FlyingRat/Medtronic-PB560/README.md

# Medtronic PB560 Ventilator

The complete Open Source Kit for the Medtronic PB 560 Ventilator including the original zip-files.

Link to official site for the Medtronic PB 560:
http://www.medtronic.com/openventilator
