FlyingRat/Medtronic-PB560/Mechanical Part Drawings/2982400/72SP - Supporting Documentation/PCBA10003A01G  Control Document v1.1.pdf

# Control Document

Assembly Version: | G | 15/06/2015
Document Version: | 1.0
PCBA Part Number: | PCBA10003A01G
Project Name: | Legend G2 (automotive EEPROM)
Document Description | Part/Drawing Number | Revision Filename
Schematic | 1400-10010-SCH | 4.3 | Schematic\1400-10010_SCH-LegendSchematicV4.3.PDF
BOM | PCBA10003A01G2 | 1.0 | BOM\PCBA10003A01G-LegendG2BOMv1.0.xls
Gerbers & other PCB manufacturing data | 1400-10010 | 3.0 | Gerbers, etc\1400-10010v3.0.zip
Legend PCB Fabrication Notes | 1400-10010-FAB | 3.0 | Gerbers, etc\1400-10010v3.0\1400-10010-FAB PCB Fabrication Notes v3.0.doc
Legend PCB Test Specification | PCB_TEST_00005 | 0.3 | Test Documents\Legend PCB Test 00005 Spec V0.3.pdf

Revision History
Version | Alteration Notice | Description
1.0 | - | Initial Release amended from PCBA10003A01F

The information contained within this document is confidential and proprietary to Accutronics Ltd. This information should not, in whole or in part, be reproduced, disclosed or used except as expressly and duly authorized by Accutronics Ltd.
