FlyingRat/Medtronic-PB560/Source Code/AL020004_updated/Sources/scripts/readme.txt

Pour tester le comportement de la carte alim sur mauvais CRC, il suffit d'ajouter l'option --gen-bad-crc dans le fichier update_crc_al.bat
