FlyingRat/Medtronic-PB560/Electronic PCBAs/10096315_Blower_Driver_PCBA/SCH/4096600.E00.001_Schma Carte Commande Turbine RB0505 IND03.pdf

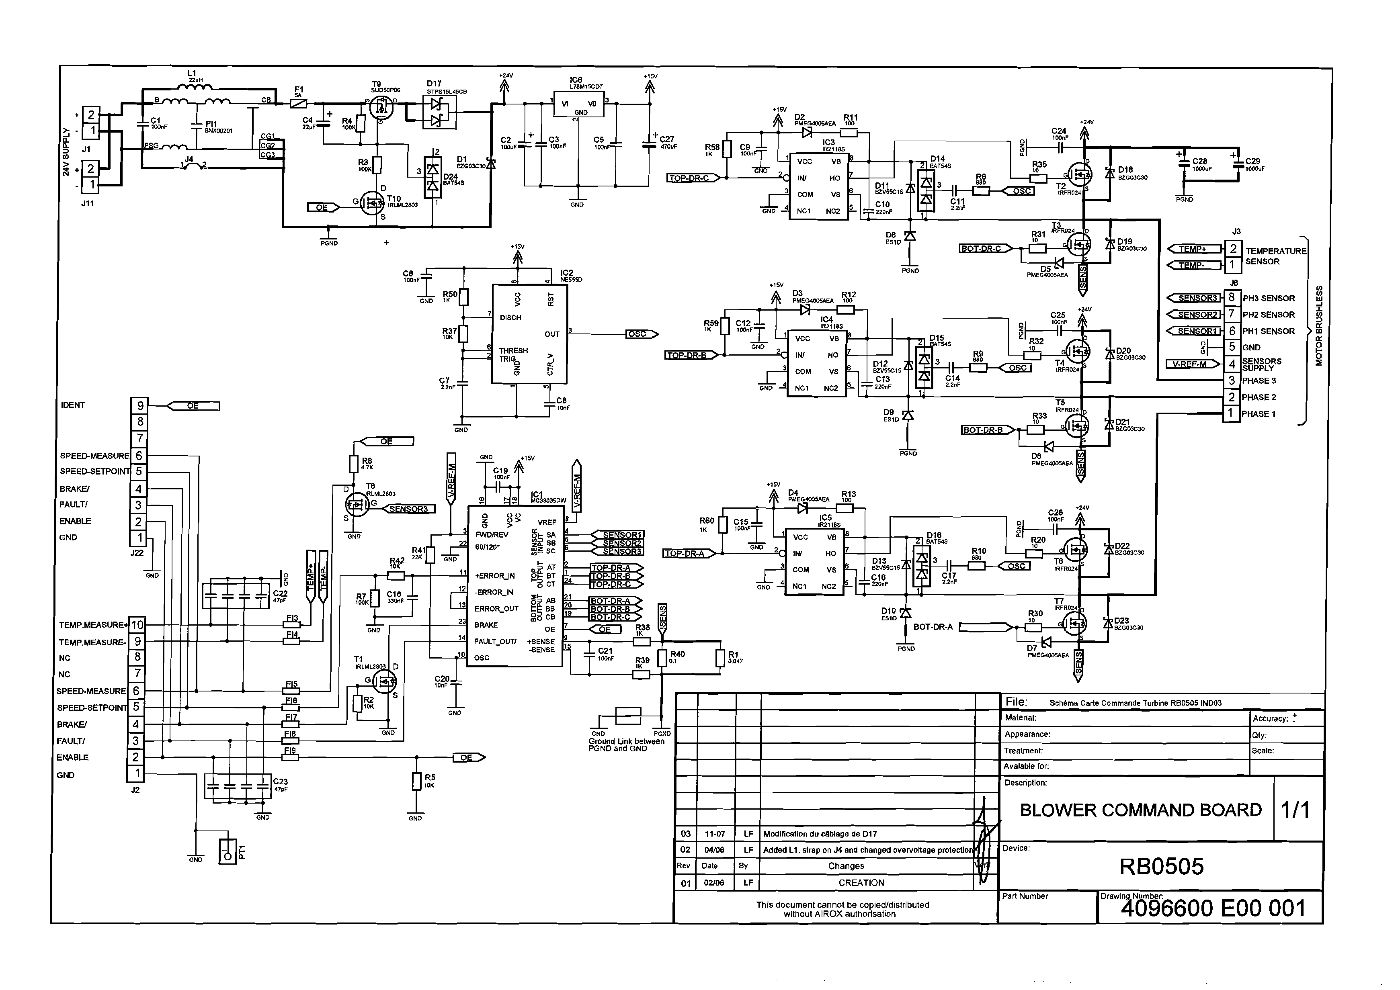
[picture p4: page 1]
