FlyingRat/Medtronic-PB560/Electronic PCBAs/GR106769_CPU_PCBA/PCB/GR106772A00.pdf

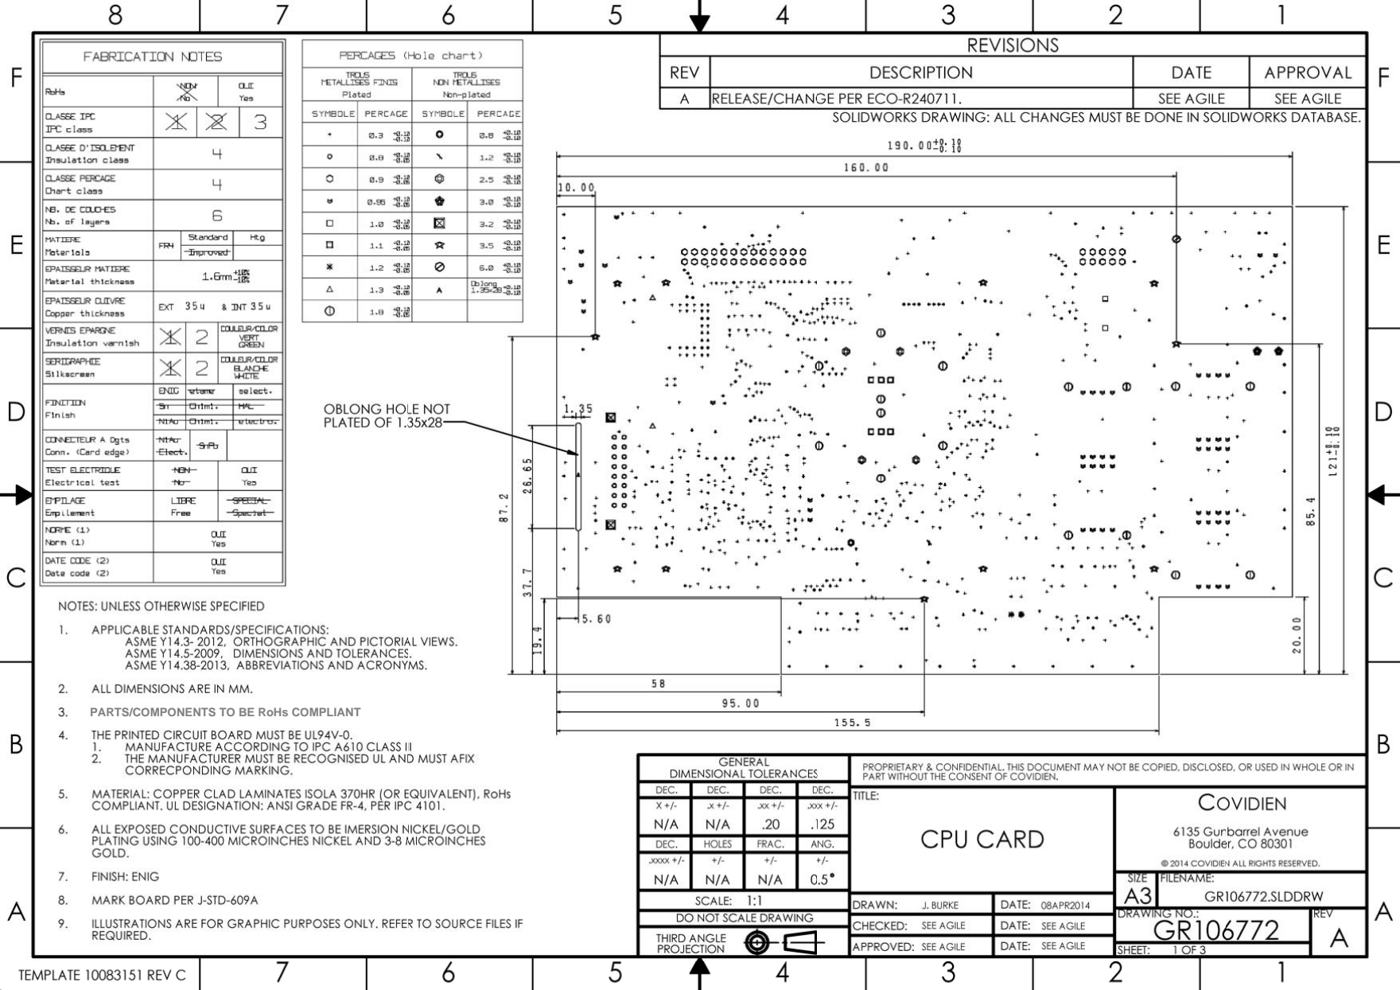
[picture p5: page 1]
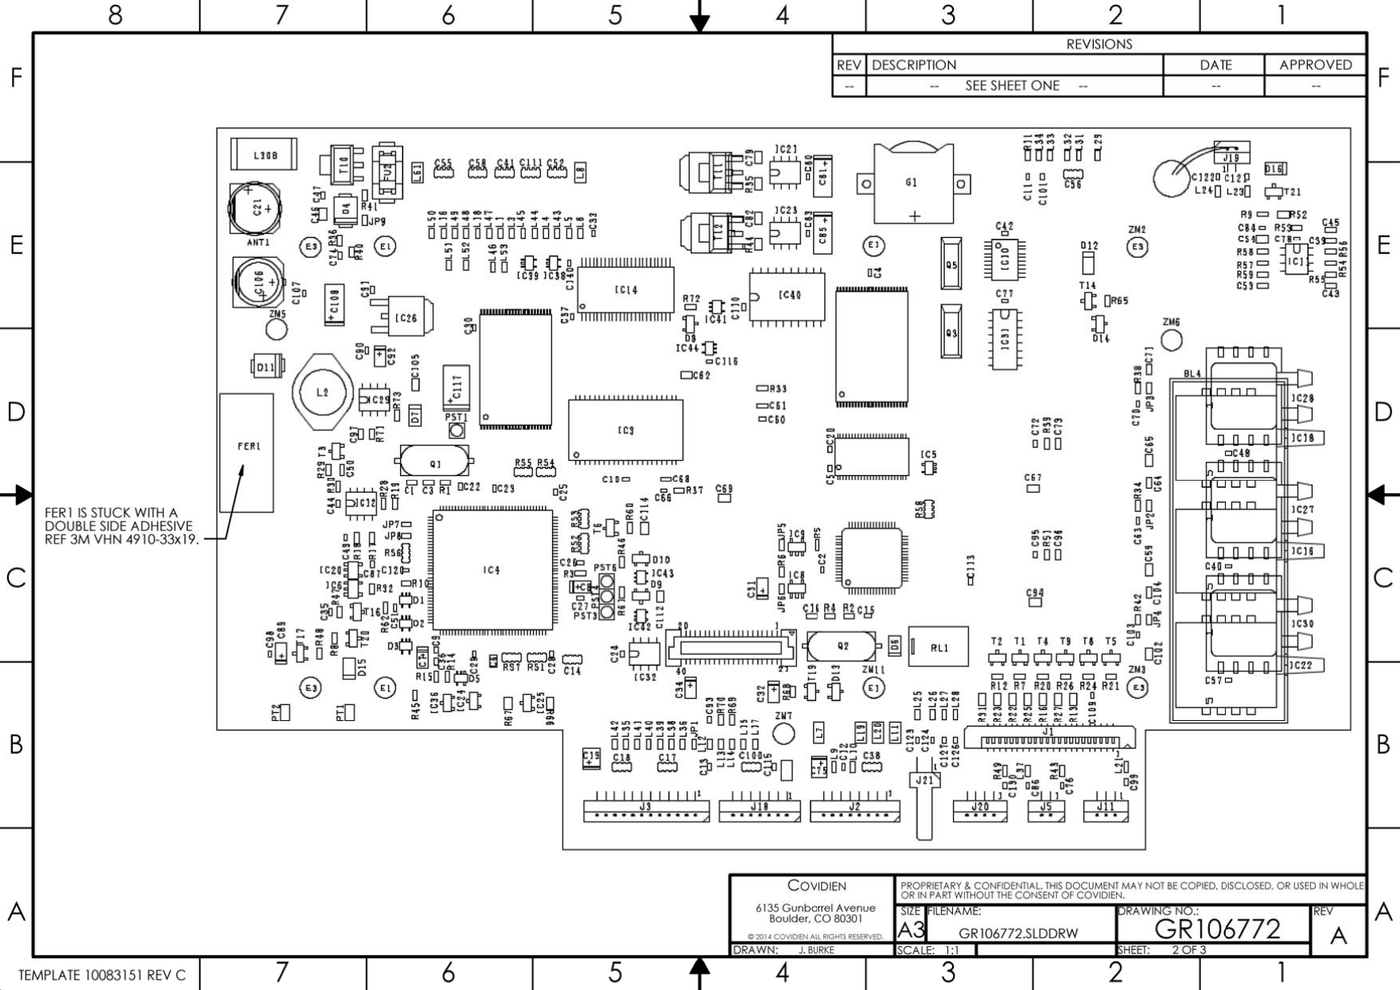
[picture p6: page 2]
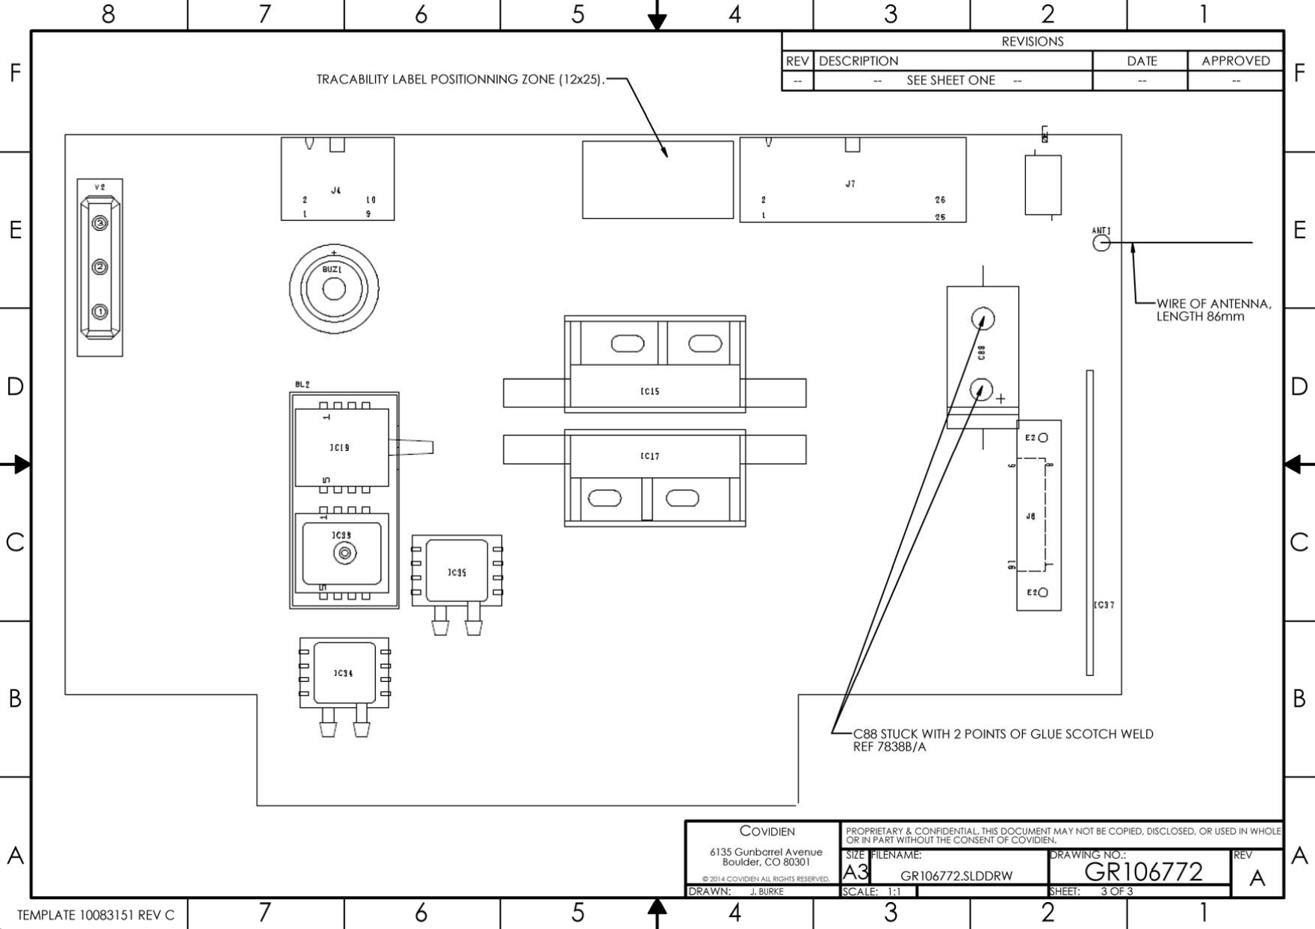
[picture p7: page 3]
