FlyingRat/Medtronic-PB560/Electronic PCBAs/GR106768_Buzzer_PCBA/BOM/GR106768_Buzzer_PCBA_BOM.xls

Creator | Jenaro | Julio
Type
Description
Title Block
Item Number | Description | Subclass | Lifecycle Phase | Rev | Rev Incorp Date | Rev Release Date | Effectivity Date
GR106768 | BUZZER PCBA | Part | Production | B ECO-R252636 | 18/Nov/2014 02:51:26 PM GMT | 06/Jan/2015 05:10:58 PM GMT
Page Two
UOM | Additional Categories Part | Alternate Part(s) | Alternate FG Part(s) | Restricted Access | Vendor User Group | Data Classification | Attachment Destination | Created By | Create Date | Legacy Data Source | Divesture Destination
Each | PART CATEGORY|Pc Board |  |  |  | V - Jabil SH | Confidential |  | Schilling, Sheila | 13/Feb/2014 03:51:56 PM GMT | Agile RMS
Page Three
Product Family(s) | Item Type | Lot Serial Control | Document Number | RoHS Compliant | Bio Approval Number | Integration Description | Project(s) | Notes | Handling/Storage | Legacy Number
 | Customized | None | NODOCUMENT | Unknown |  | BUZZER PCBA | RSP - PB560-520 | Product Family : RSP - VENTILATOR SYSTEMS, Commodity Code: BPCS Add-Updt : FC02.17, Country of Origin: BPCS Add : FR = FRANCE, Shelf Life Days:BPCS Add-Updt : 0, Must Single Issue: BPCS Add : NO, Item Class: BPCS Add-Updt : GL-66 PB500 Series Ventilators/Gen 1
BOM
Level | Attachments (Image) | Manufacturer (Image) | Pending Changes (Image) | Has Been Redlined (Image) | Has Quality(Image) | Bubble Number | Item Number | Item Description | Item Rev | Qty | UOM | Item Lifecycle Phase | BOM Notes | Ref Des | Component Effective From | Component Discontinue Date | Alternate Part(s) | Alternate FG Part(s) | Alternate Document(s) | Subclass | Sites | Planned? | Scrap Factor | OP # | Thumbnail | Attachments(Image) | Manufacture Part Has Redline | Mfr. Name | Mfr. Part Number | Mfr. Part Description | Mfr. Part Lifecycle Phase | Preferred Status | Sites | Reference Notes | RoHS Compliant? | RoHS Compliance Statement
1 | true | true | false | false | false | 0 | 10021385 | RESISTOR,4.7 KOHM,+/-1%.0.063W,0402 | A ECO-R252636 | 1 | Each | Production |  | R40 |  |  |  |  |  | Part | BDRM |  | 1 |  |  | true | false | PHYCOMP_RMS1 | 232270674702L | GENERAL PURPOSE CHIP RESISTOR | Active | Preferred |  | ROHS EXEMPT: 7(C)-1 | Yes - by exemption | Legacy Inventory Status: Cleared
 |  |  |  |  |  |  |  |  |  |  |  |  |  |  |  |  |  |  |  |  |  |  |  |  |  | true | false | VISHAY_RMS1 | CRCW04024K70FKED | RESISTOR THICK FILM 4k7 1% 0.0625W 0402 VISHAY | Active | Preferred |  | ROHS EXEMPT: 7(C)-1 | RoHS3 Compliant with exemptions | Cleared 7(c)-I exemption
 |  |  |  |  |  |  |  |  |  |  |  |  |  |  |  |  |  |  |  |  |  |  |  |  |  | true | false | YAGEO/PHYCOMP_RMS1 | RC0402FR-074K7L | GENERAL PURPOSE CHIP RESISTOR | Active | Preferred |  | ROHS EXEMPT: 7(C)-1 | Yes - by exemption | Legacy Inventory Status: Cleared
1 | true | true | false | false | false | 0 | 10021387 | RESISTOR, 220 OHM,+/-1%, 0.063W, 0402 | B ECO-R252636 | 1 | Each | Production |  | R37 |  |  |  |  |  | Part | BDRM |  | 1 |  |  | true | false | YAGEO_RMS1 | 232270672201L | RESISTOR, METAL GLAZE/THICK FILM, 0.0625 W, 1 %, 100 PPM, 220 OHM, SURFACE MOUNT, 0402 | Active | Preferred |  | BRAND: PHYCOMP.ROHS EXEMPTION: 7(C)-1 | Yes - by exemption | Legacy Inventory Status: Cleared
 |  |  |  |  |  |  |  |  |  |  |  |  |  |  |  |  |  |  |  |  |  |  |  |  |  | true | false | VISHAY_RMS1 | CRCW0402220RFKED | THICK FILM, RECTANGULAR CHIP RESISTORS | Active | Preferred |  | ROHS EXEMPTION: 7(C)-1 | Yes - by exemption | Legacy Inventory Status: Cleared
 |  |  |  |  |  |  |  |  |  |  |  |  |  |  |  |  |  |  |  |  |  |  |  |  |  | true | false | YAGEO_RMS1 | RC0402FR-07220RL | RESISTOR, METAL GLAZE/THICK FILM, 0.1 W, 1 %, 100 PPM, 220 OHM, SURFACE MOUNT, 0402 | Active | Preferred |  | ROHS EXEMPTION: 7(C)-1 | Yes - by exemption | 2011/65/EU compliant with 7(c)-I exemption and the exemption will expired in 21 July 2021 for medical devices.
1 | true | true | false | false | false | 0 | 10021388 | RESISTOR, 180 KOHM, +/-1%, 0.063W.0402 | B ECO-R252636 | 1 | Each | Production |  | R41 |  |  |  |  |  | Part | BDRM |  | 1 |  |  | true | false | YAGEO_RMS1 | 232270671804L | RESISTOR, METAL GLAZE/THICK FILM, 0.0625 W, 1 %, 100 PPM, 180000 OHM, SURFACE MOUNT, 0402 | Active | Preferred |  | BRAND:PHYCOMP.ROHS EXEMPT:7(C)-1 | Yes - by exemption | Legacy Inventory Status: Cleared
 |  |  |  |  |  |  |  |  |  |  |  |  |  |  |  |  |  |  |  |  |  |  |  |  |  | true | false | VISHAY_RMS1 | CRCW0402180KFKED | THICK FILM RECTANGULAR CHIP RESISTORS | Active | Preferred |  | ROHS EXEMPT:7(C)-1 | Yes - by exemption | Legacy Inventory Status: Cleared
 |  |  |  |  |  |  |  |  |  |  |  |  |  |  |  |  |  |  |  |  |  |  |  |  |  | true | false | YAGEO_RMS1 | RC0402FR-07180KL | RESISTOR, METAL GLAZE/THICK FILM, 0.0625 W, 1 %, 100 PPM, 180000 OHM, SURFACE MOUNT, 0402 | Active | Preferred |  | ROHS EXEMPT:7(C)-1 | Yes | Legacy Inventory Status: Cleared
1 | true | true | false | false | false | 0 | 10021389 | RESISTOR, 1.5 MOHM,0.063W, 0402 | B ECO-R252636 | 1 | Each | Production |  | R43 |  |  |  |  |  | Part | BDRM |  | 1 |  |  | true | false | YAGEO_RMS1 | 232270671505L | RESISTOR, METAL GLAZE/THICK FILM, 0.0625 W, 1 %, 100 PPM, 1500000 OHM, SURFACE MOUNT, 0402 | Active | Preferred |  | BRAND: PHYCOMP.ROHS COMPLIANT: 7(C)-1 | Yes - by exemption | Legacy Inventory Status: Cleared
 |  |  |  |  |  |  |  |  |  |  |  |  |  |  |  |  |  |  |  |  |  |  |  |  |  | true | false | YAGEO_RMS1 | RC0402FR-071M5L | RESISTOR, METAL GLAZE/THICK FILM, 0.0625 W, 1 %, 100 PPM, 1500000 OHM, SURFACE MOUNT, 0402 | Active | Preferred |  | ROHS COMPLIANT: 7(C)-1 | Yes - by exemption | Legacy Inventory Status: Cleared
 |  |  |  |  |  |  |  |  |  |  |  |  |  |  |  |  |  |  |  |  |  |  |  |  |  | true | false | VISHAY_RMS1 | CRCW04021M50FKED | THICK FILM, RECTANGULAR CHIP RESISTORS | Active | Preferred |  | ROHS COMPLIANT: 7(C)-1 | Yes - by exemption | Legacy Inventory Status: Cleared
1 | true | true | false | false | false | 0 | 10021390 | CAPACITOR,4.7NF,16V,+/-10%,0402 | B ECO-R252636 | 1 | Each | Production |  | C35 |  |  |  |  |  | Part | BDRM |  | 1 |  |  | true | false | YAGEO_RMS1 | CC0402KRX7R7BB472 | CAPACITOR, CERAMIC, MULTILAYER, 16 V, X7R, 0.0047 UF, SURFACE MOUNT, 0402 | Active | Preferred |  |  | Yes | Legacy Inventory Status: Cleared
 |  |  |  |  |  |  |  |  |  |  |  |  |  |  |  |  |  |  |  |  |  |  |  |  |  | true | false | YAGEO_RMS1 | 223878715632 | CAPACITOR, CERAMIC, MULTILAYER, 16 V, X7R, 0.0047 UF, SURFACE MOUNT, 0402 | Active | Preferred |  | BRAND: PHYCOMP | Yes | Legacy Inventory Status: Cleared
1 | true | true | false | false | false | 0 | 10021391 | RESISTOR, 680 KOHM,+/-1%, 0.063W, 0402 | B ECO-R252636 | 1 | Each | Production |  | R44 |  |  |  |  |  | Part | BDRM |  | 1 |  |  | true | false | YAGEO_RMS1 | RC0402FR-07680KL | RESISTOR, METAL GLAZE/THICK FILM, 0.0625 W, 1 %, 100 PPM, 680000 OHM, SURFACE MOUNT, 0402 | Active | Preferred |  | ROHS EXEMPT: 7(C)-1 | Yes - by exemption | Legacy Inventory Status: Cleared
 |  |  |  |  |  |  |  |  |  |  |  |  |  |  |  |  |  |  |  |  |  |  |  |  |  | true | false | YAGEO_RMS1 | 232270676804L | RESISTOR, METAL GLAZE/THICK FILM, 0.0625 W, 1 %, 100 PPM, 680000 OHM, SURFACE MOUNT, 0402 | Active | Preferred |  | BRAND: PHYCOMP.ROHS EXEMPT: 7(C)-1 | Yes - by exemption | Legacy Inventory Status: Cleared
 |  |  |  |  |  |  |  |  |  |  |  |  |  |  |  |  |  |  |  |  |  |  |  |  |  | true | false | VISHAY_RMS1 | CRCW0402680KFKED | THICK FILM, RECTANGULAR CHIP RESISTORS | Active | Preferred |  | ROHS EXEMPT: 7(C)-1 | Yes - by exemption | Legacy Inventory Status: Cleared
1 | true | true | false | false | false | 0 | 10021462 | RESISTOR, 1 MOHM, +/-1%,0.063W,0402 | B ECO-R252636 | 1 | Each | Production |  | R46 |  |  |  |  |  | Part | BDRM |  | 1 |  |  | true | false | YAGEO_RMS1 | 232270671005L | RESISTOR, METAL GLAZE/THICK FILM, 0.0625 W, 1 %, 100 PPM, 1000000 OHM, SURFACE MOUNT, 0402 | Active | Preferred |  | BRAND: PHYCOMP.ROHS EXMEPT: 7(C)-1 | Yes - by exemption | Legacy Inventory Status: Cleared
 |  |  |  |  |  |  |  |  |  |  |  |  |  |  |  |  |  |  |  |  |  |  |  |  |  | true | false | YAGEO_RMS1 | RC0402FR-071ML | RESISTOR, METAL GLAZE/THICK FILM, 0.0625 W, 1 %, 100 PPM, 1000000 OHM, SURFACE MOUNT, 0402 | Active | Preferred |  | ROHS EXMEPT: 7(C)-1 | RoHS3 Compliant with exemptions | Exemption 7(c)-I shown on RoHS evidence
 |  |  |  |  |  |  |  |  |  |  |  |  |  |  |  |  |  |  |  |  |  |  |  |  |  | true | false | VISHAY_RMS1 | CRCW04021M00FKED | RESISTOR 1M 1% 0.0625W 0402 VISHAY | Active | Preferred |  | ROHS EXMEPT: 7(C)-1 | RoHS3 Compliant with exemptions | Cleared. Exemption 7(c)-I
1 | true | true | false | false | false | 0 | 10021463 | CAPACITOR,47UF,16V,1210,X5R | C ECO-R252636 | 2 | Each | Production |  | C21,C23 |  |  |  |  |  | Part | BDRM |  | 1 |  |  | true | false | KEMET_RMS1 | C1210C476M4PACTU |  | Active | Preferred |  |  | Yes | Legacy Inventory Status: Cleared
 |  |  |  |  |  |  |  |  |  |  |  |  |  |  |  |  |  |  |  |  |  |  |  |  |  | true | false | KEMET_RMS1 | C1210C476K4PACTU | CERAMIC CHIP CAPACITOR | Active | Alternate |  |  | Yes | Legacy Inventory Status: Cleared
1 | true | true | false | false | false | 0 | 10021468 | RESISTOR, 137 KOHM, +/-1%,0.063W,0402 | B ECO-R252636 | 1 | Each | Production |  | R26 |  |  |  |  |  | Part | BDRM |  | 1 |  |  | true | false | VISHAY_RMS1 | CRCW0402137KFKED | THICK FILM, RECTANGULAR CHIP RESISTORS | Active | Preferred |  | ROHS EXEMPTION: 7(C)-1 | Yes - by exemption | Legacy Inventory Status: Cleared
 |  |  |  |  |  |  |  |  |  |  |  |  |  |  |  |  |  |  |  |  |  |  |  |  |  | true | false | YAGEO_RMS1 | RC0402FR-07137KL | RESISTOR, METAL GLAZE/THICK FILM, 0.0625 W, 1 %, 100 PPM, 137000 OHM, SURFACE MOUNT, 0402 | Active | Preferred |  | ROHS EXEMPTION: 7(C)-1 | Yes - by exemption | Legacy Inventory Status: Cleared
 |  |  |  |  |  |  |  |  |  |  |  |  |  |  |  |  |  |  |  |  |  |  |  |  |  | true | false | YAGEO_RMS1 | 232270671374L | RESISTOR, METAL GLAZE/THICK FILM, 0.0625 W, 1 %, 100 PPM, 137000 OHM, SURFACE MOUNT, 0402 | Active | Preferred |  | BRAND: PHYCOMP. ROHS EXEMPTION: 7(C)-1 | Yes - by exemption | Legacy Inventory Status: Cleared
1 | true | true | false | false | false | 0 | 10021556 | RESISTOR, 68 KOHM,+/-1%, 0.063W, 0402 | B ECO-R252636 | 1 | Each | Production |  | R27 |  |  |  |  |  | Part | BDRM |  | 1 |  |  | true | false | YAGEO_RMS1 | 232270676803L | RESISTOR, METAL GLAZE/THICK FILM, 0.0625 W, 1 %, 100 PPM, 68000 OHM, SURFACE MOUNT, 0402 | Active | Preferred |  | BRAND: PHYCOMP. ROHS EXEMPTION: 7(C)-1 | Yes - by exemption | Legacy Inventory Status: Cleared
 |  |  |  |  |  |  |  |  |  |  |  |  |  |  |  |  |  |  |  |  |  |  |  |  |  | true | false | VISHAY_RMS1 | CRCW040268K0FKED | THICK FILM, RECTANGULAR CHIP RESISTORS | Active | Preferred |  | ROHS EXEMPTION: 7(C)-1 | Yes - by exemption | Legacy Inventory Status: Cleared
 |  |  |  |  |  |  |  |  |  |  |  |  |  |  |  |  |  |  |  |  |  |  |  |  |  | true | false | YAGEO_RMS1 | RC0402FR-0768KL | RESISTOR, METAL GLAZE/THICK FILM, 0.0625 W, 1 %, 100 PPM, 68000 OHM, SURFACE MOUNT, 0402 | Active | Preferred |  | ROHS EXEMPTION: 7(C)-1 | RoHS3 Compliant with exemptions | RoHS3 Compliant with exemptions
1 | true | true | false | false | false | 0 | 10021557 | RESISTOR,0 OHM,0.063W,0402 | B ECO-R252636 | 2 | Each | Production |  | R30,R31 |  |  |  |  |  | Part | BDRM |  | 1 |  |  | true | false | YAGEO_RMS1 | 232270591001L | JUMPER, METAL GLAZE/THICK FILM, 0.0625 W, 0 OHM, SURFACE MOUNT, 0402 | Active | Preferred |  | BRAND: PHYCOMP.ROHS EXEMPT: 7(C)-1 | Yes - by exemption | Legacy Inventory Status: Cleared
 |  |  |  |  |  |  |  |  |  |  |  |  |  |  |  |  |  |  |  |  |  |  |  |  |  | true | false | VISHAY_RMS1 | CRCW04020000Z0ED | RES,0R,1%,0402,1/16W,200PPM,CHIP | Active | Preferred |  | ROHS EXEMPT: 7(C)-1 | RoHS3 Compliant with exemptions | Exemption 7(c)-I shown on RoHS evidence
 |  |  |  |  |  |  |  |  |  |  |  |  |  |  |  |  |  |  |  |  |  |  |  |  |  | true | false | YAGEO_RMS1 | RC0402JR-070RL | JUMPER, METAL GLAZE/THICK FILM, 0.0625 W, 0 OHM, SURFACE MOUNT, 0402 | Active | Preferred |  | ROHS EXEMPT: 7(C)-1 | RoHS3 Compliant with exemptions | Cleared. Exemption 7(c)-I
1 | true | true | false | false | false | 0 | 10021558 | RESISTOR, 33 K OHM, +/-1%, 0.063W,0402 | B ECO-R252636 | 1 | Each | Production |  | R35 |  |  |  |  |  | Part | BDRM |  | 1 |  |  | true | false | VISHAY_RMS1 | CRCW040233K0FKED | THICK FILM, RECTANGULAR CHIP RESISTORS | Active | Preferred |  | ROHS EXEMPT: 7(C)-1 | Yes - by exemption | Legacy Inventory Status: Cleared
 |  |  |  |  |  |  |  |  |  |  |  |  |  |  |  |  |  |  |  |  |  |  |  |  |  | true | false | YAGEO_RMS1 | 232270673303L | RESISTOR, METAL GLAZE/THICK FILM, 0.0625 W, 1 %, 100 PPM, 33000 OHM, SURFACE MOUNT, 0402 | Active | Preferred |  | BRAND: PHYCOMP. ROHS EXEMPT: 7(C)-1 | Yes - by exemption | Legacy Inventory Status: Cleared
 |  |  |  |  |  |  |  |  |  |  |  |  |  |  |  |  |  |  |  |  |  |  |  |  |  | true | false | YAGEO_RMS1 | RC0402FR-0733KL | RESISTOR, METAL GLAZE/THICK FILM, 0.0625 W, 1 %, 100 PPM, 33000 OHM, SURFACE MOUNT, 0402 | Active | Preferred |  | ROHS EXEMPT: 7(C)-1 | RoHS3 Compliant with exemptions | Exemption 7(c)-I shown on RoHS evidence
1 | true | true | false | false | false | 0 | 10022129 | BATTERY NI-MH TYPE V150H 4.8V | B ECO-R252636 | 1 | Each | Production |  | BAT1 |  |  |  |  |  | Part | BDRM |  | 1 |  |  | true | false | VARTA (917650) | 55615 604 059 | VARTA MICROBATTERY | Active | Preferred |  | ROHS OUT OF SCOPE.NO ROHS EVIDENCE REQUIRED. | N/A | Legacy Inventory Status: Cleared
 |  |  |  |  |  |  |  |  |  |  |  |  |  |  |  |  |  |  |  |  |  |  |  |  |  | true | false | VARTA_RMS1 | 55615604940 |  | Active | Preferred |  | ROHS OUT OF SCOPE.NO ROHS EVIDENCE REQUIRED. | N/A | Legacy Inventory Status: Cleared
1 | true | true | false | false | false | 0 | 10022130 | BUZZER | B ECO-R252636 | 2 | Each | Production |  | BUZ1,BUZ2 |  |  |  |  |  | Part | BDRM |  | 1 |  |  | true | false | MURATA MANUFACTURING CO., LTD. | PKM33EPH1201C |  | Active | Preferred |  | ROHS EXMEPT: 7(C)-1 | Yes - by exemption | Legacy Inventory Status: Cleared
1 | true | true | false | false | false | 0 | 10022132 | CAPACITOR, CERAMIC, 680 PF, 50V, +/-5%, 0402 | B ECO-R252636 | 2 | Each | Production |  | C4,C6 |  |  |  |  |  | Part | BDRM |  | 1 |  |  | true | false | MURATA MANUFACTURING CO., LTD. | GRM1555C1H681JA01D | MONOLITHIC CERAMIC CHIP CAPACITOR | Active | Preferred |  |  | Yes | Legacy Inventory Status: Cleared
 |  |  |  |  |  |  |  |  |  |  |  |  |  |  |  |  |  |  |  |  |  |  |  |  |  | true | false | YAGEO_RMS1 | CC0402JRX7R9BB681 | CAPACITOR, CERAMIC, MULTILAYER, 50 V, X7R, 0.00068 UF, SURFACE MOUNT, 0402 | Active | Preferred |  |  | Yes | Legacy Inventory Status: Cleared
 |  |  |  |  |  |  |  |  |  |  |  |  |  |  |  |  |  |  |  |  |  |  |  |  |  | true | false | YAGEO_RMS1 | 223858715521 | CAPACITOR, CERAMIC, MULTILAYER, 50 V, X7R, 0.00068 UF, SURFACE MOUNT, 0402 | Active | Preferred |  | BRAND: PHYCOMP | Yes | Legacy Inventory Status: Cleared
1 | true | true | false | false | false | 0 | 10022133 | CAPACITOR ELECTROLYTIC,470UF,40V,+/-20% | A ECO-R252636 | 1 | Each | Production |  | C12 |  |  |  |  |  | Part | BDRM |  | 1 |  |  | true | false | VISHAY_RMS1 | 222202117471 | ALUMINUM CAPACITORS AXIAL STANDARD MINIATURE | Active | Preferred |  |  | Yes | Legacy Inventory Status: Cleared
 |  |  |  |  |  |  |  |  |  |  |  |  |  |  |  |  |  |  |  |  |  |  |  |  |  | true | false | VISHAY_RMS1 | MAL202117471E3 | ALUMINUM CAPACITORS AXIAL STANDARD MINIATURE | Active | Preferred |  |  | Yes | Legacy Inventory Status: Cleared
1 | true | true | false | false | false | 0 | 10022134 | CAPACITOR CERAMIC, 330 NF, 16V, X7R, 0603,+/-10% | A ECO-R252636 | 1 | Each | Production |  | C20 |  |  |  |  |  | Part | BDRM |  | 1 |  |  | true | false | KEMET_RMS1 | C0603C334K4RACTU | CERAMIC CHIP CAPACITOR | Active | Preferred |  | TAPE & REEL | Yes | Legacy Inventory Status: Cleared
 |  |  |  |  |  |  |  |  |  |  |  |  |  |  |  |  |  |  |  |  |  |  |  |  |  | true | false | KEMET_RMS1 | C0603C334K4RAC | CERAMIC CHIP CAPACITOR | Active | Preferred |  |  | Yes | Legacy Inventory Status: Cleared
1 | false | true | false | false | false | 0 | 10022137 | CAPACITOR CERAMIC,10UF,16V,X5R,+/-10%,1206 | B EC123352 | 3 | Each | Production |  | C22,C26,C29 |  |  |  |  |  | Part | BDRM |  | 1 |  |  | true | false | KEMET_RMS1 | C1206C106K4PACTU | CERAMIC CHIP CAPACITOR | Active | Preferred |  |  | RoHS3 Compliant | Cleared
 |  |  |  |  |  |  |  |  |  |  |  |  |  |  |  |  |  |  |  |  |  |  |  |  |  | true | false | YAGEO | CC1206KKX5R7BB106 | Cap, cer, 10uF, 10%, 16V, X5R, 1206 | Active | Alternate |  |  | RoHS3 Compliant | Cleared
 |  |  |  |  |  |  |  |  |  |  |  |  |  |  |  |  |  |  |  |  |  |  |  |  |  | true | false | TDK_RMS1 | C3216X5R1C106KT | MULTILAYER CERAMIC CHIP CAPACITOR | Active | Alternate |  |  | RoHS3 Compliant | Cleared
 |  |  |  |  |  |  |  |  |  |  |  |  |  |  |  |  |  |  |  |  |  |  |  |  |  | true | false | Samsung Electro-Mechanics | CL31A106KOHNNNE | Cap, cer, 10uF, 10%, 16V, X5R, 1206 | Active | Alternate |  |  | RoHS3 Compliant | Cleared
 |  |  |  |  |  |  |  |  |  |  |  |  |  |  |  |  |  |  |  |  |  |  |  |  |  | true | false | AVX CORPORATION | 1206YD106KAT2A | Cap, cer, 10uF, 10%, 16V, X5R, 1206 | Active | Alternate |  |  | RoHS3 Compliant | Cleared
1 | true | true | false | false | false | 0 | 10022139 | DIODE ZENER, 2.7V, 0.35W, SOT23 | B ECO-R252636 | 1 | Each | Production |  | D5 |  |  |  |  |  | Part | BDRM |  | 1 |  |  | true | false | NXP SEMICONDUCTORS_RMS1 | BZX84-C2V7 | VOLTAGE REGULATOR DIODES | Active | Preferred |  |  | Yes | Legacy Inventory Status: Cleared
 |  |  |  |  |  |  |  |  |  |  |  |  |  |  |  |  |  |  |  |  |  |  |  |  |  | true | false | NXP SEMICONDUCTORS_RMS1 | BZX84-C2V7,215 |  | Active | Preferred |  |  | Yes | Legacy Inventory Status: Cleared
1 | true | true | false | false | false | 0 | 10022140 | DIODE SCHOTTKY, 20V, 1A, DO216AA | A ECO-R252636 | 6 | Each | Production |  | D8,D10,D11,D12,D13,D14 |  |  |  |  |  | Part | BDRM |  | 1 |  |  | true | false | ON SEMICONDUCTOR_RMS1 | MBRM120LT1G | SURFACE MOUNT SCHOTTKY POWER RECTIFIER | Active | Preferred |  |  | Yes | Legacy Inventory Status: Cleared
1 | true | true | false | false | false | 0 | 10022141 | FUSE, FAST ACTING, SMD, 500MA | A ECO-R252636 | 1 | Each | Production |  | FU1 |  |  |  |  |  | Part | BDRM |  | 1 |  |  | true | false | LITTELFUSE_RMS1 | 0451.500MRL | VERY FAST ACTING SURFACE MOUNT FUSE | Active | Preferred |  | ROHS EXEMPT: 7A | Yes - by exemption | Legacy Inventory Status: Cleared
1 | true | true | false | false | false | 0 | 10022144 | IC, DOUBLE LOW POWER OPERATIONAL AMPLIFIER | A ECO-R252636 | 2 | Each | Production |  | IC2,IC3 |  |  |  |  |  | Part | BDRM |  | 1 |  |  | true | false | ON SEMICONDUCTOR_RMS1 | MC33172DG | LOW POWER OP-AMP | Active | Preferred |  |  | Yes | Legacy Inventory Status: Cleared
 |  |  |  |  |  |  |  |  |  |  |  |  |  |  |  |  |  |  |  |  |  |  |  |  |  | true | false | ON SEMICONDUCTOR_RMS1 | MC33172DR2G | LOW POWER OP-AMP | Active | Preferred |  | TAPE & REEL | Yes | Legacy Inventory Status: Cleared
1 | true | true | false | false | false | 0 | 10022145 | OPERATIONAL AMPLIFIER, SOT23-5 | A ECO-R252636 | 1 | Each | Production |  | IC4 |  |  |  |  |  | Part | BDRM |  | 1 |  |  | true | false | NATIONAL SEMICONDUCTOR_RMS1 | LMV321M5 NOPB | OP-AMP | Active | Preferred |  |  | Yes | Legacy Inventory Status: Cleared
 |  |  |  |  |  |  |  |  |  |  |  |  |  |  |  |  |  |  |  |  |  |  |  |  |  | true | false | TEXAS INSTRUMENTS_RMS1 | LMV321IDBVT | OP-AMP | Active | Preferred |  | ROHS EXEMPT: 15 | Yes - by exemption | Legacy Inventory Status: Cleared
1 | true | true | false | false | false | 0 | 10022147 | IC, CHARGE CONTROLLER, NICD/NIMH | B ECO-R252636 | 1 | Each | Production |  | IC6 |  |  |  |  |  | Part | BDRM |  | 1 |  |  | true | false | TEXAS INSTRUMENTS_RMS1 | BQ2002CSNTR |  | Active | Preferred |  | ROHS EXMEPTION: 15 | Yes - by exemption | Legacy Inventory Status: Cleared
 |  |  |  |  |  |  |  |  |  |  |  |  |  |  |  |  |  |  |  |  |  |  |  |  |  | true | false | TEXAS INSTRUMENTS_RMS1 | BQ2002CSN | NICD/NIMH FAST-CHARGE MANAGEMENT IC | Active | Preferred |  | ROHS EXMEPTION: 15 | Yes - by exemption | Legacy Inventory Status: Cleared
1 | true | true | false | false | false | 0 | 10022148 | IC, COMPARATOR WITH VOLTAGE REF, 1.8V, SOT23 | B ECO-R252636 | 2 | Each | Production |  | IC7,IC9 |  |  |  |  |  | Part | BDRM |  | 1 |  |  | true | false | TEXAS INSTRUMENTS_RMS1 | TLV3011AIDBVR |  | Active | Alternate |  | ROHS EXEMPT: 15 | Yes - by exemption | Legacy Inventory Status: Cleared
 |  |  |  |  |  |  |  |  |  |  |  |  |  |  |  |  |  |  |  |  |  |  |  |  |  | true | false | TEXAS INSTRUMENTS_RMS1 | TLV3011AIDBVT | COMPARATOR WITH VOLTAGE REFERENCE,1.8V | Active | Preferred |  | ROHS EXEMPT: 15 | Yes - by exemption | Legacy Inventory Status: Cleared
1 | true | true | false | false | false | 0 | 10022149 | RESISTOR 100K OHM, 0.063W, +/-1%, 0402 | B ECO-R252636 | 14 | Each | Production |  | R1,R2,R3,R10,R24,R29,R38,R39,R42,R47,R59,R63,R64,R67 |  |  |  |  |  | Part | BDRM |  | 1 |  |  | true | false | VISHAY_RMS1 | CRCW0402100KFKED | RESISTOR SMD 100K OHM 1% 1/16W 0402 VISHAY | Active | Preferred |  | ROHS EXEMPT: 7 (C)-1 | RoHS3 Compliant with exemptions | Exemption 7(c)-I shown on RoHS evidence
 |  |  |  |  |  |  |  |  |  |  |  |  |  |  |  |  |  |  |  |  |  |  |  |  |  | true | false | YAGEO_RMS1 | 232270671004L | RESISTOR, METAL GLAZE/THICK FILM, 0.0625 W, 1 %, 100 PPM, 100000 OHM, SURFACE MOUNT, 0402 | Active | Preferred |  | BRAND: PHYCOMP.ROHS EXEMPT: 7 (C)-1 | Yes - by exemption | Legacy Inventory Status: Cleared
 |  |  |  |  |  |  |  |  |  |  |  |  |  |  |  |  |  |  |  |  |  |  |  |  |  | true | false | YAGEO_RMS1 | RC0402FR-07100KL | RESISTOR 100k 1% 0.0625W 0402 YAGEO | Active | Preferred |  | ROHS EXEMPT: 7 (C)-1 | RoHS3 Compliant with exemptions | Exemption 7(c)-I shown on RoHS evidence
1 | true | true | false | false | false | 0 | 10022150 | RESISTOR,10K OHM, 0.063W, +/-1%, 0402 | B ECO-R252636 | 14 | Each | Production |  | R4,R5,R16,R17,R32,R34,R49,R51,R52,R61,R62,R66,R68,R70 |  |  |  |  |  | Part | BDRM |  | 1 |  |  | true | false | YAGEO_RMS1 | RC0402FR-0710KL | RES SMD 10K OHM 1% 1/16W 0402 | Active | Preferred |  | ROHS EXEMPTION: 7(C)-1 | RoHS3 Compliant with exemptions | Exemption 7(c)-I shown on RoHS evidence
 |  |  |  |  |  |  |  |  |  |  |  |  |  |  |  |  |  |  |  |  |  |  |  |  |  | true | false | VISHAY_RMS1 | CRCW040210K0FKED | RES SMD 10K OHM 1% 1/16W 0402 | Active | Preferred |  | ROHS EXEMPTION: 7(C)-1 | RoHS3 Compliant with exemptions | Exemption 7(c)-I shown on RoHS evidence
 |  |  |  |  |  |  |  |  |  |  |  |  |  |  |  |  |  |  |  |  |  |  |  |  |  | true | false | YAGEO_RMS1 | 232270671003L | RESISTOR, METAL GLAZE/THICK FILM, 0.0625 W, 1 %, 100 PPM, 10000 OHM, SURFACE MOUNT, 0402 | Active | Preferred |  | BRAND: PHYCOMP.ROHS EXEMPTION: 7(C)-1 | Yes - by exemption | Legacy Inventory Status: Cleared
1 | true | true | false | false | false | 0 | 10022151 | RESISTOR 59 KOHMS, 0.063W, +/-1% 0402 | B ECO-R252636 | 2 | Each | Production |  | R6,R45 |  |  |  |  |  | Part | BDRM |  | 1 |  |  | true | false | VISHAY_RMS1 | CRCW040259K0FKED | THICK FILM RECTANGULAR CHIP RESISTOR | Active | Preferred |  | ROHS EXEMPT:7(C)-1 | Yes - by exemption | Legacy Inventory Status: Cleared
 |  |  |  |  |  |  |  |  |  |  |  |  |  |  |  |  |  |  |  |  |  |  |  |  |  | true | false | YAGEO_RMS1 | RC0402FR-0759KL | RESISTOR, METAL GLAZE/THICK FILM, 0.0625 W, 1 %, 100 PPM, 59000 OHM, SURFACE MOUNT, 0402 | Active | Preferred |  | ROHS EXEMPT:7(C)-1 | Yes - by exemption | Legacy Inventory Status: Cleared
 |  |  |  |  |  |  |  |  |  |  |  |  |  |  |  |  |  |  |  |  |  |  |  |  |  | true | false | YAGEO_RMS1 | 232270675903L | RESISTOR, METAL GLAZE/THICK FILM, 0.0625 W, 1 %, 100 PPM, 59000 OHM, SURFACE MOUNT, 0402 | Active | Preferred |  | BRAND: PHYCOMP.ROHS EXEMPT:7(C)-1 | Yes - by exemption | Legacy Inventory Status: Cleared
1 | true | true | false | false | false | 0 | 10022152 | RESISTOR, 51.1 KOHM, 0.063W, +/-1%,0402 | B ECO-R252636 | 1 | Each | Production |  | R7 |  |  |  |  |  | Part | BDRM |  | 1 |  |  | true | false | YAGEO_RMS1 | RC0402FR-0751K1L | RESISTOR, METAL GLAZE/THICK FILM, 0.0625 W, 1 %, 100 PPM, 51100 OHM, SURFACE MOUNT, 0402 | Active | Preferred |  | ROHS EXEMPT: 7(C)-1 | Yes - by exemption | Legacy Inventory Status: Cleared
 |  |  |  |  |  |  |  |  |  |  |  |  |  |  |  |  |  |  |  |  |  |  |  |  |  | true | false | VISHAY_RMS1 | CRCW040251K1FKED | THICK FILM RECTANGULAR CHIP RESISTOR | Active | Preferred |  | ROHS EXEMPT: 7(C)-1 | Yes - by exemption | Legacy Inventory Status: Cleared
 |  |  |  |  |  |  |  |  |  |  |  |  |  |  |  |  |  |  |  |  |  |  |  |  |  | true | false | YAGEO_RMS1 | 232270675113L | RESISTOR, METAL GLAZE/THICK FILM, 0.0625 W, 1 %, 100 PPM, 51100 OHM, SURFACE MOUNT, 0402 | Active | Preferred |  | BRAND: PHYCOMP.ROHS EXEMPT: 7(C)-1 | Yes - by exemption | Legacy Inventory Status: Cleared
1 | true | true | false | false | false | 0 | 10022153 | RESISTOR, 1 KOHM, 0.063W,+/-1%, 0402 | B ECO-R252636 | 2 | Each | Production |  | R8,R33 |  |  |  |  |  | Part | BDRM |  | 1 |  |  | true | false | YAGEO_RMS1 | 232270671002L | RESISTOR, METAL GLAZE/THICK FILM, 0.0625 W, 1 %, 100 PPM, 1000 OHM, SURFACE MOUNT, 0402 | Active | Preferred |  | BRAND: PHYCOMP.ROHS EXMEPT: 7(C)-1 | Yes - by exemption | Legacy Inventory Status: Cleared
 |  |  |  |  |  |  |  |  |  |  |  |  |  |  |  |  |  |  |  |  |  |  |  |  |  | true | false | YAGEO_RMS1 | RC0402FR-071KL | RESISTOR 1k 1% 0.0625W 0402 YAGEO | Active | Preferred |  | ROHS EXMEPT: 7(C)-1 | RoHS3 Compliant with exemptions | Exemption 7(c)-I shown on RoHS evidence
 |  |  |  |  |  |  |  |  |  |  |  |  |  |  |  |  |  |  |  |  |  |  |  |  |  | true | false | VISHAY_RMS1 | CRCW04021K00FKED | RES 1.00K OHM 1/16W 1% 0402 SMD | Active | Preferred |  | ROHS EXMEPT: 7(C)-1 | RoHS3 Compliant with exemptions | Exemption 7(c)-I shown on RoHS evidence
1 | true | true | false | false | false | 0 | 10022154 | RESISTOR,32.4 KOHMS,0.063W,+/-1%,0402 | B ECO-R252636 | 2 | Each | Production |  | R9,R28 |  |  |  |  |  | Part | BDRM |  | 1 |  |  | true | false | YAGEO_RMS1 | RC0402FR-0732K4L | RESISTOR, METAL GLAZE/THICK FILM, 0.0625 W, 1 %, 100 PPM, 32400 OHM, SURFACE MOUNT, 0402 | Active | Preferred |  | ROHS EXEMPT:7(C)-1 | Yes - by exemption | Legacy Inventory Status: Cleared
 |  |  |  |  |  |  |  |  |  |  |  |  |  |  |  |  |  |  |  |  |  |  |  |  |  | true | false | VISHAY_RMS1 | CRCW040232K4FKED | THICK FILM RECTANGULAR CHIP RESISTOR | Active | Preferred |  | ROHS EXEMPT:7(C)-1 | Yes - by exemption | Legacy Inventory Status: Cleared
 |  |  |  |  |  |  |  |  |  |  |  |  |  |  |  |  |  |  |  |  |  |  |  |  |  | true | false | YAGEO_RMS1 | 232270673243L | RESISTOR, METAL GLAZE/THICK FILM, 0.0625 W, 1 %, 100 PPM, 32400 OHM, SURFACE MOUNT, 0402 | Active | Preferred |  | BRAND: PHYCOMP.ROHS EXEMPT:7(C)-1 | Yes - by exemption | Legacy Inventory Status: Cleared
1 | true | true | false | false | false | 0 | 10022155 | RESISTOR,105 KOHM,0.063W,+/-1%,0402 | B ECO-R252636 | 1 | Each | Production |  | R11 |  |  |  |  |  | Part | BDRM |  | 1 |  |  | true | false | YAGEO_RMS1 | RC0402FR-07105KL | RESISTOR, METAL GLAZE/THICK FILM, 0.0625 W, 1 %, 100 PPM, 105000 OHM, SURFACE MOUNT, 0402 | Active | Preferred |  | ROHS EXEMPTION: 7(C)-1 | Yes - by exemption | Legacy Inventory Status: Cleared
 |  |  |  |  |  |  |  |  |  |  |  |  |  |  |  |  |  |  |  |  |  |  |  |  |  | true | false | YAGEO_RMS1 | 232270671054L | RESISTOR, METAL GLAZE/THICK FILM, 0.0625 W, 1 %, 100 PPM, 105000 OHM, SURFACE MOUNT, 0402 | Active | Preferred |  | BRAND: PHYCOMP. ROHS EXEMPTION: 7(C)-1 | Yes - by exemption | Legacy Inventory Status: Cleared
 |  |  |  |  |  |  |  |  |  |  |  |  |  |  |  |  |  |  |  |  |  |  |  |  |  | true | false | VISHAY_RMS1 | CRCW0402105KFKED | THICK FILM RECTANGULAR CHIP RESISTOR | Active | Preferred |  | ROHS EXEMPTION: 7(C)-1 | Yes - by exemption | Legacy Inventory Status: Cleared
1 | true | true | false | false | false | 0 | 10022156 | RESISTOR, 470 OHM, 0.063W, +/-1%, 0402 | B ECO-R252636 | 2 | Each | Production |  | R12,R22 |  |  |  |  |  | Part | BDRM |  | 1 |  |  | true | false | YAGEO_RMS1 | RC0402FR-07470RL |  | Active | Preferred |  | ROHS EXEMPT: 7(C)-1 | Yes - by exemption | Legacy Inventory Status: Cleared
 |  |  |  |  |  |  |  |  |  |  |  |  |  |  |  |  |  |  |  |  |  |  |  |  |  | true | false | YAGEO_RMS1 | 232270674701L | RESISTOR, METAL GLAZE/THICK FILM, 0.0625 W, 1 %, 100 PPM, 470 OHM, SURFACE MOUNT, 0402 | Active | Preferred |  | BRAND: PHYCOMP.ROHS EXEMPT: 7(C)-1 | Yes - by exemption | Legacy Inventory Status: Cleared
 |  |  |  |  |  |  |  |  |  |  |  |  |  |  |  |  |  |  |  |  |  |  |  |  |  | true | false | VISHAY_RMS1 | CRCW0402470RFKED | RES 470 OHM 1/16W 1% 0402 SMD | Active | Preferred |  | ROHS EXEMPT: 7(C)-1 | Yes - by exemption | Legacy Inventory Status: Cleared
1 | true | true | false | false | false | 0 | 10022158 | SWITCHING REGULATOR,40V, 1.3 A | A ECO-R252636 | 1 | Each | Production |  | IC8 |  |  |  |  |  | Part | BDRM |  | 1 |  |  | true | false | LINEAR TECHNOLOGY_RMS1 | LT3471EDD#PBF | DUAL BOOST INVERTER | Active | Preferred |  |  | Yes | Legacy Inventory Status: Cleared
 |  |  |  |  |  |  |  |  |  |  |  |  |  |  |  |  |  |  |  |  |  |  |  |  |  | true | false | LINEAR TECHNOLOGY_RMS1 | LT3471EDD#TRPBF | DUAL BOOST INVERTER | Active | Preferred |  | TAPE & REEL | Yes | Legacy Inventory Status: Cleared
1 | true | true | false | false | false | 0 | 10022162 | INDUCTOR, STORAGE 10UH, WE-TPC | A ECO-R252636 | 1 | Each | Production |  | L2 |  |  |  |  |  | Part | BDRM |  | 1 |  |  | true | false | TAIYO YUDEN_RMS1 | NR 4018T 100M | SMD INDUCTOR | Active | Preferred |  |  | Yes | Legacy Inventory Status: Cleared
 |  |  |  |  |  |  |  |  |  |  |  |  |  |  |  |  |  |  |  |  |  |  |  |  |  | true | false | WURTH ELEKTRONIK GMBH | 744031100 | POWER CHOKE | Active | Preferred |  |  | Yes | Legacy Inventory Status: Cleared
1 | true | true | true | false | false | 0 | 10022518 | DIODE SCHOTTKY, 200MA,30V,SOD23DIO | C ECO-R252633 | 3 | Each | Production |  | D3,D4,D9 |  |  |  |  |  | Part | BDRM |  | 1 |  |  | true | false | NXP SEMICONDUCTORS_RMS1 | BAT54S,215 |  | Active | Preferred |  |  | Yes | Legacy Inventory Status: Cleared
 |  |  |  |  |  |  |  |  |  |  |  |  |  |  |  |  |  |  |  |  |  |  |  |  |  | true | false | NXP SEMICONDUCTORS_RMS1 | BAT54S | SCHOTTKY BARRIER (DOUBLE) DIODE | Active | Preferred |  |  | Yes | Legacy Inventory Status: Cleared
1 | true | true | false | false | false | 0 | 10022607 | CAPACITOR,100NF,16V,+/-10%,X7R,0402 | D EC113997 | 16 | Each | Production |  | C5,C7,C8,C9,C10,C11,C15,C16,C17,C18,C19,C25,C30,C31,C32,C33 |  |  |  |  |  | Part | BDRM |  | 1 |  |  | true | false | YAGEO_RMS1 | CC0402KRX7R7BB104 | CAP CER 0.1uF 16V X7R 10% 0402 | Active | Preferred |  |  | RoHS3 Compliant | Cleared
 |  |  |  |  |  |  |  |  |  |  |  |  |  |  |  |  |  |  |  |  |  |  |  |  |  | true | false | YAGEO_RMS1 | 223878715649 | CAPACITOR, CERAMIC, MULTILAYER, 16 V, X7R, 0.1 UF, SURFACE MOUNT, 0402 | Active | Preferred |  | BRAND: PHYCOMP | Yes | Legacy Inventory Status: Cleared
 |  |  |  |  |  |  |  |  |  |  |  |  |  |  |  |  |  |  |  |  |  |  |  |  |  | true | false | MURATA MANUFACTURING CO., LTD. | GRM155R71C104KA88D | MONOLITHIC CERAMIC CAPACITOR | Active | Preferred |  |  | Yes | Legacy Inventory Status: Cleared
 |  |  |  |  |  |  |  |  |  |  |  |  |  |  |  |  |  |  |  |  |  |  |  |  |  | true | false | MURATA | GRM155R71C104JA88J | CAPACITOR, CERAMIC, MULTILAYER, 16V, X7R, 0.1UF, 0402 | Active | Preferred |  |  | Yes | CLEARED
1 | true | true | false | false | false | 0 | 10022624 | INDUCTOR, STORAGE, 15UH, WE-TPC | A ECO-R252636 | 2 | Each | Production |  | L3,L4 |  |  |  |  |  | Part | BDRM |  | 1 |  |  | true | false | TAIYO YUDEN_RMS1 | NR 4012T 150M | SMD INDUCTOR | Active | Preferred |  |  | Yes | Legacy Inventory Status: Cleared
 |  |  |  |  |  |  |  |  |  |  |  |  |  |  |  |  |  |  |  |  |  |  |  |  |  | true | false | WURTH ELEKTRONIK GMBH | 744031150 | POWER CHOKE | Active | Preferred |  |  | Yes | Legacy Inventory Status: Cleared
1 | true | true | false | false | false | 0 | 10022627 | CAPACITOR,33NF,+/-10%,16V,X7R,0603 | B ECO-R252636 | 2 | Each | Production |  | C13,C14 |  |  |  |  |  | Part | BDRM |  | 1 |  |  | true | false | AVX_RMS1 | 0603YC333KAT2A | X7R DIELECTRIC | Active | Preferred |  |  | Yes | Legacy Inventory Status: Cleared
 |  |  |  |  |  |  |  |  |  |  |  |  |  |  |  |  |  |  |  |  |  |  |  |  |  | true | false | YAGEO_RMS1 | CC0603KRX7R7BB333 | CAPACITOR, CERAMIC, MULTILAYER, 16 V, X7R, 0.033 UF, SURFACE MOUNT, 0603 | Active | Preferred |  |  | Yes | Legacy Inventory Status: Cleared
 |  |  |  |  |  |  |  |  |  |  |  |  |  |  |  |  |  |  |  |  |  |  |  |  |  | true | false | YAGEO_RMS1 | 223878615643 | CAPACITOR, CERAMIC, MULTILAYER, 16 V, X7R, 0.033 UF, SURFACE MOUNT, 0603 | Active | Preferred |  | BRAND: PHYCOMP | Yes | Legacy Inventory Status: Cleared
 |  |  |  |  |  |  |  |  |  |  |  |  |  |  |  |  |  |  |  |  |  |  |  |  |  | true | false | SAMSUNG_RMS1 | CL10B333KO8NNNC | MULTILAYER CERAMIC CHIP CAPACITOR | Active | Preferred |  |  | Yes | Legacy Inventory Status: Cleared
1 | true | true | false | false | false | 0 | 10022653 | DIODE SCHOTTKY DOUBLE,30V, 200MA,SOT23 | C ECO-R252636 | 4 | Each | Production |  | D2,D6,D16,D17 |  |  |  |  |  | Part | BDRM |  | 1 |  |  | true | false | NXP SEMICONDUCTORS_RMS1 | BAT54C,215 |  | Active | Preferred |  |  | Yes | Legacy Inventory Status: Cleared
 |  |  |  |  |  |  |  |  |  |  |  |  |  |  |  |  |  |  |  |  |  |  |  |  |  | true | false | NXP SEMICONDUCTORS_RMS1 | BAT54C | SCHOTTKY BARRIER DOUBLE DIODE | Active | Preferred |  |  | Yes | Legacy Inventory Status: Cleared
1 | true | true | false | false | false | 0 | 10022657 | DIODE ZENER, 0.35,5.1V, SOT23 | B ECO-R252636 | 1 | Each | Production |  | D7 |  |  |  |  |  | Part | BDRM |  | 1 |  |  | true | false | NXP SEMICONDUCTORS_RMS1 | BZX84-C5V1 | VOLTAGE REGULATOR DIODE | Active | Preferred |  |  | Yes | Legacy Inventory Status: Cleared
 |  |  |  |  |  |  |  |  |  |  |  |  |  |  |  |  |  |  |  |  |  |  |  |  |  | true | false | NXP SEMICONDUCTORS_RMS1 | BZX84-C5V1,215 |  | Active | Preferred |  |  | Yes | Legacy Inventory Status: Cleared
1 | true | true | false | false | false | 0 | 10022697 | RESISTOR,470 OHM, 0.125W,+/-1%, 0805 | C ECO-R252636 | 1 | Each | Production |  | R71 |  |  |  |  |  | Part | BDRM |  | 1 |  |  | true | false | YAGEO_RMS1 | 232273464701L | RESISTOR, METAL GLAZE/THICK FILM, 0.125 W, 1 %, 100 PPM, 470 OHM, SURFACE MOUNT, 0805 | Active | Preferred |  | BRAND: PHYCOMP. ROHS EXEMPTION: 7(C)-1 | Yes - by exemption | Legacy Inventory Status: Cleared
 |  |  |  |  |  |  |  |  |  |  |  |  |  |  |  |  |  |  |  |  |  |  |  |  |  | true | false | VISHAY_RMS1 | CRCW0805470RFKEA | THICK FILM RECTANGULAR CHIP RESISTOR | Active | Preferred |  | ROHS EXEMPTION: 7(C)-1 | Yes - by exemption | Legacy Inventory Status: Cleared
 |  |  |  |  |  |  |  |  |  |  |  |  |  |  |  |  |  |  |  |  |  |  |  |  |  | true | false | YAGEO_RMS1 | 232273464701 | RESISTOR, METAL GLAZE/THICK FILM, 0.125 W, 1 %, 100 PPM, 470 OHM, SURFACE MOUNT, 0805 | Active | Preferred |  | BRAND: PHYCOMP.ROHS EXEMPTION: 7(C)-1 | Yes - by exemption | Legacy Inventory Status: Cleared
 |  |  |  |  |  |  |  |  |  |  |  |  |  |  |  |  |  |  |  |  |  |  |  |  |  | true | false | YAGEO_RMS1 | RC0805FR-07470RL | RESISTOR, METAL GLAZE/THICK FILM, 0.125 W, 1 %, 100 PPM, 470 OHM, SURFACE MOUNT, 0805 | Active | Preferred |  | ROHS EXEMPTION: 7(C)-1 | Yes - by exemption | Legacy Inventory Status: Cleared
 |  |  |  |  |  |  |  |  |  |  |  |  |  |  |  |  |  |  |  |  |  |  |  |  |  | true | false | ASJ | CR21-4700FL | THICK FILM CHIP RESISTOR | Active | Preferred |  | ROHS EXEMPTION: 7(C)-1 | Yes - by exemption | Legacy Inventory Status: Cleared
1 | true | true | false | false | false | 0 | 10022725 | RESISTOR, 1.5 OHM,+/-1%,0.063W,0402 | B ECO-R252636 | 4 | Each | Production |  | R13,R14,R19,R20 |  |  |  |  |  | Part | BDRM |  | 1 |  |  | true | false | YAGEO_RMS1 | RC0402FR-071R5L | RESISTOR, METAL GLAZE/THICK FILM, 0.0625 W, 1 %, 200 PPM, 1.5 OHM, SURFACE MOUNT, 0402 | Active | Preferred |  | ROHS EXEMPT: 7(C)-1 | Yes - by exemption | Legacy Inventory Status: Cleared
 |  |  |  |  |  |  |  |  |  |  |  |  |  |  |  |  |  |  |  |  |  |  |  |  |  | true | false | YAGEO_RMS1 | 232270671508L | RESISTOR, METAL GLAZE/THICK FILM, 0.0625 W, 1 %, 200 PPM, 1.5 OHM, SURFACE MOUNT, 0402 | Active | Preferred |  | BRAND: PHYCOMP.ROHS EXEMPT: 7(C)-1 | Yes - by exemption | Legacy Inventory Status: Cleared
 |  |  |  |  |  |  |  |  |  |  |  |  |  |  |  |  |  |  |  |  |  |  |  |  |  | true | false | VISHAY_RMS1 | CRCW04021R50FKED | RES SMD 1.5 OHM 1% 1/5W 0402 | Active | Preferred |  | ROHS EXEMPT: 7(C)-1 | Yes - by exemption | 7(c)-I
1 | true | true | false | false | false | 0 | 10022745 | RESISTOR, 33 OHM, +/-1%,0.063W, 0402 | B ECO-R252636 | 1 | Each | Production |  | R15 |  |  |  |  |  | Part | BDRM |  | 1 |  |  | true | false | VISHAY_RMS1 | CRCW040233R0FKED | RESISTOR 33R 1% 0.0625W 0402 VISHAY | Active | Preferred |  | ROHS EXEMPT:7(C)-1 | RoHS3 Compliant with exemptions | Cleared. Exemption 7(c)-I
 |  |  |  |  |  |  |  |  |  |  |  |  |  |  |  |  |  |  |  |  |  |  |  |  |  | true | false | YAGEO_RMS1 | 232270673309L | RESISTOR, METAL GLAZE/THICK FILM, 0.0625 W, 1 %, 100 PPM, 33 OHM, SURFACE MOUNT, 0402 | Active | Preferred |  | BRAND: PHYCOMP.ROHS EXEMPT:7(C)-1 | Yes - by exemption | Legacy Inventory Status: Cleared
 |  |  |  |  |  |  |  |  |  |  |  |  |  |  |  |  |  |  |  |  |  |  |  |  |  | true | false | YAGEO_RMS1 | RC0402FR-0733RL | RESISTOR, METAL GLAZE/THICK FILM, 0.0625 W, 1 %, 100 PPM, 33 OHM, SURFACE MOUNT, 0402 | Active | Preferred |  | ROHS EXEMPT:7(C)-1 | RoHS3 Compliant | Cleared. Exemption 7(c)-I
1 | true | true | false | false | false | 0 | 10022881 | RESISTOR, 150 KOHM,+/-1%,0.063W,0402 | B ECO-R252636 | 2 | Each | Production |  | R18,R21 |  |  |  |  |  | Part | BDRM |  | 1 |  |  | true | false | YAGEO_RMS1 | 232270671504L | RESISTOR, METAL GLAZE/THICK FILM, 0.0625 W, 1 %, 100 PPM, 150000 OHM, SURFACE MOUNT, 0402 | Active | Preferred |  | BRAND: PHYCOMP. ROHS EXEMPT: 7(C)-1 | Yes - by exemption | Legacy Inventory Status: Cleared
 |  |  |  |  |  |  |  |  |  |  |  |  |  |  |  |  |  |  |  |  |  |  |  |  |  | true | false | YAGEO_RMS1 | RC0402FR-07150KL | RESISTOR, METAL GLAZE/THICK FILM, 0.0625 W, 1 %, 100 PPM, 150000 OHM, SURFACE MOUNT, 0402 | Active | Preferred |  | ROHS EXEMPT: 7(C)-1 | Yes | Legacy Inventory Status: Cleared
 |  |  |  |  |  |  |  |  |  |  |  |  |  |  |  |  |  |  |  |  |  |  |  |  |  | true | false | VISHAY_RMS1 | CRCW0402150KFKED | THICK FILM, RECTANGULAR CHIP RESISTORS | Active | Preferred |  | ROHS EXEMPT: 7(C)-1 | Yes - by exemption | 7C-1
1 | true | true | false | false | false | 0 | 10022911 | SMD FERRITE, 1A,1206 | B ECO-R252636 | 1 | Each | Production |  | L1 |  |  |  |  |  | Part | BDRM |  | 1 |  |  | true | false | WURTH ELEKTRONIK GMBH | 74279218 | MULTILAYER-SMD-FERRITE | Active | Preferred |  | ROHS EXEMPT: 7(C)-1 | Yes | Legacy Inventory Status: Cleared
1 | true | true | false | false | false | 0 | 10022957 | RESISTOR, 2.2 KOHM, +/-1%, 0.063W, 0402 | B ECO-R252636 | 2 | Each | Production |  | R23,R65 |  |  |  |  |  | Part | BDRM |  | 1 |  |  | true | false | YAGEO_RMS1 | RC0402FR-072K2L | RESISTOR, METAL GLAZE/THICK FILM, 0.0625 W, 1 %, 100 PPM, 2200 OHM, SURFACE MOUNT, 0402 | Active | Preferred |  | ROHS EXMEPT: 7(C)-1 | RoHS3 Compliant with exemptions | Cleared. Exemption 7(c)-I
 |  |  |  |  |  |  |  |  |  |  |  |  |  |  |  |  |  |  |  |  |  |  |  |  |  | true | false | YAGEO_RMS1 | 232270672202L | RESISTOR, METAL GLAZE/THICK FILM, 0.0625 W, 1 %, 100 PPM, 2200 OHM, SURFACE MOUNT, 0402 | Active | Preferred |  | BRAND: PHYCOMP.ROHS EXMEPT: 7(C)-1 | Yes - by exemption | Legacy Inventory Status: Cleared
 |  |  |  |  |  |  |  |  |  |  |  |  |  |  |  |  |  |  |  |  |  |  |  |  |  | true | false | VISHAY_RMS1 | CRCW04022K20FKED | RESISTOR 2k2 1% 0.0625W 0402 VISHAY | Active | Preferred |  | ROHS EXMEPT: 7(C)-1 | RoHS3 Compliant with exemptions | Cleared. Exemption 7(c)?I
1 | true | true | false | false | false | 0 | 10022958 | CAPACITOR, 10NF, 16V +/2%, 0805 | A ECO-R252636 | 1 | Each | Production |  | C3 |  |  |  |  |  | Part | BDRM |  | 1 |  |  | true | false | PANASONIC_RMS1 | ECHU1C103GX5 | PLASTIC FILM CAPACITOR | Active | Preferred |  |  | Yes | Legacy Inventory Status: Cleared
1 | true | true | false | false | false | 0 | 10022966 | CAPACITOR CERAMIC, 220PF, 50V,+/-5%, NPO,0402 | C ECO-R252636 | 1 | Each | Production |  | C2 |  |  |  |  |  | Part | BDRM |  | 1 |  |  | true | false | YAGEO_RMS1 | 223886915221 | CAPACITOR, CERAMIC, MULTILAYER, 50 V, C0G, 0.00022 UF, SURFACE MOUNT, 0402 | Active | Preferred |  | BRAND: PHYCOMP | Yes | Legacy Inventory Status: Cleared
 |  |  |  |  |  |  |  |  |  |  |  |  |  |  |  |  |  |  |  |  |  |  |  |  |  | true | false | MURATA MANUFACTURING CO., LTD. | GRM1555C1H221JA01D | MONOLITHIC CERAMIC CAPACITOR | Active | Preferred |  |  | Yes | Legacy Inventory Status: Cleared
 |  |  |  |  |  |  |  |  |  |  |  |  |  |  |  |  |  |  |  |  |  |  |  |  |  | true | false | YAGEO_RMS1 | CC0402JRNPO9BN221 | CAPACITOR, CERAMIC, MULTILAYER, 50 V, C0G, 0.00022 UF, SURFACE MOUNT, 0402 | Active | Preferred |  |  | Yes | Legacy Inventory Status: Cleared
1 | true | true | false | false | false | 0 | 10023292 | RESISTOR,200 KOHM,+/-1%,0.063W,0402 | B ECO-R252636 | 1 | Each | Production |  | R69 |  |  |  |  |  | Part | BDRM |  | 1 |  |  | true | false | YAGEO_RMS1 | RC0402FR-07200KL | RES SMD 200K OHM 1% 1/16W 0402 | Active | Preferred |  | ROHS EXEMPT: 7(C)-1 | Yes - by exemption | 7(c)-I
 |  |  |  |  |  |  |  |  |  |  |  |  |  |  |  |  |  |  |  |  |  |  |  |  |  | true | false | VISHAY_RMS1 | CRCW0402200KFKED | RES 200K OHM 1/16W 1% 0402 SMD | Active | Preferred |  | ROHS EXEMPT: 7(C)-1 | Yes - by exemption | 7(c)-I
 |  |  |  |  |  |  |  |  |  |  |  |  |  |  |  |  |  |  |  |  |  |  |  |  |  | true | false | YAGEO_RMS1 | 232270672004L | RESISTOR, METAL GLAZE/THICK FILM, 0.0625 W, 1 %, 100 PPM, 200000 OHM, SURFACE MOUNT, 0402 | Active | Preferred |  | BRAND: PHYCOMP. ROHS EXEMPT: 7(C)-1 | Yes - by exemption | Legacy Inventory Status: Cleared
1 | true | true | false | false | false | 0 | 10024439 | RESISTOR, 15 KOHM, +/-1%,0.063W,0402 | B ECO-R252636 | 1 | Each | Production |  | R55 |  |  |  |  |  | Part | BDRM |  | 1 |  |  | true | false | YAGEO_RMS1 | 232270671503L | RESISTOR, METAL GLAZE/THICK FILM, 0.0625 W, 1 %, 100 PPM, 15000 OHM, SURFACE MOUNT, 0402 | Active | Preferred |  | BRAND: PHYCOMP.ROHS EXEMPT: 7(C)-1 | Yes - by exemption | Legacy Inventory Status: Cleared
 |  |  |  |  |  |  |  |  |  |  |  |  |  |  |  |  |  |  |  |  |  |  |  |  |  | true | false | VISHAY_RMS1 | CRCW040215K0FKED | RES SMD 15K OHM 1% 1/16W 0402 | Active | Preferred |  | ROHS EXEMPT: 7(C)-1 | Yes - by exemption | 7(c)-I
 |  |  |  |  |  |  |  |  |  |  |  |  |  |  |  |  |  |  |  |  |  |  |  |  |  | true | false | YAGEO_RMS1 | RC0402FR-0715KL | RES SMD 15K OHM 1% 1/16W 0402 | Active | Preferred |  | ROHS EXEMPT: 7(C)-1 | Yes - by exemption | 7(c)-I
1 | true | true | false | false | false | 0 | 10024440 | RESISTOR, 182 KOHM,+/-1%, 0.063W,0402 | B ECO-R252636 | 1 | Each | Production |  | R56 |  |  |  |  |  | Part | BDRM |  | 1 |  |  | true | false | YAGEO_RMS1 | 232270671824L | RESISTOR, METAL GLAZE/THICK FILM, 0.0625 W, 1 %, 100 PPM, 182000 OHM, SURFACE MOUNT, 0402 | Active | Preferred |  | BRAND: PHYCOMP.ROHS EXEMPT: 7(C)-1 | Yes - by exemption | Legacy Inventory Status: Cleared
 |  |  |  |  |  |  |  |  |  |  |  |  |  |  |  |  |  |  |  |  |  |  |  |  |  | true | false | VISHAY_RMS1 | CRCW0402182KFKED | THICK FILM RECTANGULAR CHIP RESISTORS | Active | Preferred |  | ROHS EXEMPT: 7(C)-1 | Yes - by exemption | 7C-1
 |  |  |  |  |  |  |  |  |  |  |  |  |  |  |  |  |  |  |  |  |  |  |  |  |  | true | false | YAGEO_RMS1 | RC0402FR-07182KL | RESISTOR, METAL GLAZE/THICK FILM, 0.0625 W, 1 %, 100 PPM, 182000 OHM, SURFACE MOUNT, 0402 | Active | Preferred |  | ROHS EXEMPT: 7(C)-1 | Yes - by exemption | Legacy Inventory Status: Cleared
1 | true | true | false | false | false | 0 | 10024441 | RESISTOR, 54.9 KOHM, +/-1%, 0.063W,0402 | B ECO-R252636 | 1 | Each | Production |  | R57 |  |  |  |  |  | Part | BDRM |  | 1 |  |  | true | false | YAGEO_RMS1 | RC0402FR-0754K9L | RESISTOR, METAL GLAZE/THICK FILM, 0.0625 W, 1 %, 100 PPM, 54900 OHM, SURFACE MOUNT, 0402 | Active | Preferred |  | ROHS EXEMPT: 7 (C)-1 | RoHS3 Compliant with exemptions | Exemption 7(c)-I shown on RoHS evidence
 |  |  |  |  |  |  |  |  |  |  |  |  |  |  |  |  |  |  |  |  |  |  |  |  |  | true | false | VISHAY_RMS1 | CRCW040254K9FKED | THICK FILM RECTANGULAR CHIP RESISTORS | Active | Preferred |  | ROHS EXEMPT: 7 (C)-1 | Yes - by exemption | Legacy Inventory Status: Cleared
 |  |  |  |  |  |  |  |  |  |  |  |  |  |  |  |  |  |  |  |  |  |  |  |  |  | true | false | YAGEO_RMS1 | 232270675493L | RESISTOR, METAL GLAZE/THICK FILM, 0.0625 W, 1 %, 100 PPM, 54900 OHM, SURFACE MOUNT, 0402 | Active | Preferred |  | BRAND: PHYCOMP. ROHS EXEMPT: 7 (C)-1 | Yes - by exemption | Legacy Inventory Status: Cleared
1 | true | true | false | false | false | 0 | 10024442 | RESISTOR, 4.99 KOHM, +/-1%, 1/16W,0402 | B ECO-R252636 | 1 | Each | Production |  | R58 |  |  |  |  |  | Part | BDRM |  | 1 |  |  | true | false | YAGEO_RMS1 | RC0402FR-074K99L | RESISTOR, METAL GLAZE/THICK FILM, 0.0625 W, 1 %, 100 PPM, 4990 OHM, SURFACE MOUNT, 0402 | Active | Preferred |  | ROHS EXEMPT: 7(C)-1 | Yes | Legacy Inventory Status: Cleared
 |  |  |  |  |  |  |  |  |  |  |  |  |  |  |  |  |  |  |  |  |  |  |  |  |  | true | false | YAGEO_RMS1 | 232270674992L | RESISTOR, METAL GLAZE/THICK FILM, 0.0625 W, 1 %, 100 PPM, 4990 OHM, SURFACE MOUNT, 0402 | Active | Preferred |  | BRAND: PHYCOMP.ROHS EXEMPT: 7(C)-1 | Yes - by exemption | Legacy Inventory Status: Cleared
 |  |  |  |  |  |  |  |  |  |  |  |  |  |  |  |  |  |  |  |  |  |  |  |  |  | true | false | VISHAY_RMS1 | CRCW04024K99FKED | RES SMD 4.99K OHM 1% 1/16W 0402 | Active | Preferred |  | ROHS EXEMPT: 7(C)-1 | Yes - by exemption | 7(c)-I
1 | true | true | false | false | false | 0 | 10024443 | TRANSISTOR, BIPOLAR, NPN, 45V, 100MA, SOT23 | B ECO-R252636 | 2 | Each | Production |  | T1,T3 |  |  |  |  |  | Part | BDRM |  | 1 |  |  | true | false | NXP SEMICONDUCTORS_RMS1 | BC847,215 |  | Active | Preferred |  |  | Yes | Legacy Inventory Status: Cleared
 |  |  |  |  |  |  |  |  |  |  |  |  |  |  |  |  |  |  |  |  |  |  |  |  |  | true | false | NXP SEMICONDUCTORS_RMS1 | BC847 | GENERAL PURPOSE TRANSISTOR, NPN | Active | Preferred |  |  | Yes | Legacy Inventory Status: Cleared
1 | true | true | false | false | false | 0 | 10024444 | TRANSISTOR, BIPOLAR, PNP, 45V, 100MA, SOT23 | B ECO-R252636 | 2 | Each | Production |  | T2,T4 |  |  |  |  |  | Part | BDRM |  | 1 |  |  | true | false | NXP SEMICONDUCTORS_RMS1 | BC857,215 |  | Active | Preferred |  |  | Yes | Legacy Inventory Status: Cleared
 |  |  |  |  |  |  |  |  |  |  |  |  |  |  |  |  |  |  |  |  |  |  |  |  |  | true | false | NXP SEMICONDUCTORS_RMS1 | BC857 | GENERAL PURPOSE TRANSISTOR, PNP | Active | Preferred |  |  | Yes | Legacy Inventory Status: Cleared
1 | true | true | false | false | false | 0 | 10024445 | TRANSISTOR, MOSFET, N CHANNEL, 20V, 5A, SOT23 | A ECO-R252636 | 5 | Each | Production |  | T5,T7,T9,T10,T13 |  |  |  |  |  | Part | BDRM |  | 1 |  |  | true | false | VISHAY_RMS1 | SI2312BDS-T1-E3 | N CHANNEL MOSFET | Active | Preferred |  |  | Yes | Legacy Inventory Status: Cleared
1 | true | true | false | false | false | 0 | 10024446 | TRANSISTOR, MOSFET, P CHANNEL, 12V, 3.8A, SOT23 | A ECO-R252636 | 4 | Each | Production |  | T6,T8,T11,T12 |  |  |  |  |  | Part | BDRM |  | 1 |  |  | true | false | VISHAY_RMS1 | SI2315BDS-T1-E3 | P CHANNEL MOSFET | Active | Preferred |  |  | Yes | Legacy Inventory Status: Cleared
1 | true | true | false | false | false | 0 | 10025553 | DIL, SLIDE SWITCH | A ECO-R252636 | 1 | Each | Production |  | SW1 |  |  |  |  |  | Part | BDRM |  | 1 |  |  | true | false | APEM COMPONENTS INC | NK236 | SUBMINIATURE SLIDE SWITCH | Active | Preferred |  |  | Yes | Legacy Inventory Status: Cleared
1 | true | true | false | false | false | 0 | 10025554 | RESISTOR, 47 KOHM +/-1% 0,063W,0402 | B ECO-R252636 | 2 | Each | Production |  | R53,R54 |  |  |  |  |  | Part | BDRM |  | 1 |  |  | true | false | VISHAY_RMS1 | CRCW040247K0FKED | THICK FILM RECTANGULAR CHIP | Active | Preferred |  | ROHS EXEMPT: 7(C)-1 | Yes - by exemption | Legacy Inventory Status: Cleared
 |  |  |  |  |  |  |  |  |  |  |  |  |  |  |  |  |  |  |  |  |  |  |  |  |  | true | false | YAGEO_RMS1 | 232270674703L | RESISTOR, METAL GLAZE/THICK FILM, 0.0625 W, 1 %, 100 PPM, 47000 OHM, SURFACE MOUNT, 0402 | Active | Preferred |  | BRAND: PHYCOMP. ROHS EXEMPT: 7(C)-1 | Yes - by exemption | Legacy Inventory Status: Cleared
 |  |  |  |  |  |  |  |  |  |  |  |  |  |  |  |  |  |  |  |  |  |  |  |  |  | true | false | YAGEO_RMS1 | RC0402FR-0747KL | RESISTOR, METAL GLAZE/THICK FILM, 0.0625 W, 1 %, 100 PPM, 47000 OHM, SURFACE MOUNT, 0402 | Active | Preferred |  | ROHS EXEMPT: 7(C)-1 | RoHS3 Compliant with exemptions | RoHS3 Compliant with exemptions
1 | true | true | false | false | false | 0 | 10025604 | RESISTOR 33 OHM +/- 1% 0,125W,0805 | B ECO-R252636 | 1 | Each | Production |  | R36 |  |  |  |  |  | Part | BDRM |  | 1 |  |  | true | false | VISHAY_RMS1 | CRCW080533R0FKEA | RES, 33.0K, 1/8W, 1%, 0805 SMD | Active | Preferred |  | ROHS EXEMPT: 7(C)-1 | Yes | Legacy Inventory Status: Cleared
 |  |  |  |  |  |  |  |  |  |  |  |  |  |  |  |  |  |  |  |  |  |  |  |  |  | true | false | YAGEO_RMS1 | RC0805FR-0733RL | RESISTOR, METAL GLAZE/THICK FILM, 0.125 W, 1 %, 100 PPM, 33 OHM, SURFACE MOUNT, 0805 | Active | Preferred |  | ROHS EXEMPT: 7(C)-1 | Yes - by exemption | Legacy Inventory Status: Cleared
 |  |  |  |  |  |  |  |  |  |  |  |  |  |  |  |  |  |  |  |  |  |  |  |  |  | true | false | YAGEO_RMS1 | 232273463309L | RESISTOR, METAL GLAZE/THICK FILM, 0.125 W, 1 %, 100 PPM, 33 OHM, SURFACE MOUNT, 0805 | Active | Preferred |  | BRAND: PHYCOMP.ROHS EXEMPT: 7(C)-1 | Yes - by exemption | Legacy Inventory Status: Cleared
1 | true | true | false | false | false | 0 | 10025605 | DIODE ZENER 0,35W 6,8V 2% | B ECO-R252636 | 1 | Each | Production |  | D15 |  |  |  |  |  | Part | BDRM |  | 1 |  |  | true | false | NXP SEMICONDUCTORS_RMS1 | BZX84-B6V8 | VOLTAGE REGULATOR DIODE | Active | Preferred |  |  | Yes | Legacy Inventory Status: Cleared
 |  |  |  |  |  |  |  |  |  |  |  |  |  |  |  |  |  |  |  |  |  |  |  |  |  | true | false | ON SEMICONDUCTOR_RMS1 | BZX84B6V8LT1G | VOLTAGE REGULATOR DIODE | Active | Preferred |  |  | Yes | Legacy Inventory Status: Cleared
 |  |  |  |  |  |  |  |  |  |  |  |  |  |  |  |  |  |  |  |  |  |  |  |  |  | true | false | NXP SEMICONDUCTORS_RMS1 | BZX84-B6V8,215 |  | Active | Preferred |  |  | Yes | Legacy Inventory Status: Cleared
1 | true | true | true | false | false | 0 | 10095973 | CAPACITOR ARRAY, 47PF, 50V, +/-10%,NPO,0612 | A ECO-R252633 | 1 | Each | Production |  | C1 |  |  |  |  |  | Part | BDRM |  | 1 |  |  | true | false | YAGEO_RMS1 | 225514611532 | ISOLATED C NETWORK, 50V, C0G, 0.000047UF, SURFACE MOUNT, CHIP-8 | Active | Preferred |  | BRAND: PHYCOMP | Yes | Legacy Inventory Status: Cleared
1 | true | true | false | false | false | 0 | 10098981 | CAPACITOR,100PF,50V,+/-5%,C0G,0402 | A ECO-R252636 | 2 | Each | Production |  | C27,C28 |  |  |  |  |  | Part | BDRM |  | 1 |  |  | true | false | MURATA MANUFACTURING CO., LTD. | GRM1555C1H101JZ01D | MONOLITHIC CERAMIC CAPACTIOR | Active | Preferred |  |  | Yes | Legacy Inventory Status: Cleared
 |  |  |  |  |  |  |  |  |  |  |  |  |  |  |  |  |  |  |  |  |  |  |  |  |  | true | false | YAGEO/PHYCOMP_RMS1 | 223886915101 | SURFACE MOUNT CERAMIC MULTILAYER CAPACITOR | Active | Preferred |  |  | Yes | Legacy Inventory Status: Cleared
 |  |  |  |  |  |  |  |  |  |  |  |  |  |  |  |  |  |  |  |  |  |  |  |  |  | true | false | YAGEO/PHYCOMP_RMS1 | CC0402JRNPO9BN101 | MULTILAYER CAPACITOR | Active | Preferred |  |  | Yes | Legacy Inventory Status: Cleared
1 | true | true | false | false | false | 0 | 10099021 | CAPACITOR CERAMIC,X7R,1UF,25V,+/10%, 0805 | A ECO-R252636 | 1 | Each | Production |  | C24 |  |  |  |  |  | Part | BDRM |  | 1 |  |  | true | false | VENKEL_RMS1 | C0805X7R250-105KN6D | CAP, CERAMIC, X7R, 1UF, 25V, +/10% 0805 | Active | Preferred |  |  | Yes | Legacy Inventory Status: Cleared
 |  |  |  |  |  |  |  |  |  |  |  |  |  |  |  |  |  |  |  |  |  |  |  |  |  | true | false | NIC COMPONENTS CORP. | NMC0805X7R105K25TRP3KF | CAP, CERAMIC, X7R, 1UF, 25V, +/10% 0805 | Active | Preferred |  |  | Yes | Legacy Inventory Status: Cleared
 |  |  |  |  |  |  |  |  |  |  |  |  |  |  |  |  |  |  |  |  |  |  |  |  |  | true | false | AVX_RMS1 | 08053C105KAZ2A | X7R DIELECTRIC | Active | Preferred |  |  | Yes | Legacy Inventory Status: Cleared
1 | true | true | false | false | false | 0 | 10099024 | FERRITE, 1K AT 100MHZ, 0.8 OHM, 50MA | A ECO-R252636 | 1 | Each | Production |  | FI1 |  |  |  |  |  | Part | BDRM |  | 1 |  |  | true | false | BOURNS_RMS1 | MA3216-102M4 | MA SERIES CHIP FERRITE BEAD ARRAYS | Active | Preferred |  |  | Yes | Legacy Inventory Status: Cleared
 |  |  |  |  |  |  |  |  |  |  |  |  |  |  |  |  |  |  |  |  |  |  |  |  |  | true | false | VISHAY_RMS1 | ILAS-1206-ER-102V |  | Active | Alternate |  |  | Yes | Legacy Inventory Status: Cleared
1 | true | true | false | false | false | 0 | 10099025 | VOLTAGE COMPARATOR | A ECO-R252636 | 1 | Each | Production |  | IC1 |  |  |  |  |  | Part | BDRM |  | 1 |  |  | true | false | NATIONAL SEMICONDUCTOR_RMS1 | LMC7211AIM5 NOPB | TINY CMOS COMPARATOR | Active | Preferred |  |  | Yes | Legacy Inventory Status: Cleared
 |  |  |  |  |  |  |  |  |  |  |  |  |  |  |  |  |  |  |  |  |  |  |  |  |  | true | false | NATIONAL SEMICONDUCTOR_RMS1 | LMC7211BIM5 NOPB | TINY CMOS COMPARATOR | Active | Preferred |  |  | Yes | Legacy Inventory Status: Cleared
1 | true | true | false | false | false | 0 | 10099026 | IC,ADJUSTABLE REGULATOR,0.1A | A ECO-R252636 | 1 | Each | Production |  | IC5 |  |  |  |  |  | Part | BDRM |  | 1 |  |  | true | false | NATIONAL SEMICONDUCTOR_RMS1 | LM317LM NOPB | 3 TERMINAL ADJUSTABLE REGULATOR | Active | Preferred |  |  | Yes | Legacy Inventory Status: Cleared
 |  |  |  |  |  |  |  |  |  |  |  |  |  |  |  |  |  |  |  |  |  |  |  |  |  | true | false | NATIONAL SEMICONDUCTOR_RMS1 | LM317LMX/NOPB |  | Active | Preferred |  |  | Yes | Legacy Inventory Status: Cleared
 |  |  |  |  |  |  |  |  |  |  |  |  |  |  |  |  |  |  |  |  |  |  |  |  |  | true | false | ON SEMICONDUCTOR_RMS1 | LM317LBDG | 100 MA ADJUSTABLE OUTPUT,POSITIVE VOLTAGE REGULATOR | Active | Preferred |  |  | Yes | Legacy Inventory Status: Cleared
 |  |  |  |  |  |  |  |  |  |  |  |  |  |  |  |  |  |  |  |  |  |  |  |  |  | true | false | ON SEMICONDUCTOR_RMS1 | LM317LBDR2G | 100 MA ADJUSTABLE OUTPUT,POSITIVE VOLTAGE REGULATOR | Active | Preferred |  | TAPE & REEL | Yes | Legacy Inventory Status: Cleared
1 | true | true | false | false | false | 0 | 10099028 | CONNECTOR,FEMALE 7-PIN CPU | A ECO-R252636 | 1 | Each | Production |  | J2 |  |  |  |  |  | Part | BDRM |  | 1 |  |  | true | false | J.S.T. CORPORATION | ZHR-7 | CONNECTOR | Active | Preferred |  |  | Yes | Legacy Inventory Status: Cleared
1 | true | false | false | false | false | 0 | 10125624 | SCHEMATIC DIAGRAM BUZZER CARD | A ECO-R256396 | 1 |  | Production |  |  |  |  |  |  |  | Document | BDRM |  | 1
1 | true | true | false | false | false | 0 | GR106771 | PRINTED CIRCUIT, BUZZER BOARD RB0505 | A MC002637 | 1 | Each | Production |  |  |  |  |  |  |  | Part | BDRM |  | 1 |  |  | true | false | TTM | GR106771 |  | Active | Preferred |  |  | Yes | Legacy Inventory Status: Cleared
1 | true | true | false | false | false | 1 | 10099027 | CONNECTOR, CRIMP | A ECO-R252636 | 7 | Each | Production |  |  |  |  |  |  |  | Part | BDRM |  | 1 |  |  | true | false | J.S.T. CORPORATION | SZH-002T-P0.5 | CONNECTOR CONTACT | Active | Preferred |  |  | Yes | Legacy Inventory Status: Cleared
1 | false | true | false | false | false | 2 | 10022165 | WHITE CABLE, LENGTH 60 MM, FOR J1 | B EC062254 | 7 | Each | Production |  |  |  |  |  |  |  | Part | BDRM |  | 1 |  |  | true | false | AXON | ET2607L | UNSCREENED HOOKUP WIRES | Active | Preferred |  |  | Yes | Cleared
 |  |  |  |  |  |  |  |  |  |  |  |  |  |  |  |  |  |  |  |  |  |  |  |  |  | true | false | NEXANS | KZ04-04 | UNSCREENED HOOKUP WIRES | Active | Preferred |  |  | Yes | Legacy Inventory Status: Cleared
1 | true | true | false | false | false | 3 | 10022161 | ADHESIVE | A ECO-R252636 | 1 | Each | Production |  |  |  |  |  |  |  | Part | BDRM |  | 1 |  |  | true | false | 3M_RMS1 | 7838 B/A | STRUCTURAL ADHESIVE | Active | Preferred |  |  | Yes | Legacy Inventory Status: Cleared
1 | true | true | true | false | false | 4 | 3838600 | PC BOARD TRACABILITY LABEL | C ECO-R252633 | 1 | Each | Production |  |  |  |  |  |  |  | Part | BDRM |  | 1 |  |  | true | false | BRADY_RMS1 | 3838600-H | B-727 LABEL, POLYIMIDE, GLOSSY WHITE THERMAL TRANSFER PRINTABLE LABEL STOCK | Active | Preferred |  | CUSTOM LABEL PER COVIDIEN DRAWING 3838600 | Yes | Legacy Inventory Status: Cleared
Manufacturers
Attachments(Image) | Manufacture Part Has Redline | Mfr. Name | Mfr. Part Number | Mfr. Part Description | Mfr. Part Lifecycle Phase | Preferred Status | Sites | Reference Notes | RoHS Compliant? | RoHS Compliance Statement
true | false | JABIL SUPPLIER - SHANGHAI UPP CO.,LTD.(LOC) | GR106768 |  | Active | Preferred |  | CUSTOM PART PER COVIDIEN P/N GR106768 | Yes | Legacy Inventory Status: Cleared
Attachments
Is Checked Out | Has Been Redlined | Filename | File Description | File Size | File Type | Attachment Type | Modified Date | Last View Date | Checkout User | Checkout Date | Checkout Location | Checkin User | Folder Number | Folder Version
false | false | GR106768_B_ECO-R252636.pdf | RMS Historical PDF - ECO-R252636 | 112334 | pdf |  | 18/Aug/2015 01:00:52 PM BST | 18/Aug/2015 01:00:52 PM BST |  |  |  | Migration, Data | FF0009980880 | 1
false | false | GR106768B00.zip | Approved Rev B - Source Files | 987081 | zip |  | 20/Jun/2015 10:27:42 AM BST | 20/Jun/2015 10:27:43 AM BST |  |  |  | Migration, Data | FF0008464643 | 1
false | false | GR106768B00.pdf | Approved Rev B | 24040 | pdf |  | 20/Jun/2015 10:27:42 AM BST | 23/Jan/2017 11:03:35 AM GMT |  |  |  | Migration, Data | FF0008464641 | 1
false | false | GR106768A00.pdf | Redlines From Rev A to B | 45882 | pdf |  | 20/Jun/2015 10:27:41 AM BST | 20/Jun/2015 10:27:42 AM BST |  |  |  | Migration, Data | FF0008464638 | 1
false | false | GR106768_B_ECO-R251316.pdf | RMS Historical PDF - ECO-R251316 | 112350 | pdf |  | 18/Aug/2015 01:00:53 PM BST | 18/Aug/2015 01:00:53 PM BST |  |  |  | Migration, Data | FF0009980882 | 1
