FlyingRat/Medtronic-PB560/Mechanical Part Drawings/2982400/72SP - Supporting Documentation/L6A051BE00004_BOM_Issue K.pdf

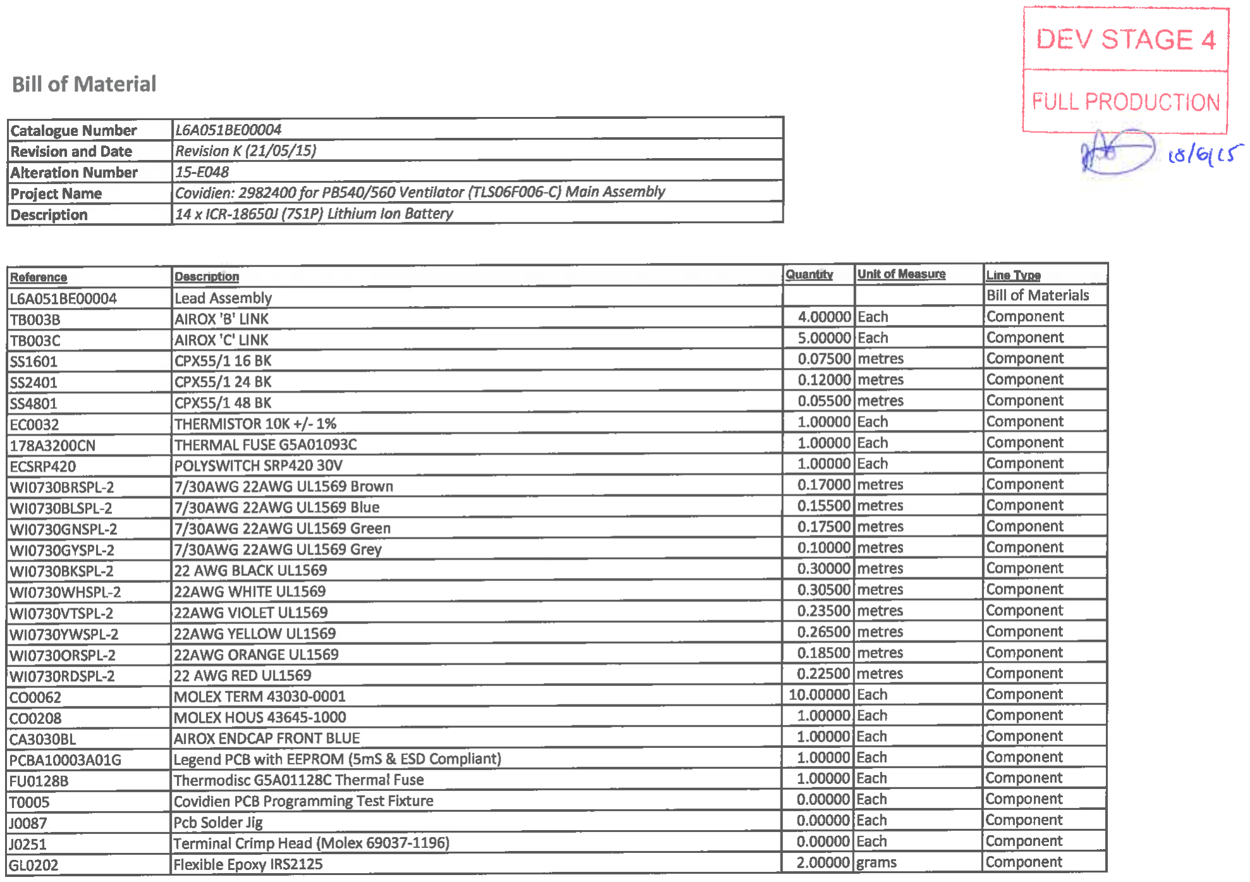
[picture p8: page 1]
