FlyingRat/Medtronic-PB560/(list of files, cad)

Other CAD files:
Manufacturing Fixtures/10021741_A.dwg
Mechanical Part Drawings/10053480/10053480B01.dwg
Mechanical Part Drawings/10080310/10080310E00.dwg
Mechanical Part Drawings/5094000/5094000N00.dwg
Manufacturing Fixtures/10025172 A00.dwg
Manufacturing Fixtures/10021744 Approved Revision A.dwg
Mechanical Part Drawings/2963300/2963300.SLDDRW
