FlyingRat/Medtronic-PB560/Manufacturing Fixtures/3834500 Approved Revision 01.pdf

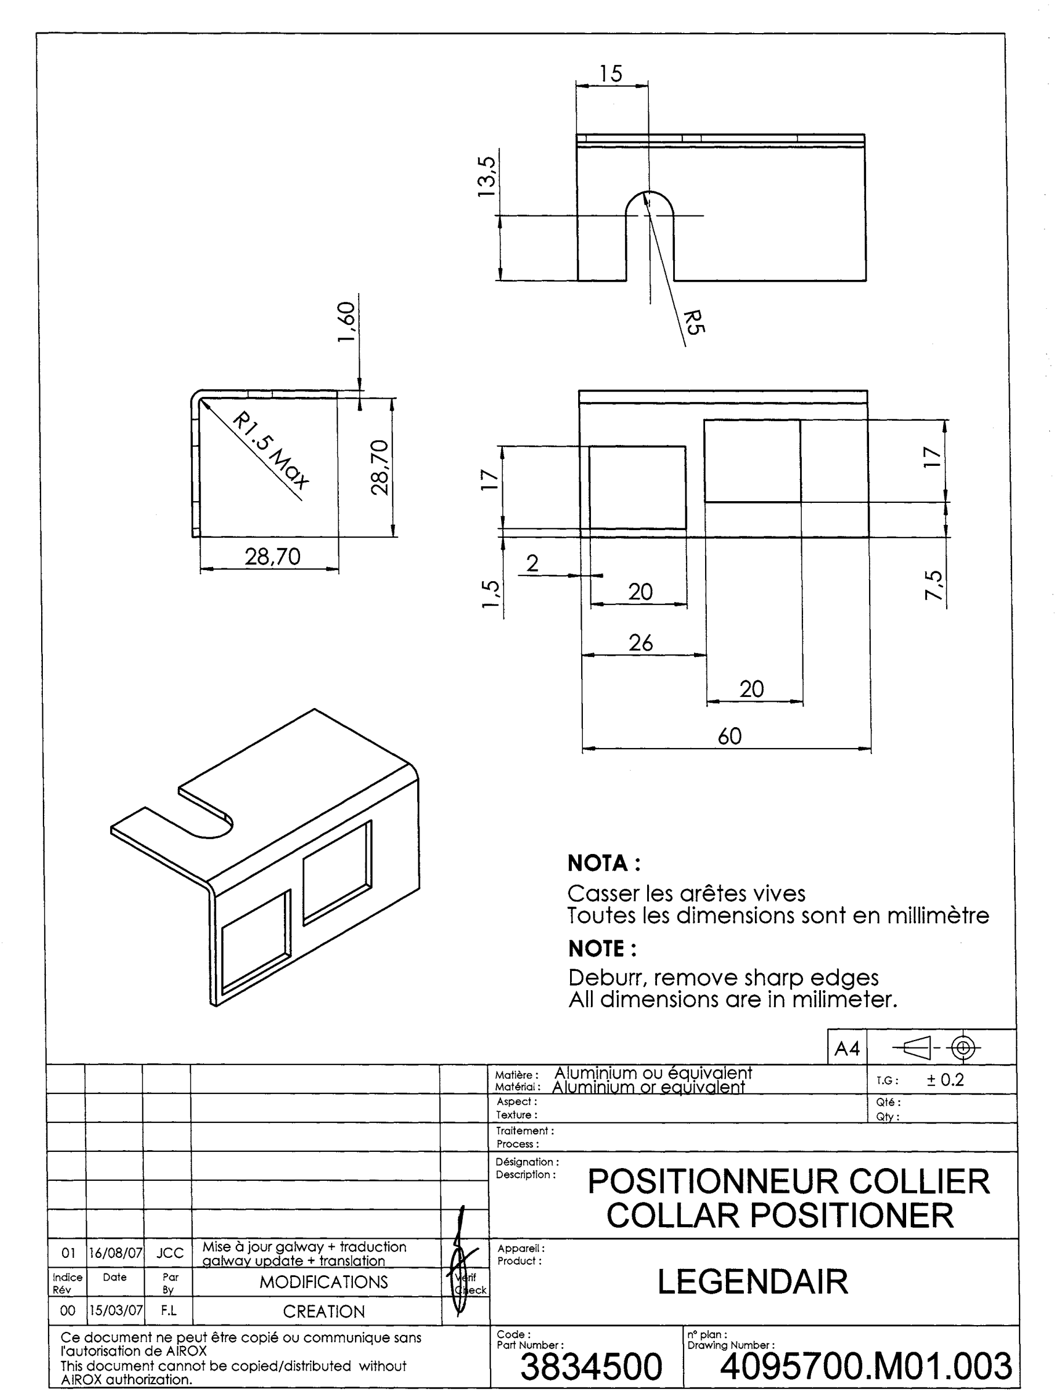
[picture p9: page 1]
