FlyingRat/Medtronic-PB560/Manufacturing Fixtures/3835000 Approved Revision 00.pdf

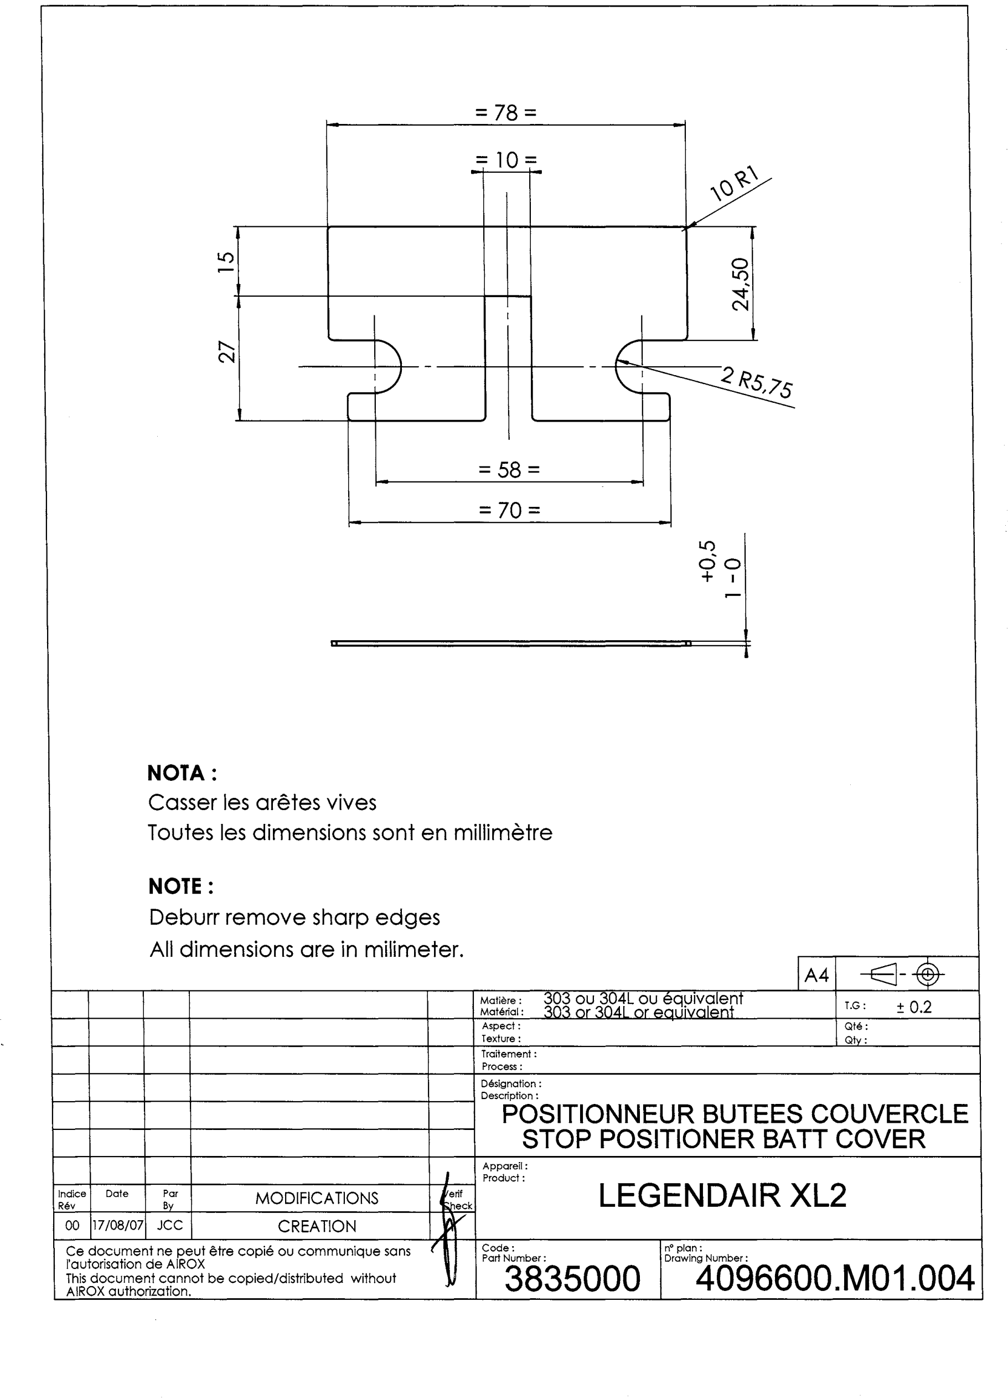
[picture p10: page 1]
