FlyingRat/Medtronic-PB560/Manufacturing Fixtures/3835100 Approved Revision 00.pdf

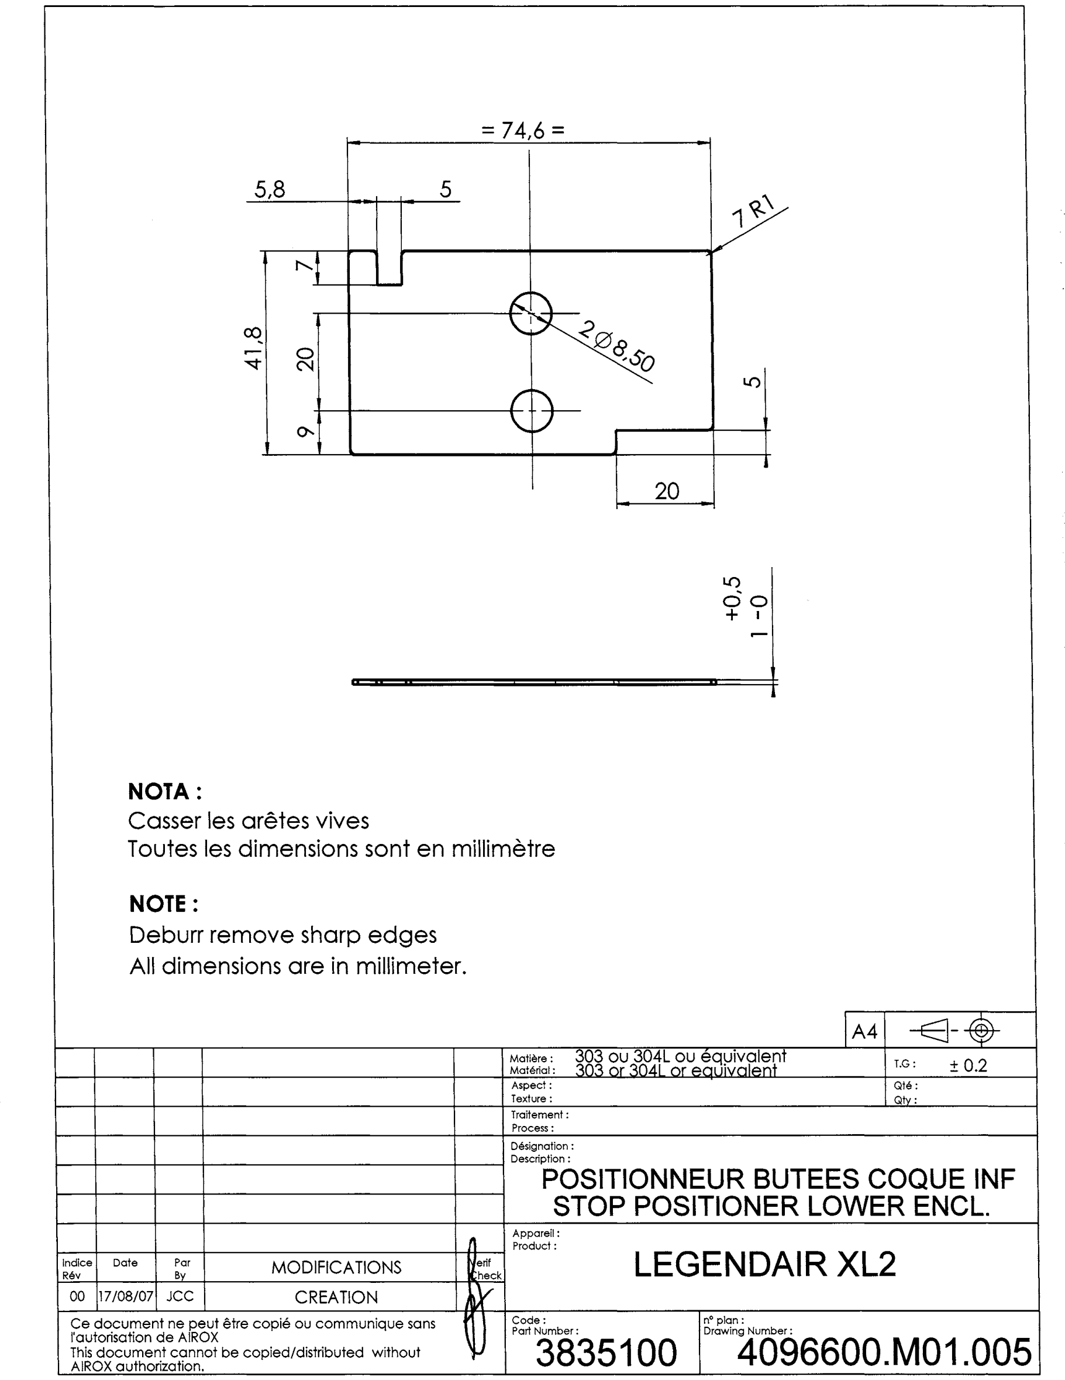
[picture p11: page 1]
