FlyingRat/Medtronic-PB560/Mechanical Part Drawings/2982400/72SP - Supporting Documentation/L6A051BE00004_FC_(2982400)_Issue J.pdf

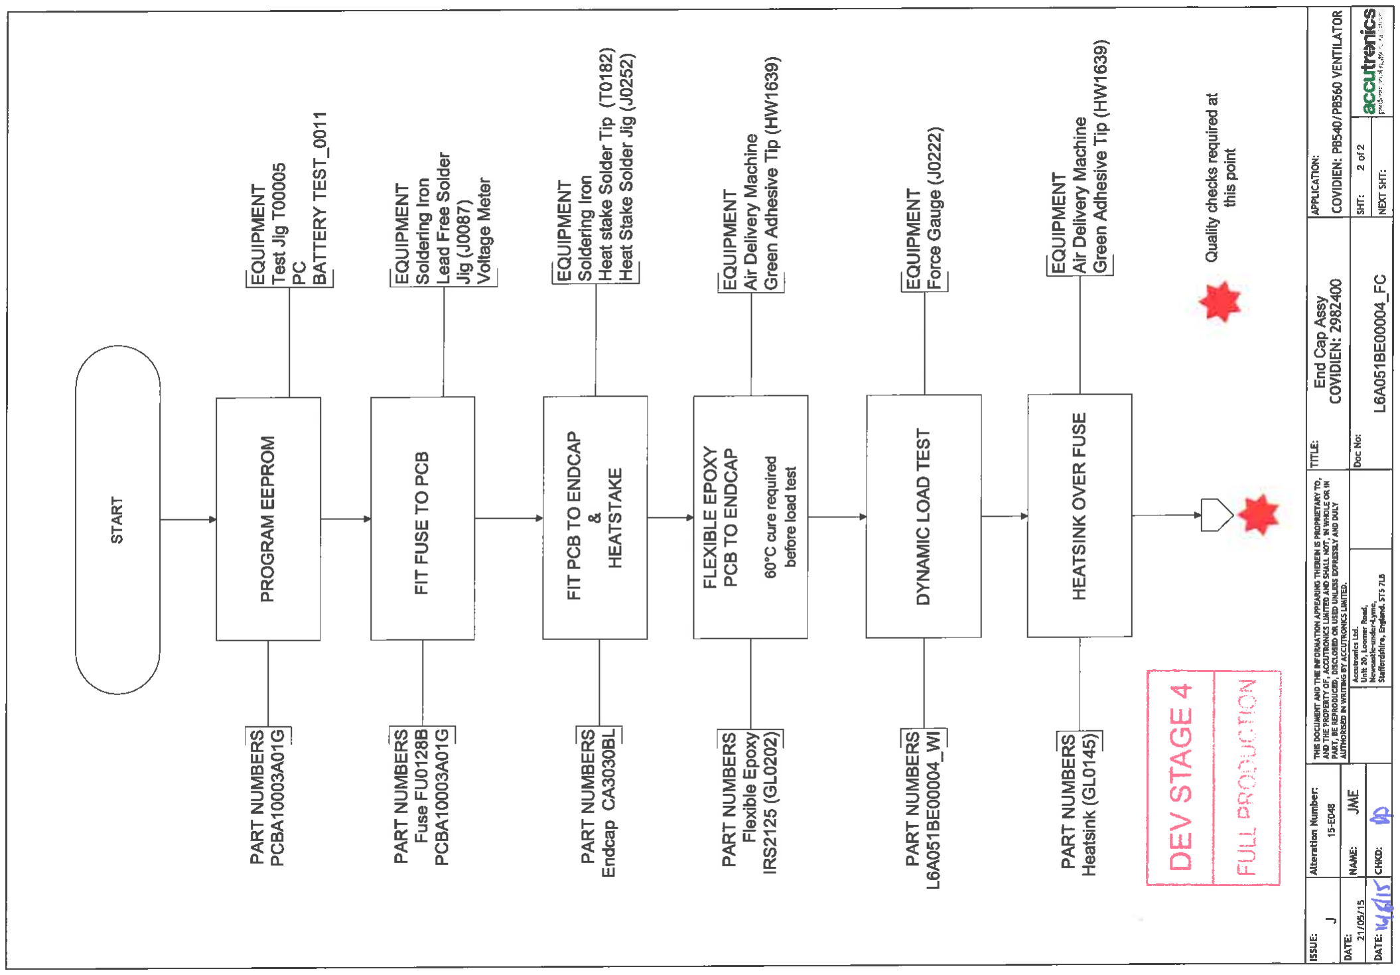
[picture p12: page 1]
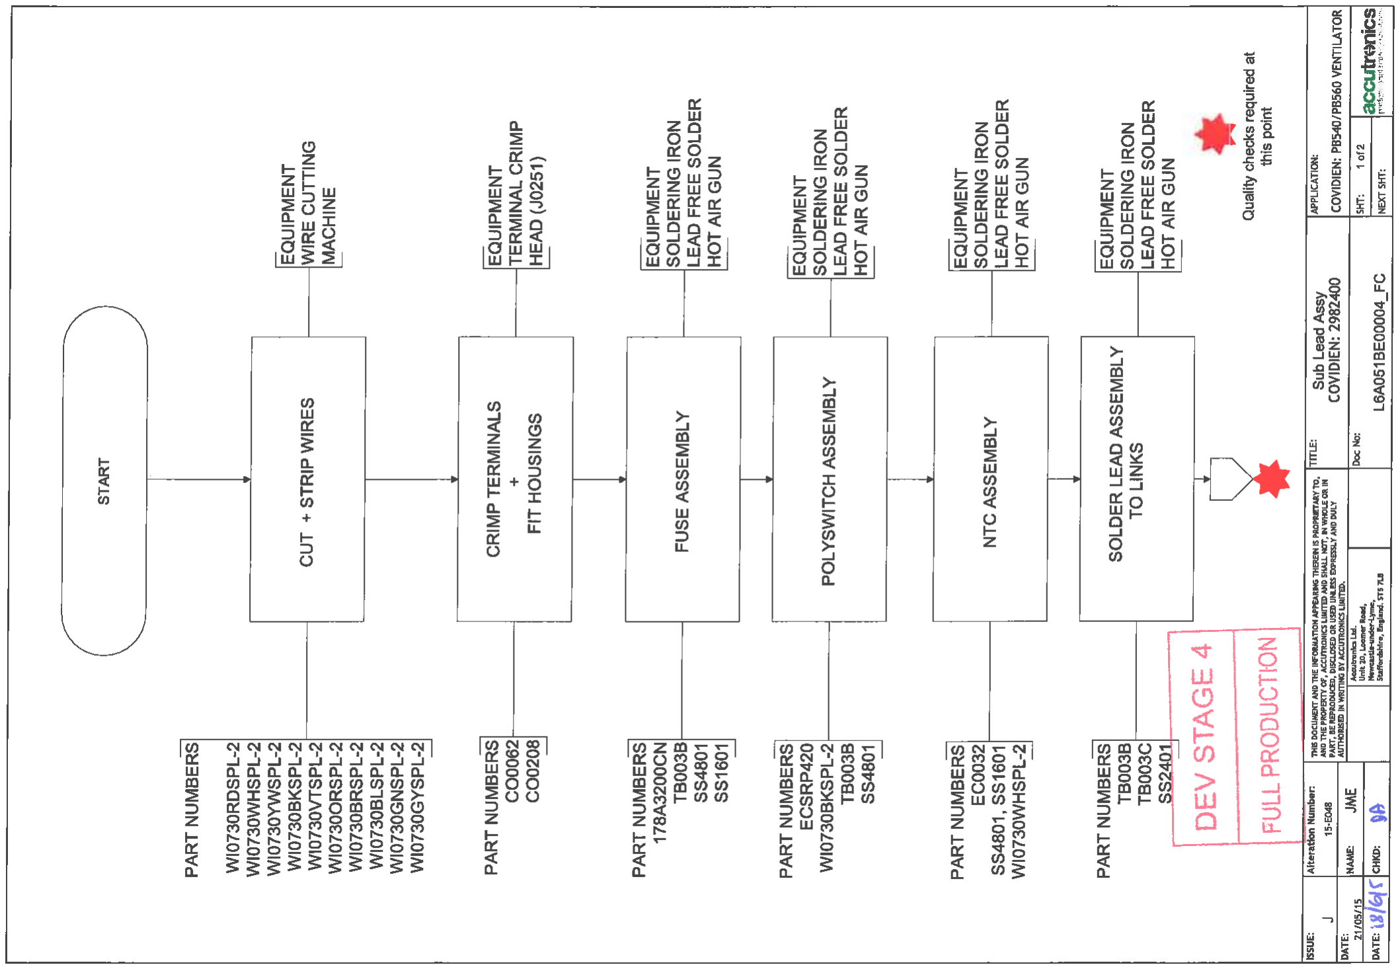
[picture p13: page 2]
