FlyingRat/Medtronic-PB560/Electronic PCBAs/10005011_Power Management_PCBA/3842800_POWER SUPPLY BOARD - TANTALUM LESS_PCBA/PCBA/3842800F00.pdf

107.95

55

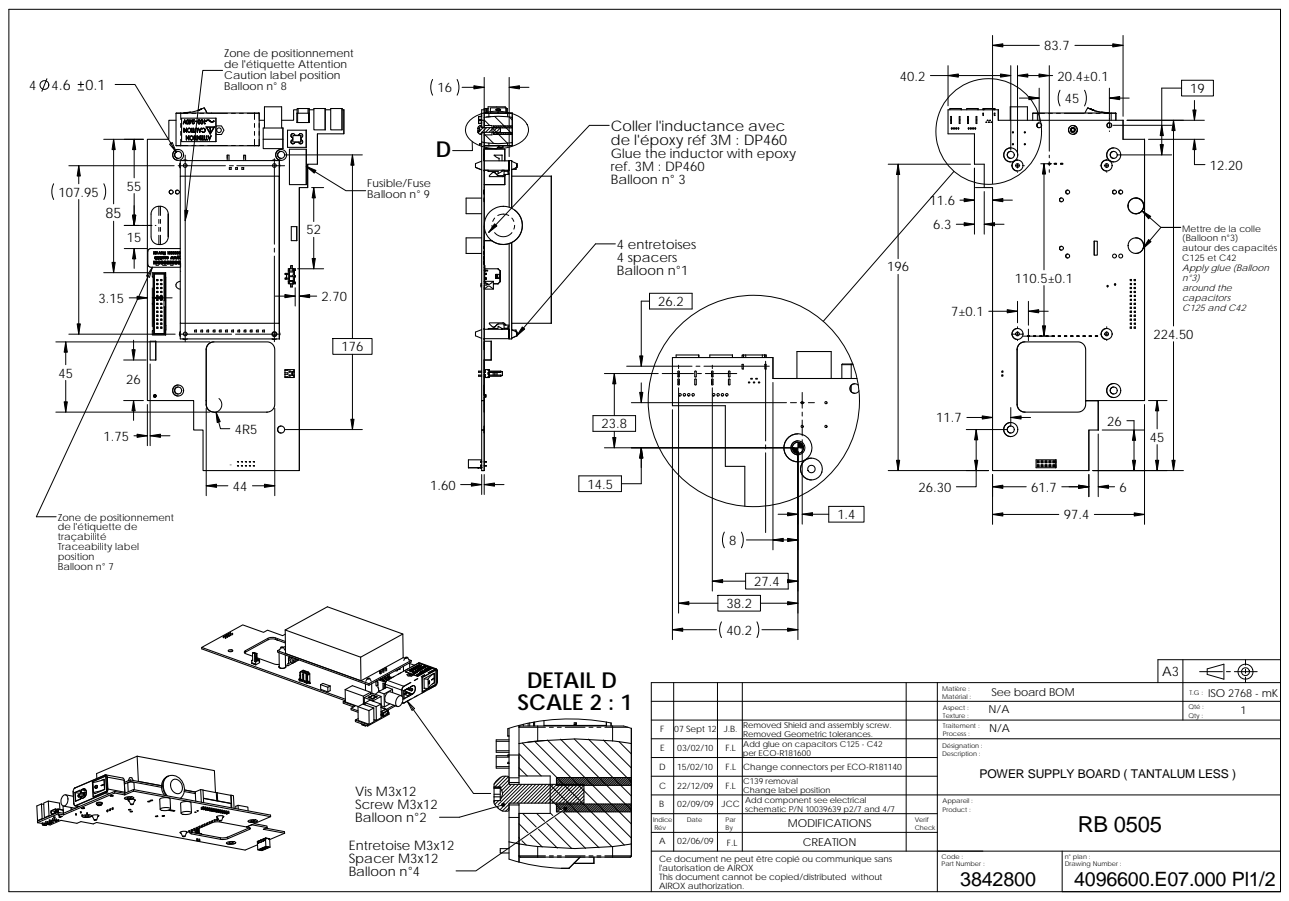
[picture p62: page 1]
SCALE 2 : 1; DETAIL D; Vis M3x12 Screw M3x12 Balloon n°2; Entretoise M3x12 Spacer M3x12 Balloon n°4; Fusible/Fuse Balloon n° 9; Balloon n°1; 4 entretoises 4 spacers

Zone de positionnement
de l'étiquette Attention
Caution label position
Balloon n° 8

Coller l'inductance avec
de l'époxy réf 3M : DP460
Glue the inductor with epoxy
ref. 3M : DP460
Balloon n° 3

Mettre de la colle
(Balloon n°3)
autour des capacités
Apply glue (Balloon
around the
capacitors
C125 and C42

de l'étiquette de
traçabilité
Traceability label
position
Balloon n° 7

Matière : See board BOM Matérial : | T.G : ISO 2768 - mK

Aspect : N/A Texture : | 1 Qty : Qté :

07 Sept 12 | J.B. | Removed Shield and assembly screw. Removed Geometric tolerances. | | Traitement : F N/A Process :

E | 03/02/10 | F.L | Add glue on capacitors C125 - C42 per ECO-R181600 | | Désignation : Description : POWER SUPPLY BOARD ( TANTALUM LESS )

D | 15/02/10 | F.L | Change connectors per ECO-R181140
C | 22/12/09 | F.L | C139 removal Change label position

B | 02/09/09 | JCC | Add component see electrical schematic P/N 10039639 p2/7 and 4/7 | | Appareil : Product : RB 0505

Indice Rév | Date | Par By | MODIFICATIONS | Verif Check
A | 02/06/09 | F.L | CREATION
Ce document ne peut être copié ou communique sans l'autorisation de AIROX This document cannot be copied/distributed without AIROX authorization. | Code : Part Number : 3842800 | n° plan : Drawing Number : 4096600.E07.000 Pl1/2

## 8 Keep Out Area 7

## 8 réserves 7

107.95

4.5

57.2

6.8

## 4 réserves 9 4 keep out area 9

## 4 réserves 7 4 keep out area 7

### NOTA :

NOTE :
-All the dimensions are in millimeter.
-IPC A610 class 3 :
- Non custom boards are not subject to the IPC-610 (Latest Revision) Class 3 requirement
- Connector types USB A (Rep: J12, J13) do not need to meet IPC-610 (Latest Revision) Class 3
- Connector type MICRO-FIT (Rep: J9)do not need to meet IPC-610 (LATEST REVISION) Class 3
-Certificate of compliance required.
-PCBAS are to be functionally tested as per INS-CQ-67
-Solder Reflow Profile of all Capacitors on the PCBA must meet the specifications outlined in the manufacturer's datasheets. -Manuel Soldering of all Capacitors on the PCBA, if required, must not exceed the maximum time
or temperature as outlined in the manufacturers' datasheets.
-Cleaning fluids and Solvents, if required, must be as per capacitor manufacturers' datasheets.
-All the screws are assembled with a torque of 1,55 inlb 0,22 inlb.
-Refer to PCB Board drawing 10039642 for profile and cutout dimensions not shown.

-IPC A610 classe 3:
- Les cartes standards ne sont pas soumises à la norme IPC-610 (Dernière Révision) Classe 3
- Les connecteurs de type USB A (Rep: J12, J13)ne sont pas soumis à la norme IPC-610 (Dernière Révision) Classe 3
- Le connecteur de type MICRO-FIT (Rep: J9)n'est pas soumis à la norme IPC-610 (Dernière Révision) Classe 3 -Toutes les dimensions sont en millimètre.
-Certificat de conformité éxigé.
-Tester la carte cablée selon l'instruction INS-CQ-67
-Le profil de température du flux de soudage de tous les condensateurs de la carte doit être conforme aux spécifiations des fabricants -La soudure à la main des condensateurs de la carte, si requise, doit respecter la température maximum de soudage indiquée
dans la spécification du fabricant.
-Les liquides de nettoyage ou autre détergeant, si requis, doivent être conforme aux spécifications des fabricants de composants. -Toutes les vis sont montées avec un couple de serrage de 0,175 Nm 0,025 N/m.
-Reportez-vous o PCB Board dessin 10039642 pour les dimensions de profil et un découpage ne pas démontrées.

A3

| | | | | Matière : See board BOM Matérial : | T.G : ISO 2768 - mK
| | | | | Aspect : N/A Texture : | 1 Qty : Qté :
F | 07 Sept 12 | J.B. | Removed Shield and assembly screw. Removed Geometric tolerances. | | Traitement : N/A Process :
E | 03/02/10 | F.L | Add glue on capacitors C125 - C42 per ECO-R181600 | | Désignation : Description : POWER SUPPLY BOARD ( TANTALUM LESS )
D | 15/02/10 | F.L | Change connectors per ECO-R181140
C | 22/12/09 | F.L | Schematic P/N 10039639 p2/7 and 4/7 Add component see electrical
B | 02/09/09 | JCC | C139 removal Change label position | | Appareil : Product : RB 0505
| | Par Rév Indice | MODIFICATIONS | Verif Date Check
A | 02/06/09 | F.L | CREATION
Ce document ne peut être copié ou communique sans l'autorisation de AIROX This document cannot be copied/distributed without AIROX authorization. | Code : Part Number : 3842800 | n° plan : Drawing Number : 4096600.E07.000 Pl2/2

CT1

J12 J13

J6

J1

J14

SW1

J7

J9

J2

J4 | J5

J3

## AC 220V insulated to 4000V

## Primary zone

PT1

## Zone primaire AC 220V isolée à 4000V

F1

4x 4±0.1

J10

## Zone primaire AC 220V isolée à 4000V Primary zone AC 220V insulated to 4000V
