FlyingRat/Medtronic-PB560/Manufacturing Fixtures/10021741_A - Stopcock, 1 way.pdf

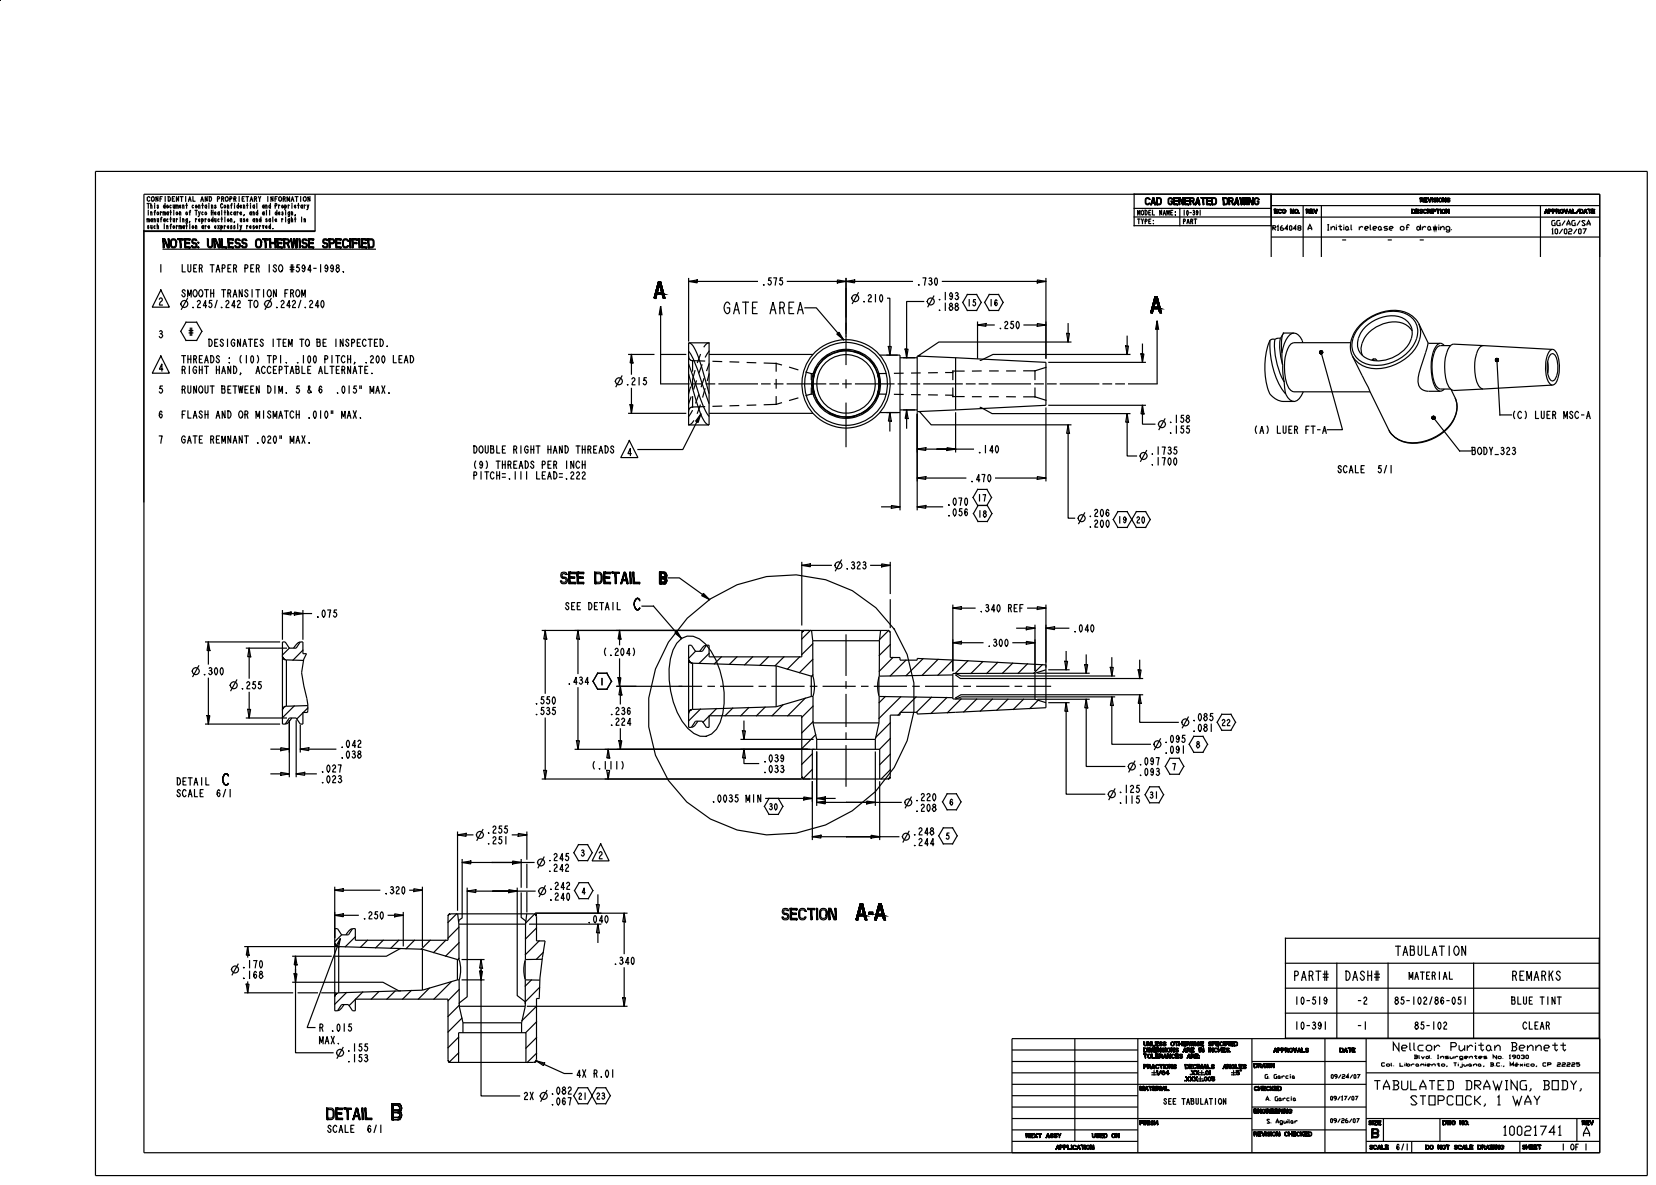
[picture p63: page 1]
