FlyingRat/Medtronic-PB560/Manufacturing Fixtures/10021744 Approved  Revision  A.pdf

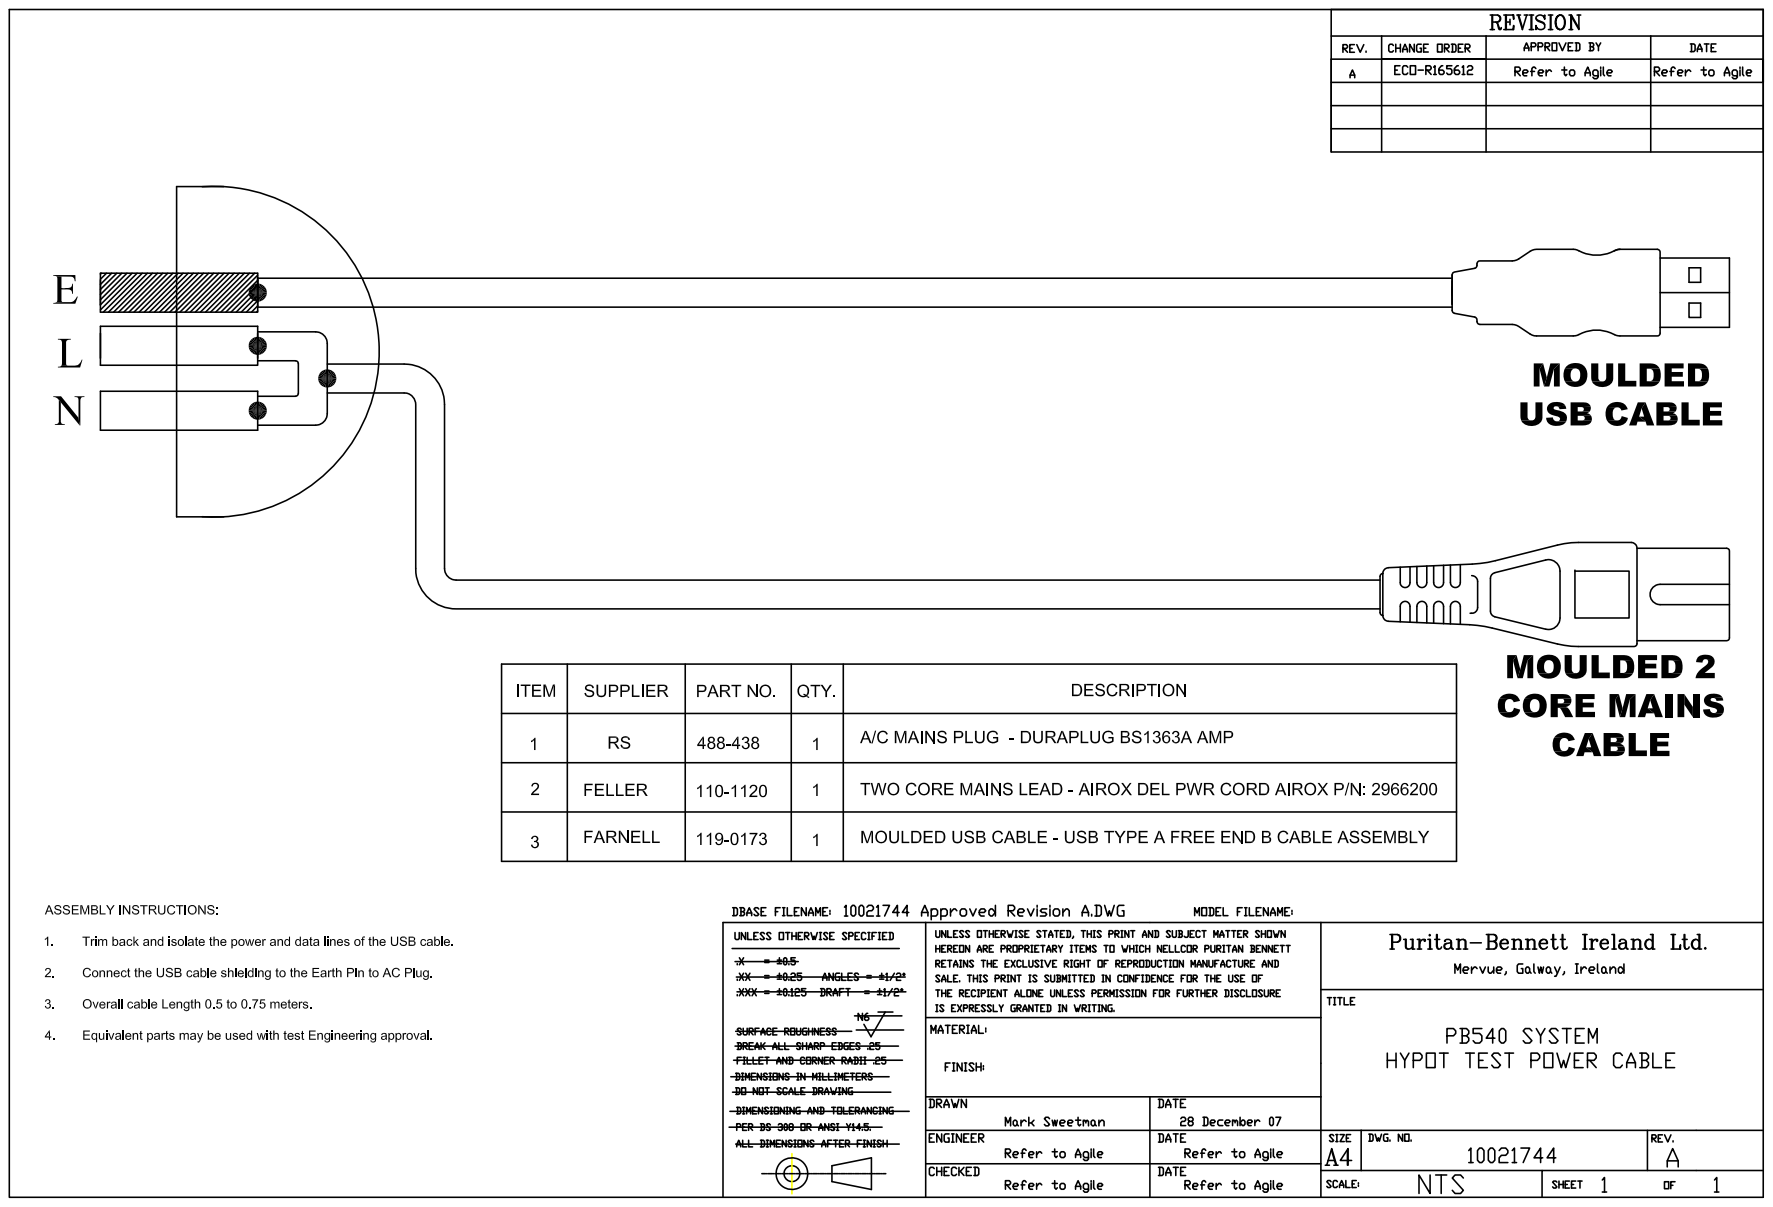
[picture p64: page 1]
