FlyingRat/Medtronic-PB560/Manufacturing Fixtures/10022189 Approved Revision A.pdf

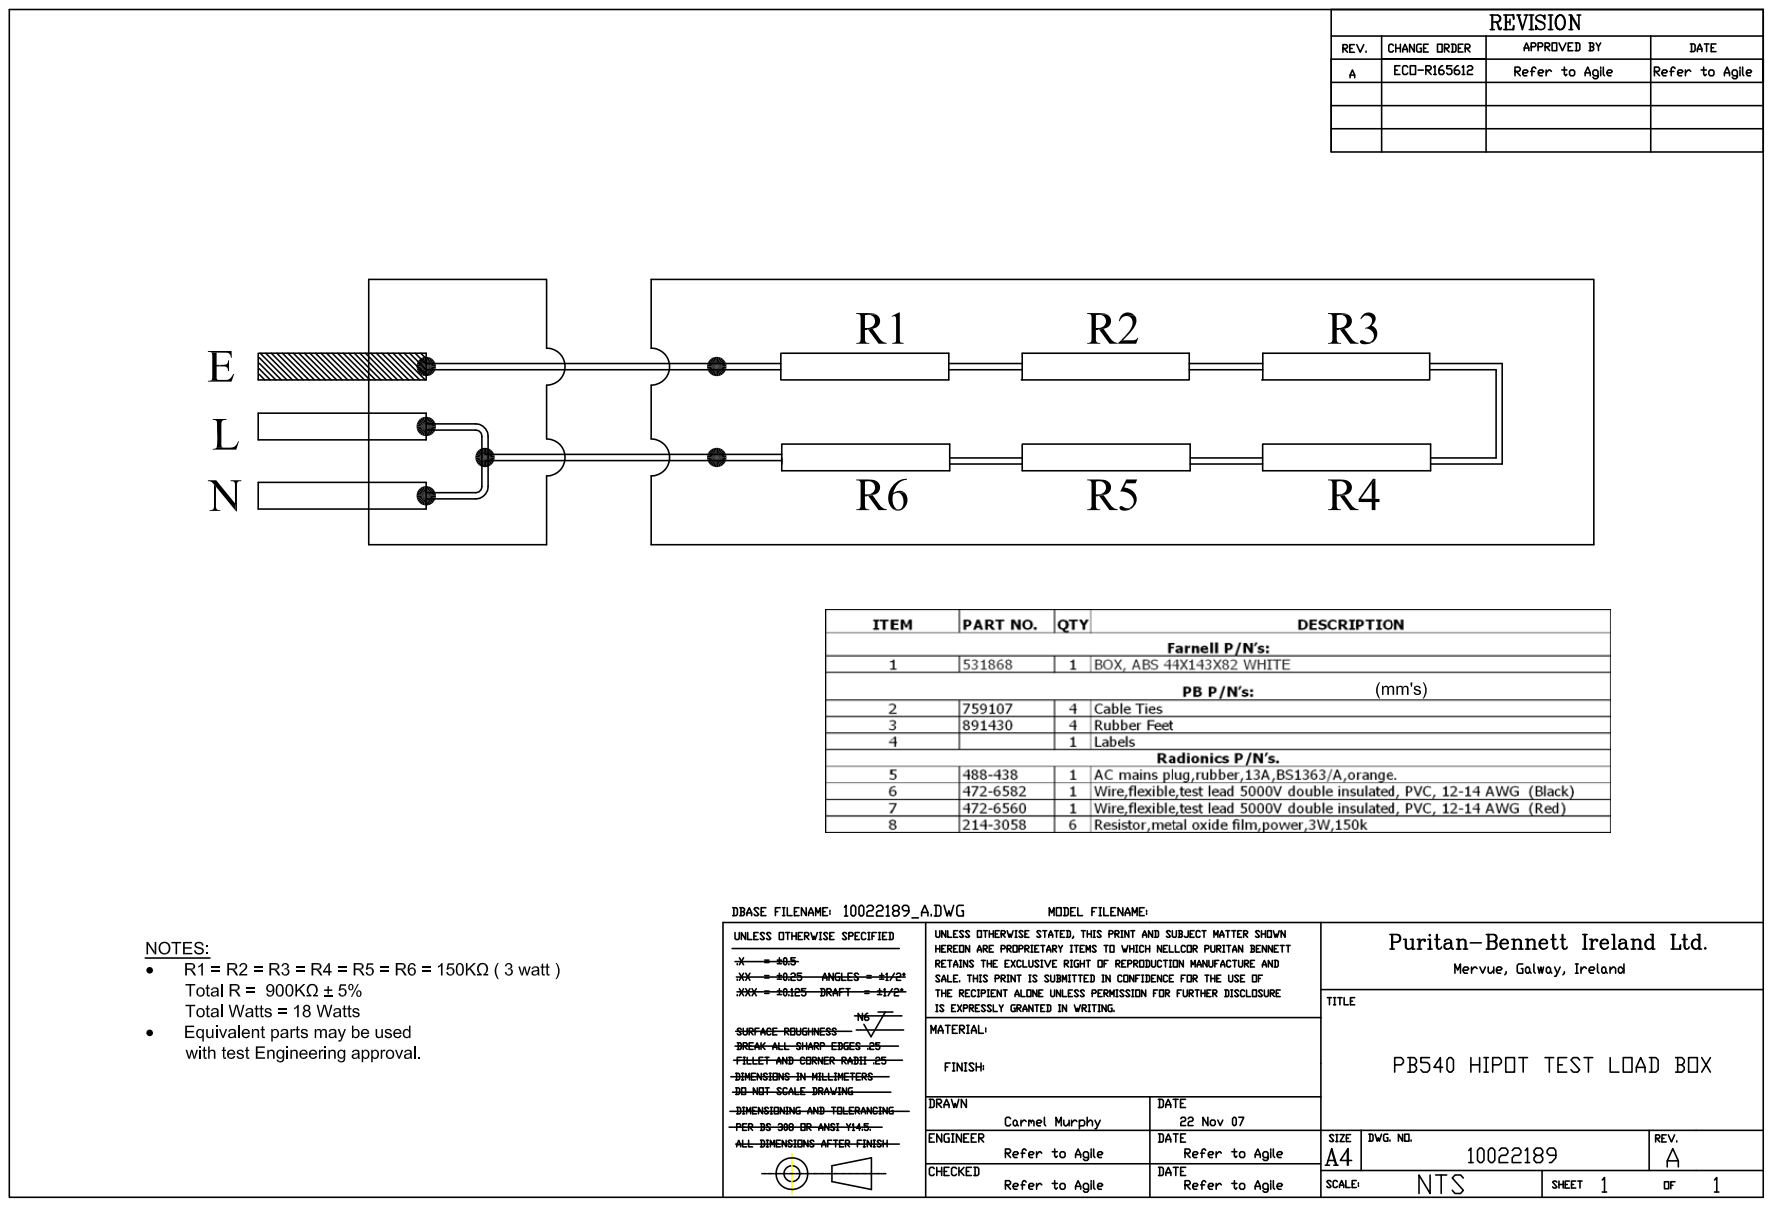
[picture p66: page 1]
