FlyingRat/Medtronic-PB560/Manufacturing Fixtures/10022190B00.pdf

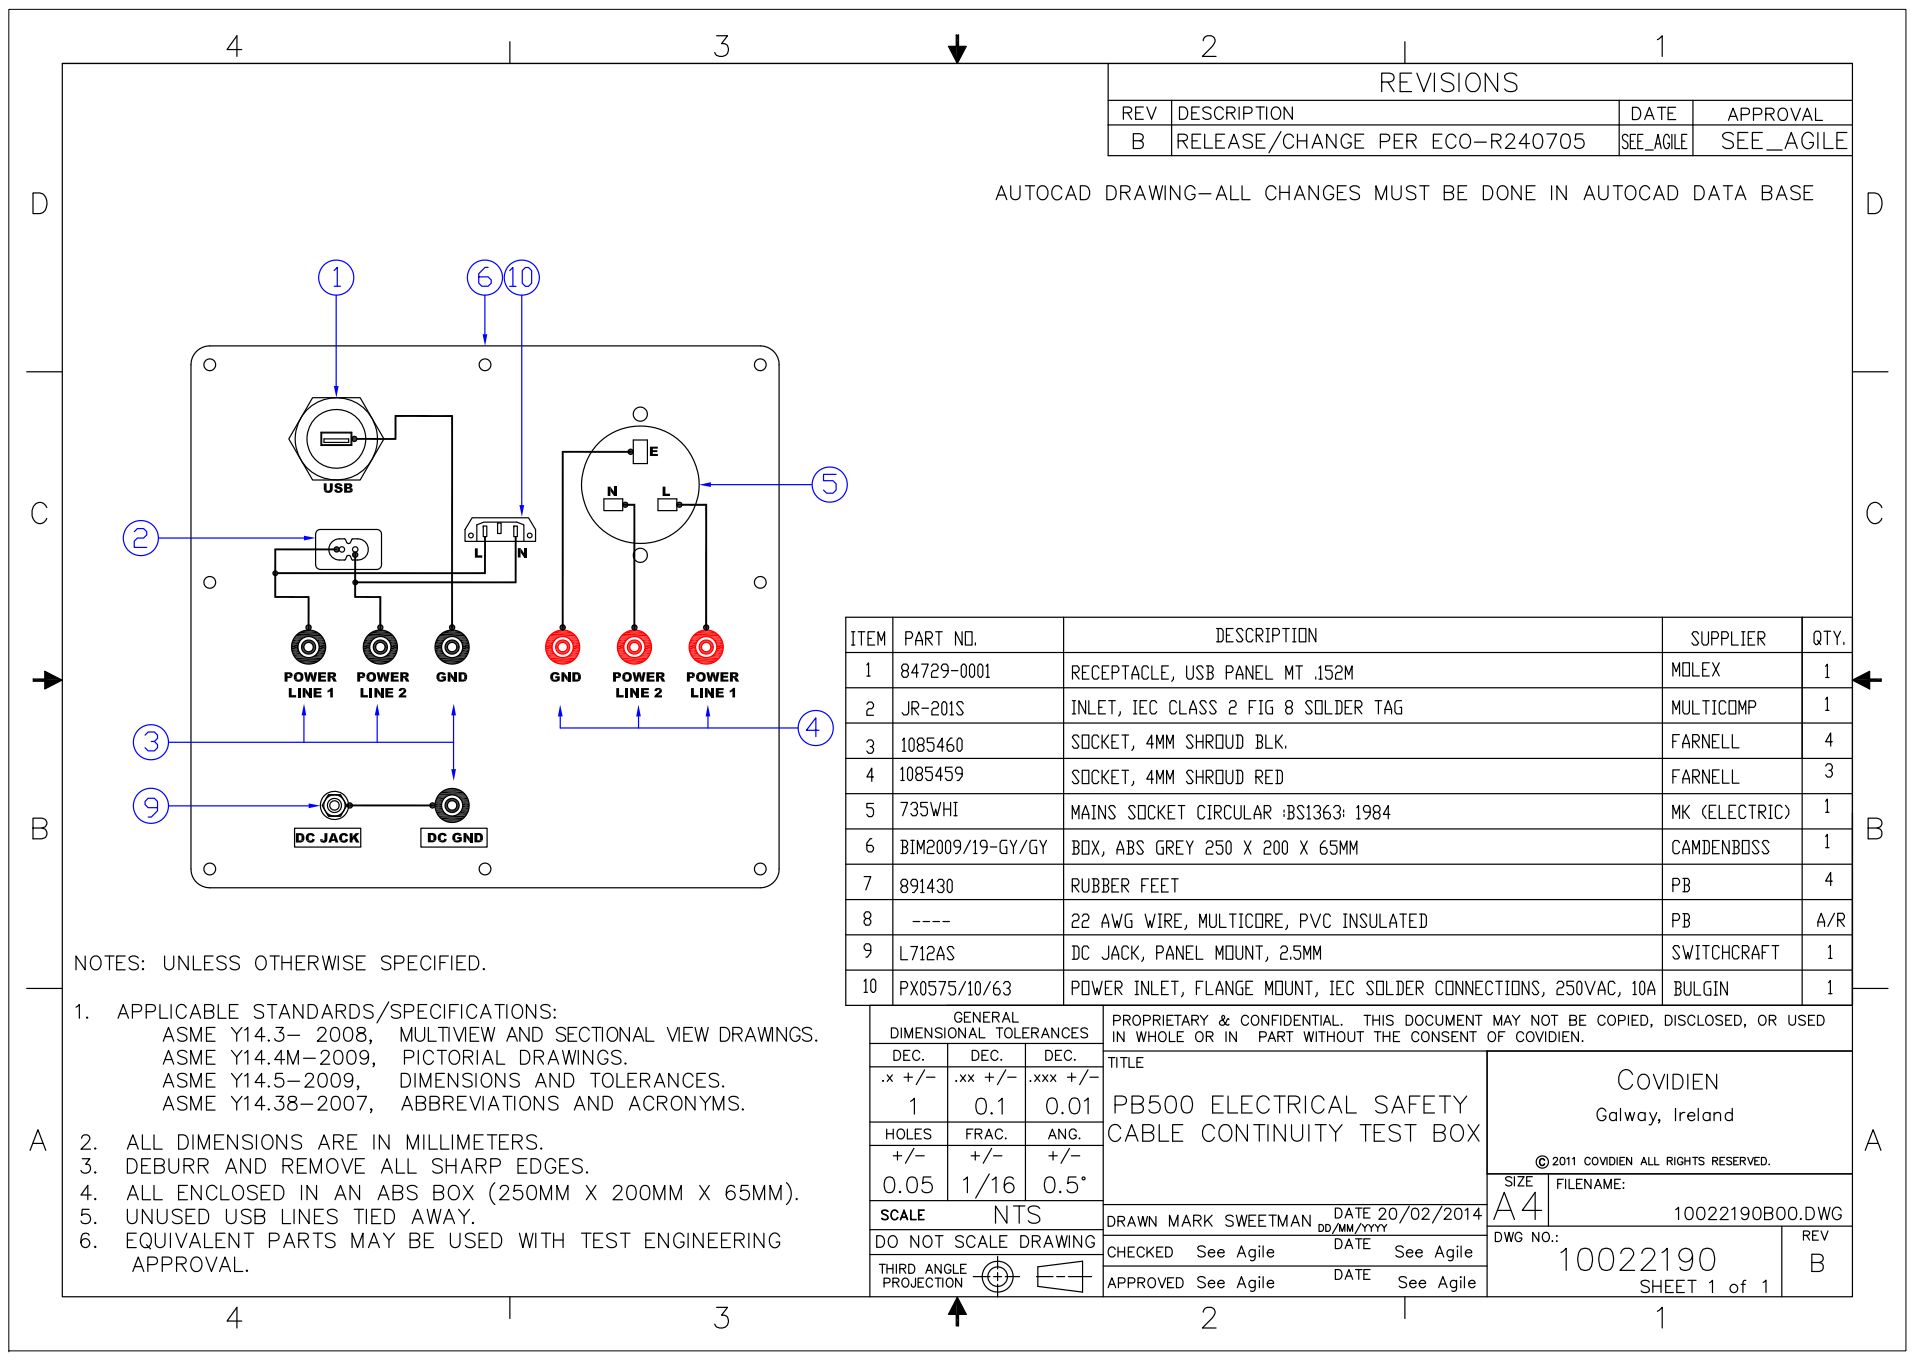
[picture p67: page 1]
