FlyingRat/Medtronic-PB560/Manufacturing Fixtures/10025172 A00 PLASTIC TUBE CUTTER 6.4MM.pdf

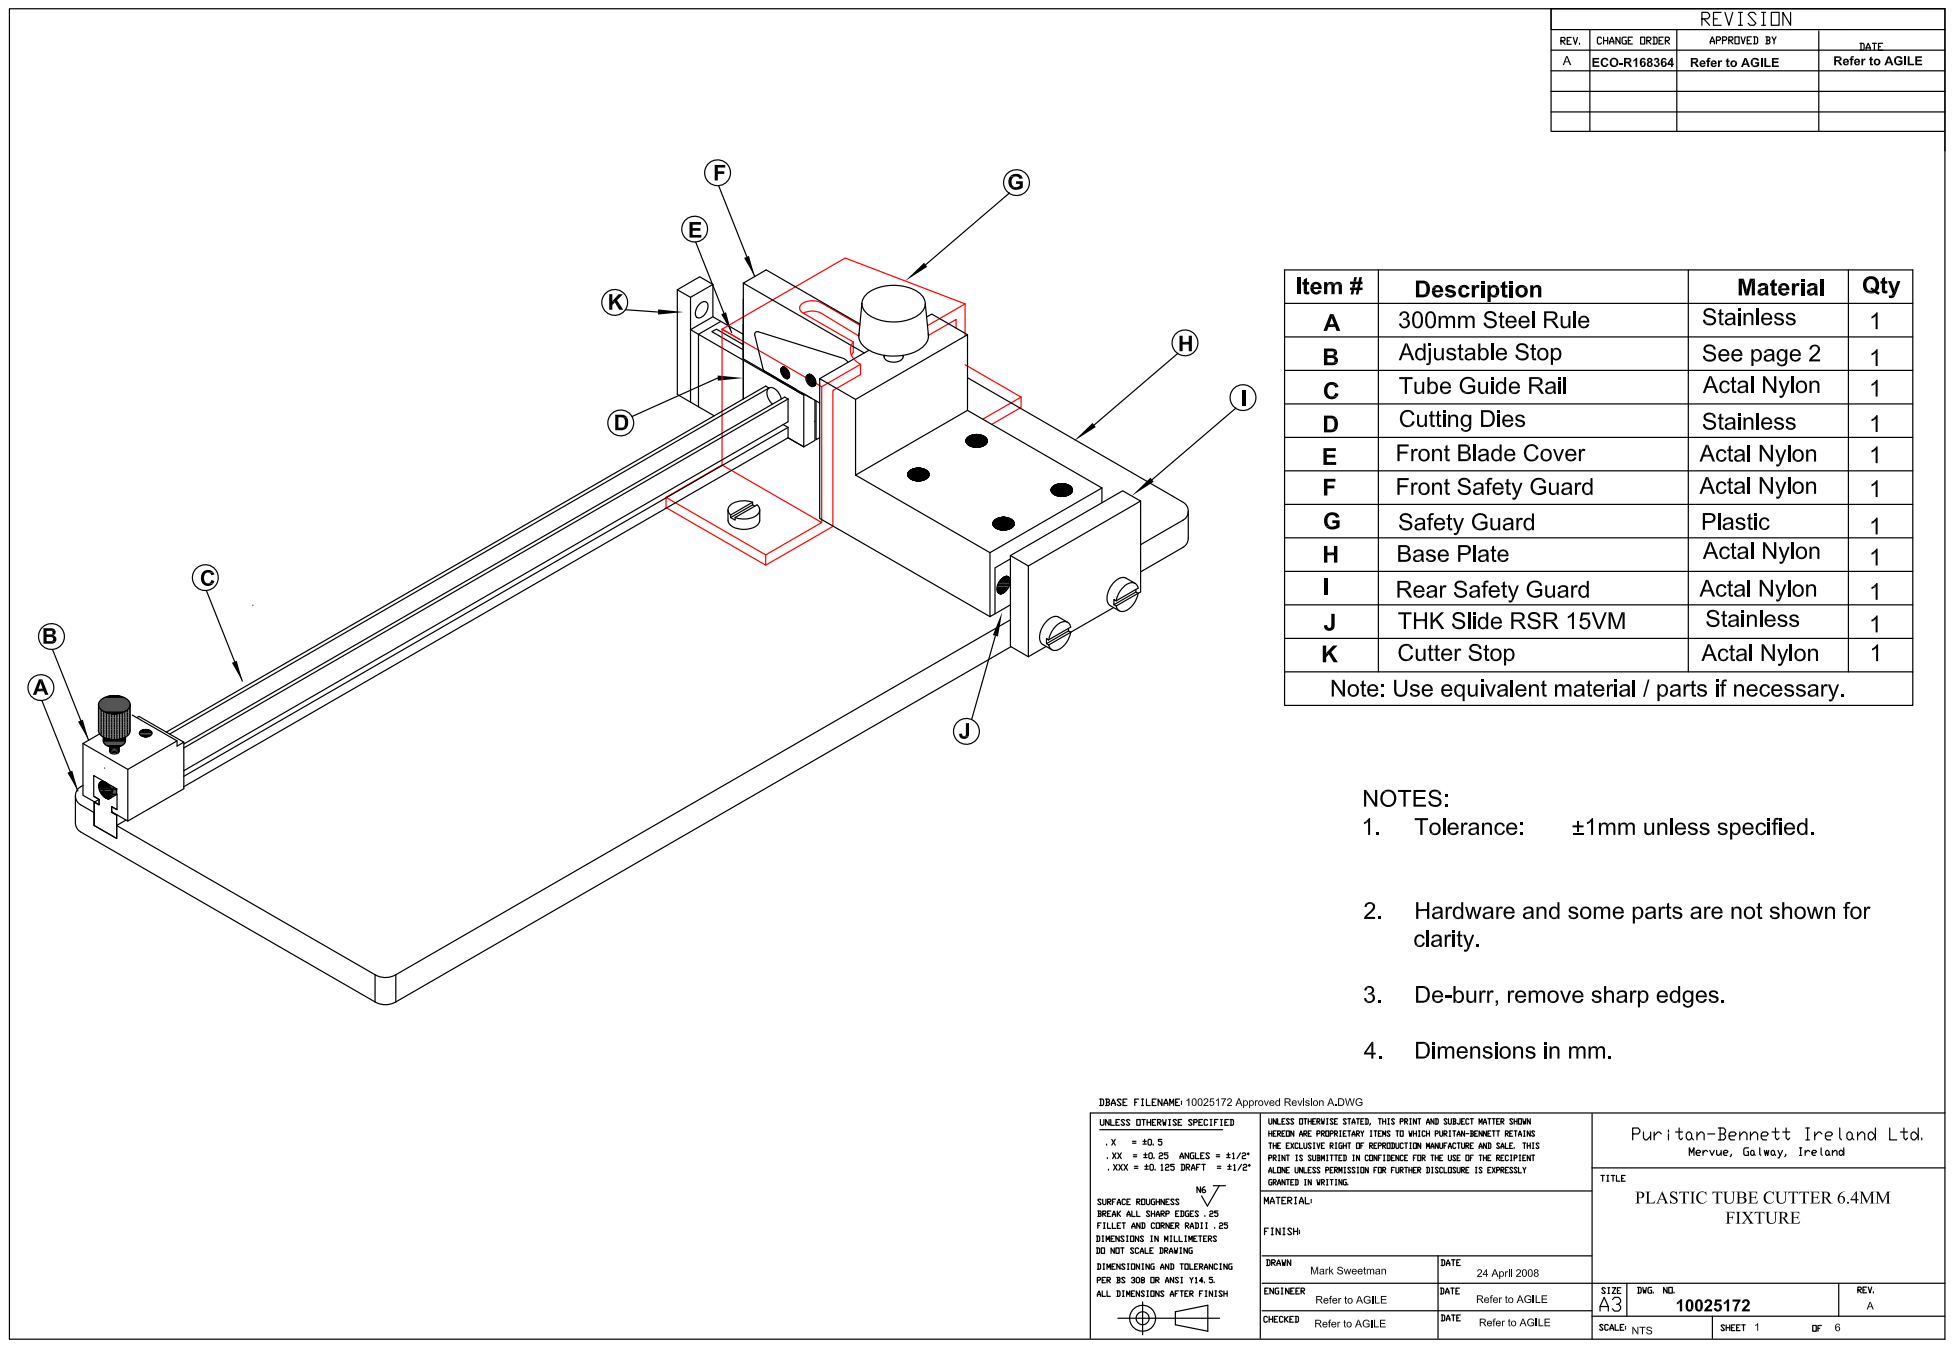
[picture p68: page 1]

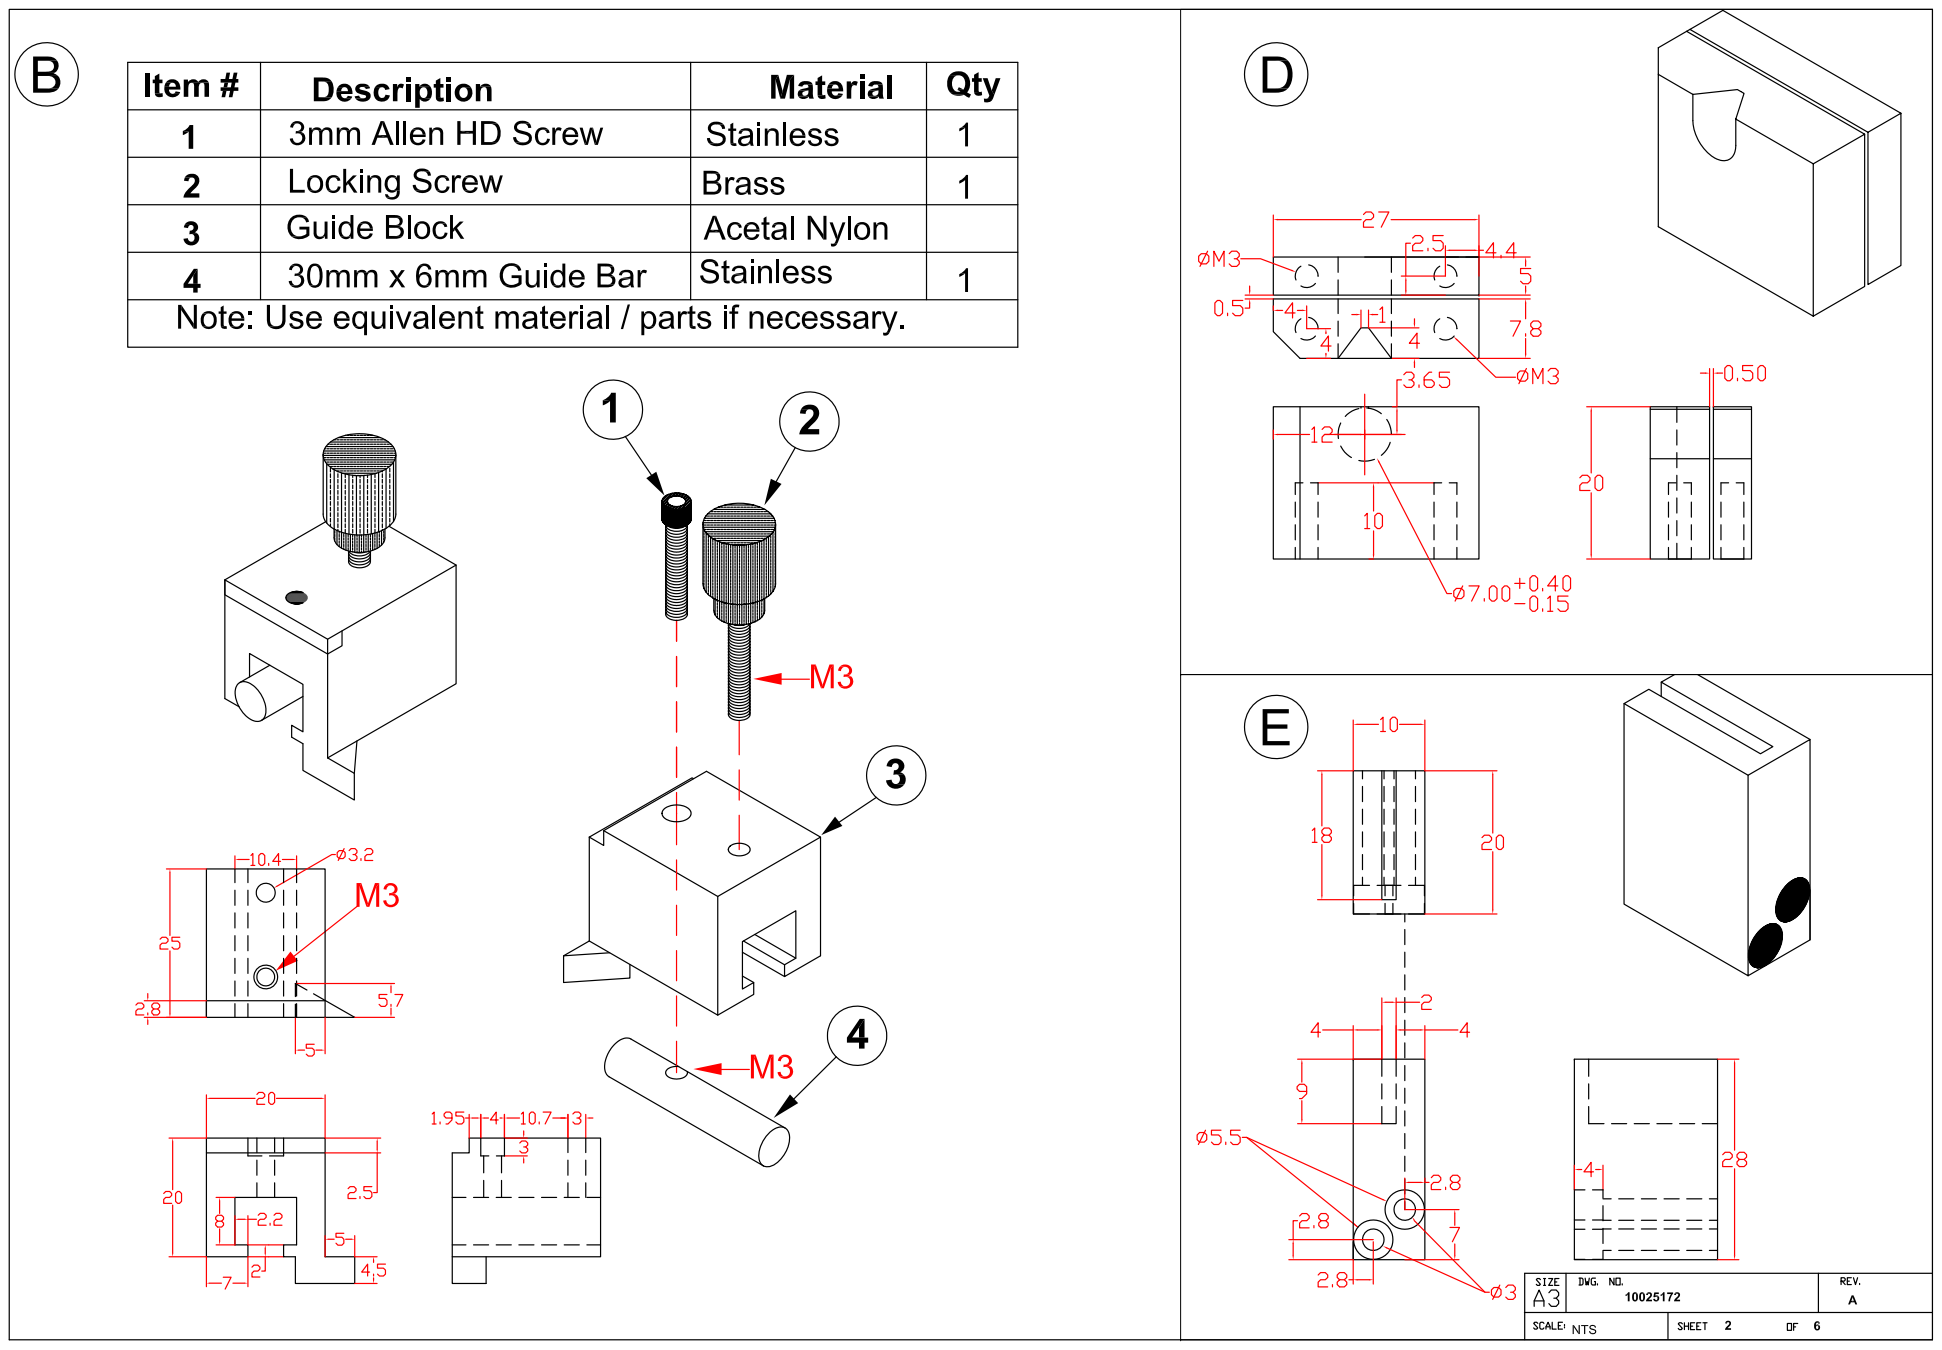
[picture p69: page 2]

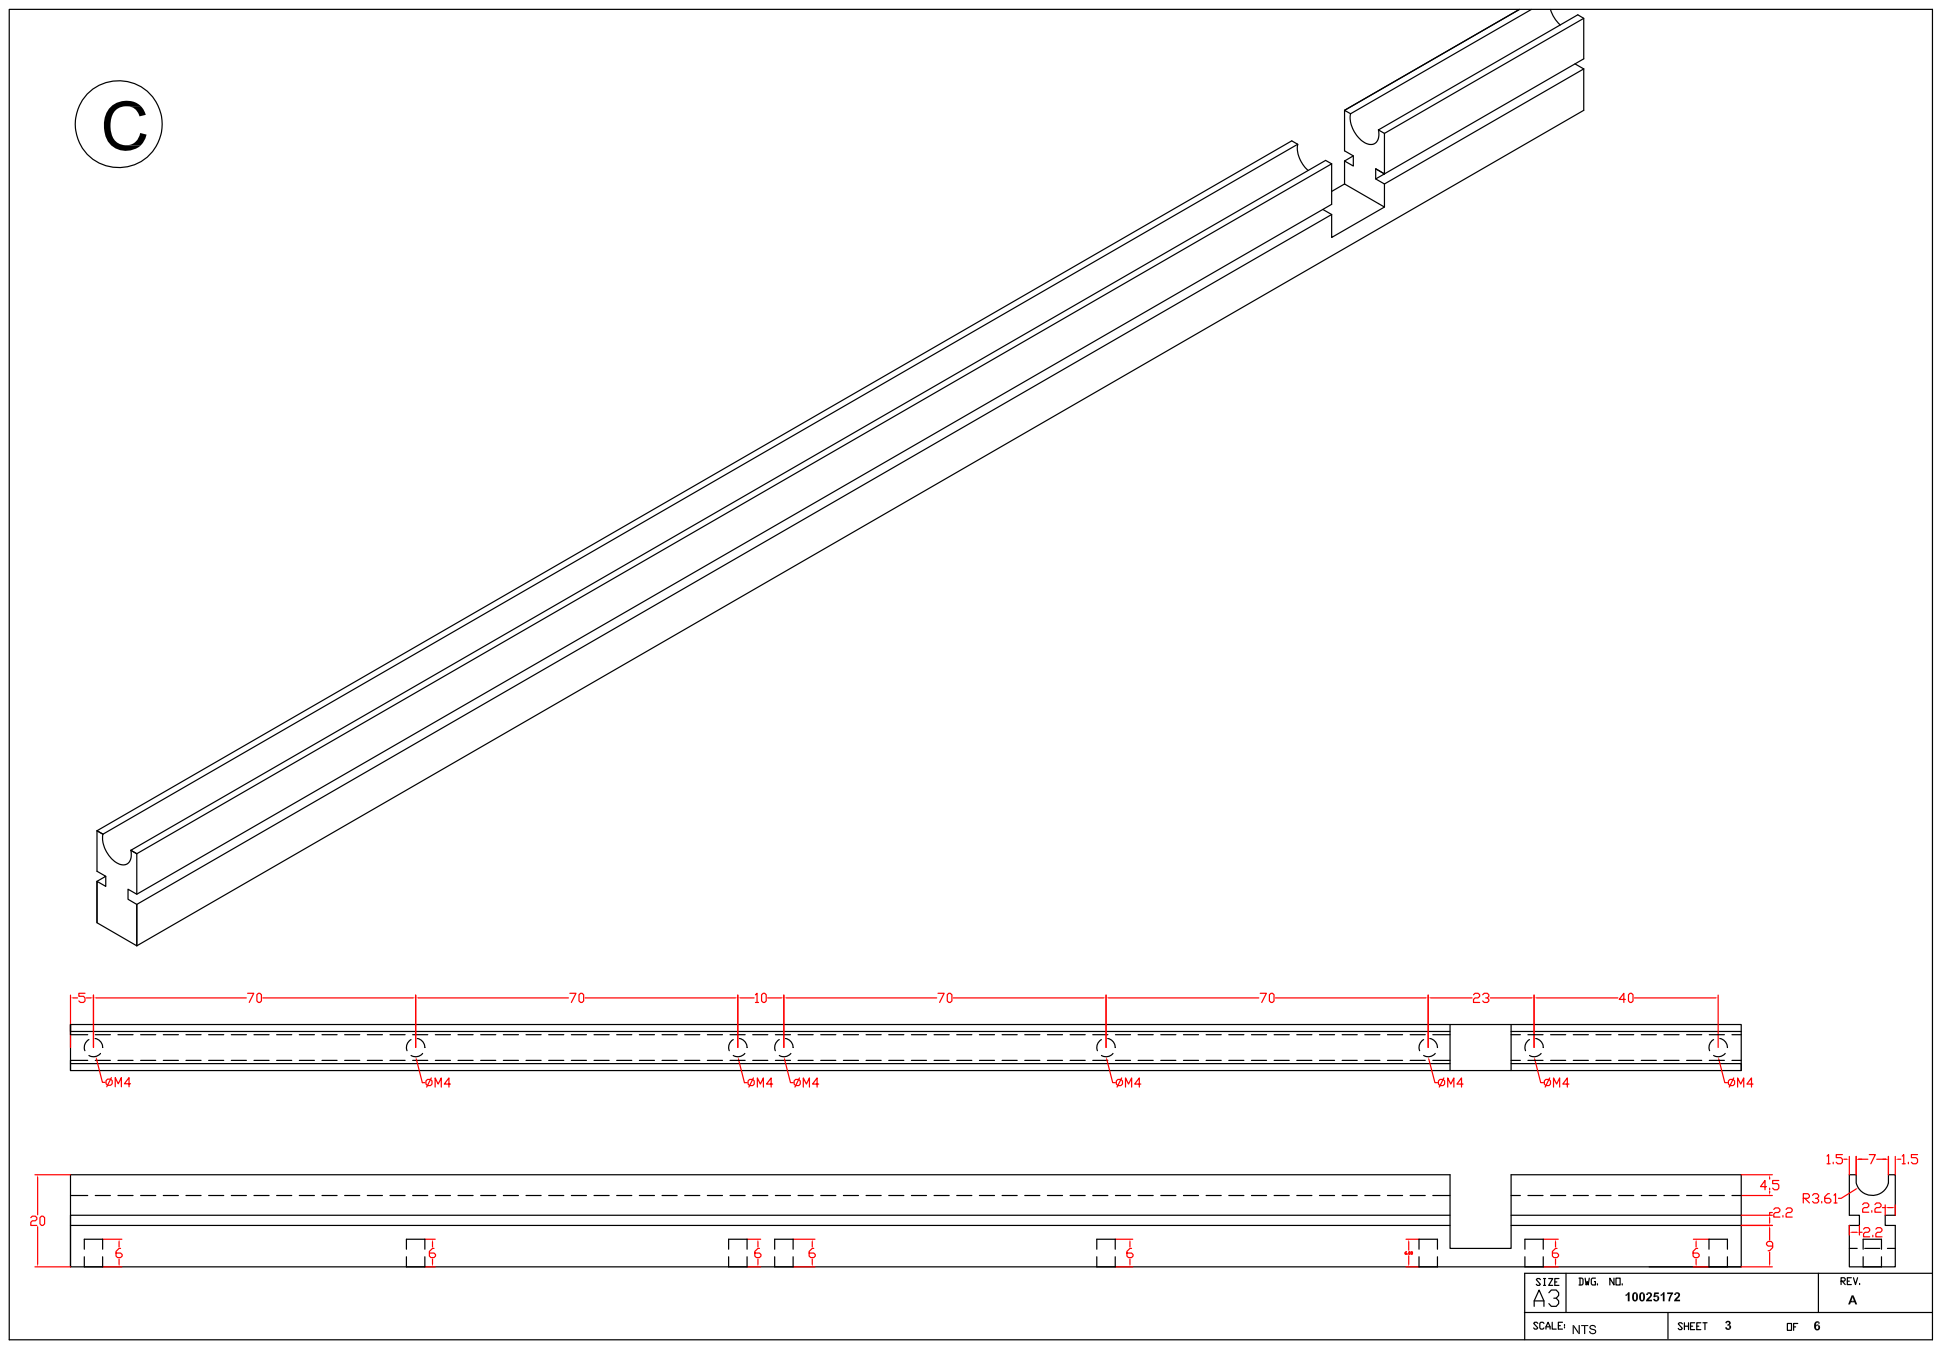
[picture p70: page 3]

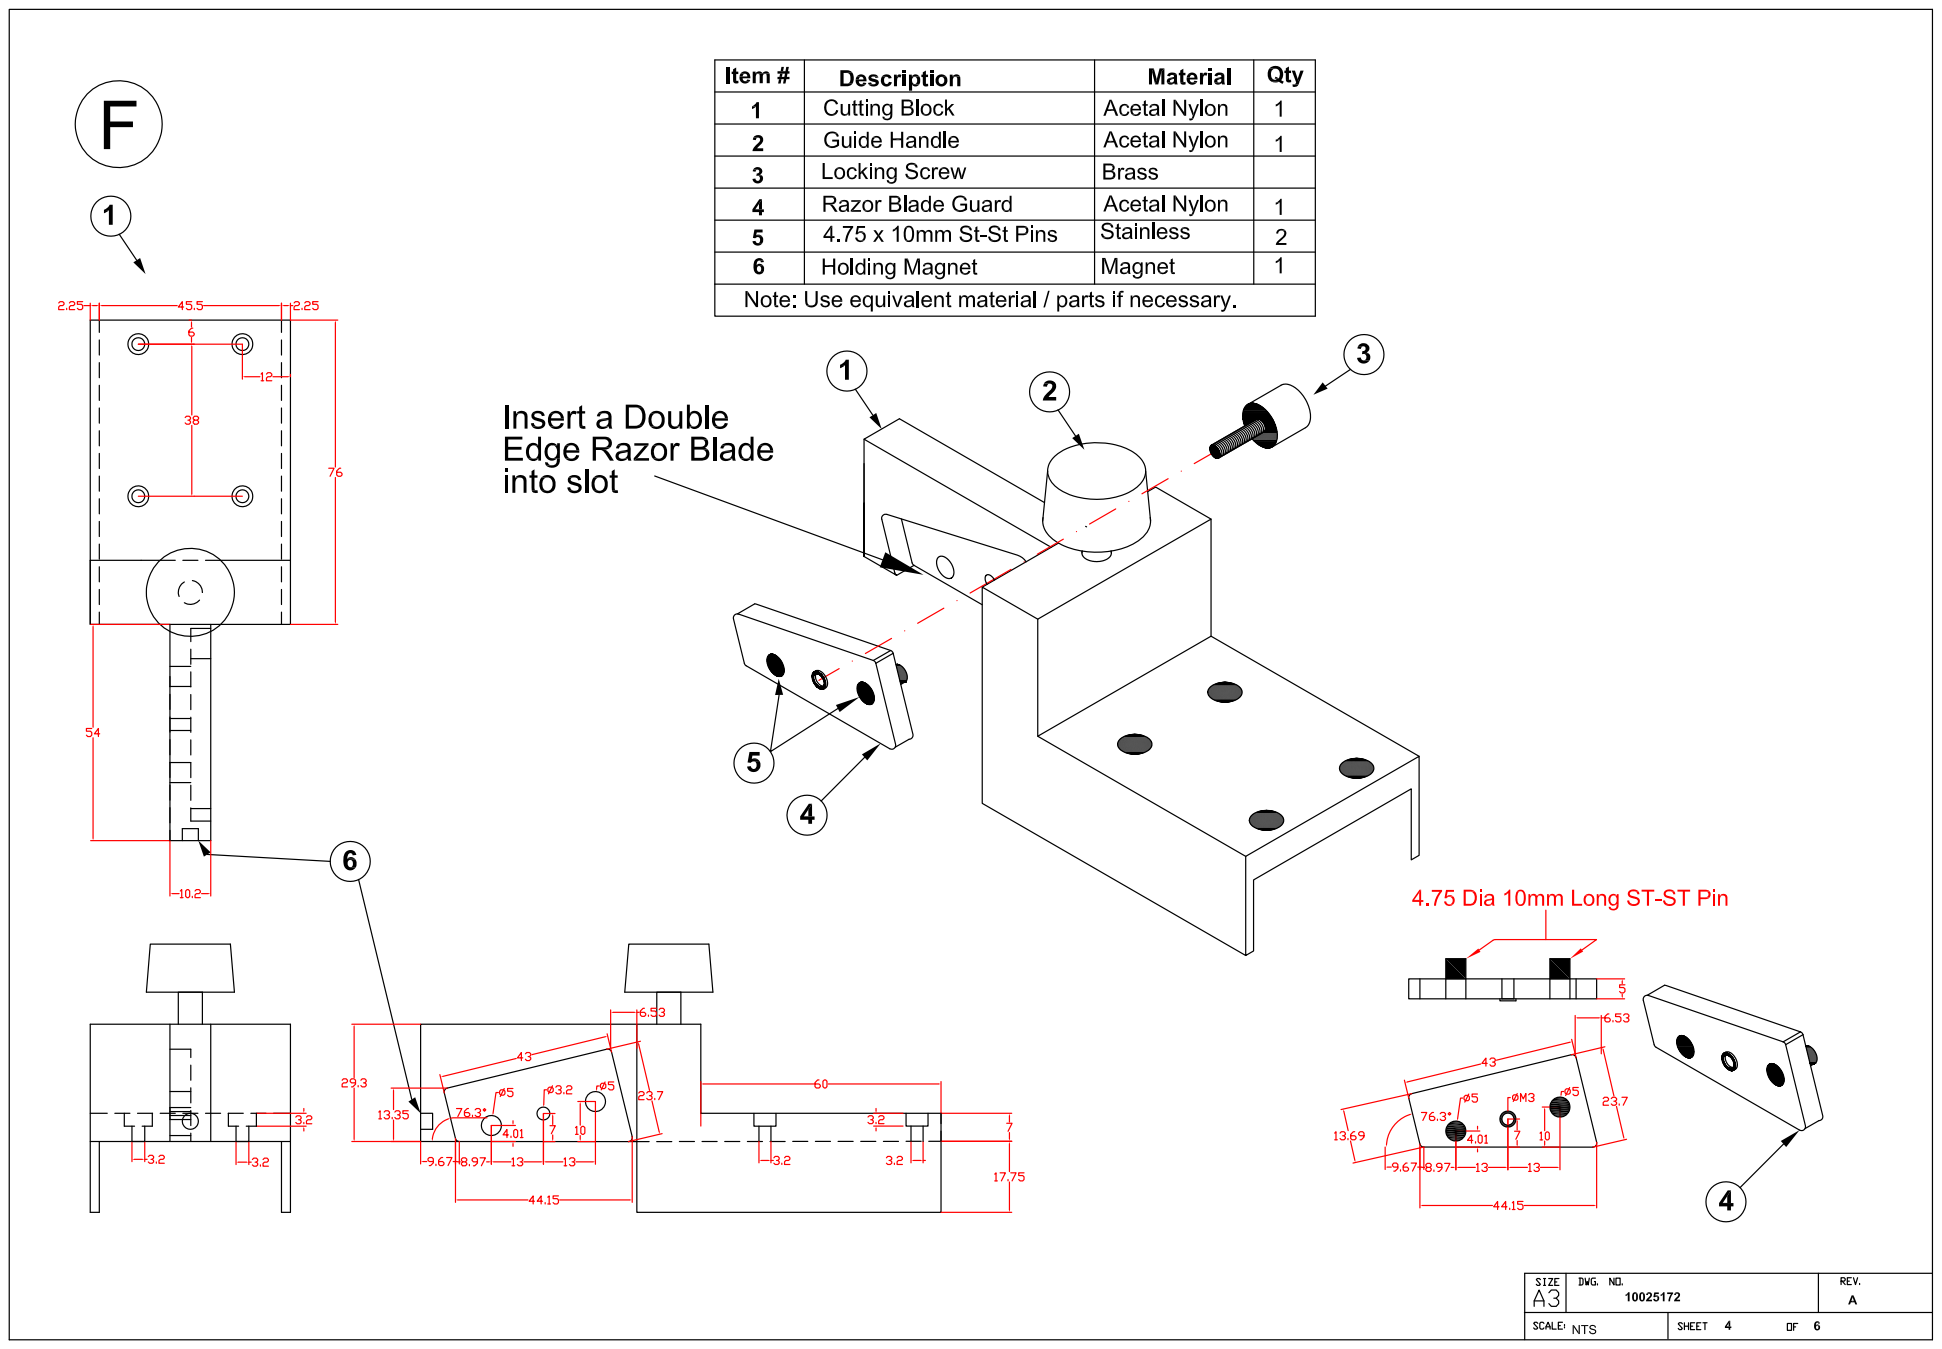
[picture p71: page 4]

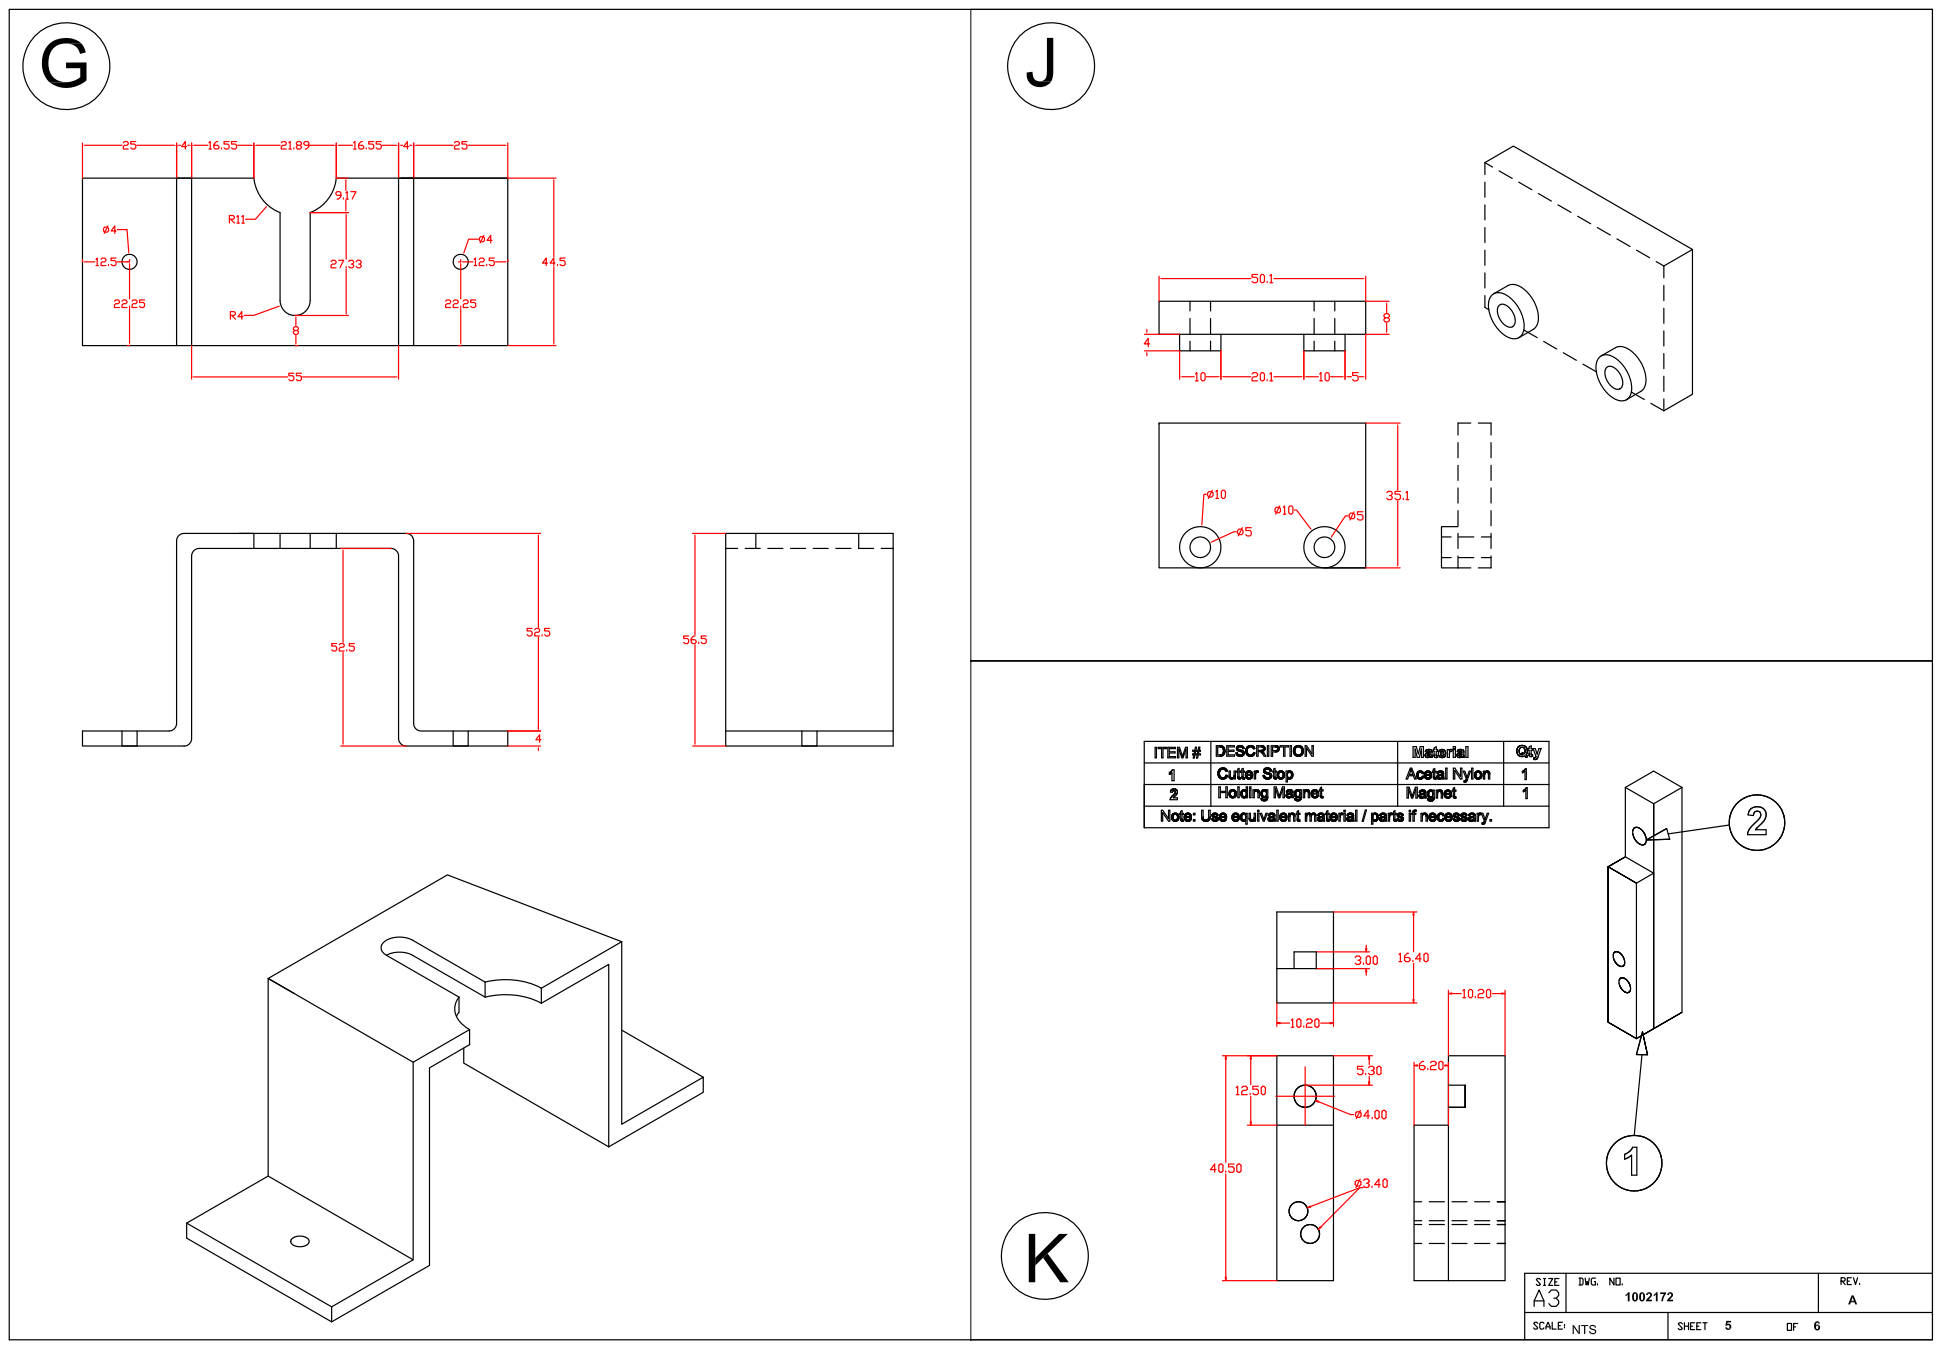
[picture p72: page 5]

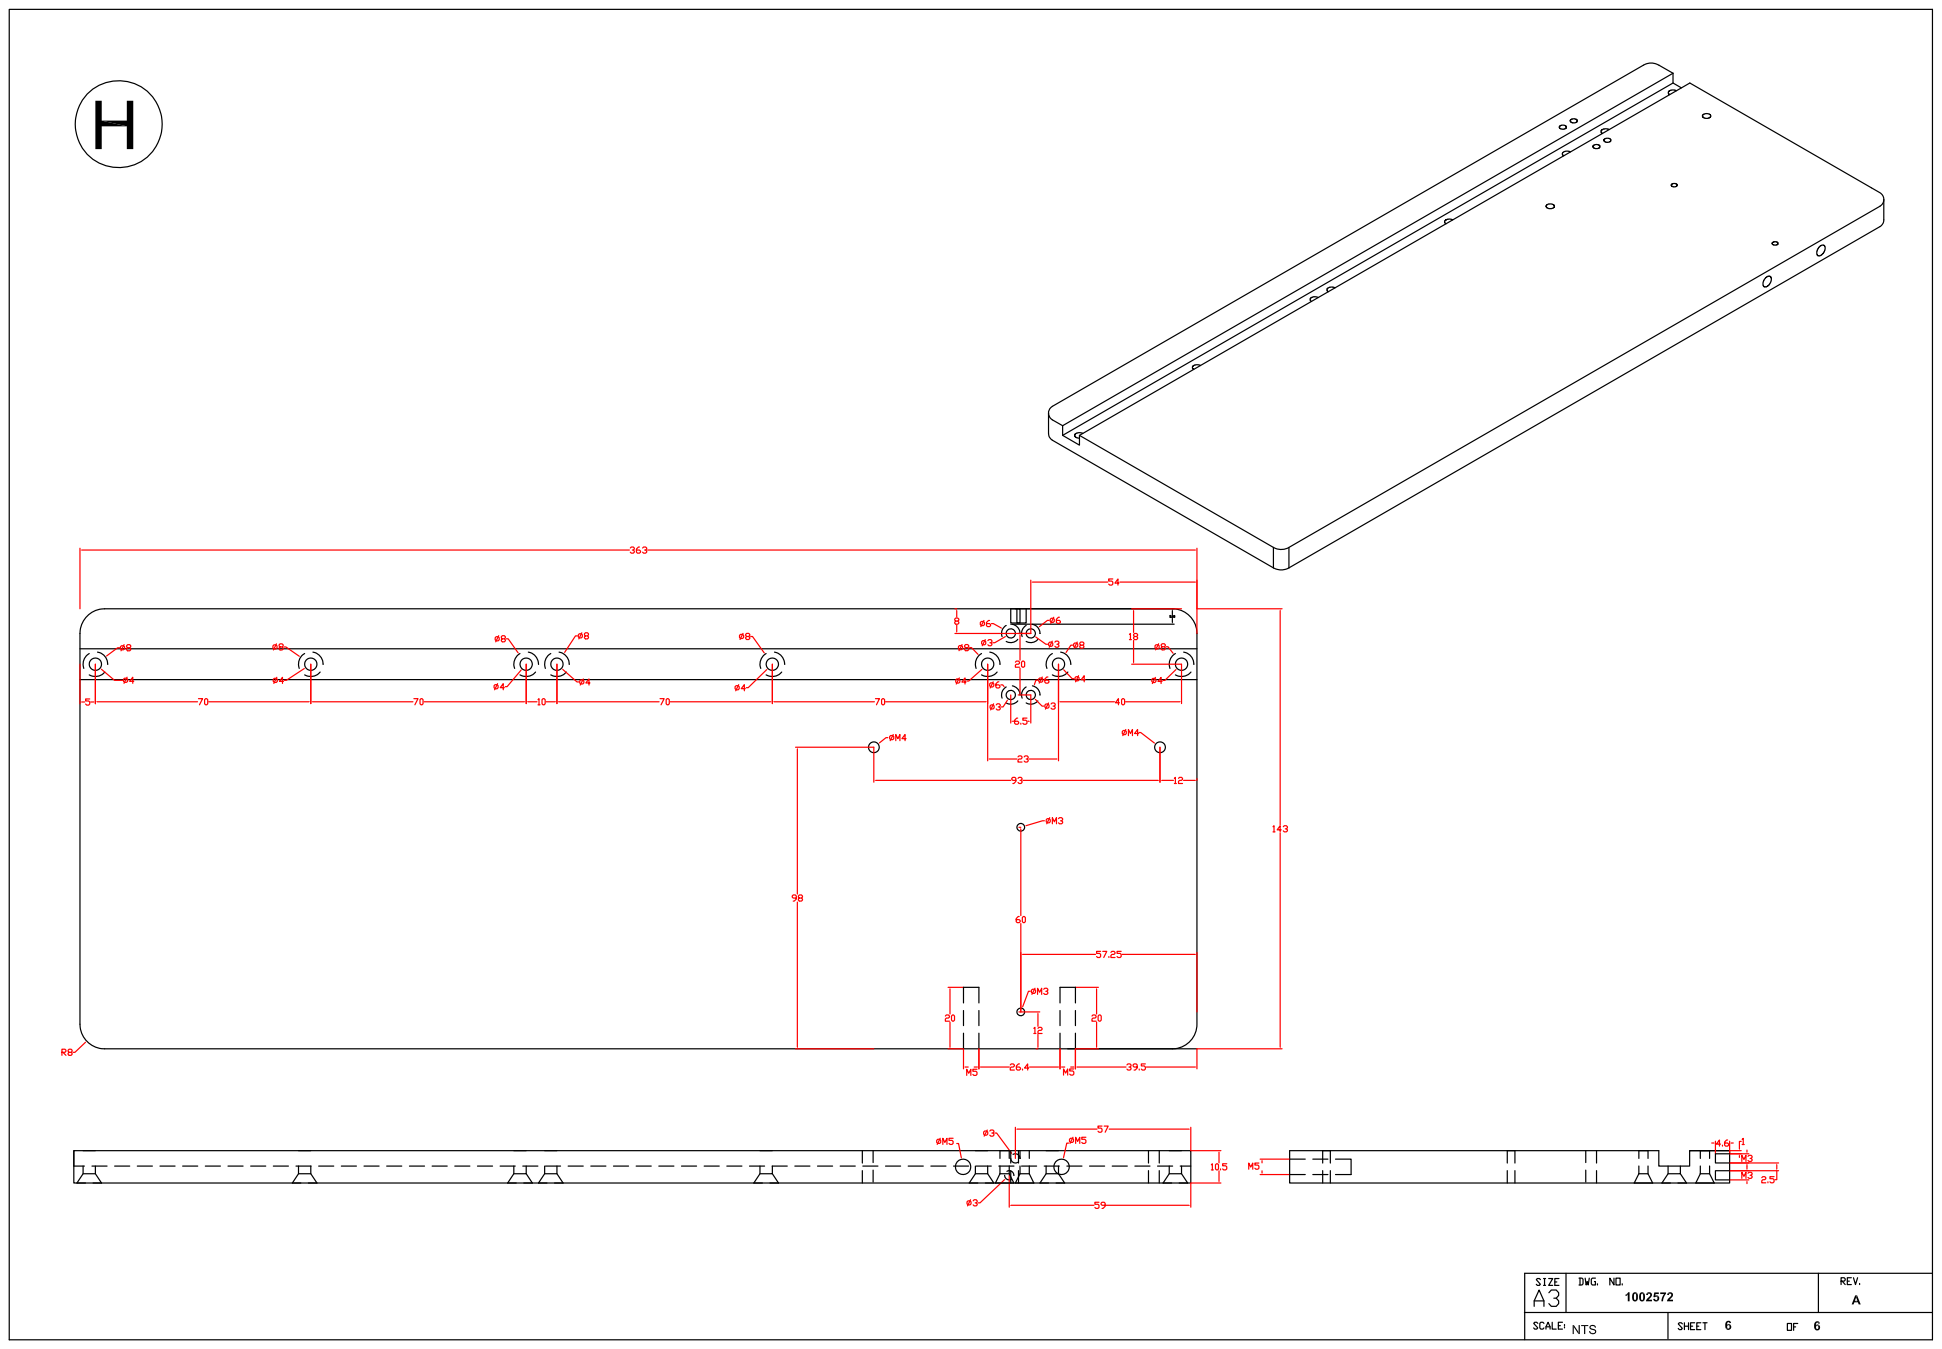
[picture p73: page 6]
