FlyingRat/Medtronic-PB560/Manufacturing Fixtures/10025203A00.pdf

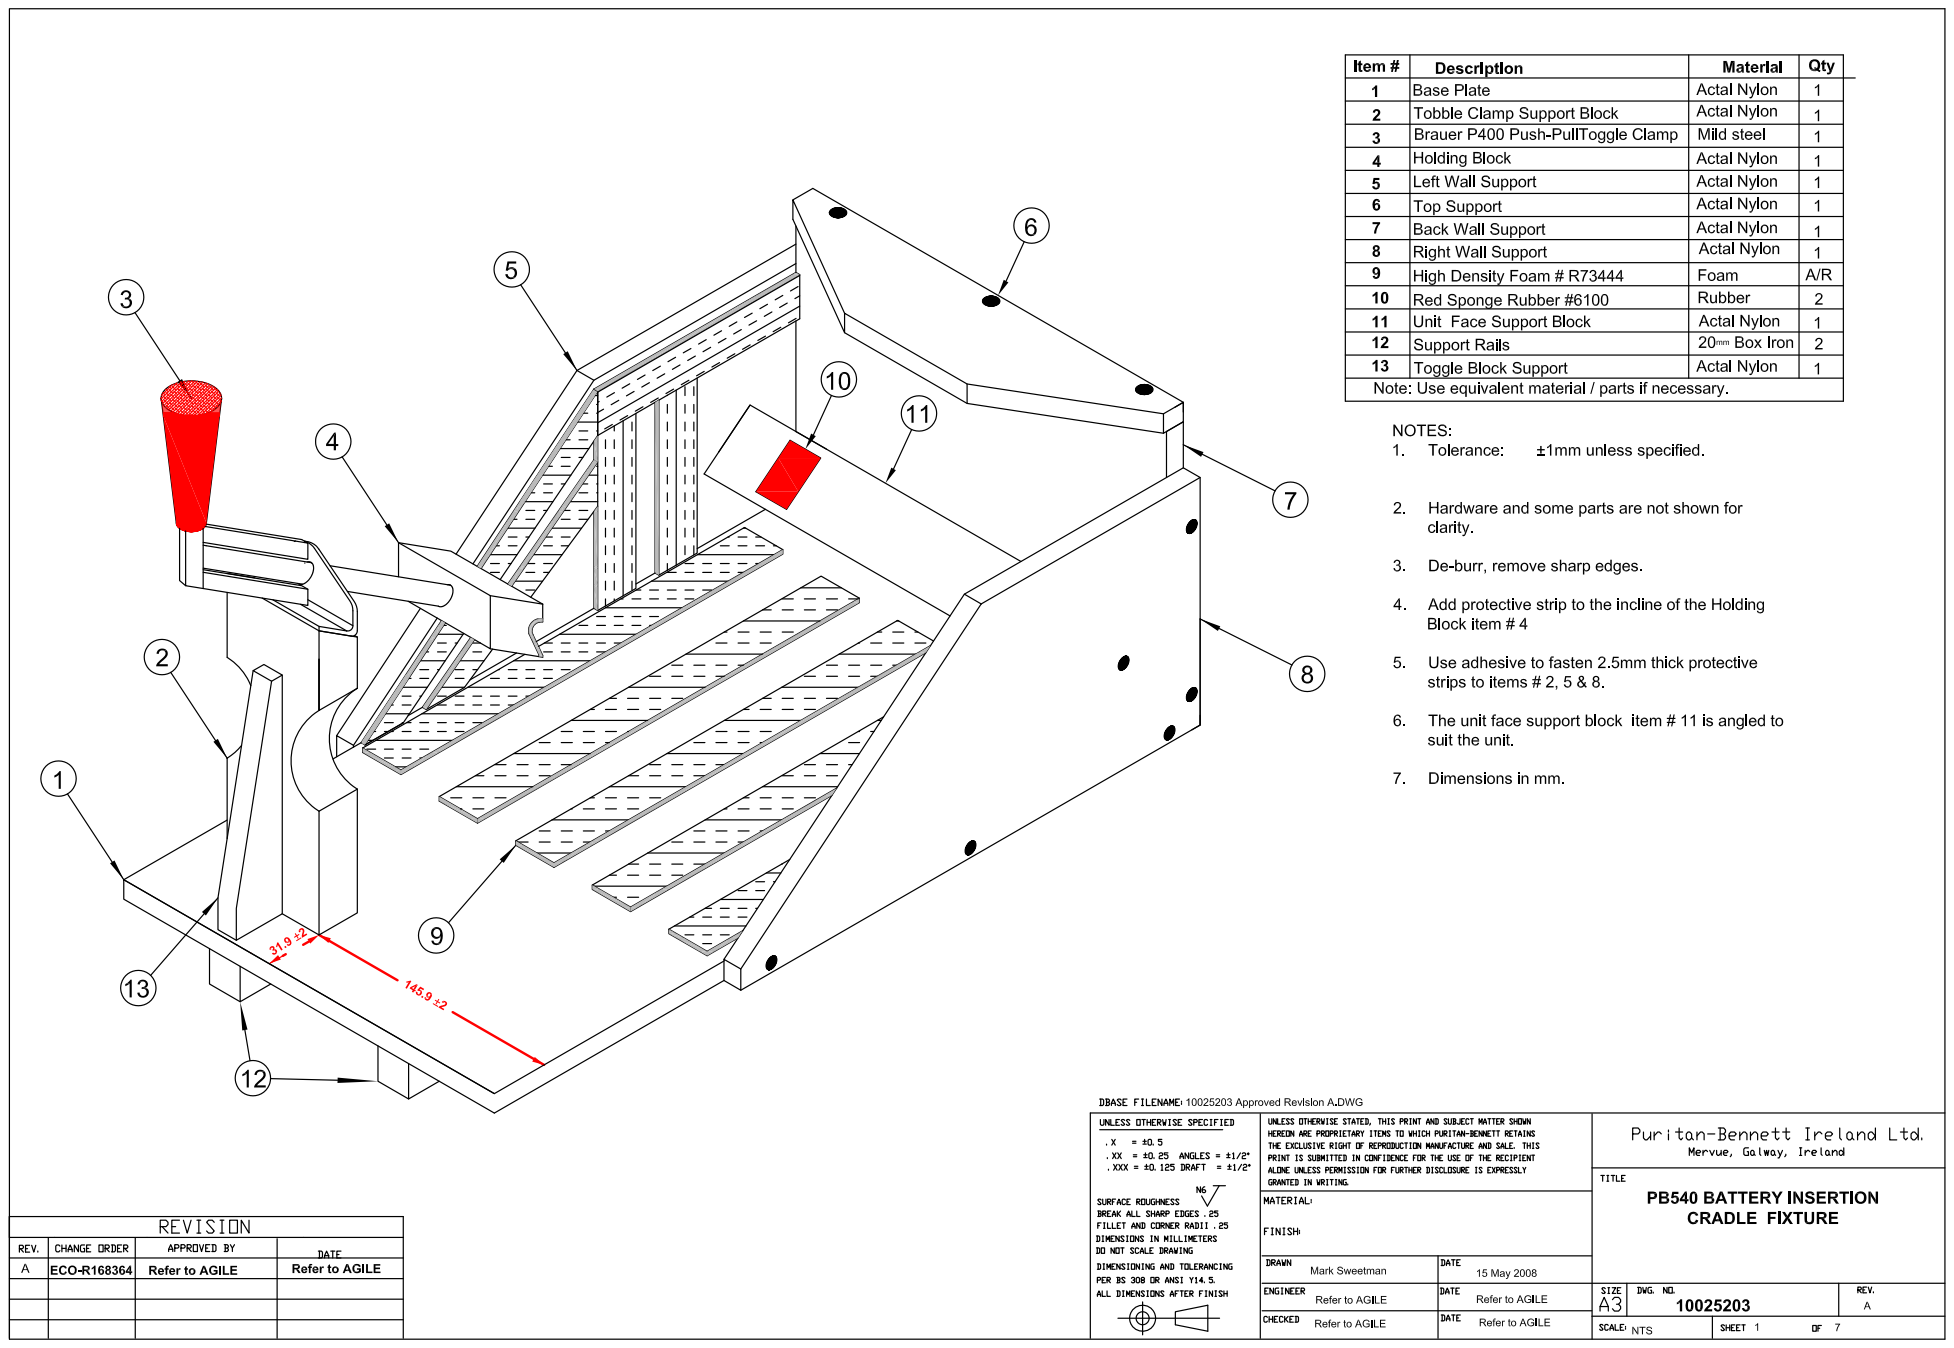
[picture p74: page 1]

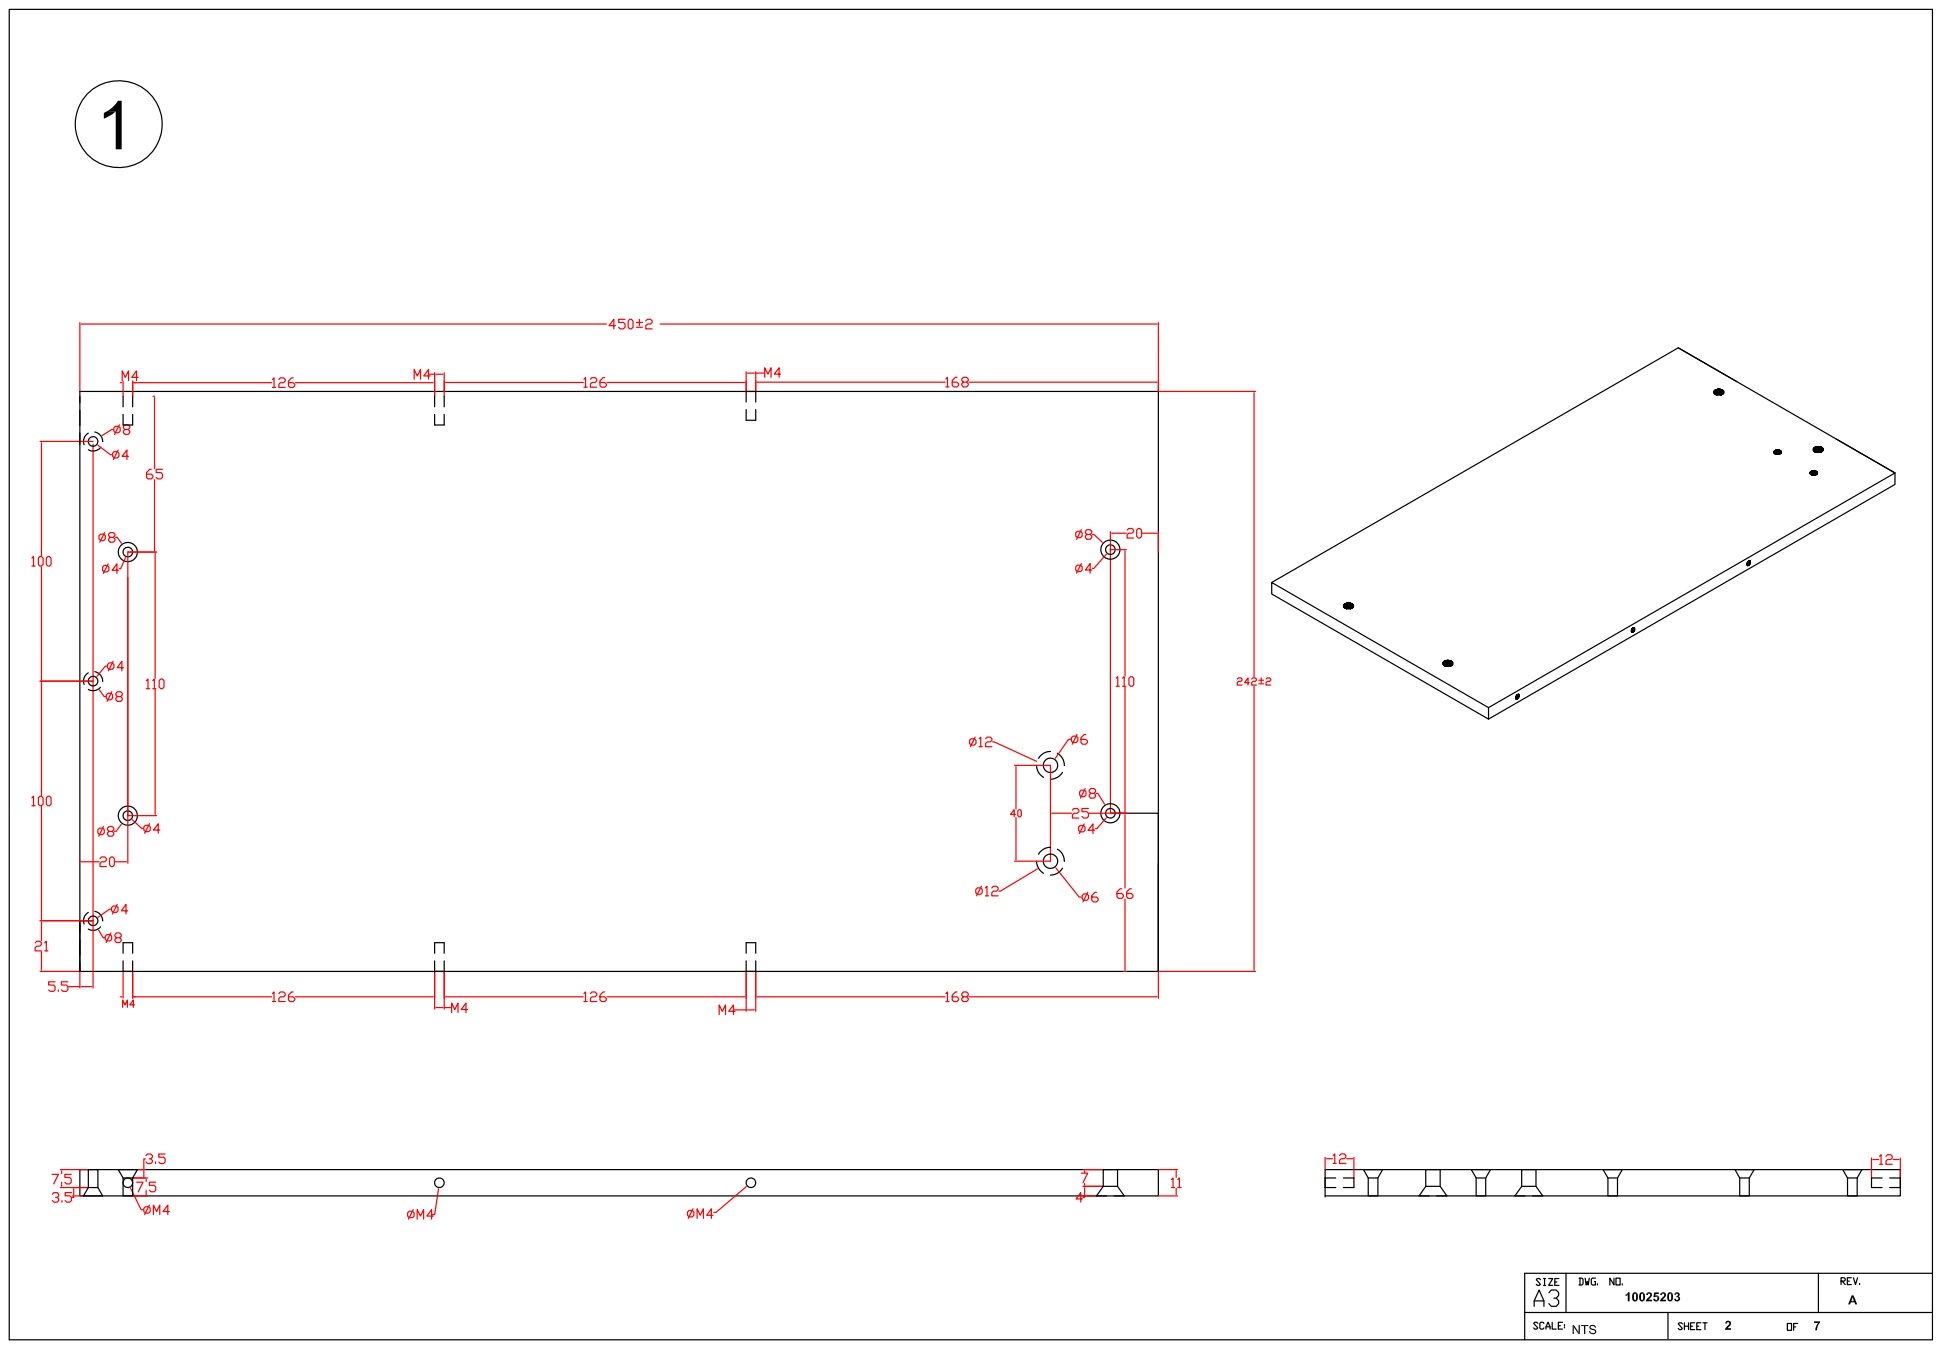
[picture p75: page 2]

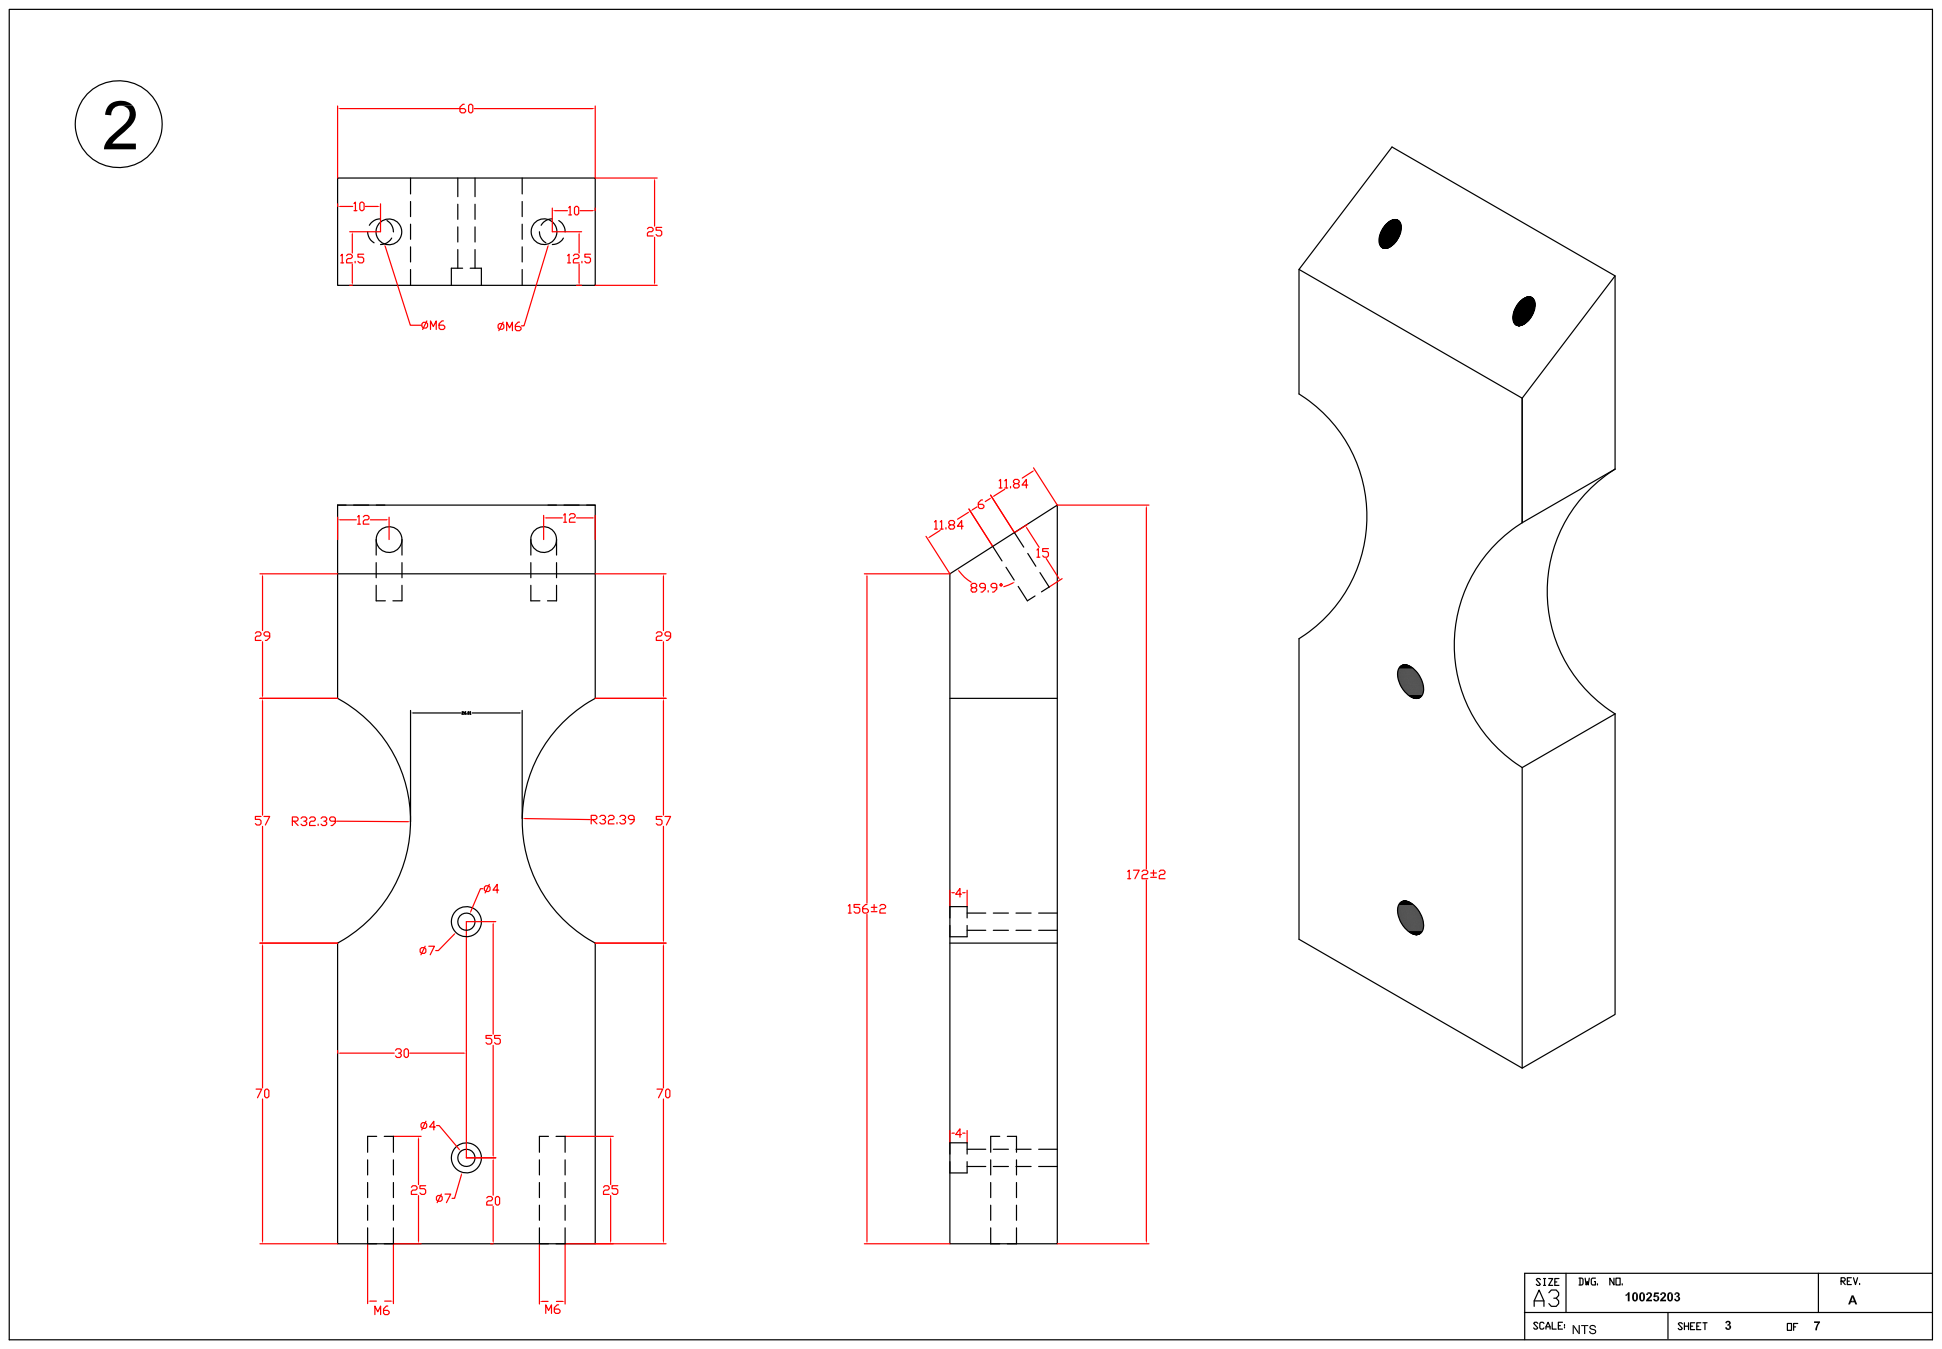
[picture p76: page 3]

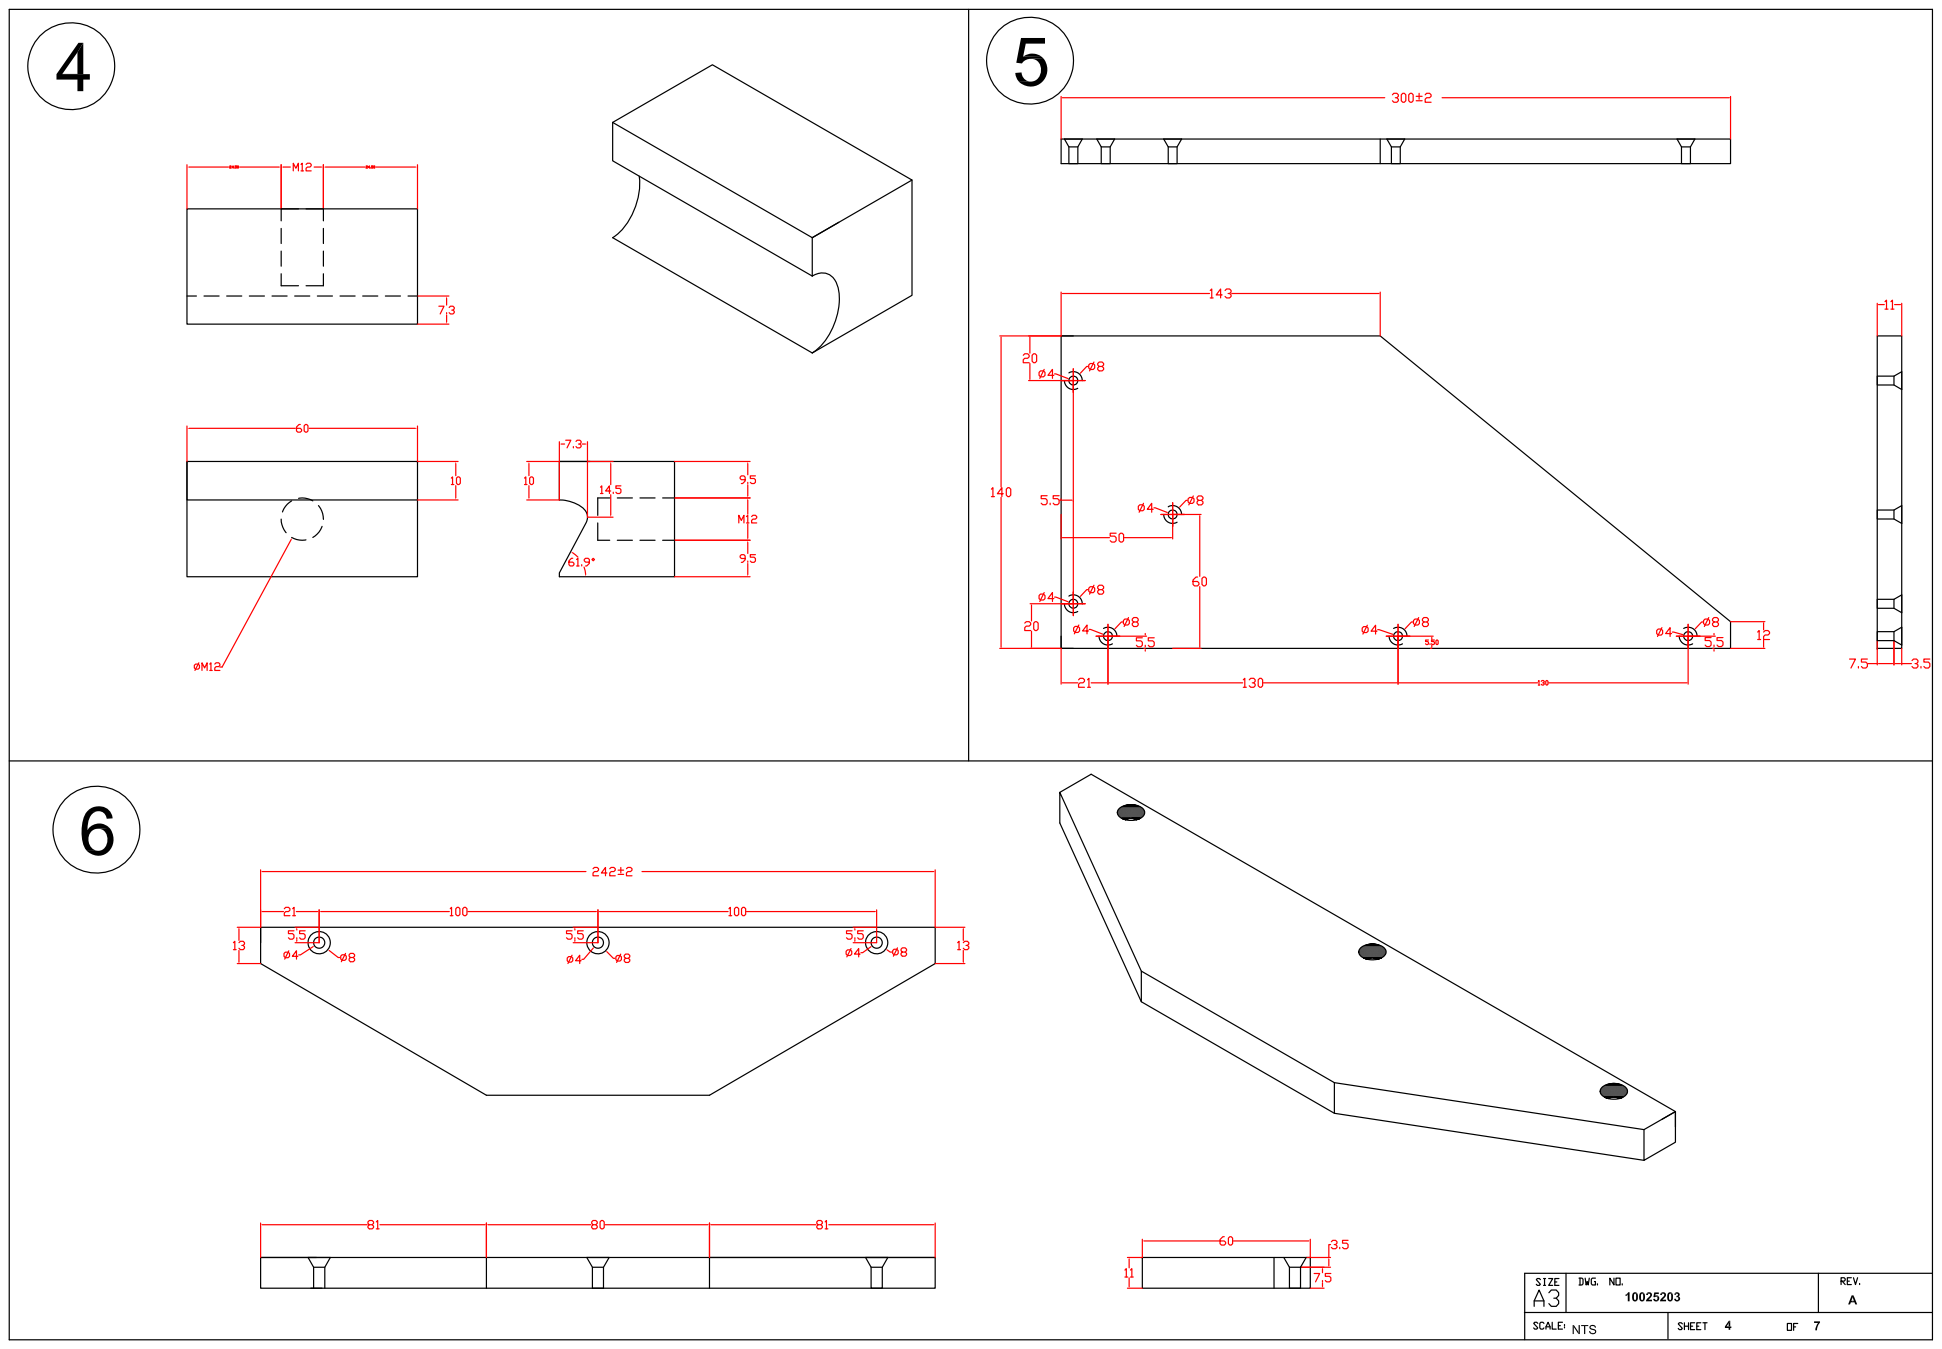
[picture p77: page 4]

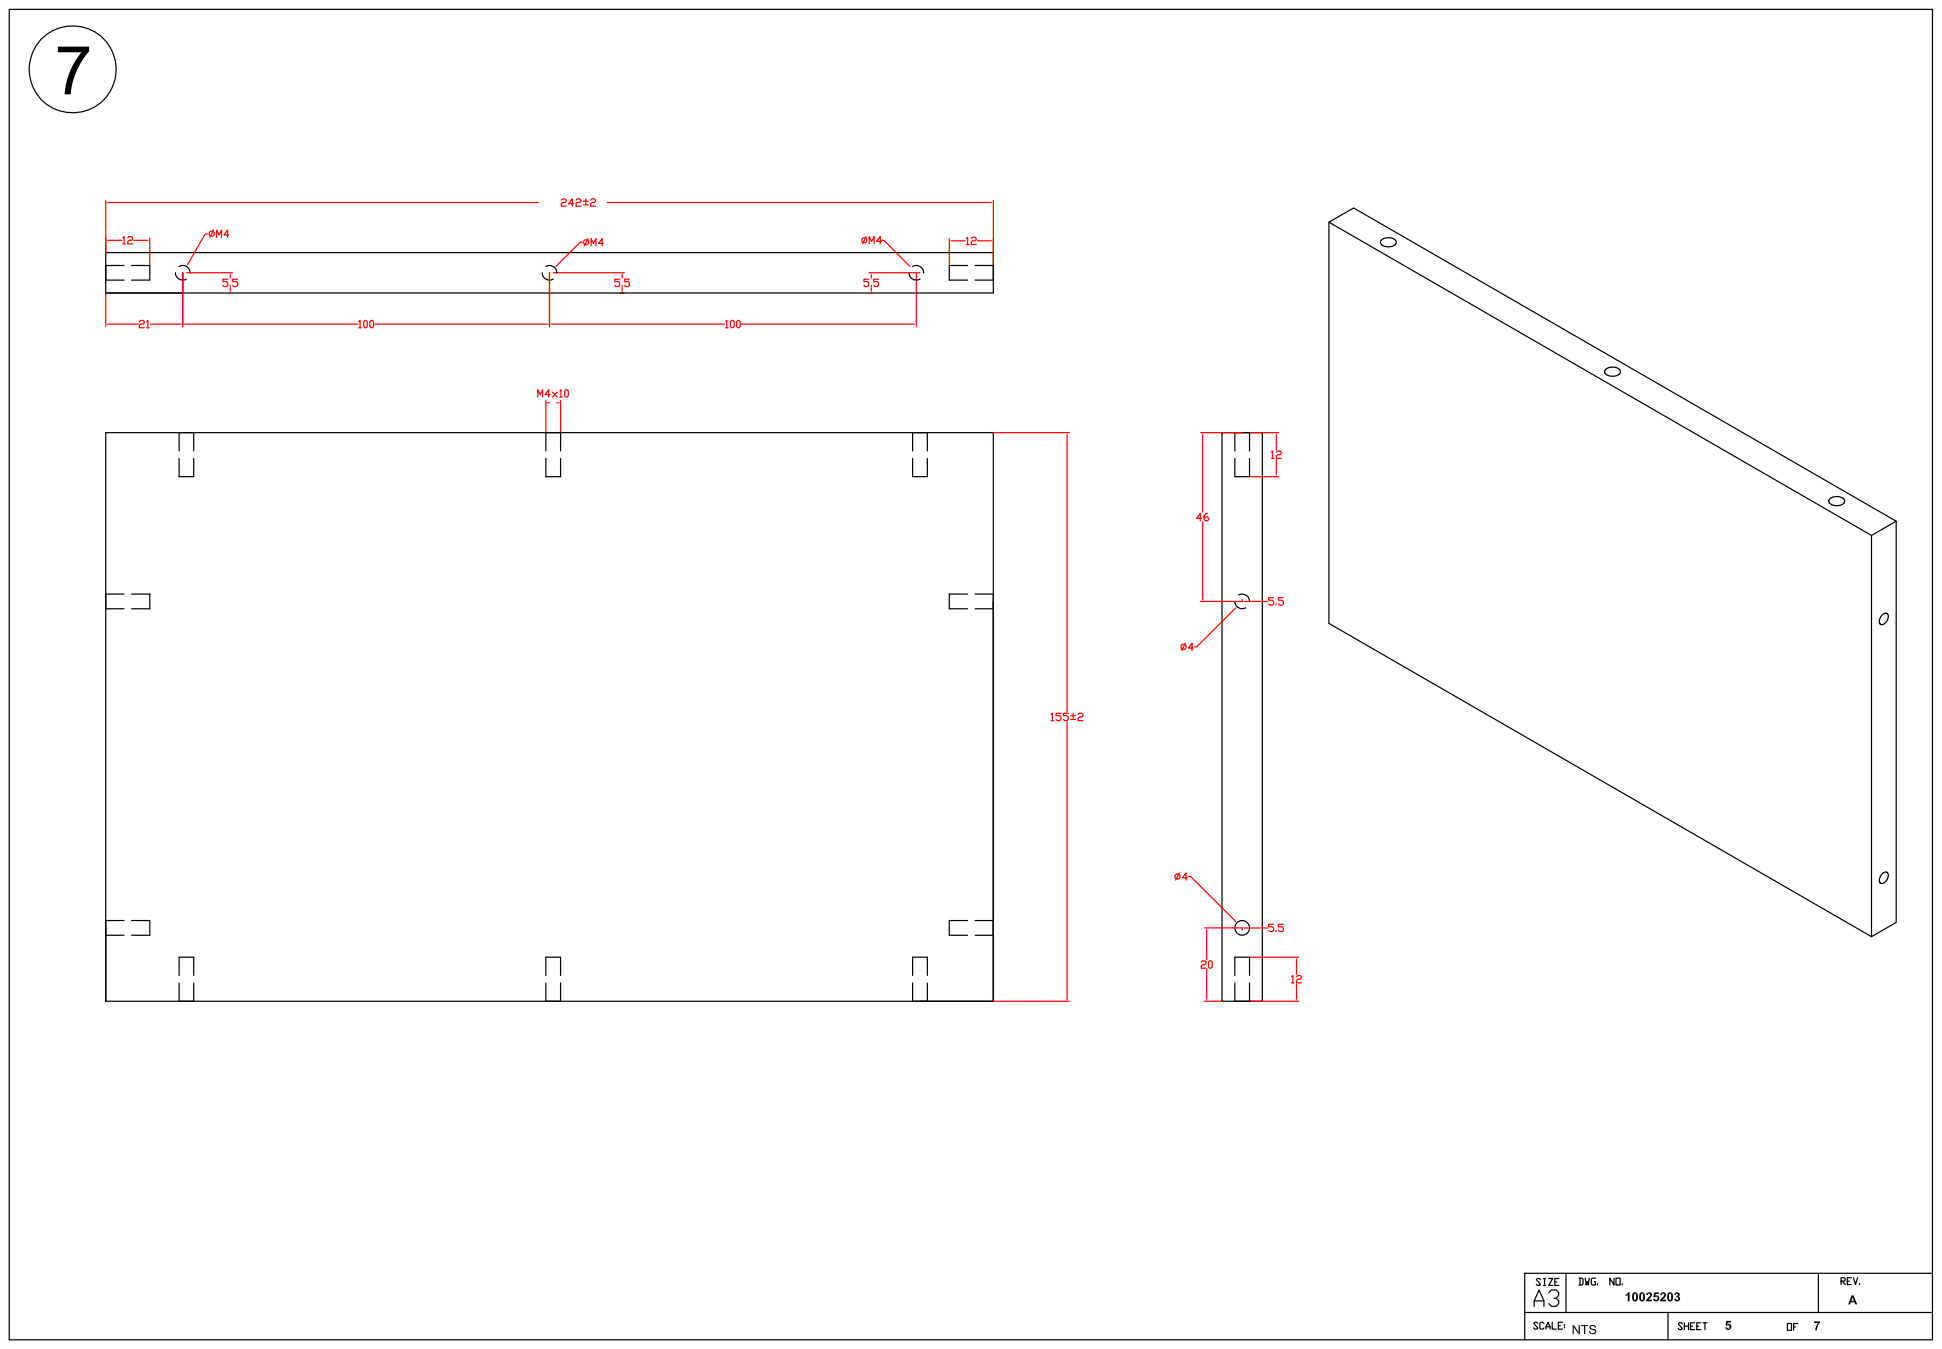
[picture p78: page 5]

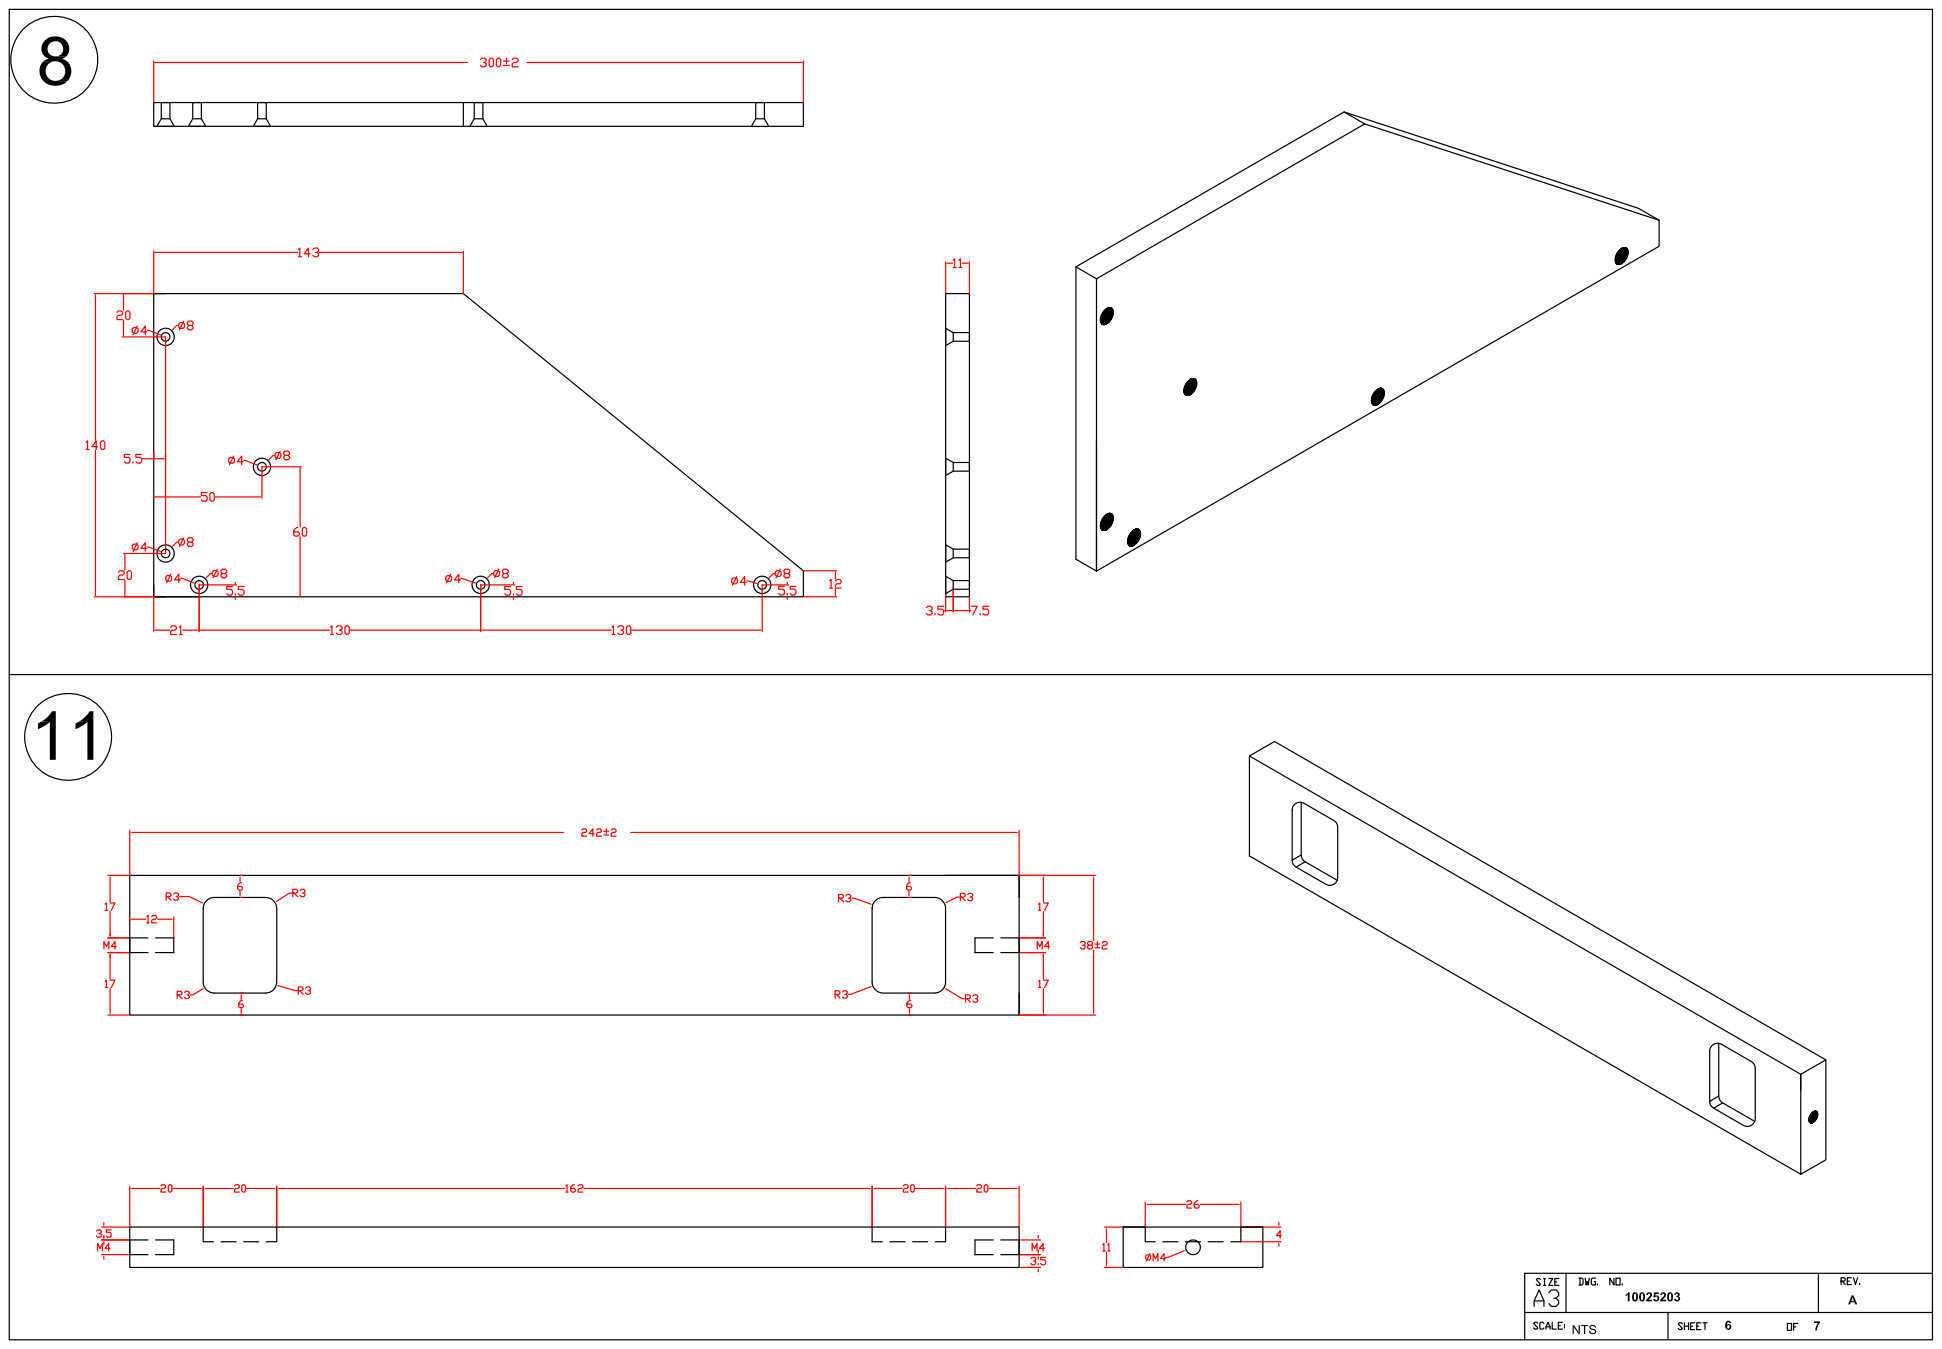
[picture p79: page 6]

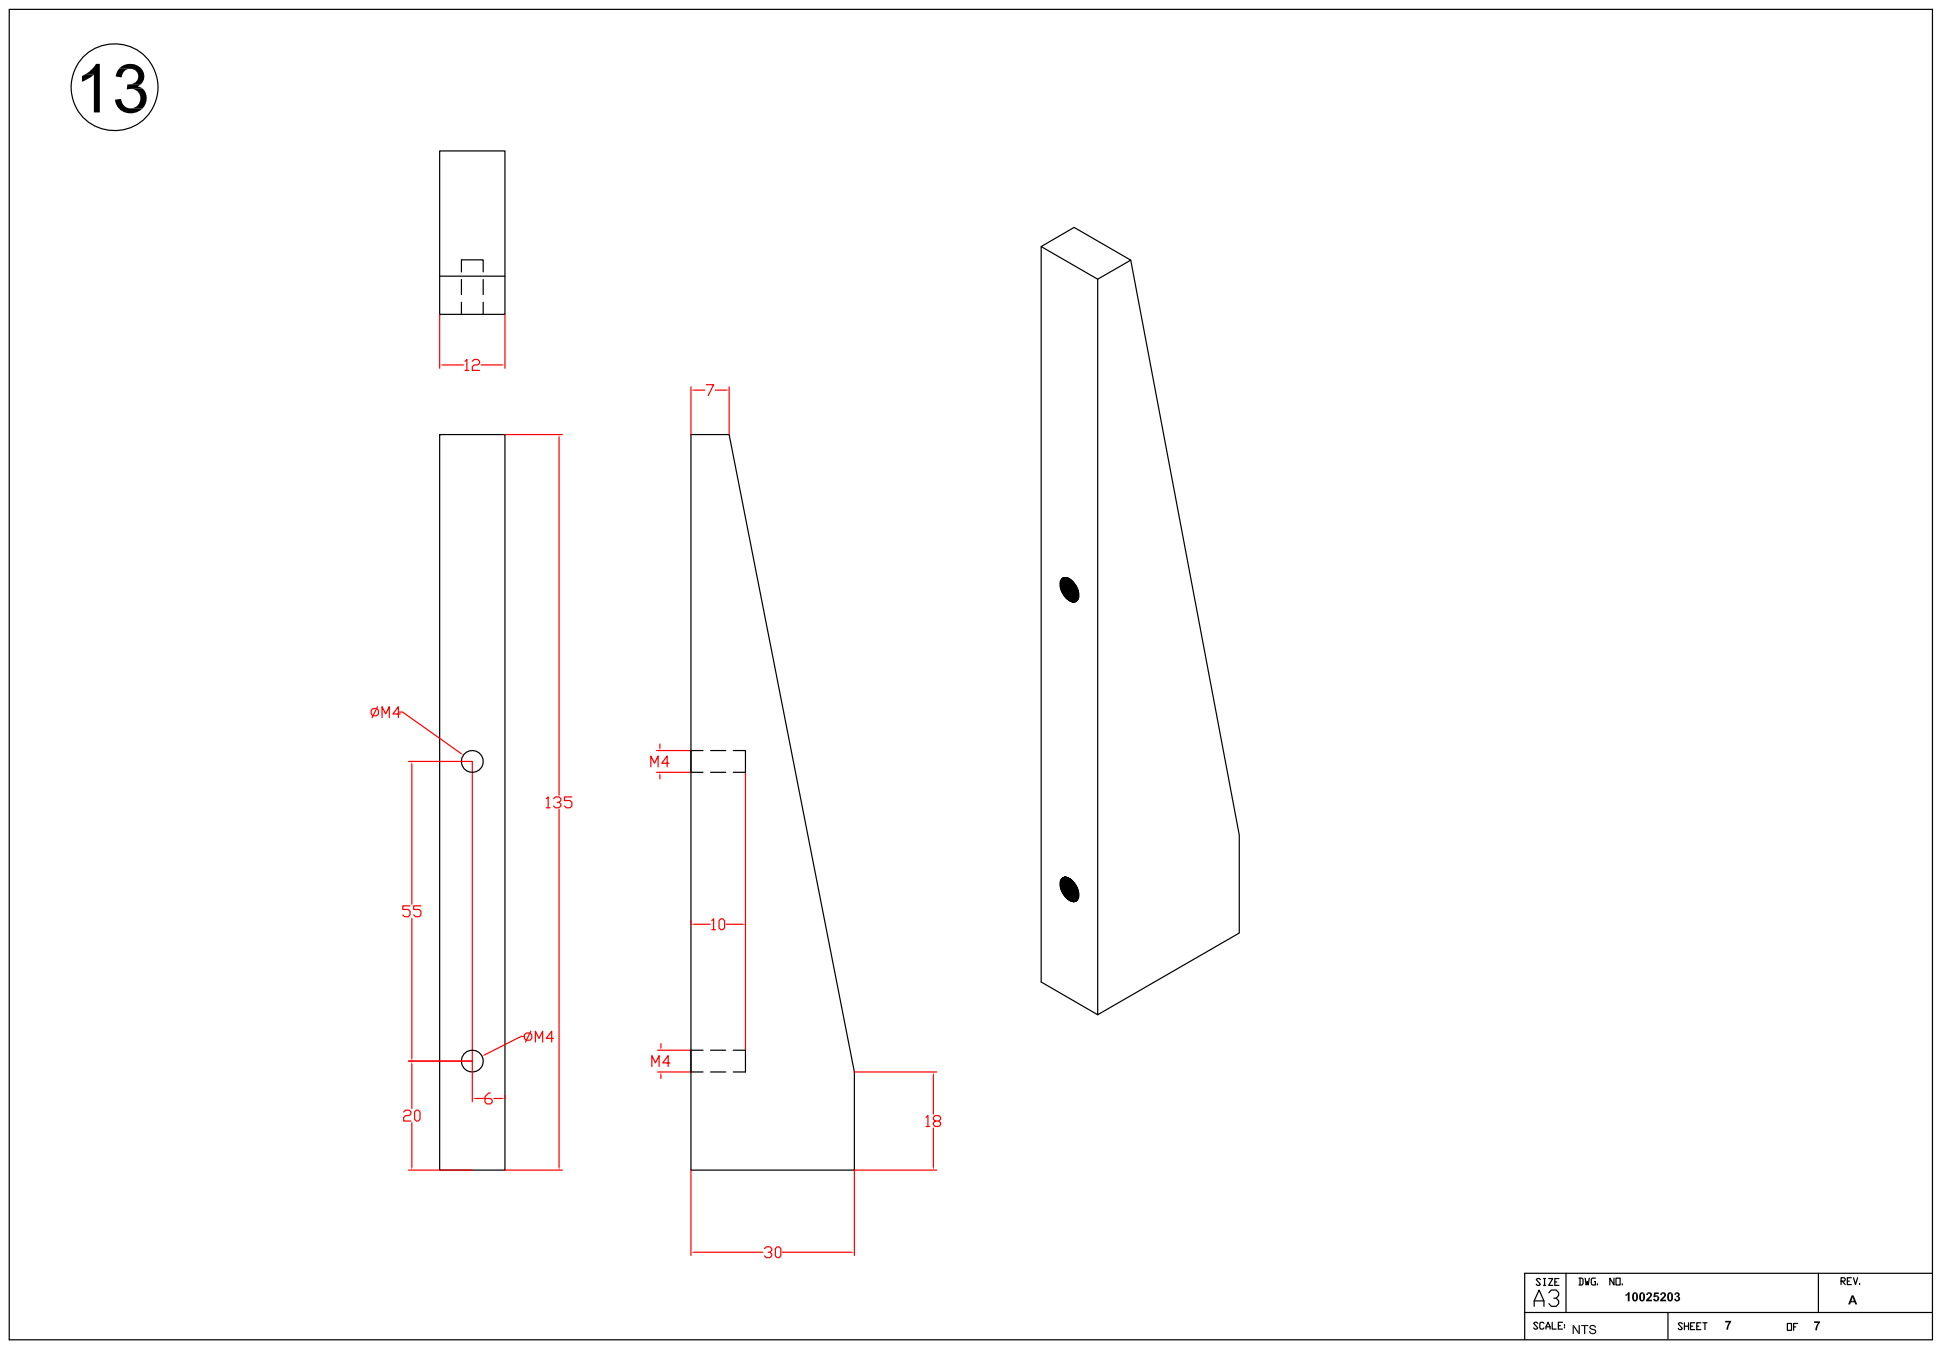
[picture p80: page 7]
