FlyingRat/Medtronic-PB560/Manufacturing Fixtures/10025244B00.pdf

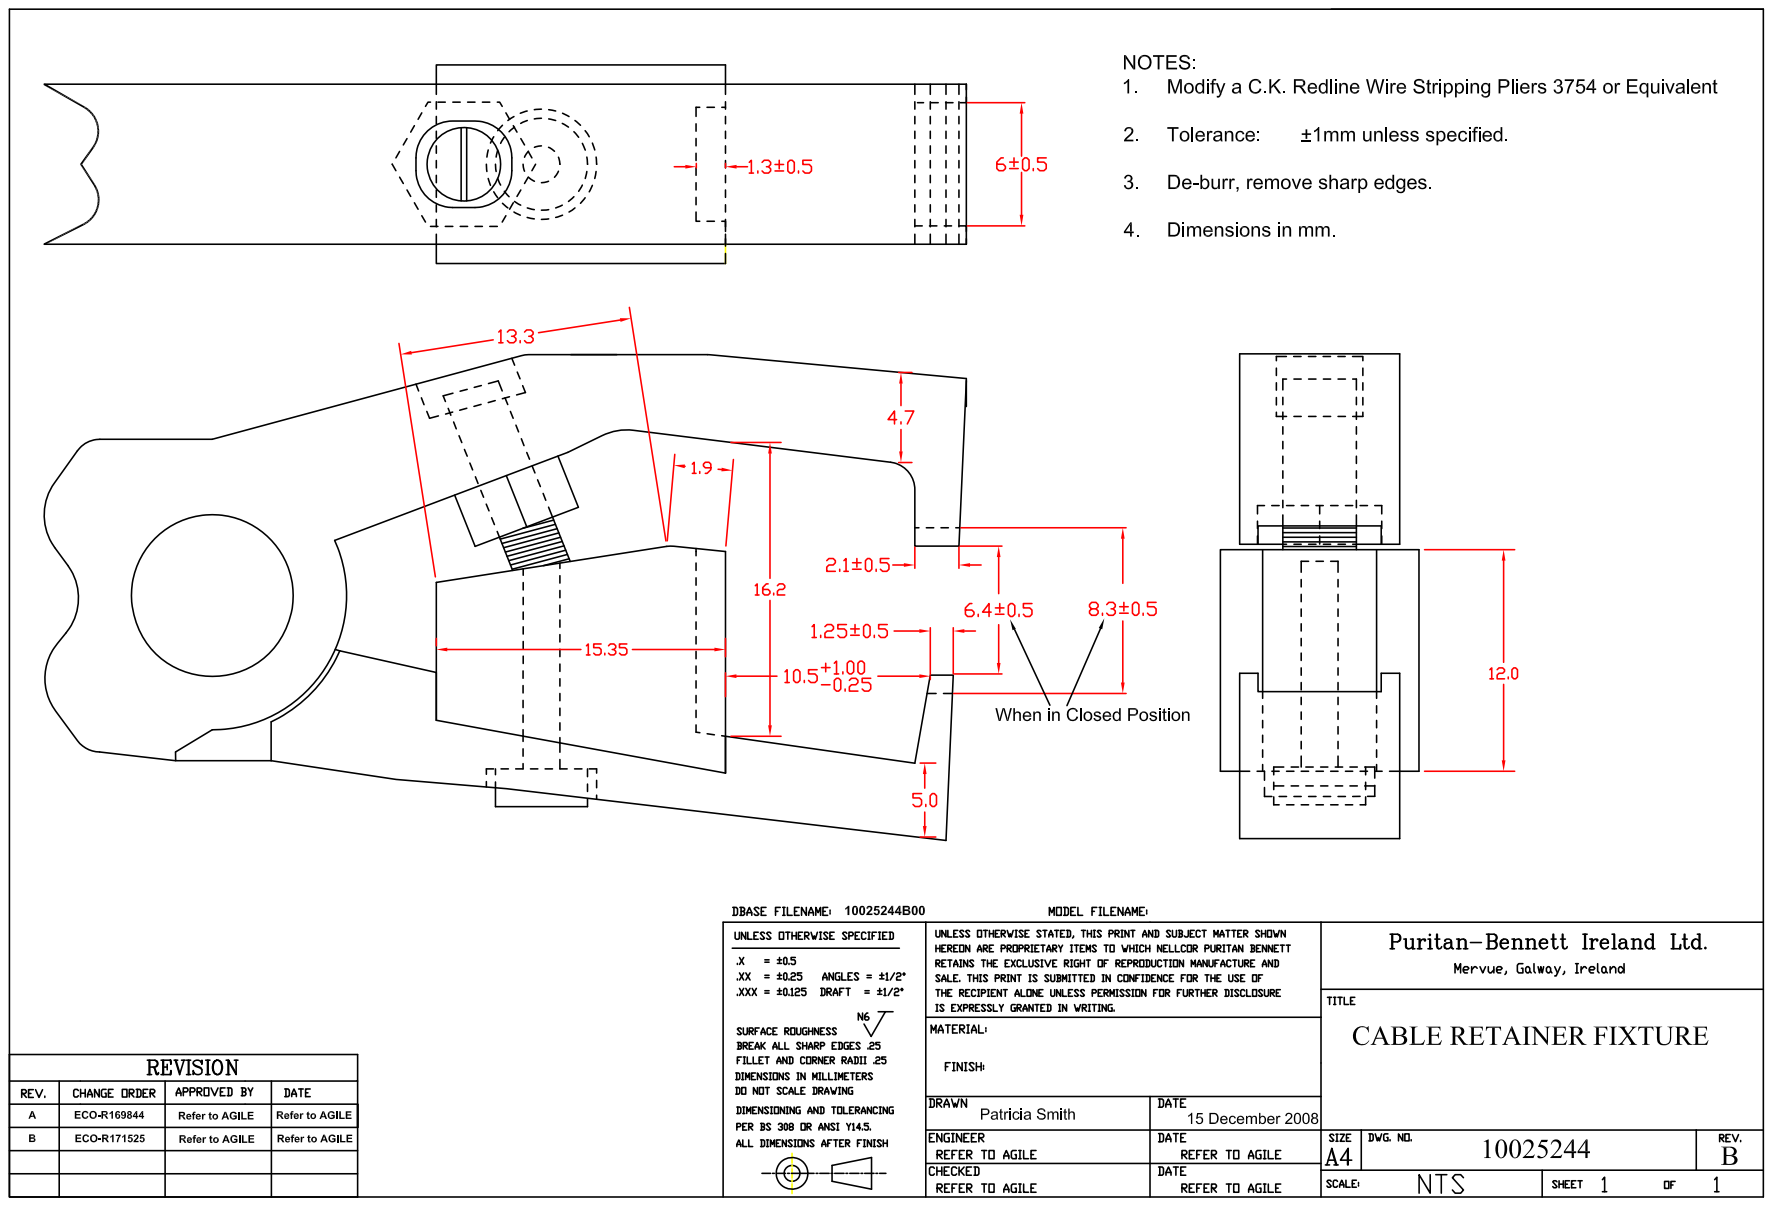
[picture p81: page 1]
