FlyingRat/Medtronic-PB560/Manufacturing Fixtures/10025245A00.pdf

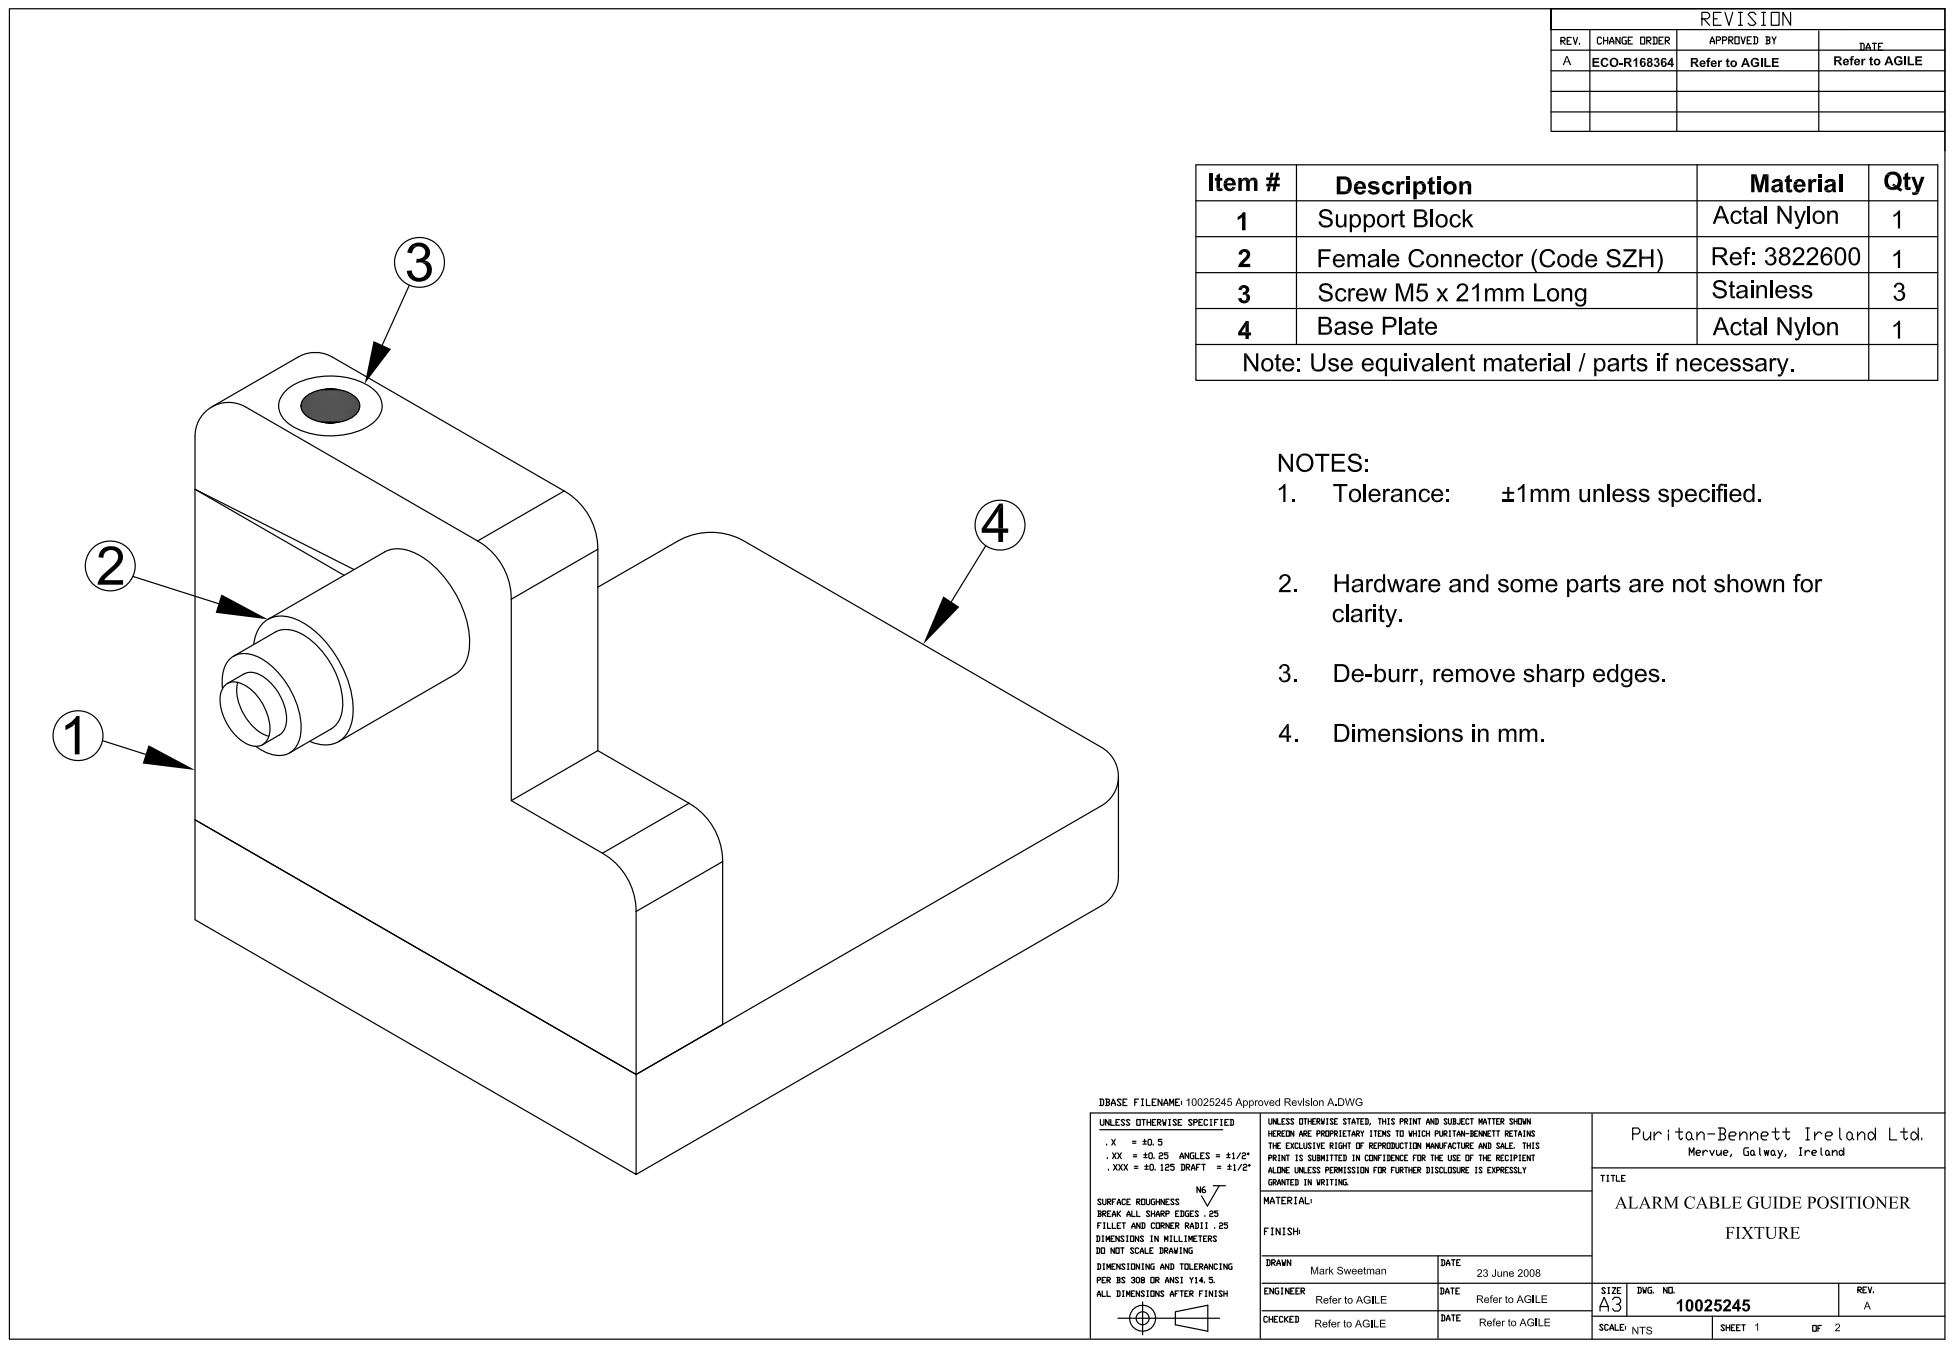
[picture p82: page 1]

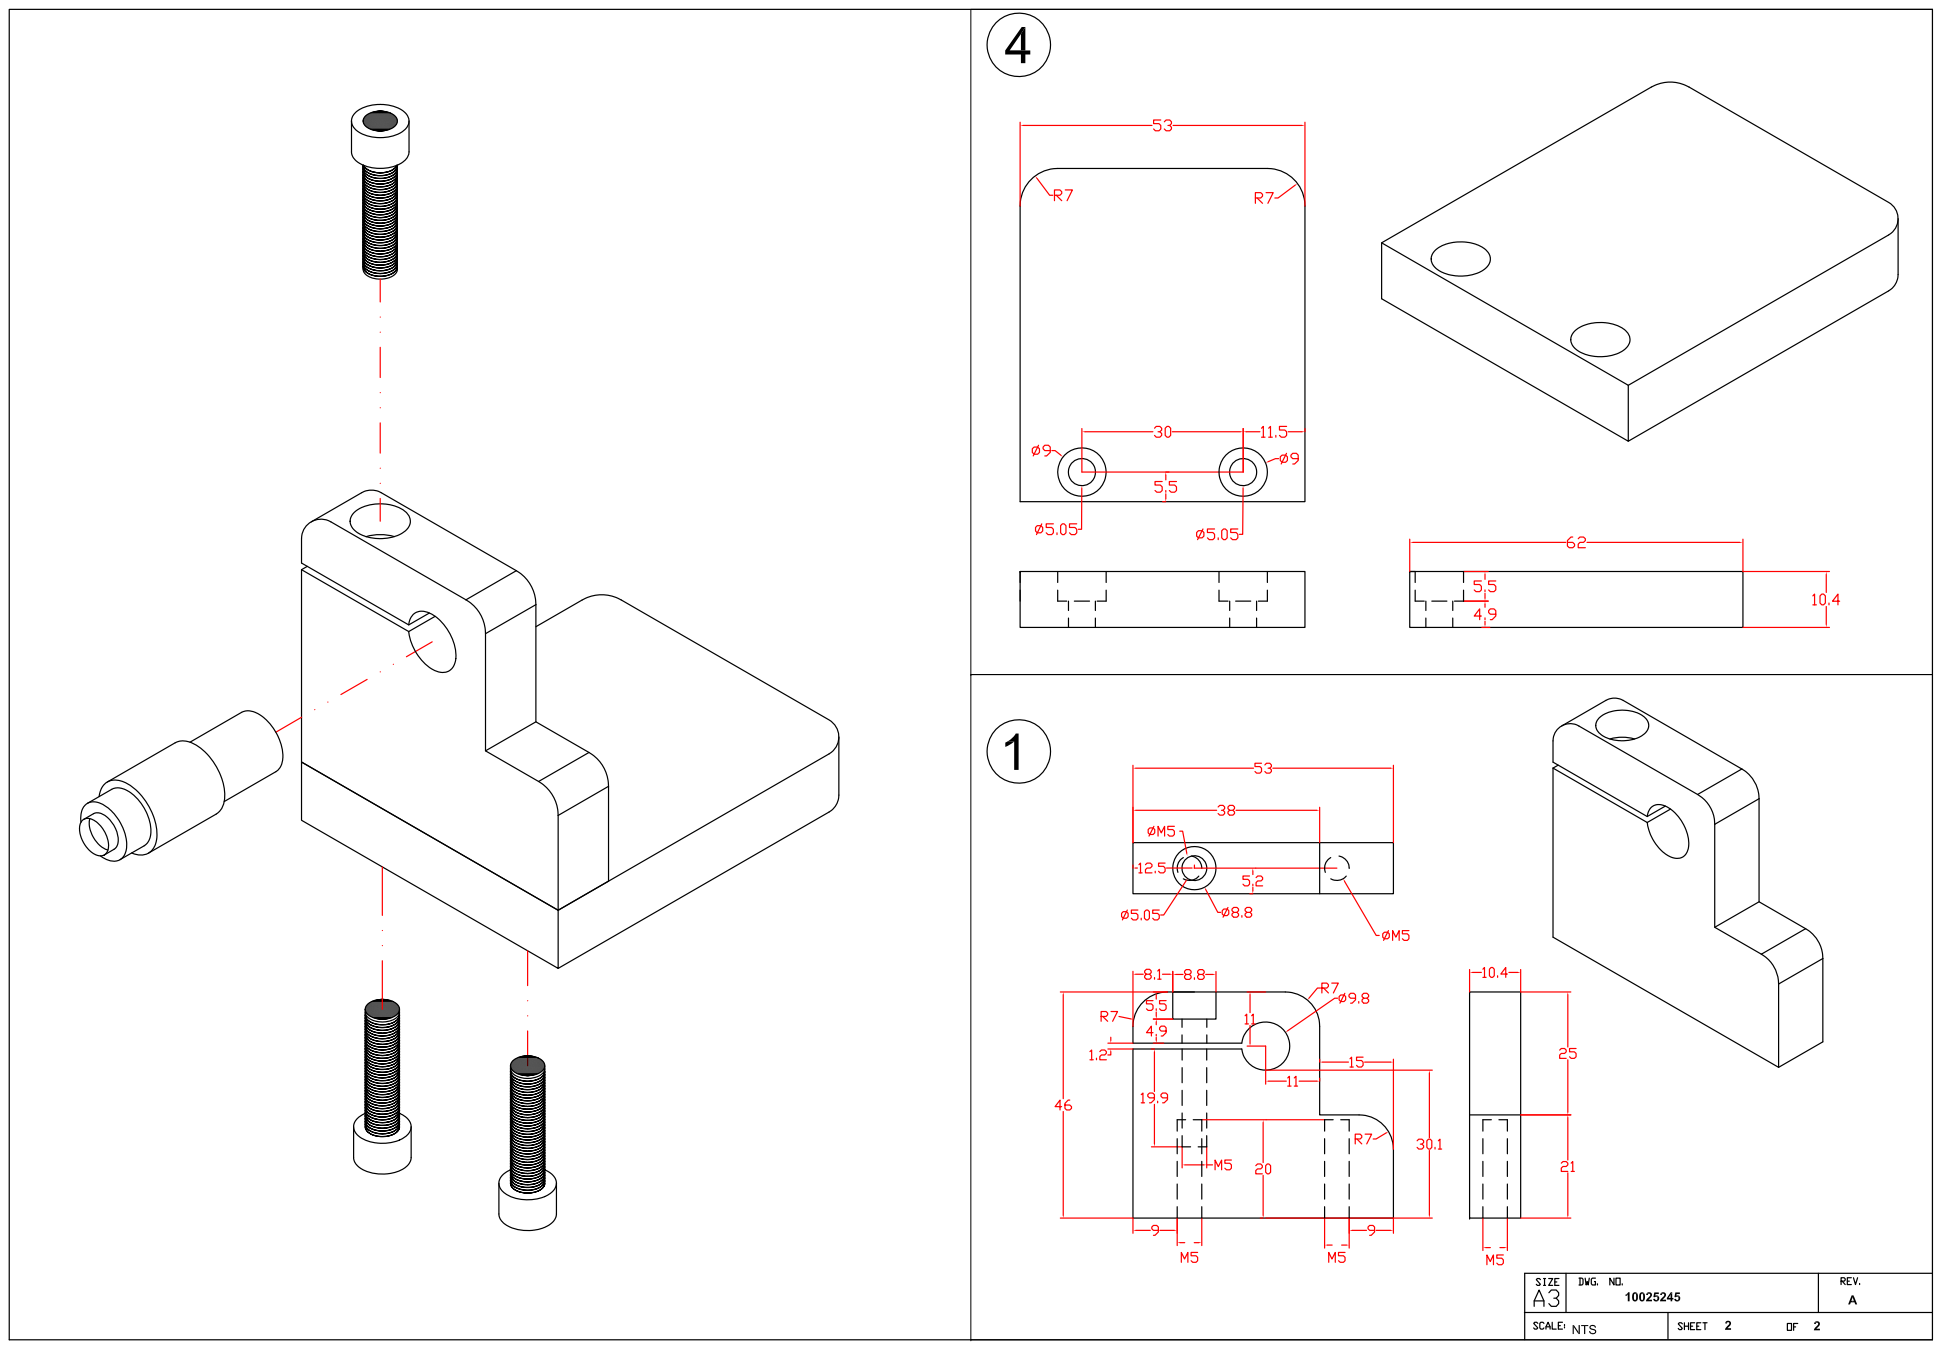
[picture p83: page 2]
