FlyingRat/Medtronic-PB560/Manufacturing Fixtures/10029105A00.pdf

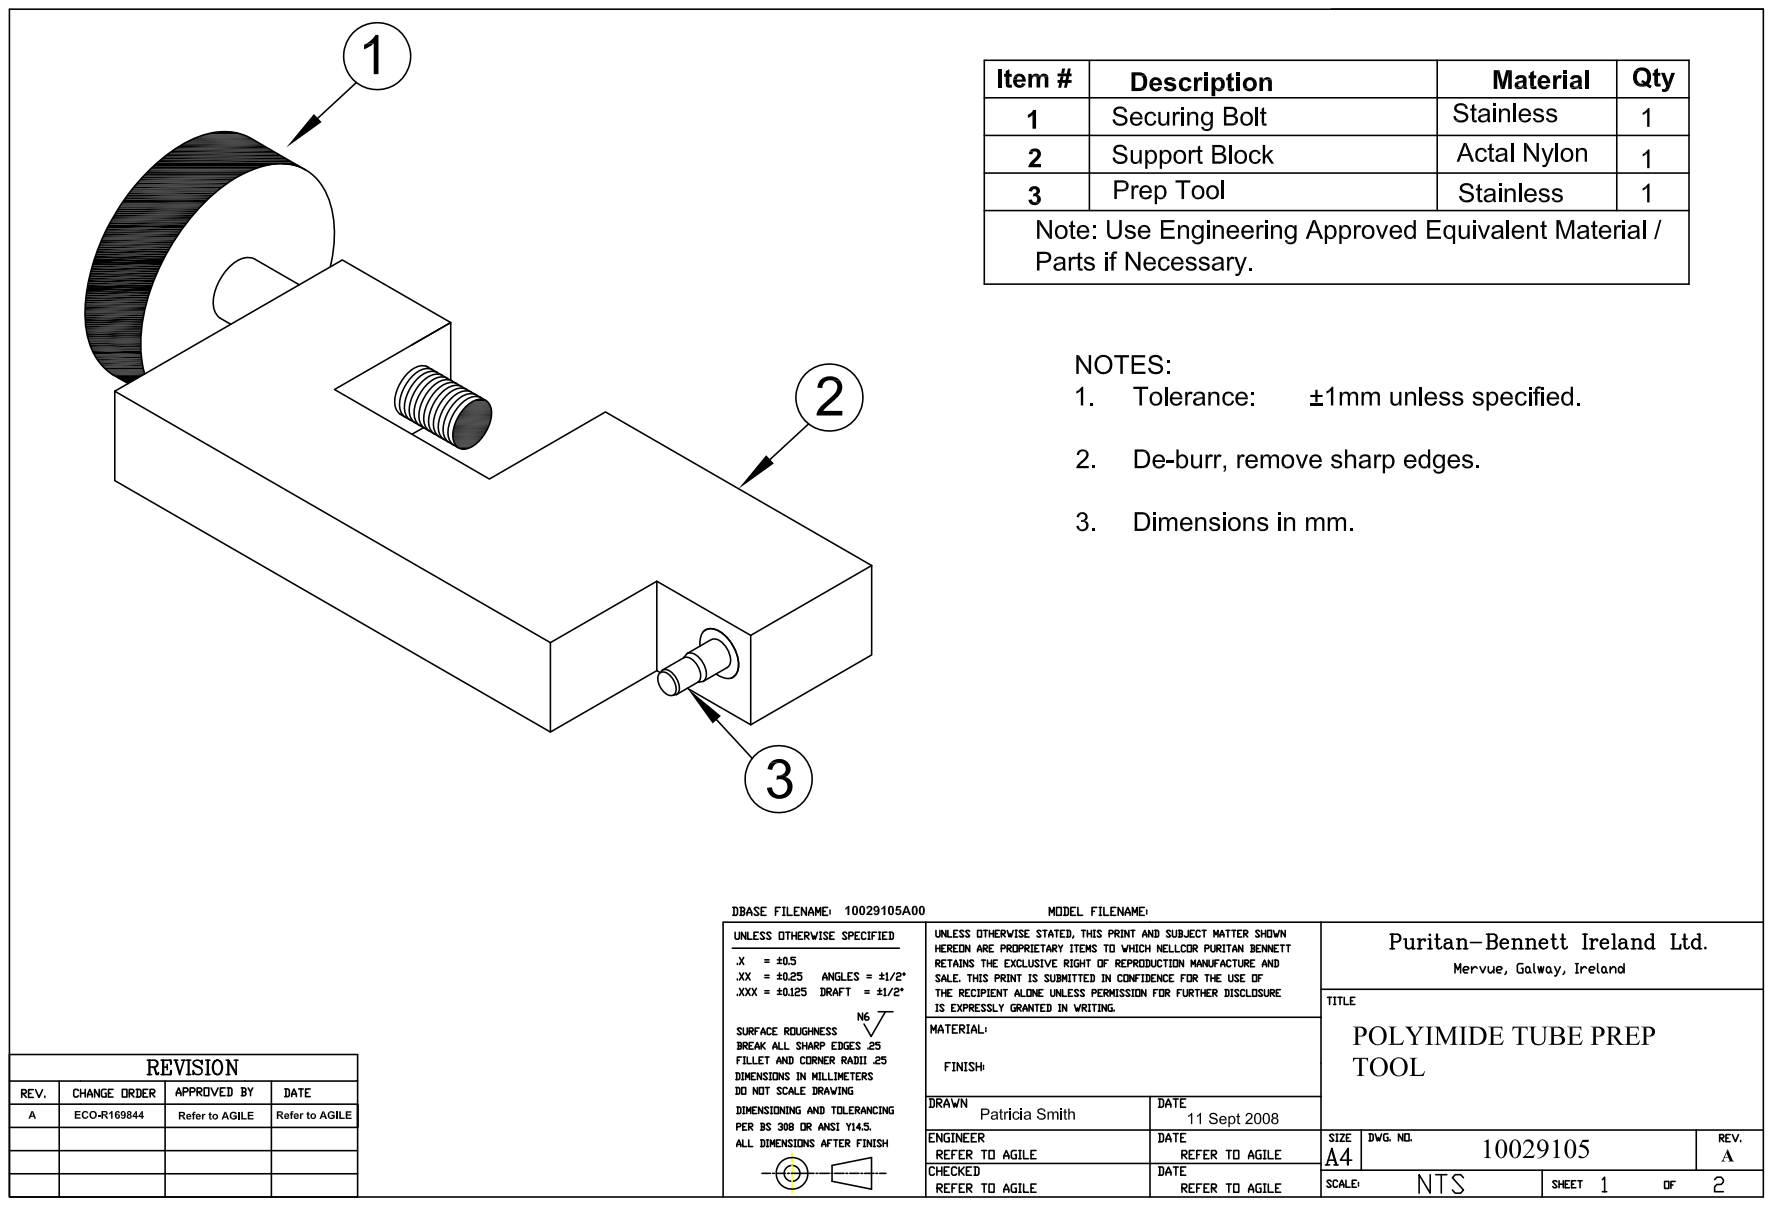
[picture p84: page 1]

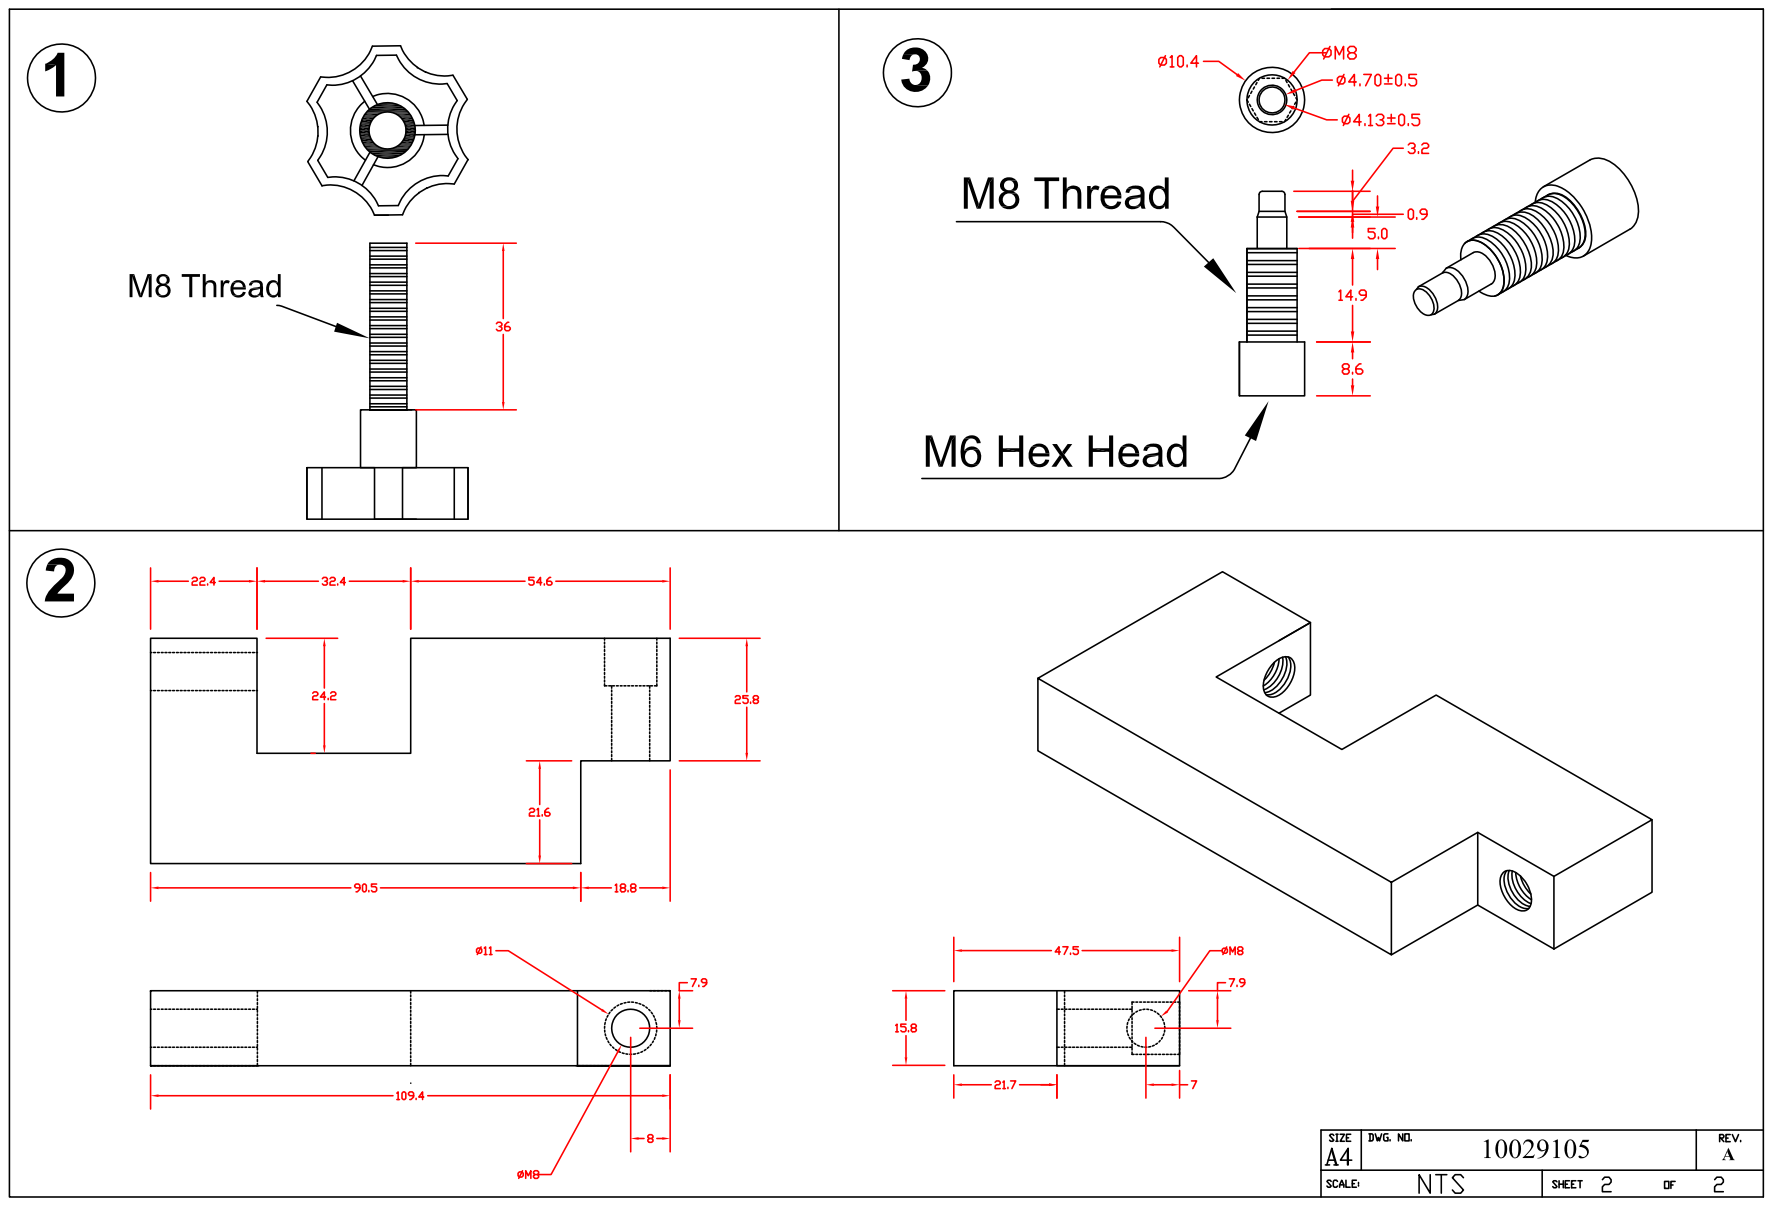
[picture p85: page 2]
