FlyingRat/Medtronic-PB560/Manufacturing Fixtures/10031632A00.pdf

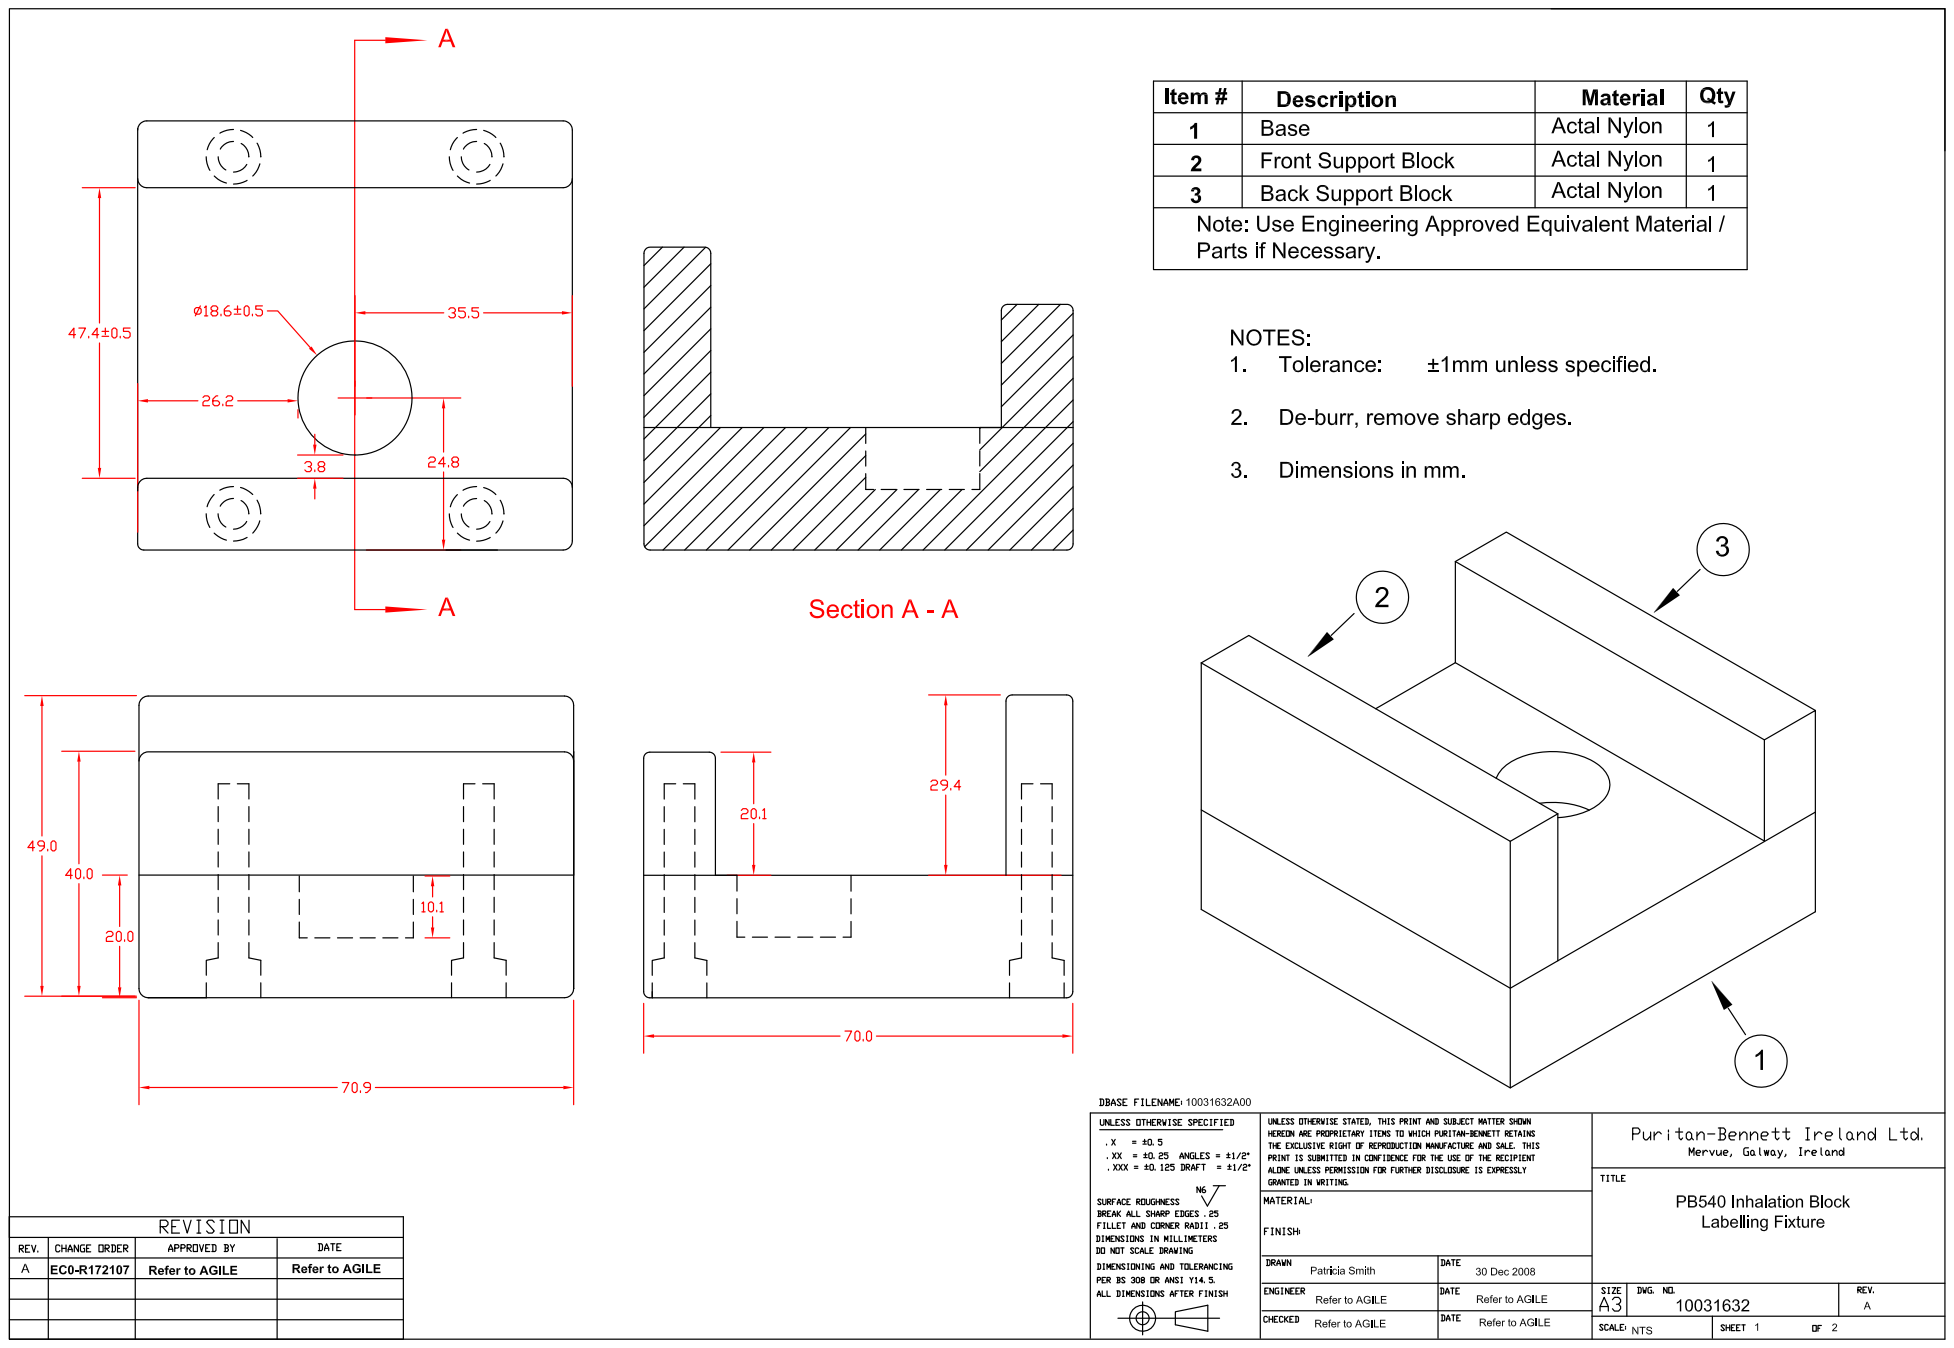
[picture p86: page 1]

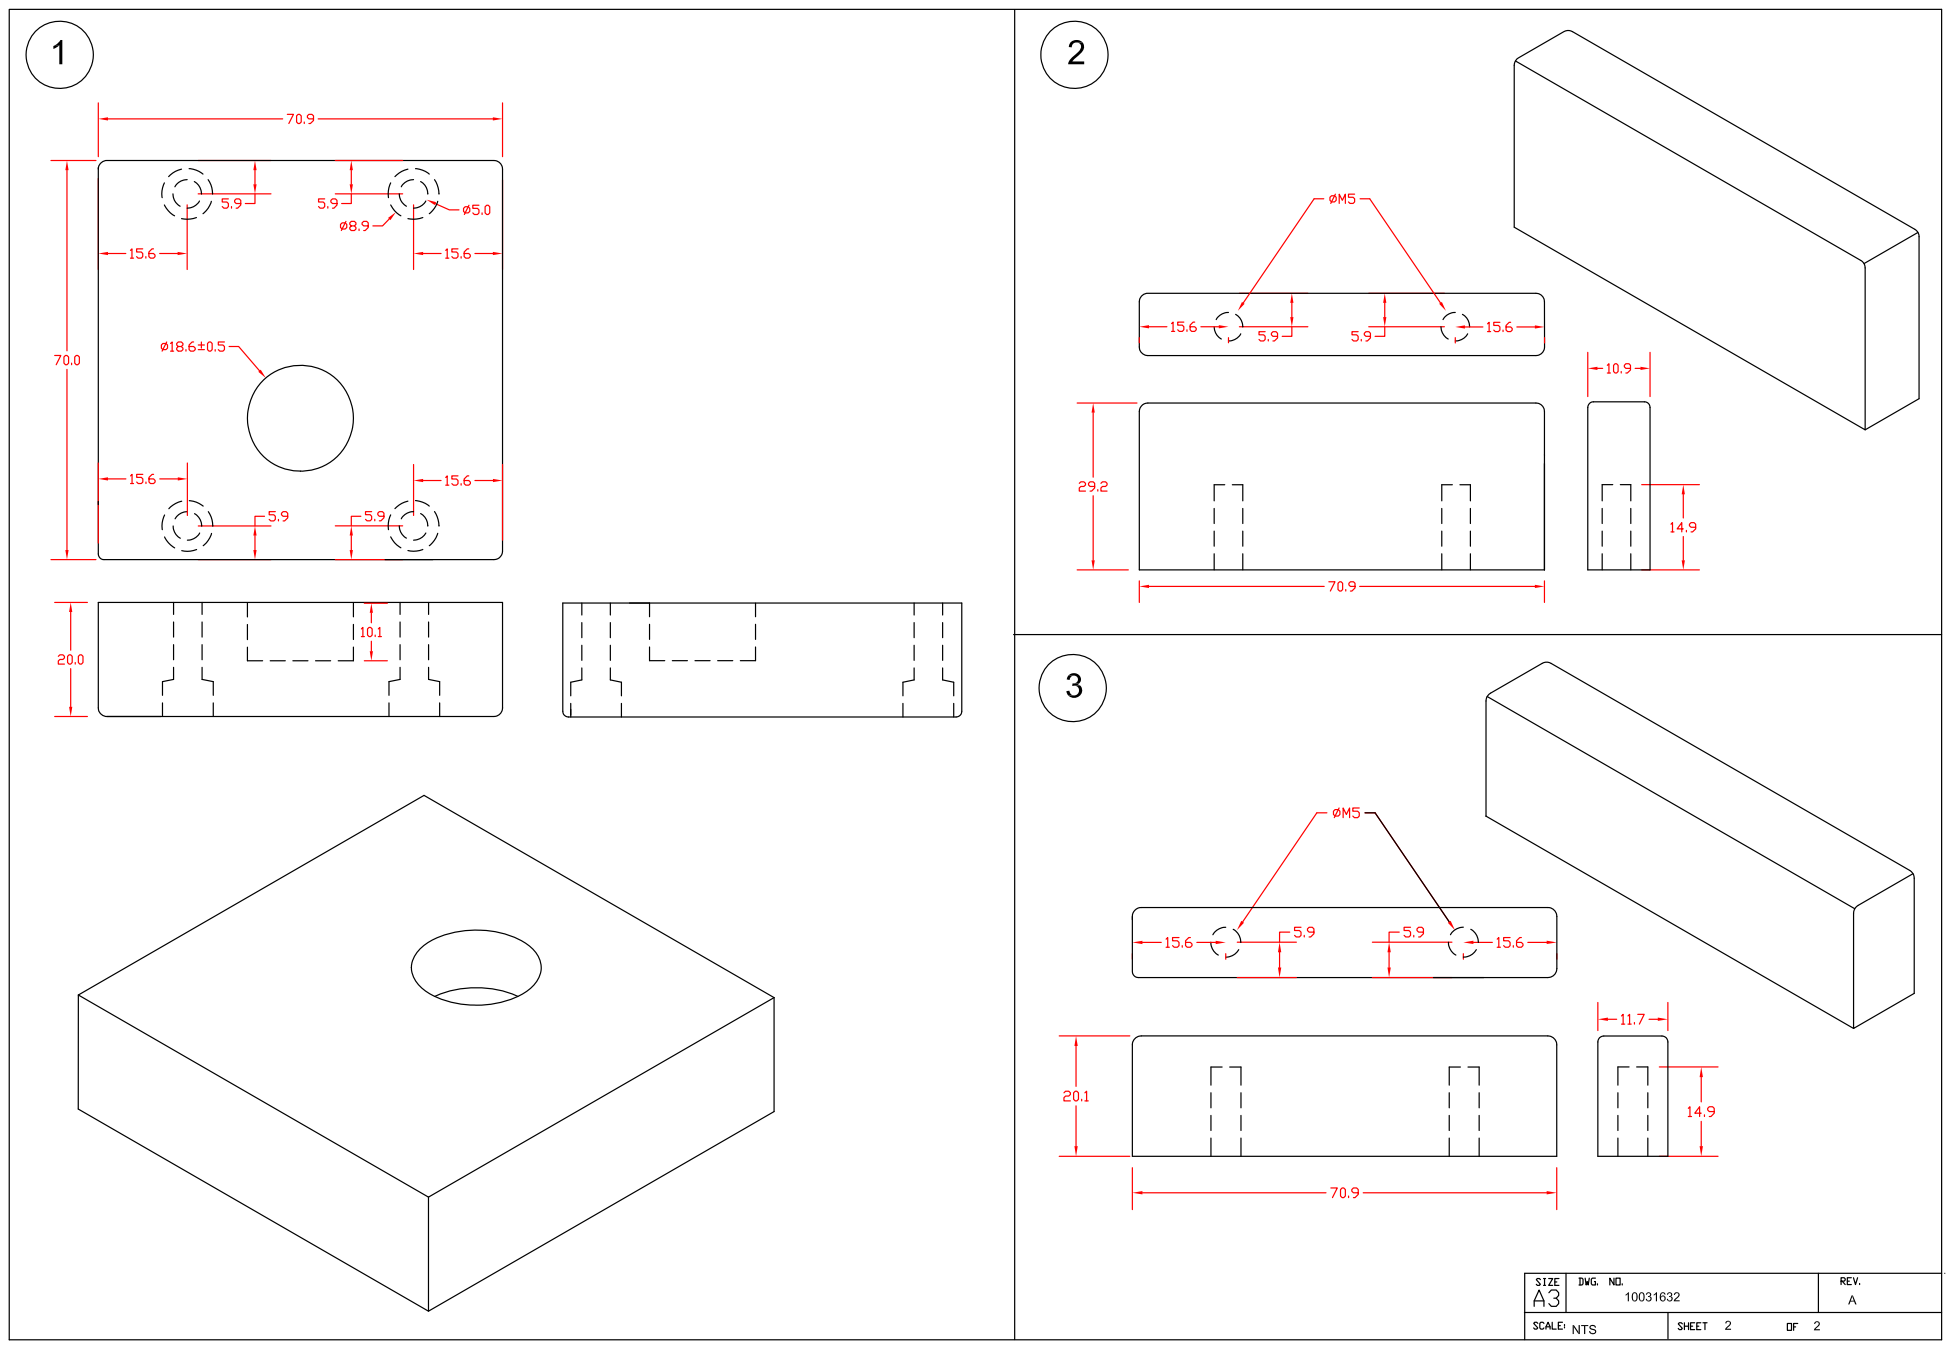
[picture p87: page 2]
