FlyingRat/Medtronic-PB560/Mechanical Part Drawings/016294_RMS1/016294X0301.pdf

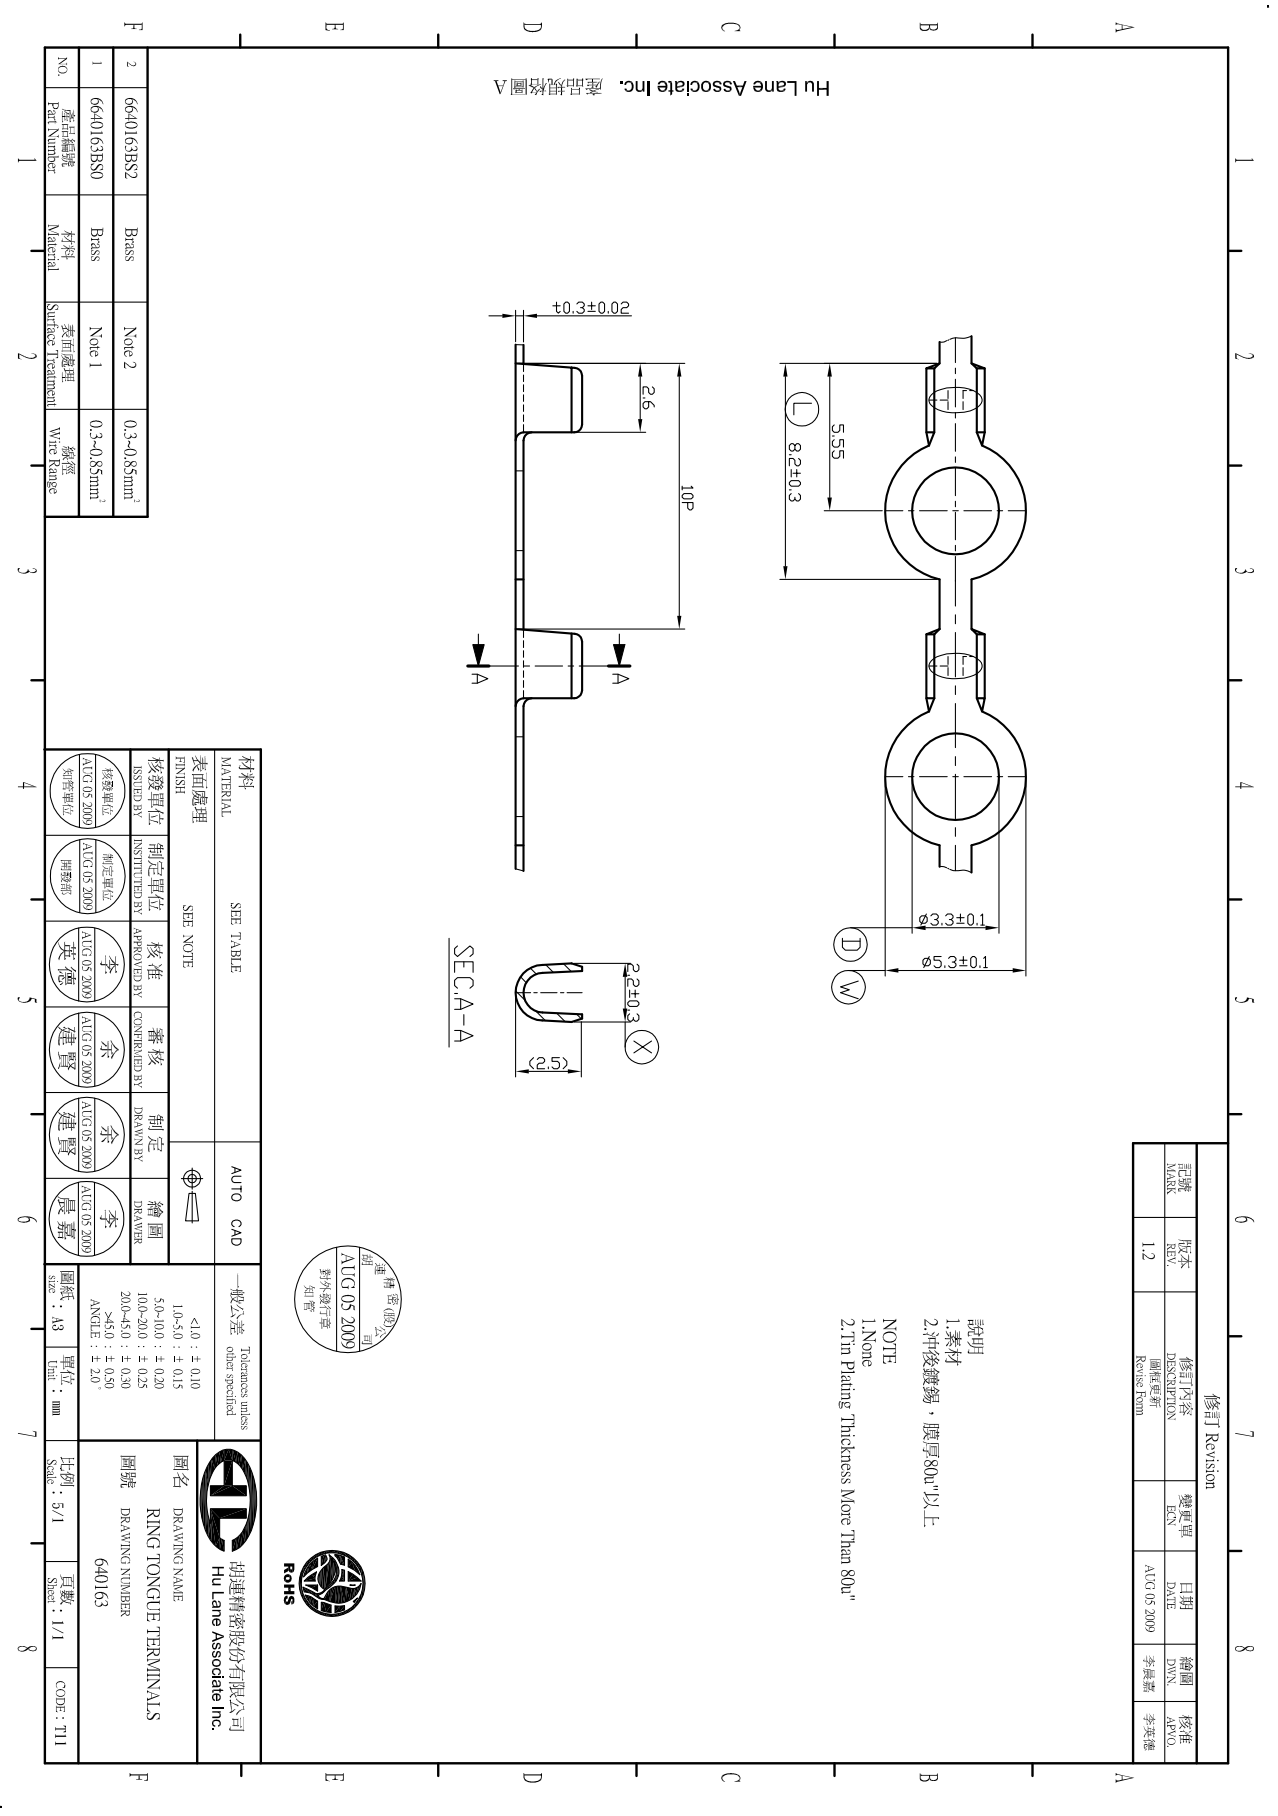
[picture p88: page 1]
