FlyingRat/Medtronic-PB560/Mechanical Part Drawings/10053480/10053480B01.pdf

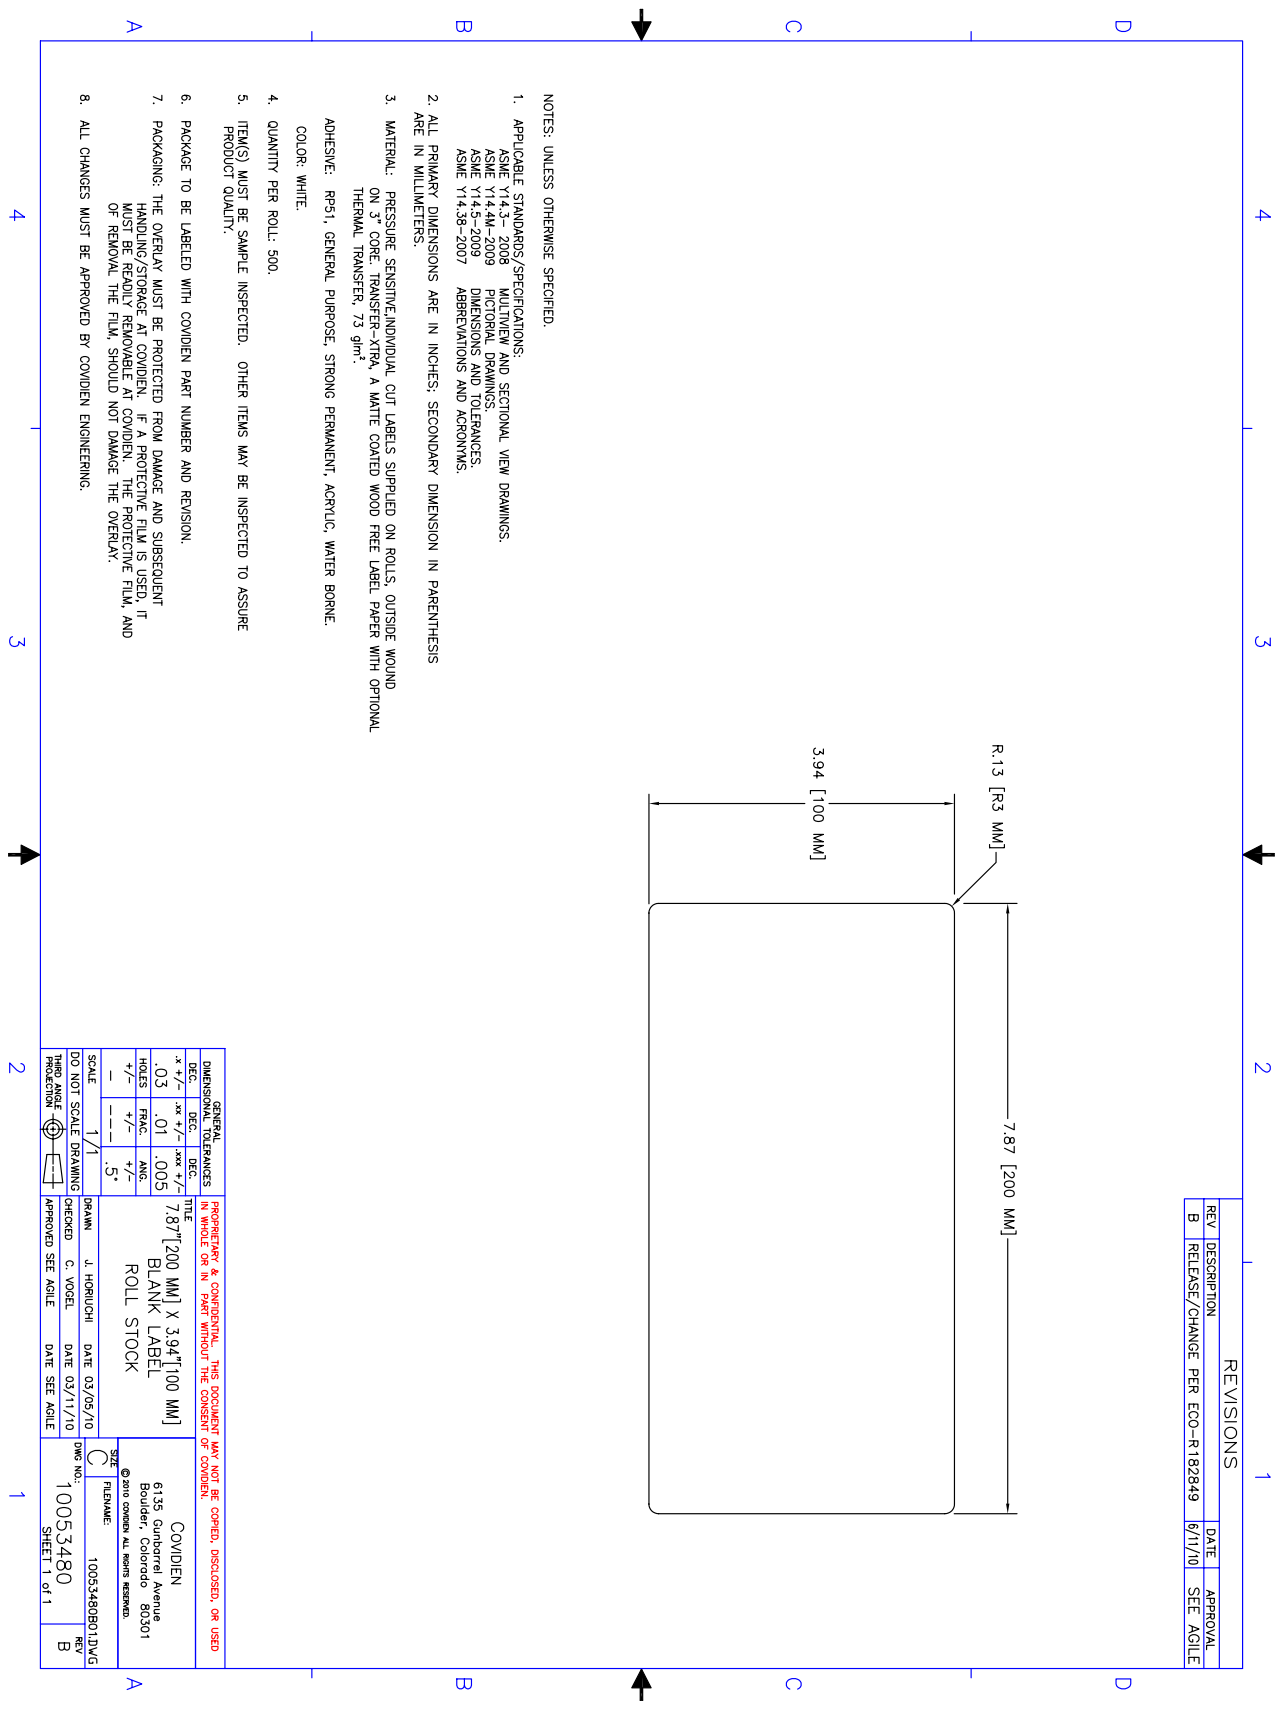
[picture p89: page 1]
