FlyingRat/Medtronic-PB560/Mechanical Part Drawings/10080310/10080310E00.pdf

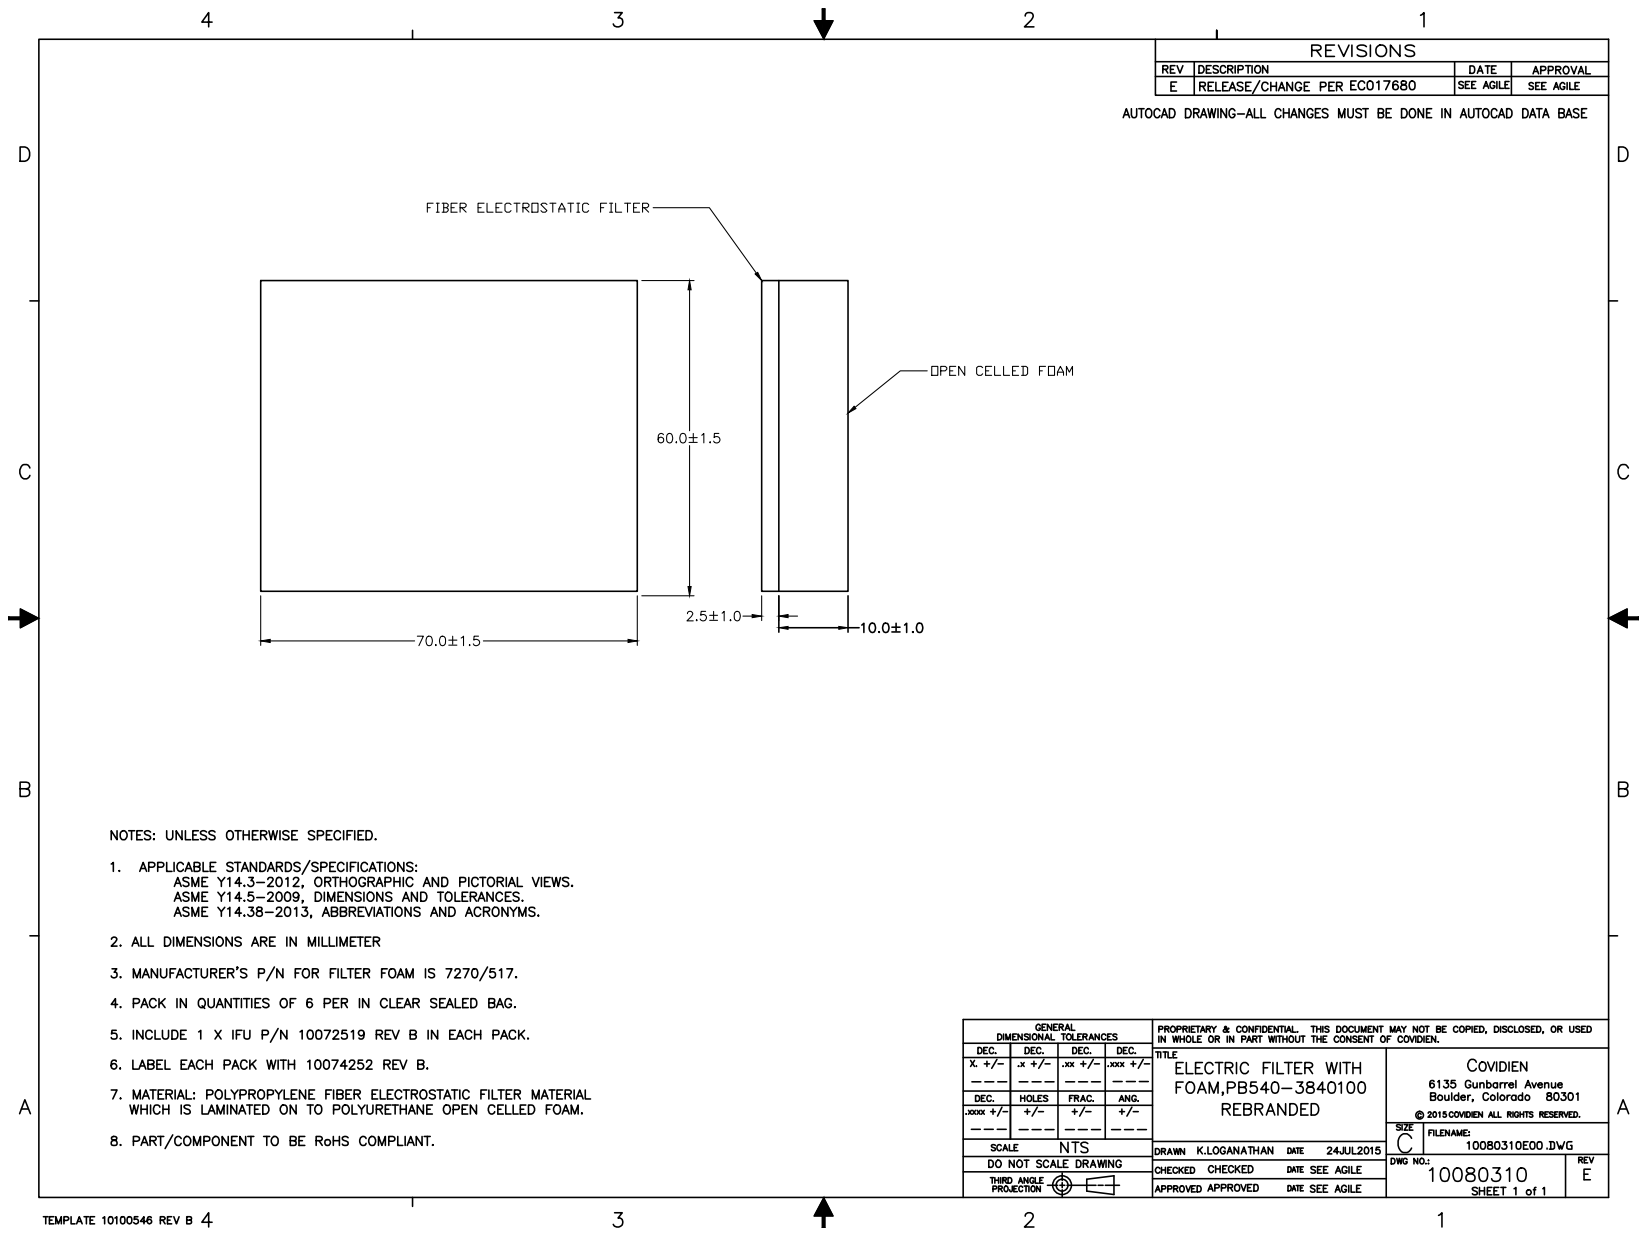
[picture p90: page 1]
