FlyingRat/Medtronic-PB560/Mechanical Part Drawings/3824300/10064411A00.pdf

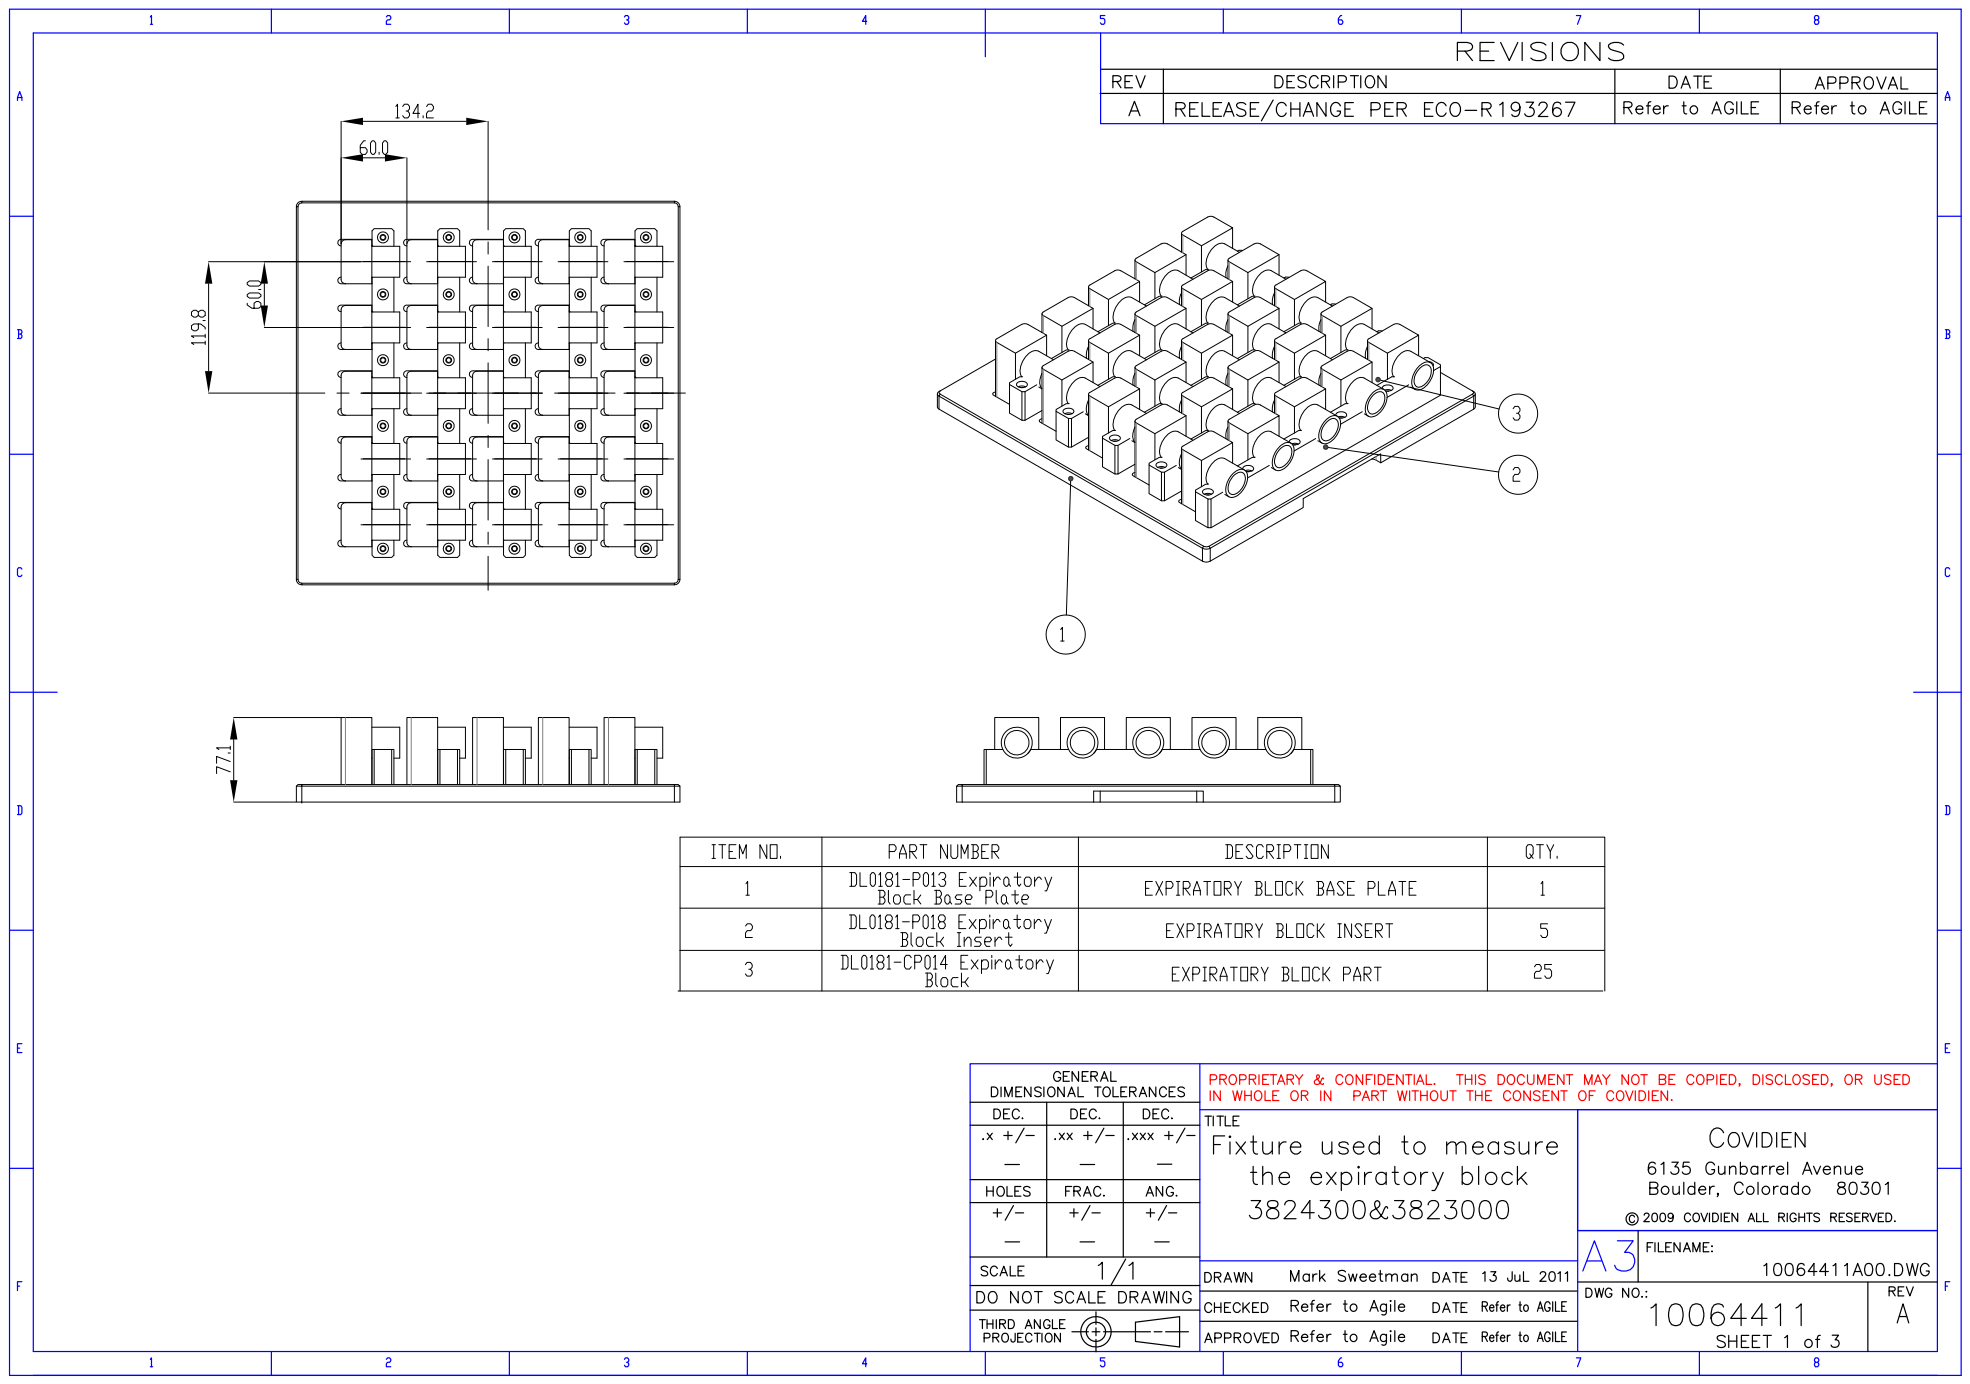
[picture p92: page 1]

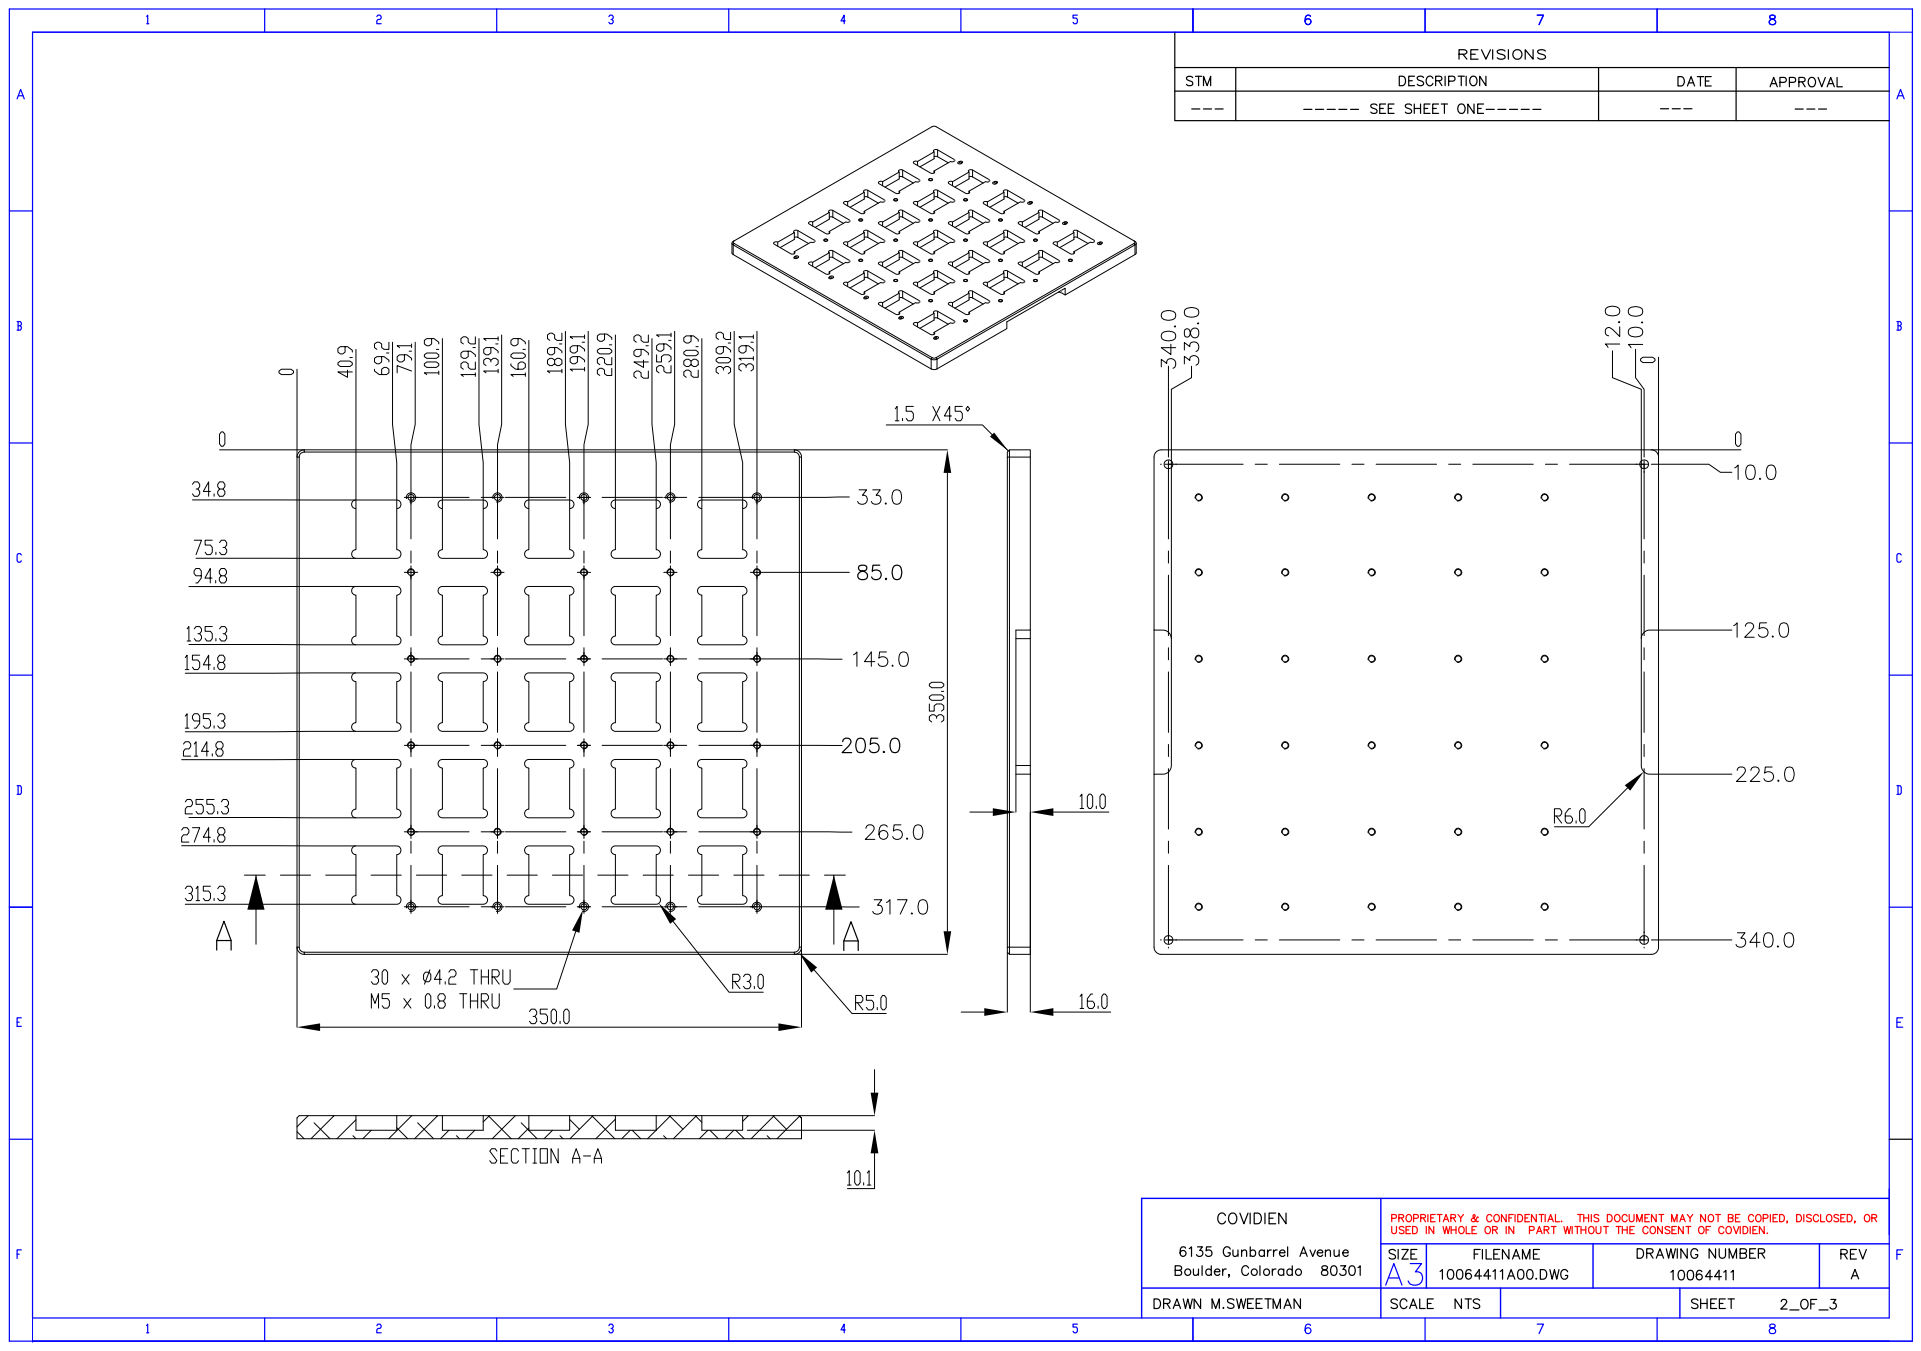
[picture p93: page 2]

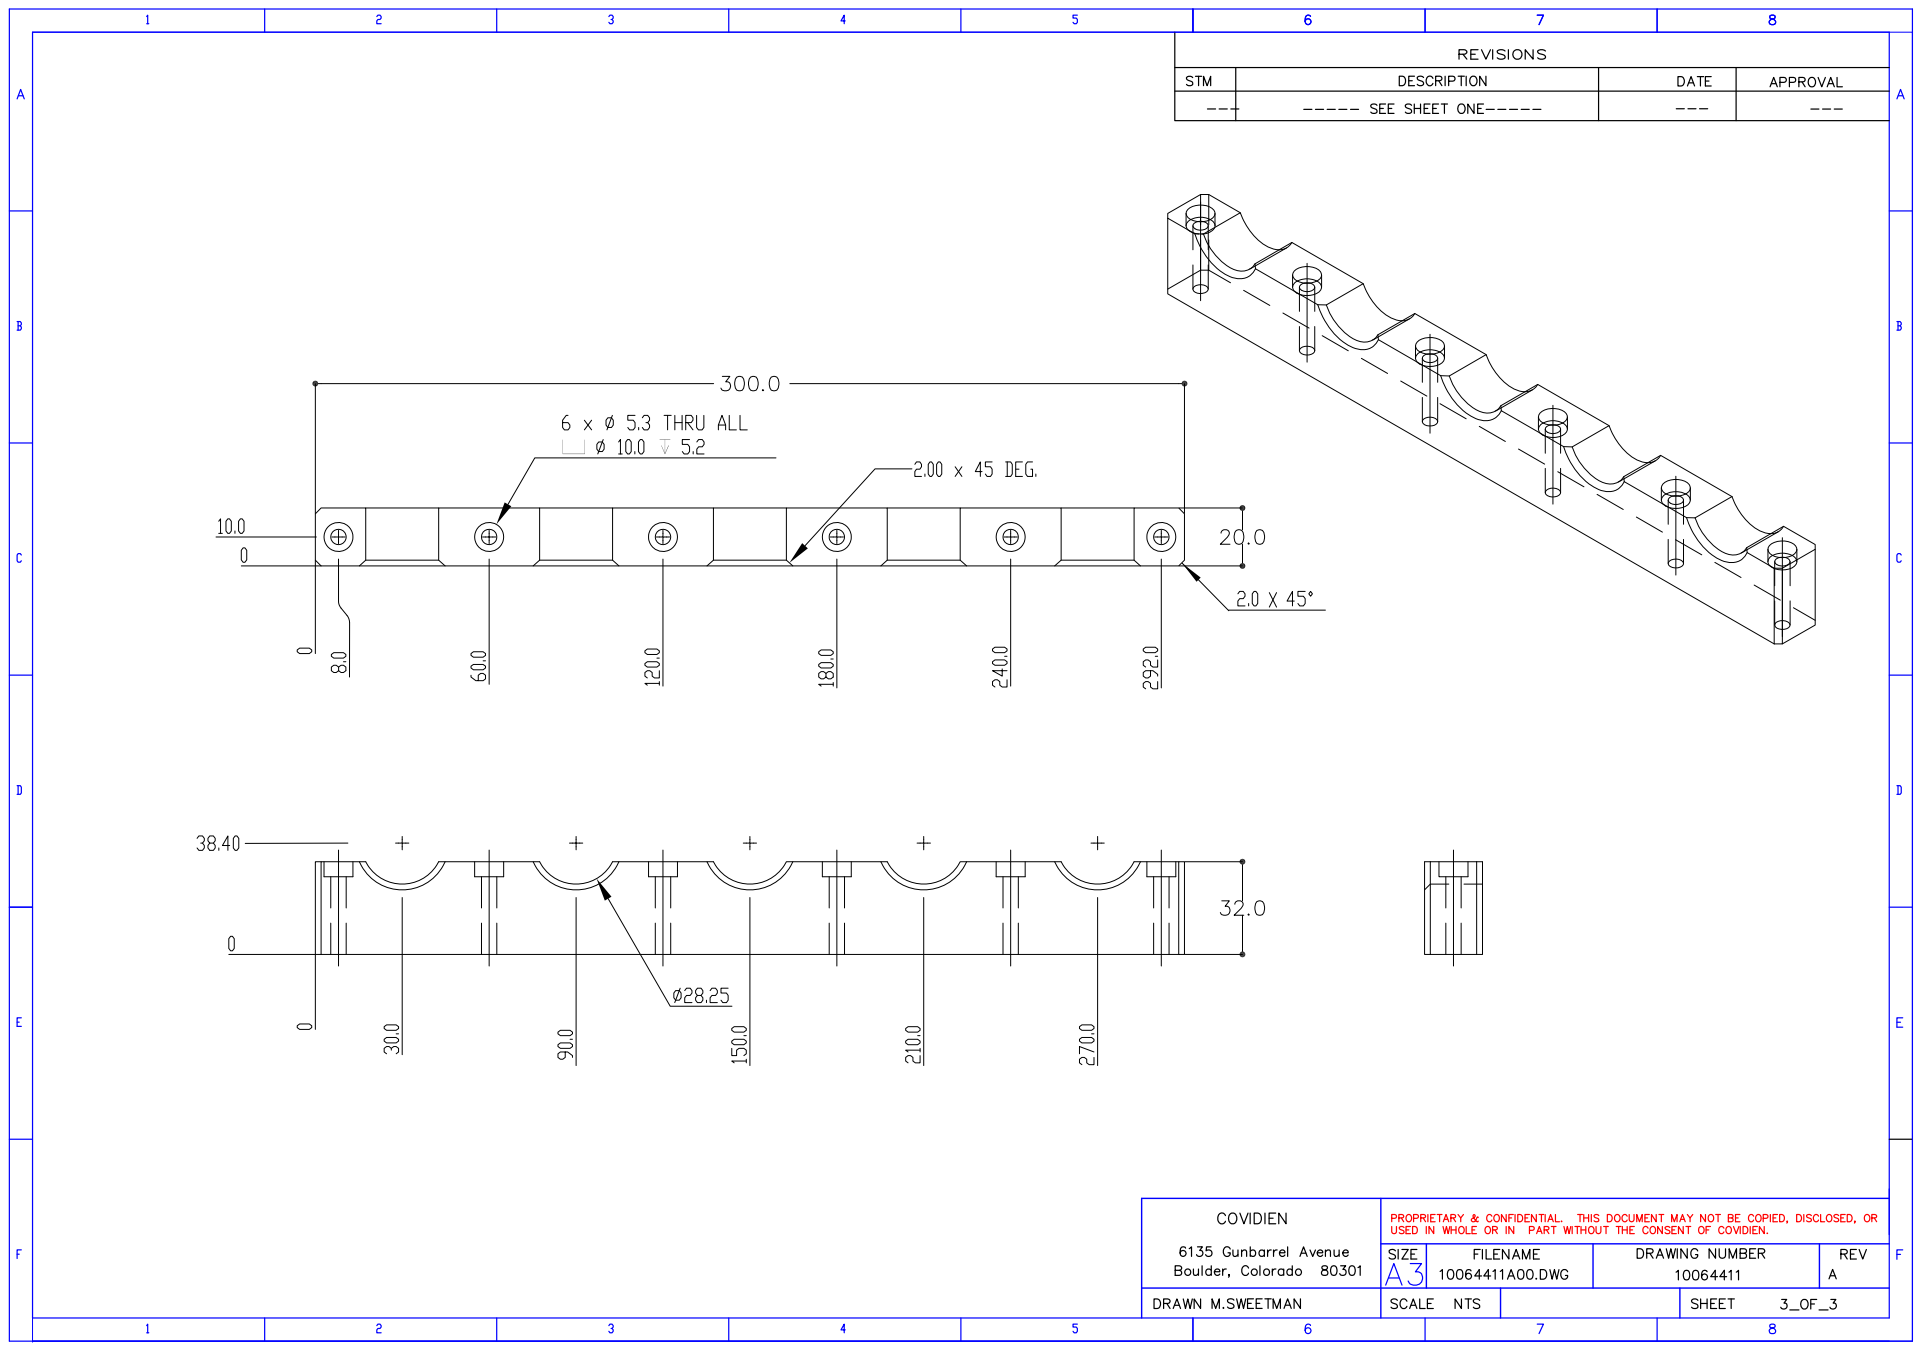
[picture p94: page 3]
