FlyingRat/Medtronic-PB560/Mechanical Part Drawings/5094000/5094000N00.pdf

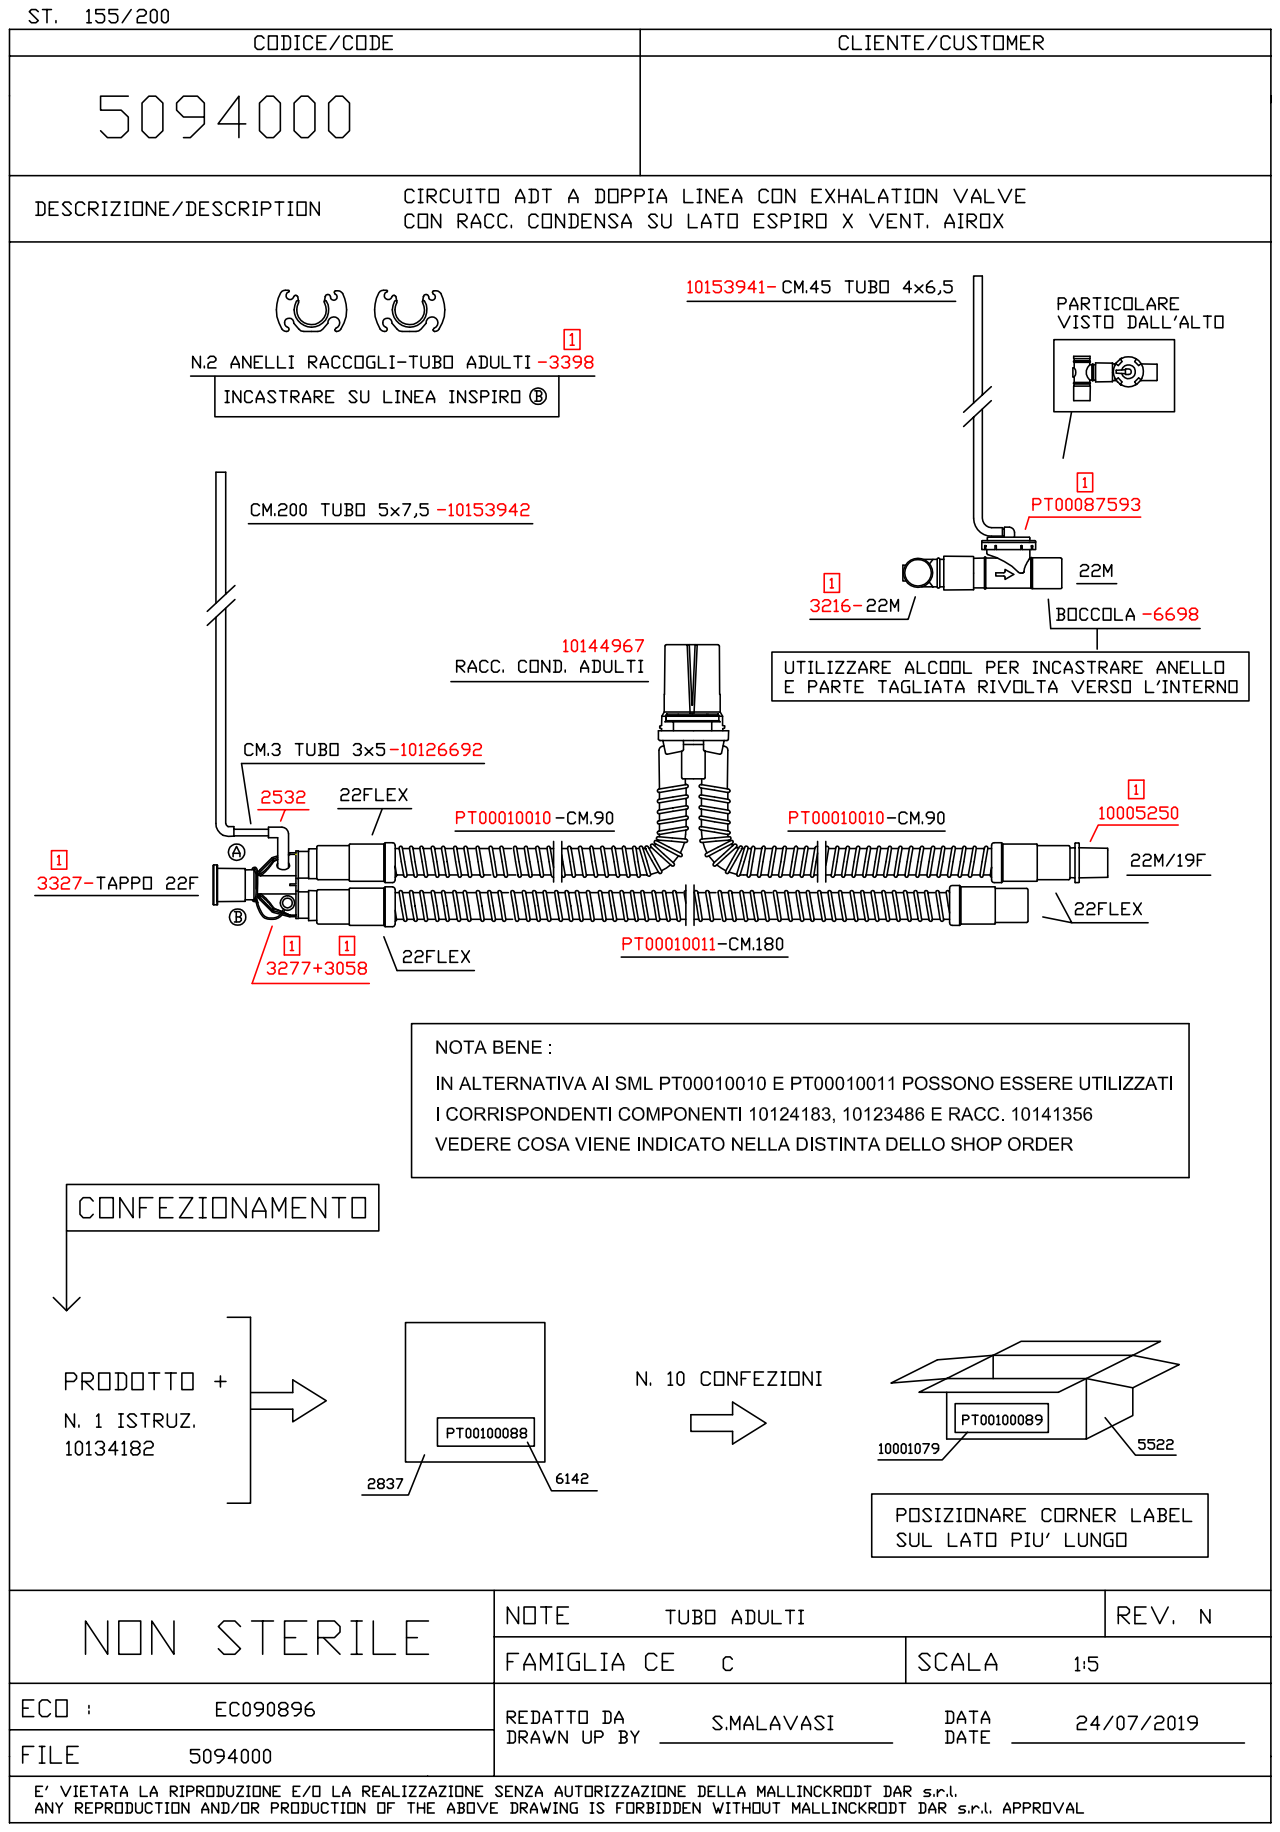
[picture p95: page 1]
