FlyingRat/Medtronic-PB560/Electronic PCBAs/10096315_Blower_Driver_PCBA/PCB/10096505A00.pdf

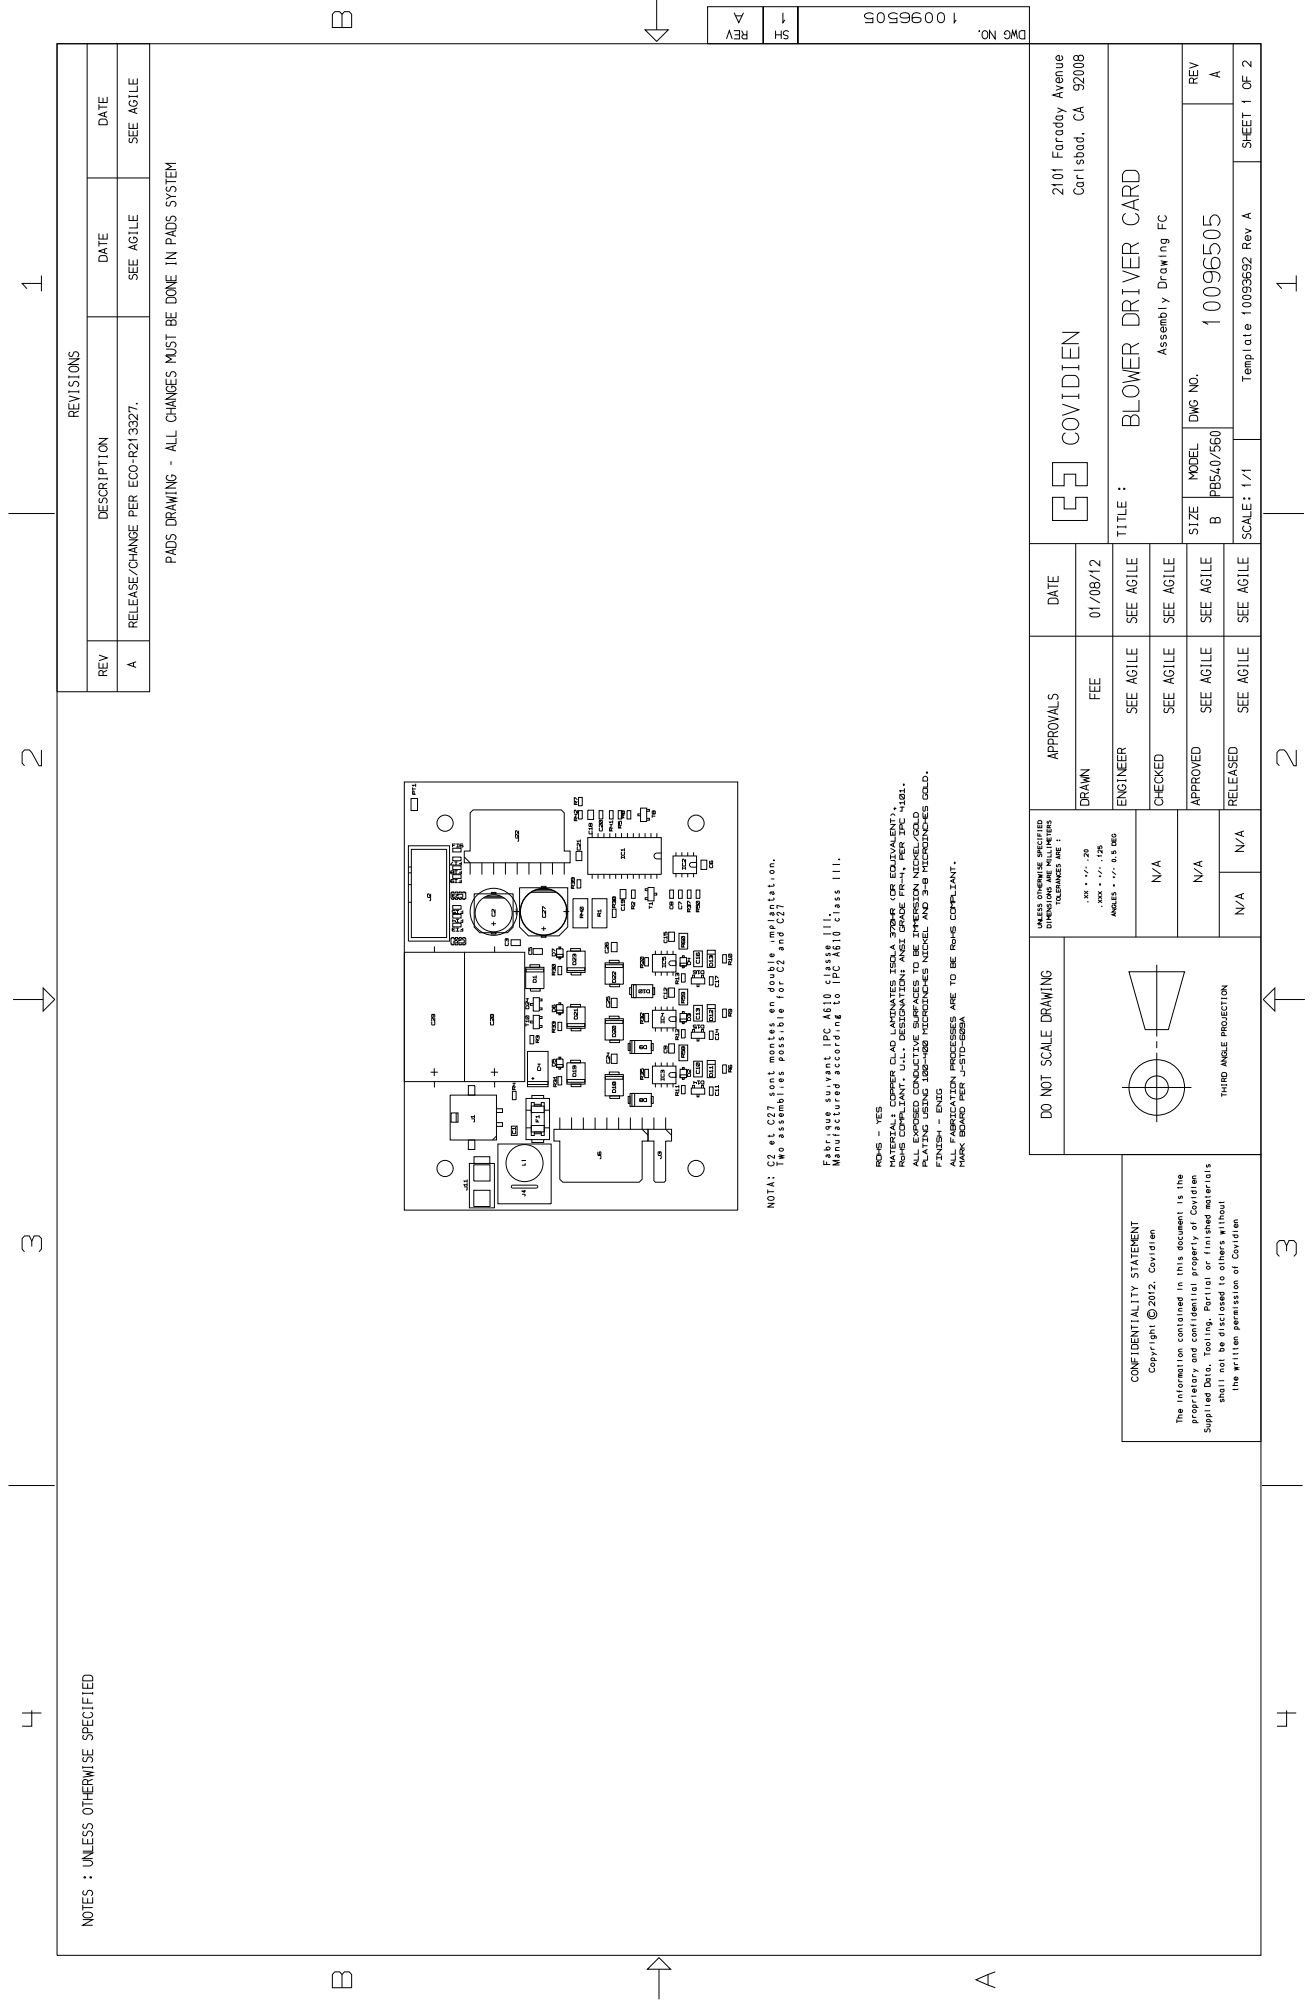
[picture p96: page 1]

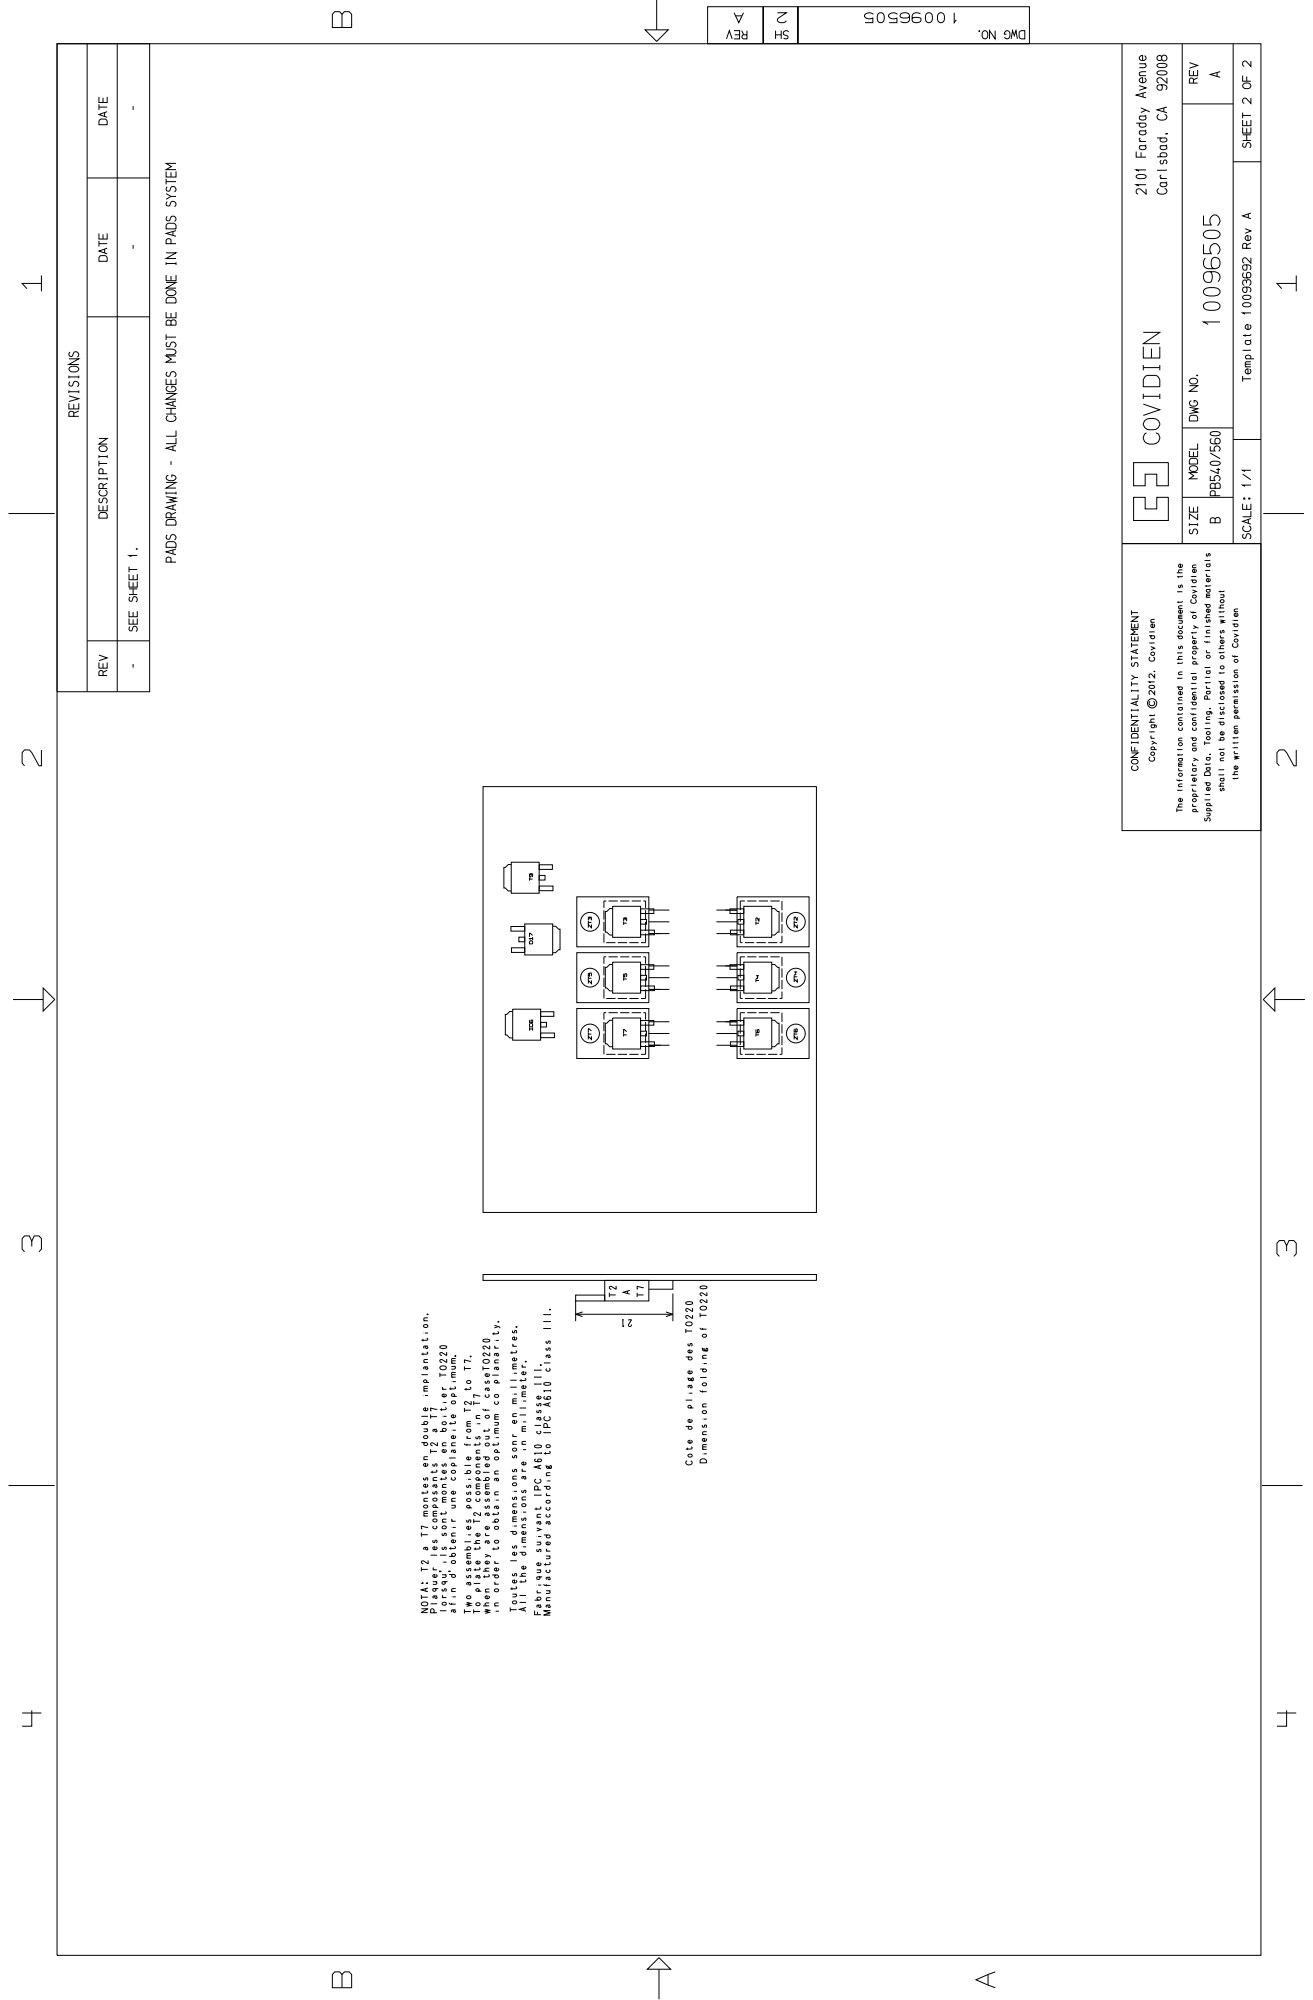
[picture p97: page 2]
