FlyingRat/Medtronic-PB560/Electronic PCBAs/10096510_Battery_Connection_PCBA/PCB/10096506A00.pdf

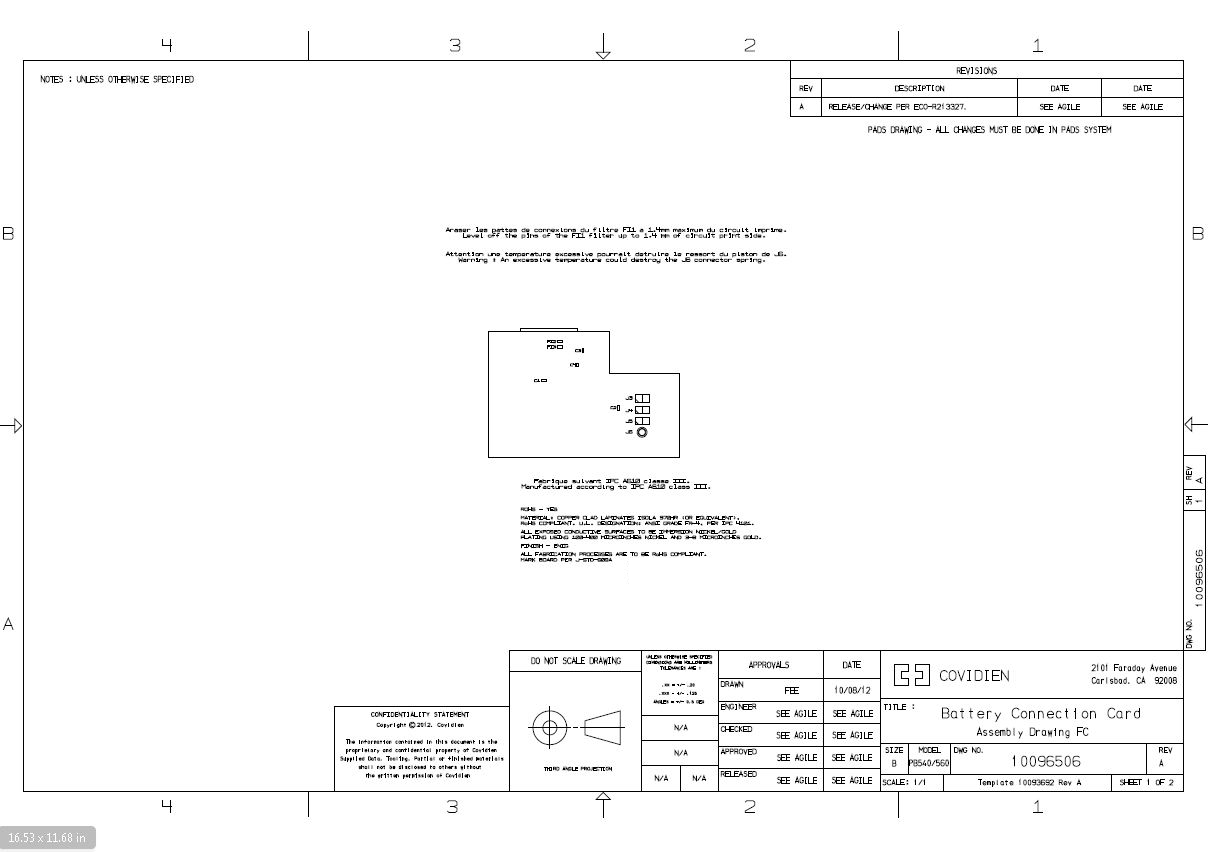
[picture p98: page 1]
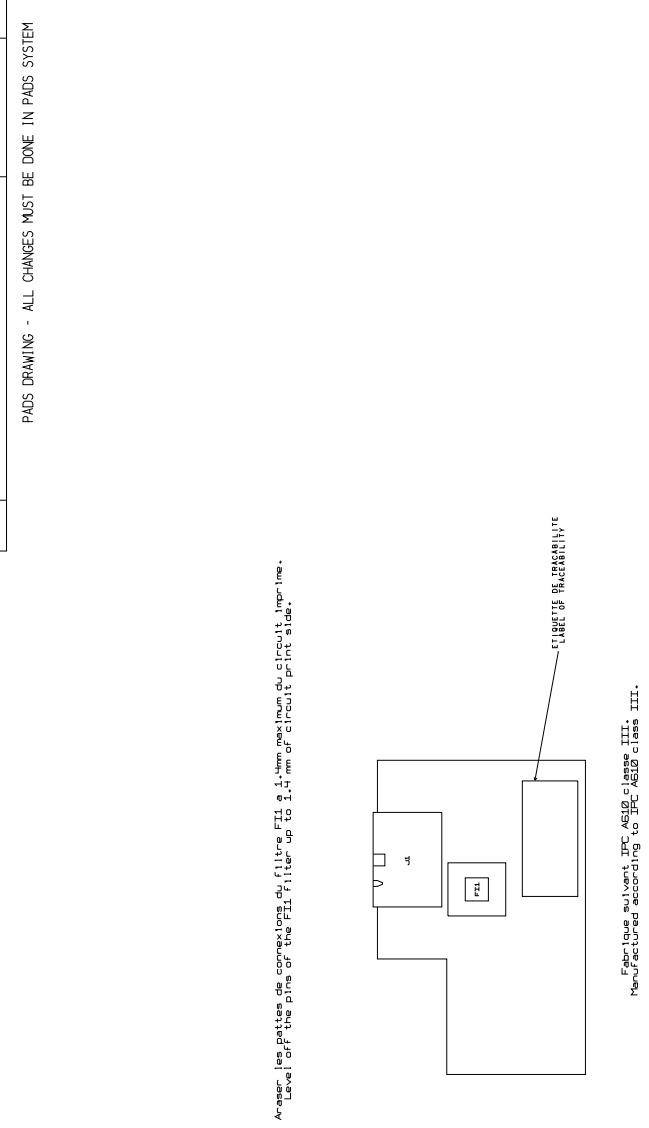
[picture p99: page 2]
