FlyingRat/Medtronic-PB560/Electronic PCBAs/GR106768_Buzzer_PCBA/SCH/10125624A00.pdf

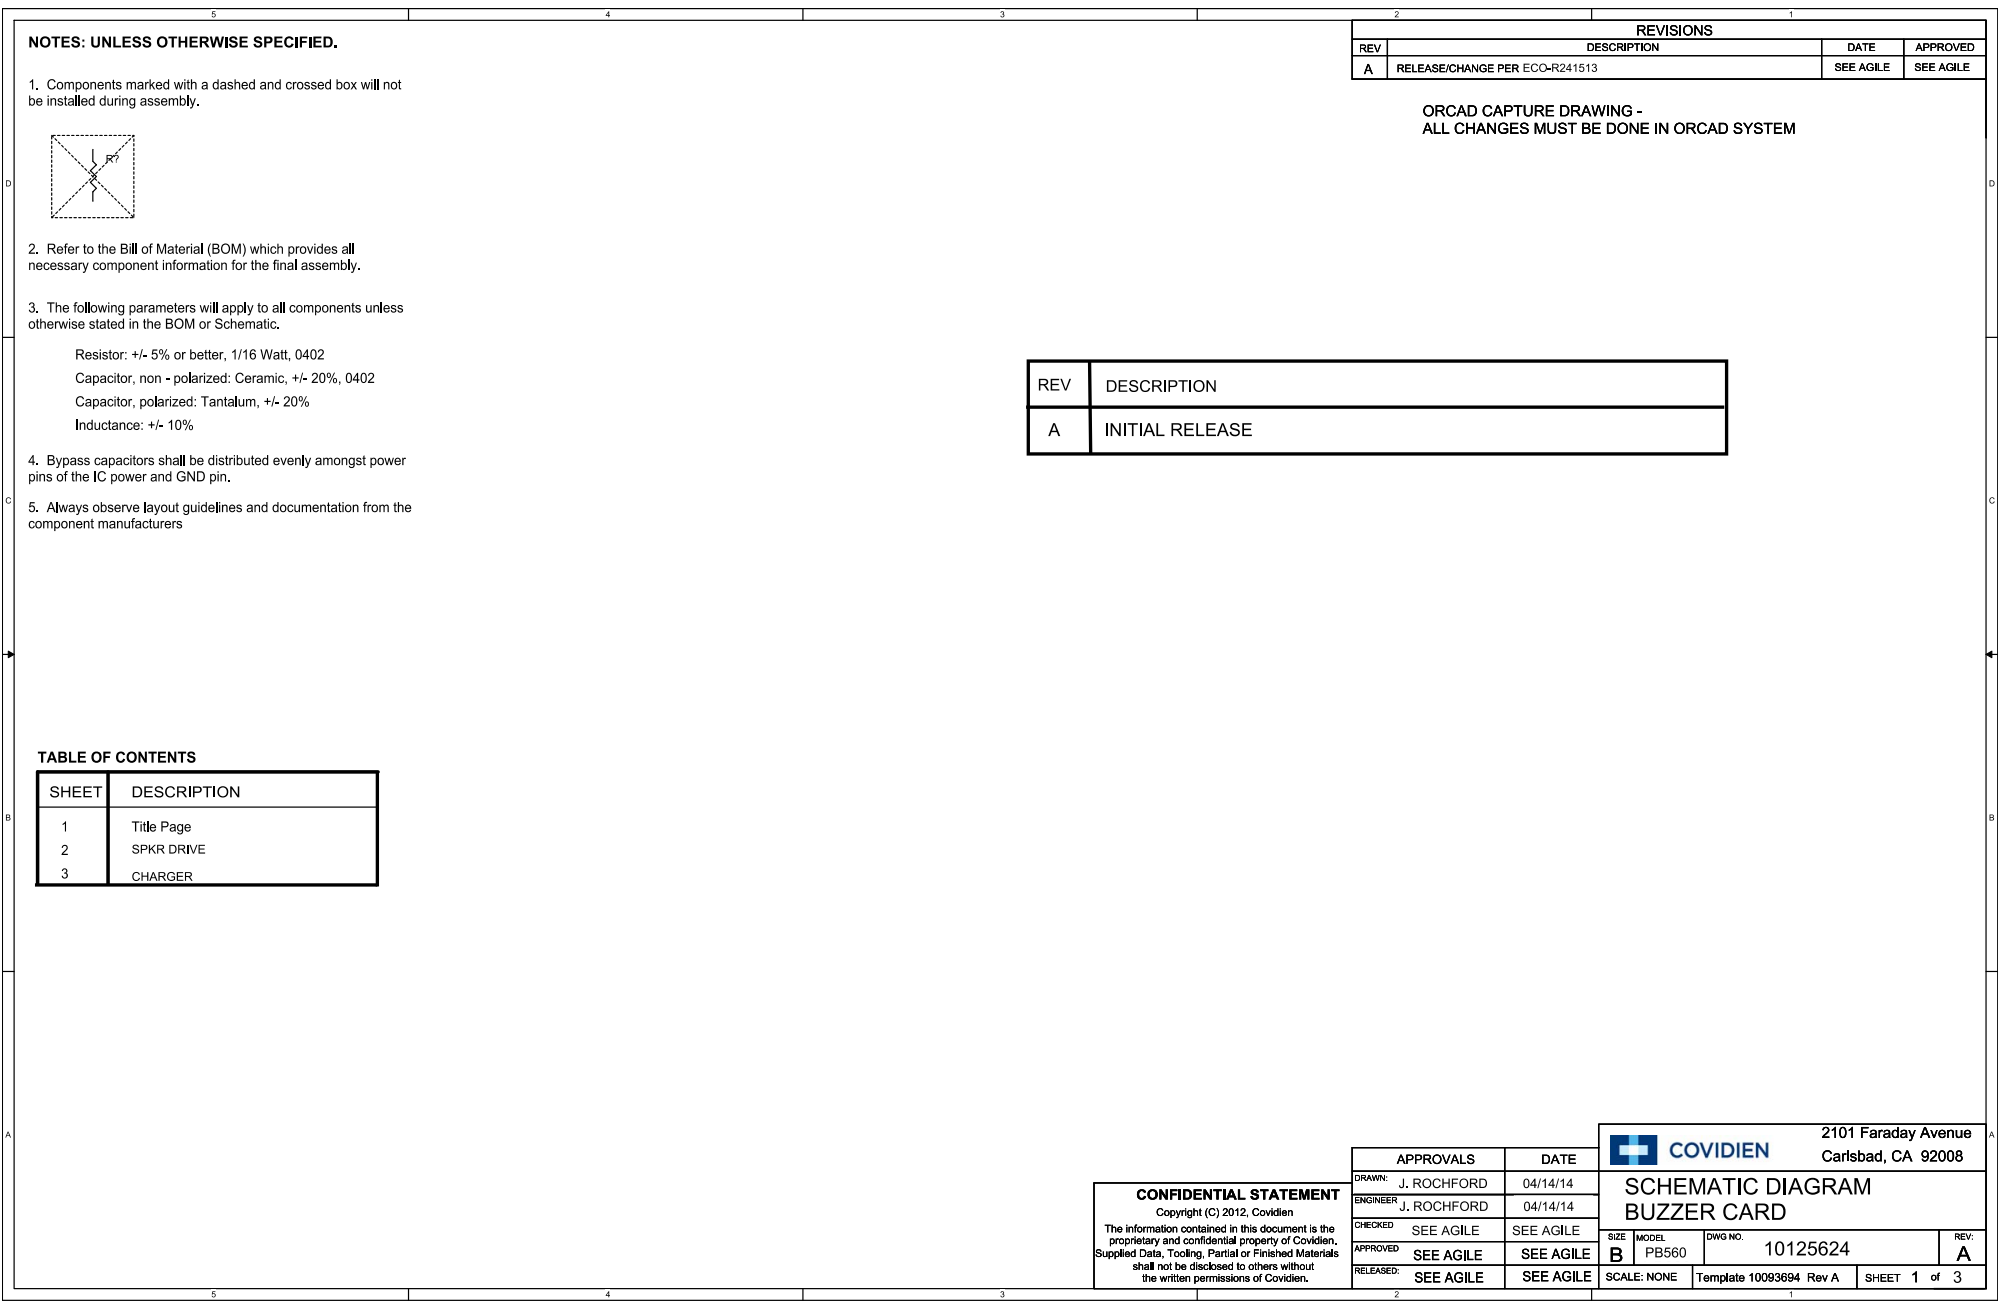
[picture p100: page 1]

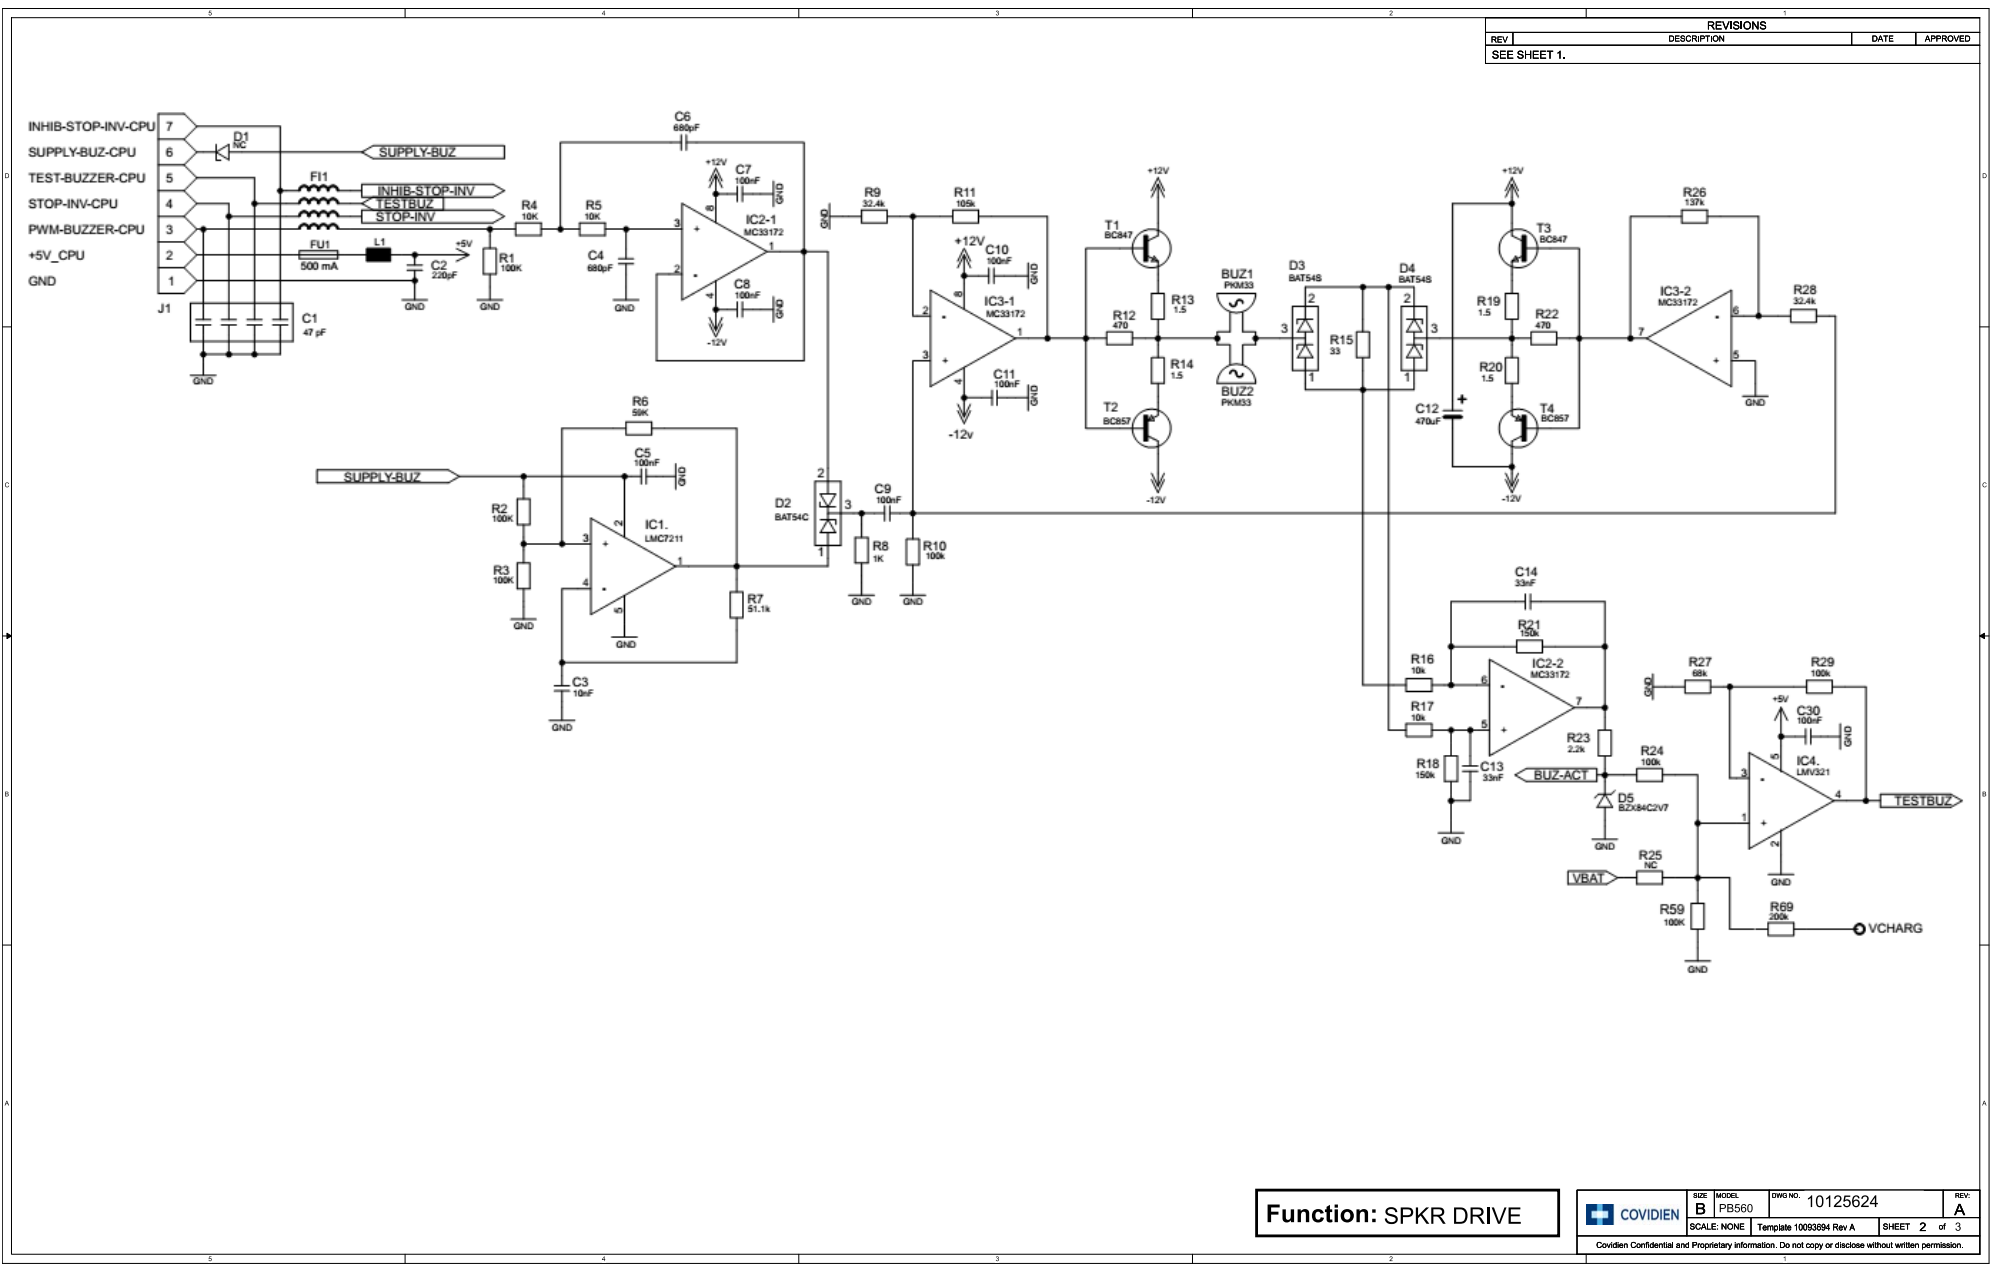
[picture p101: page 2]

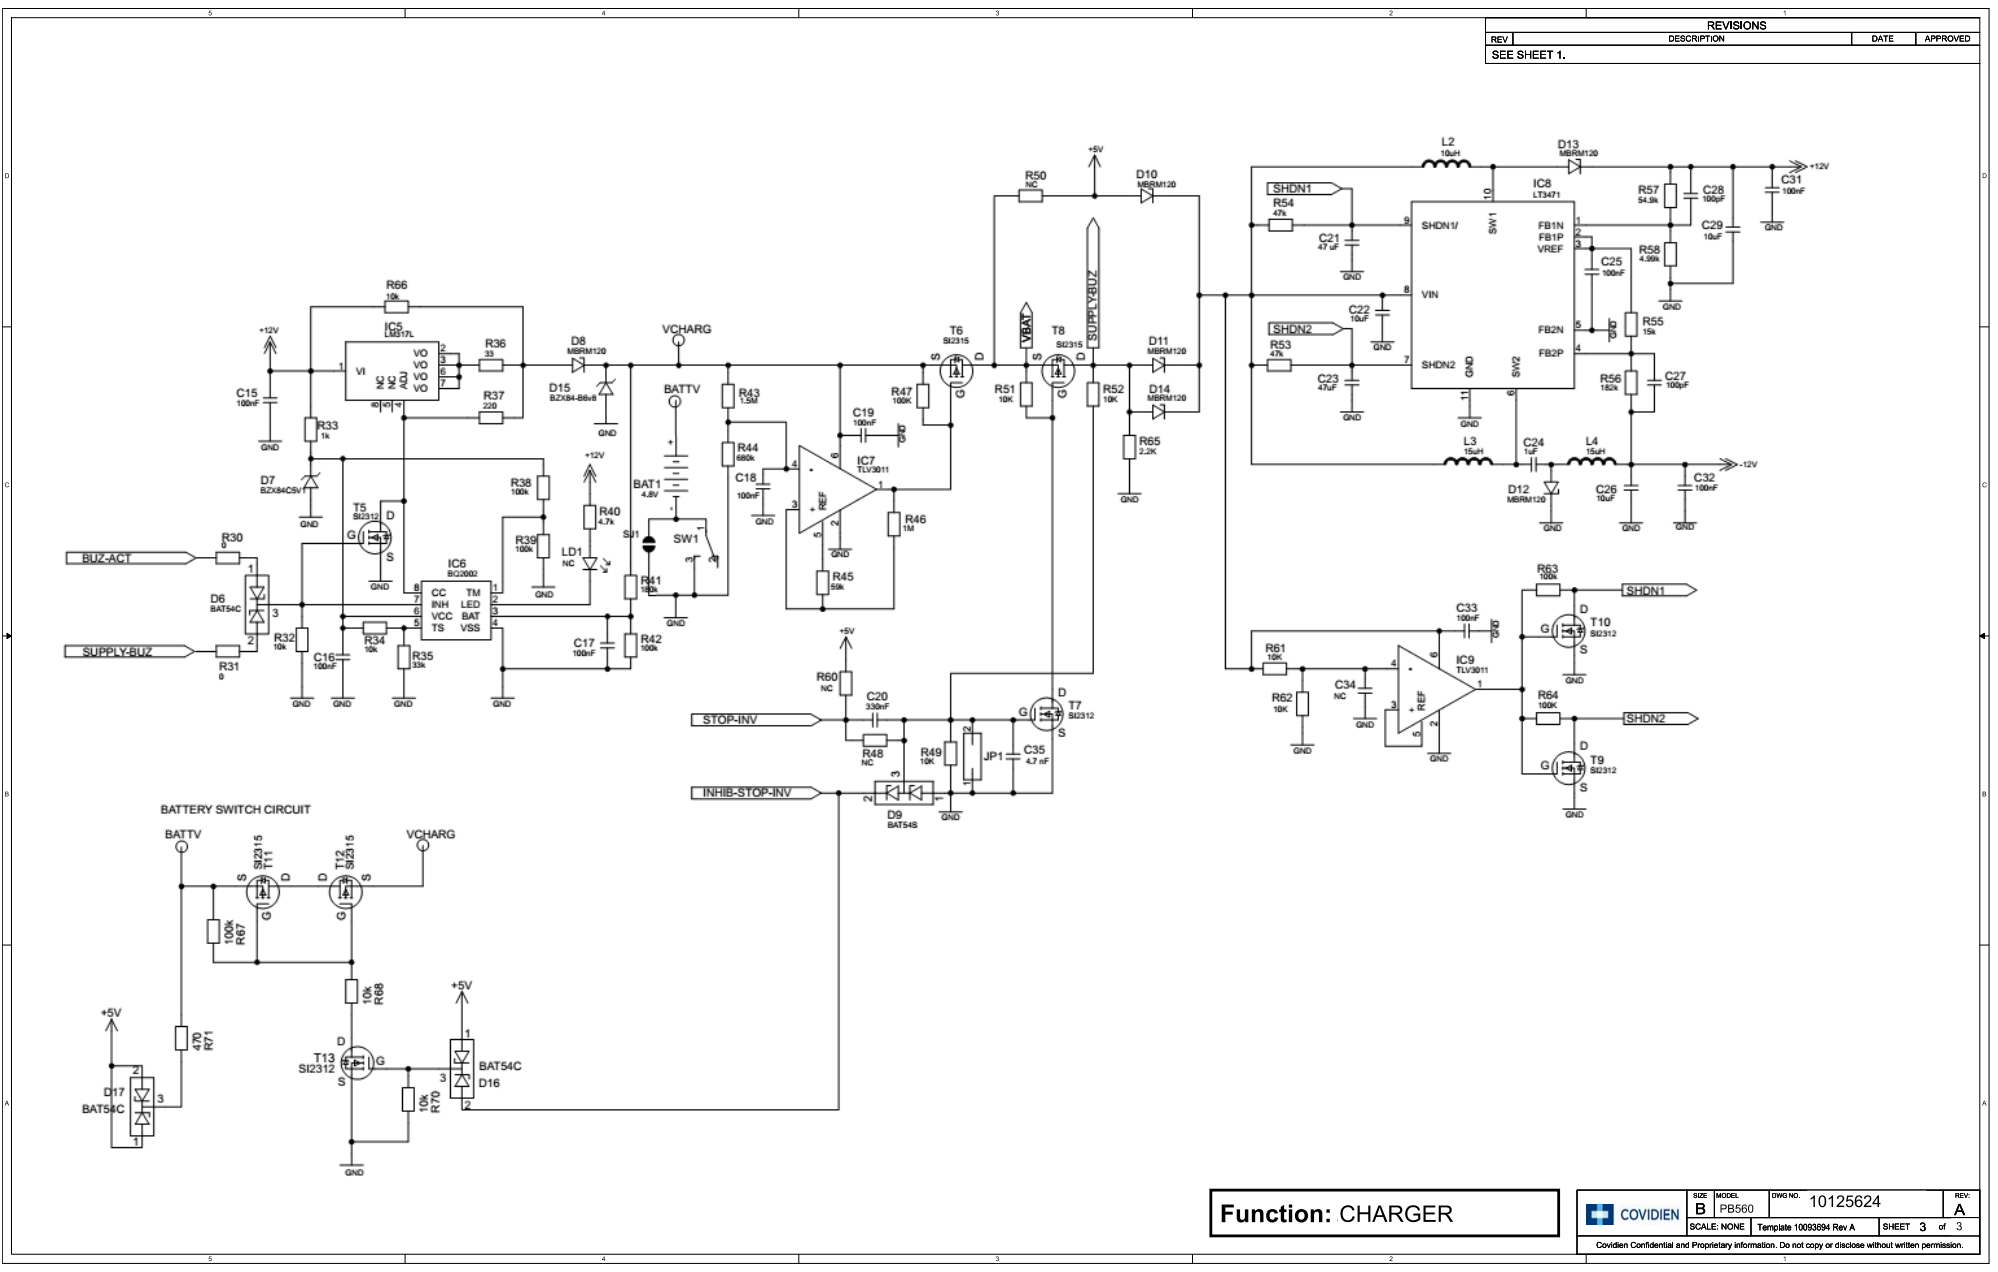
[picture p102: page 3]
