FlyingRat/Medtronic-PB560/Electronic PCBAs/GR106769_CPU_PCBA/SCH/10125623A00.pdf

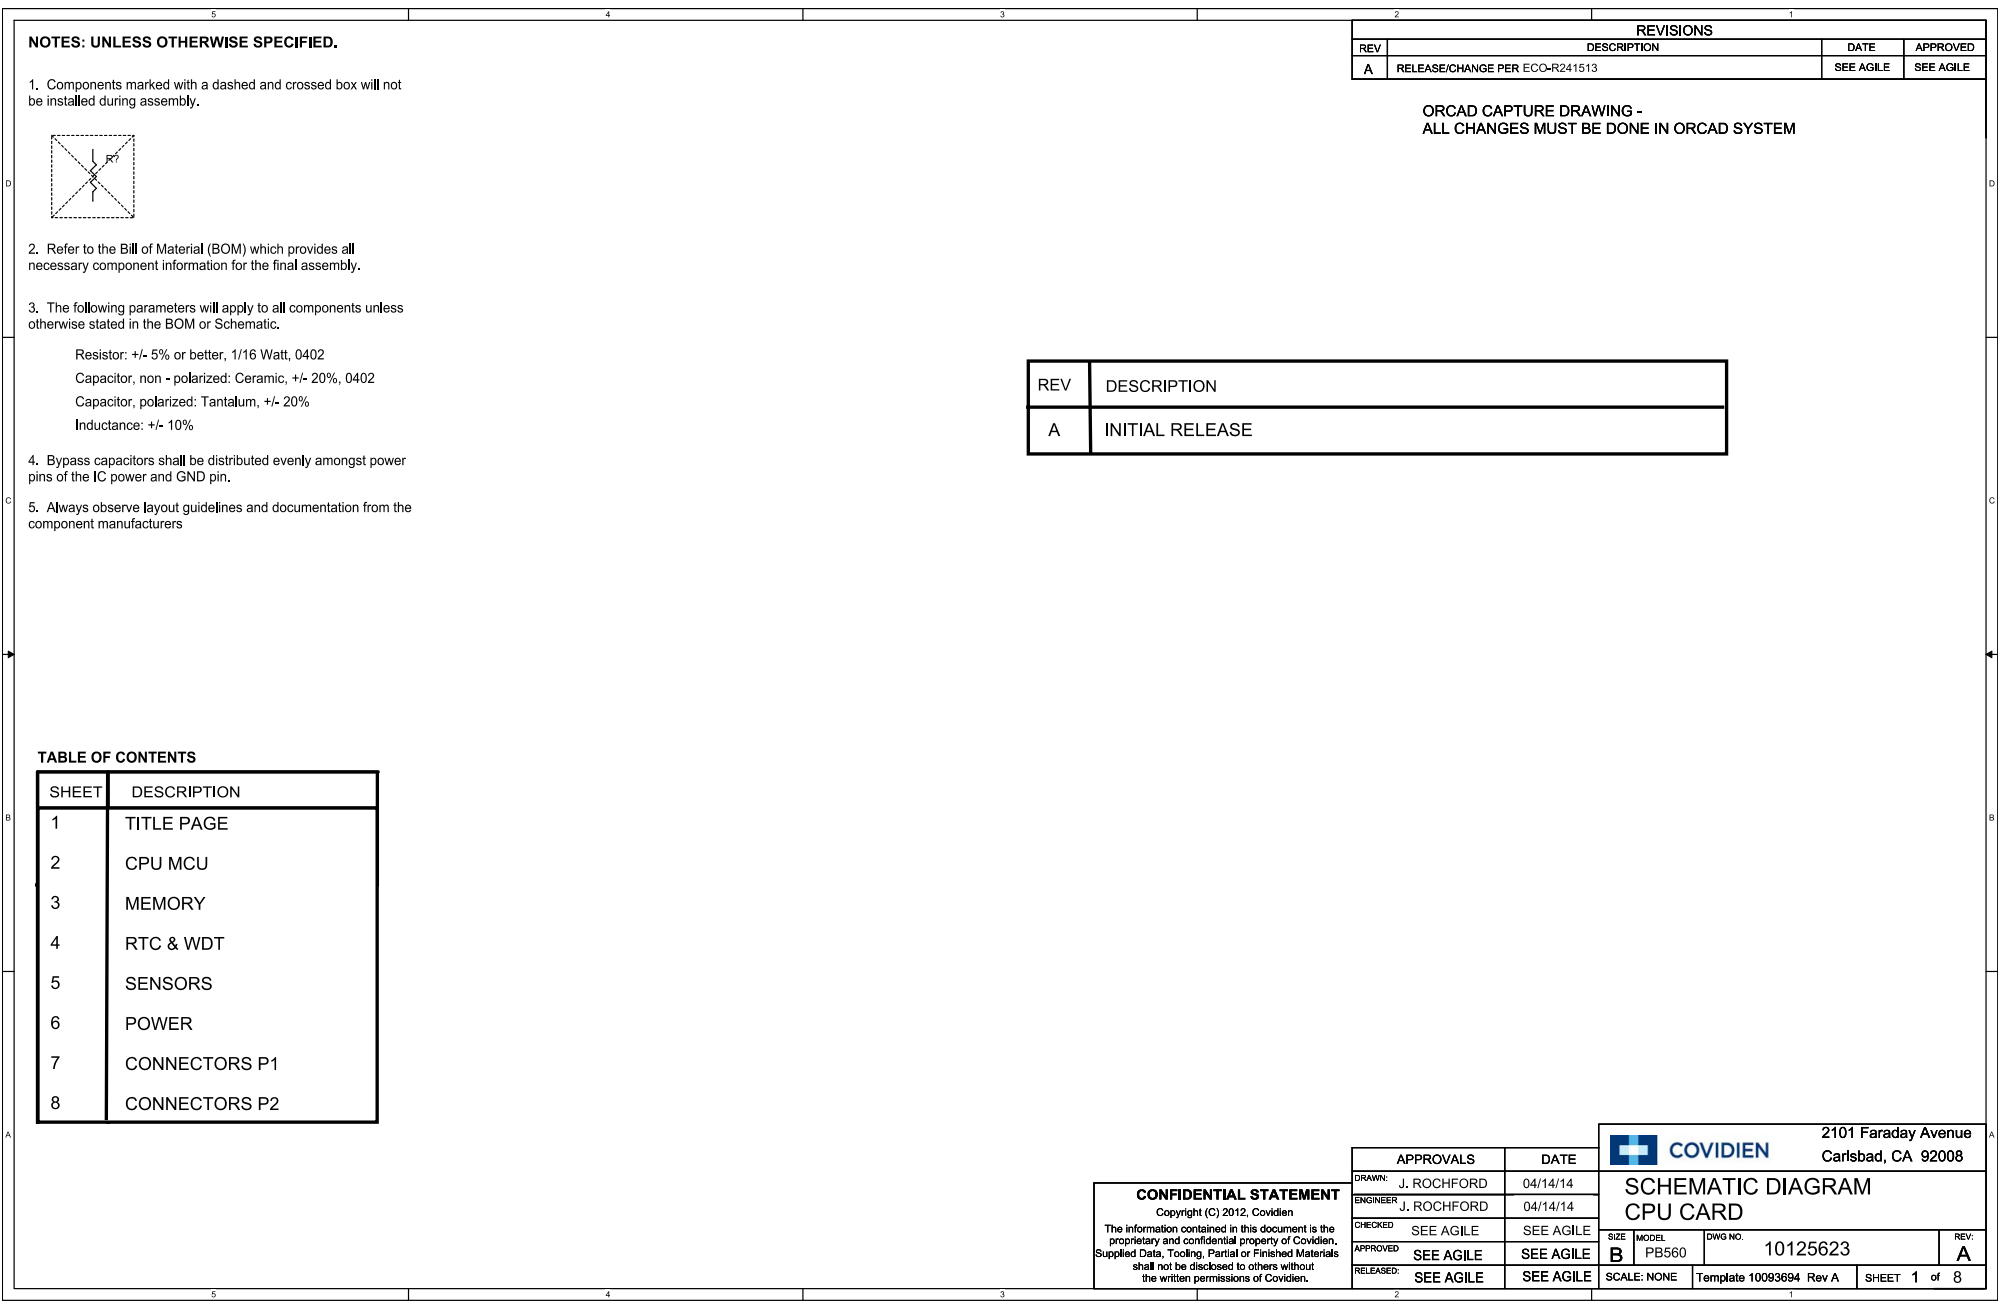
[picture p103: page 1]

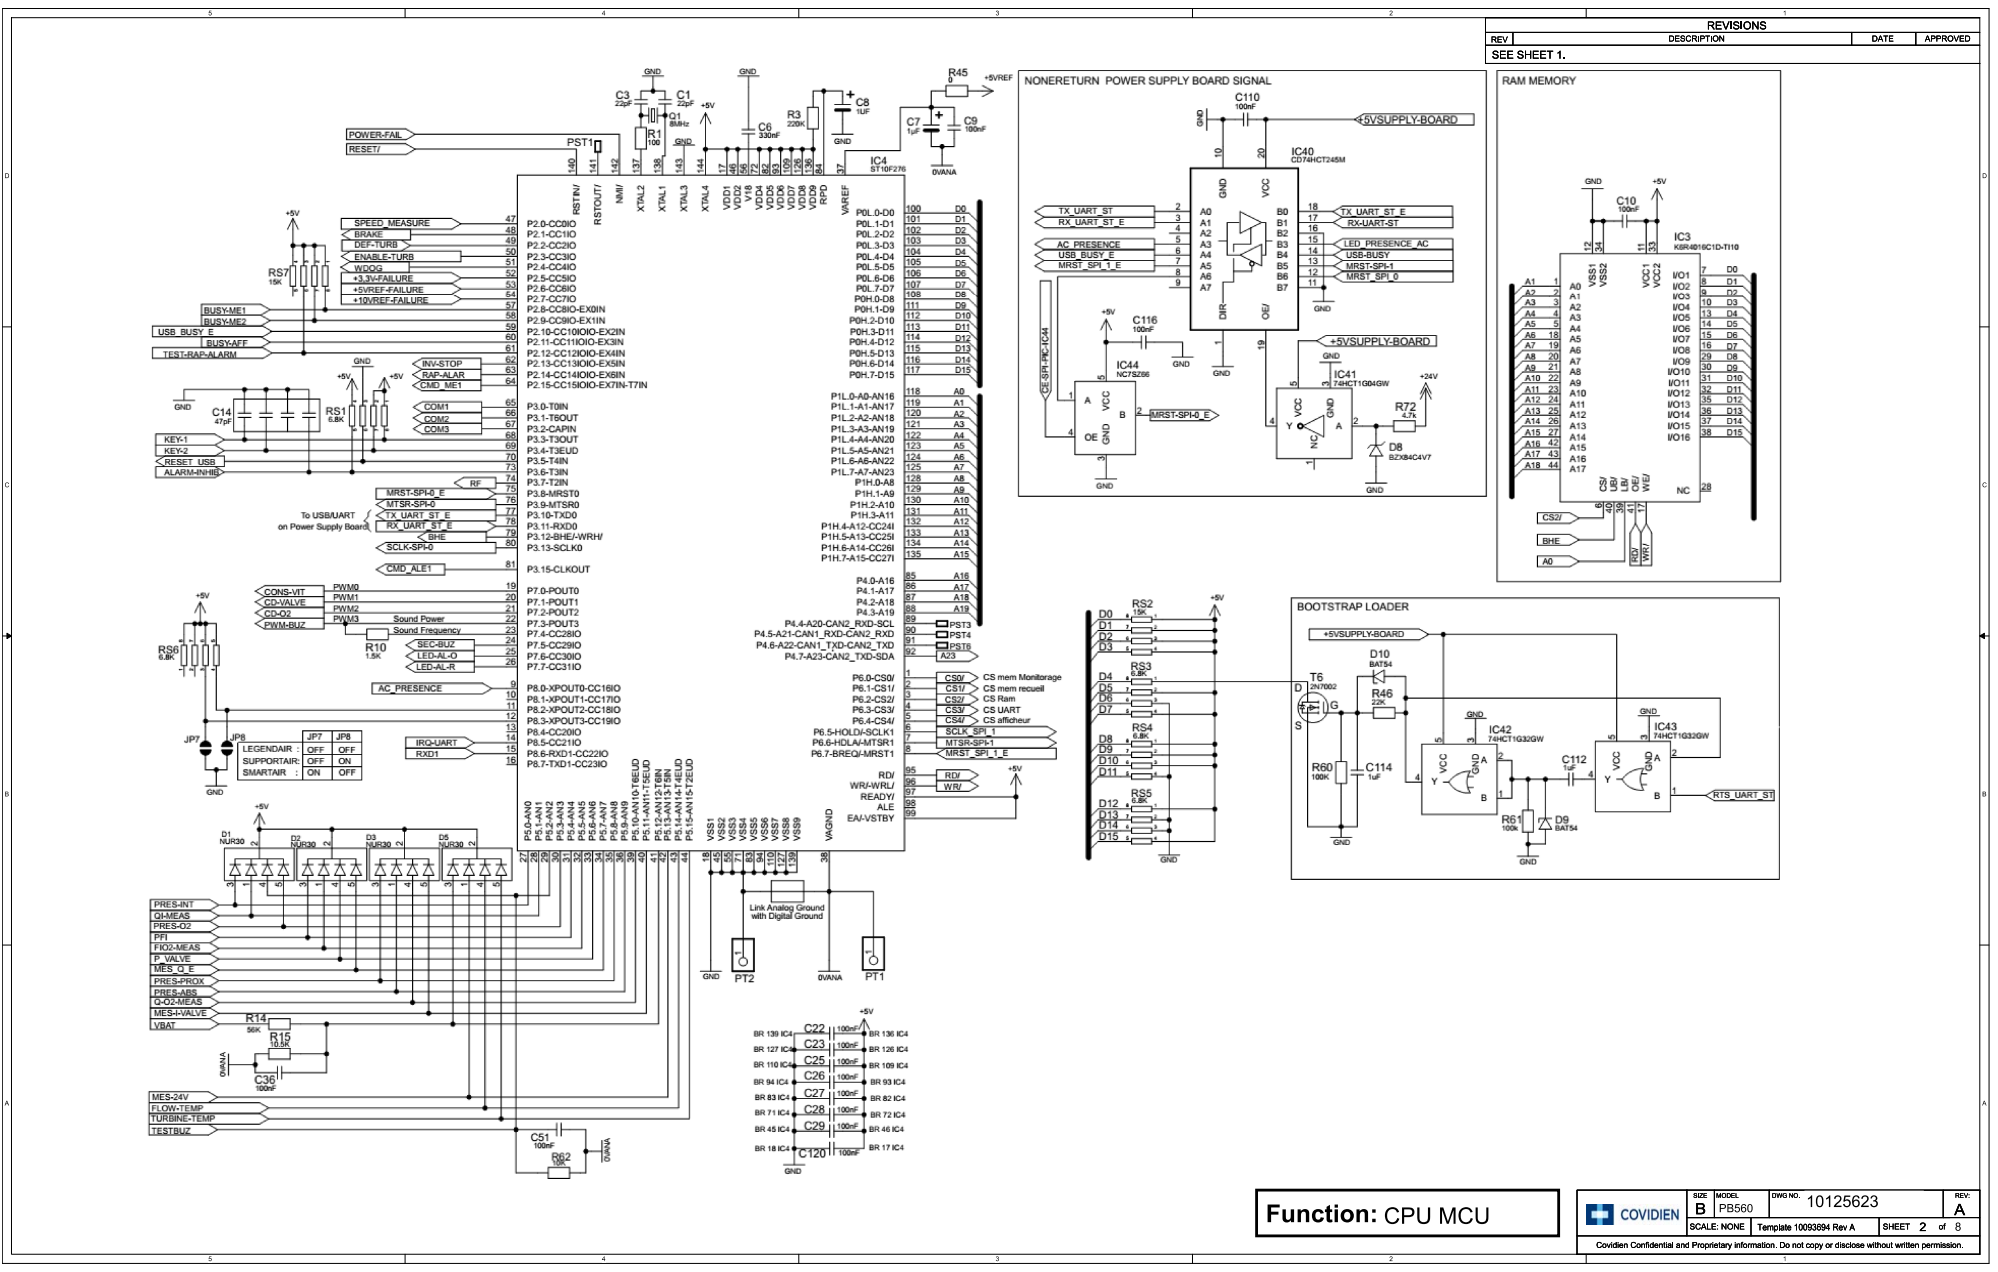
[picture p104: page 2]

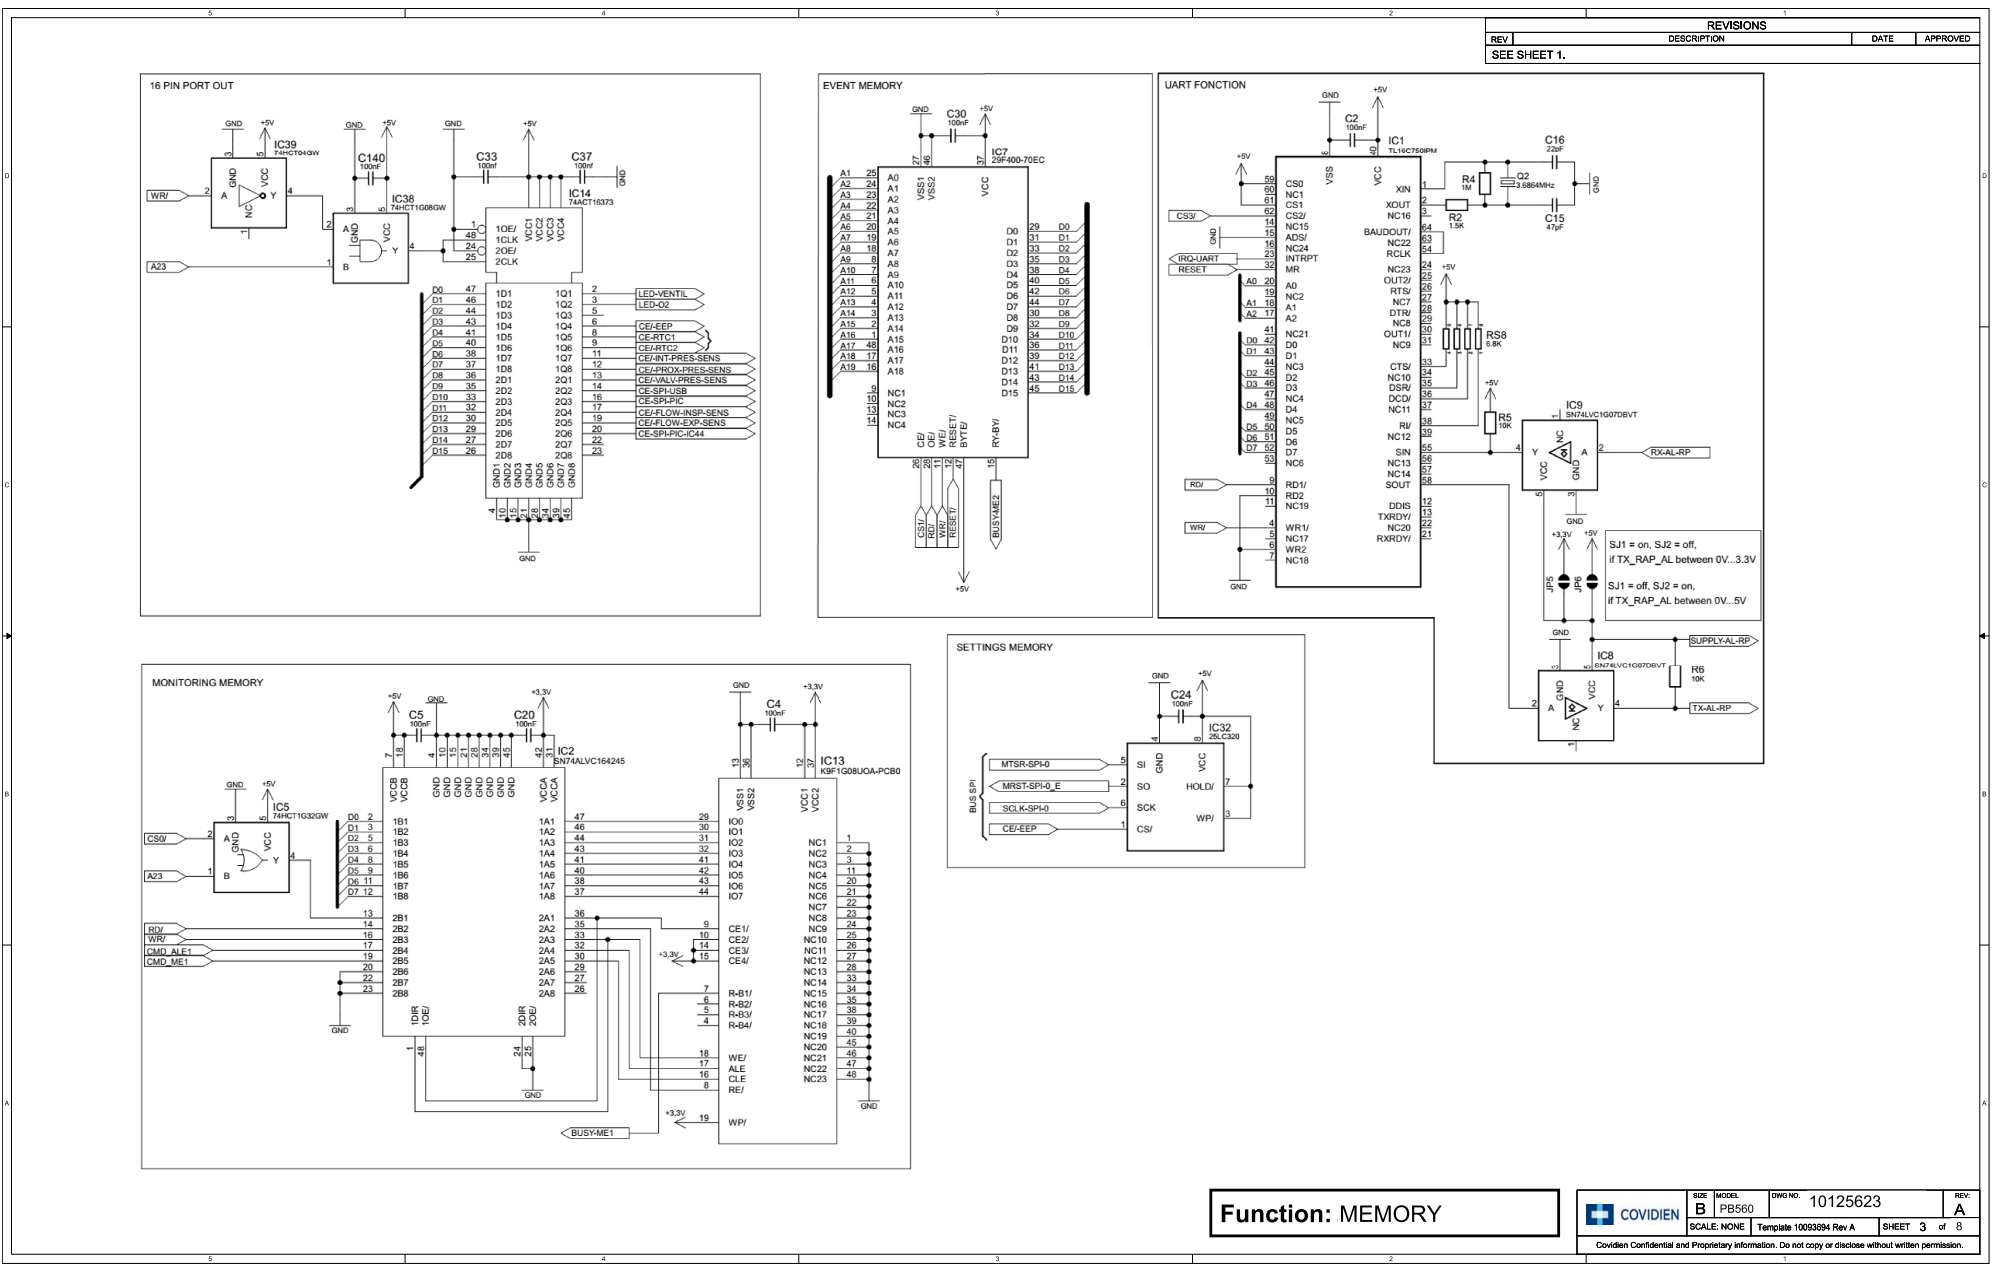
[picture p105: page 3]

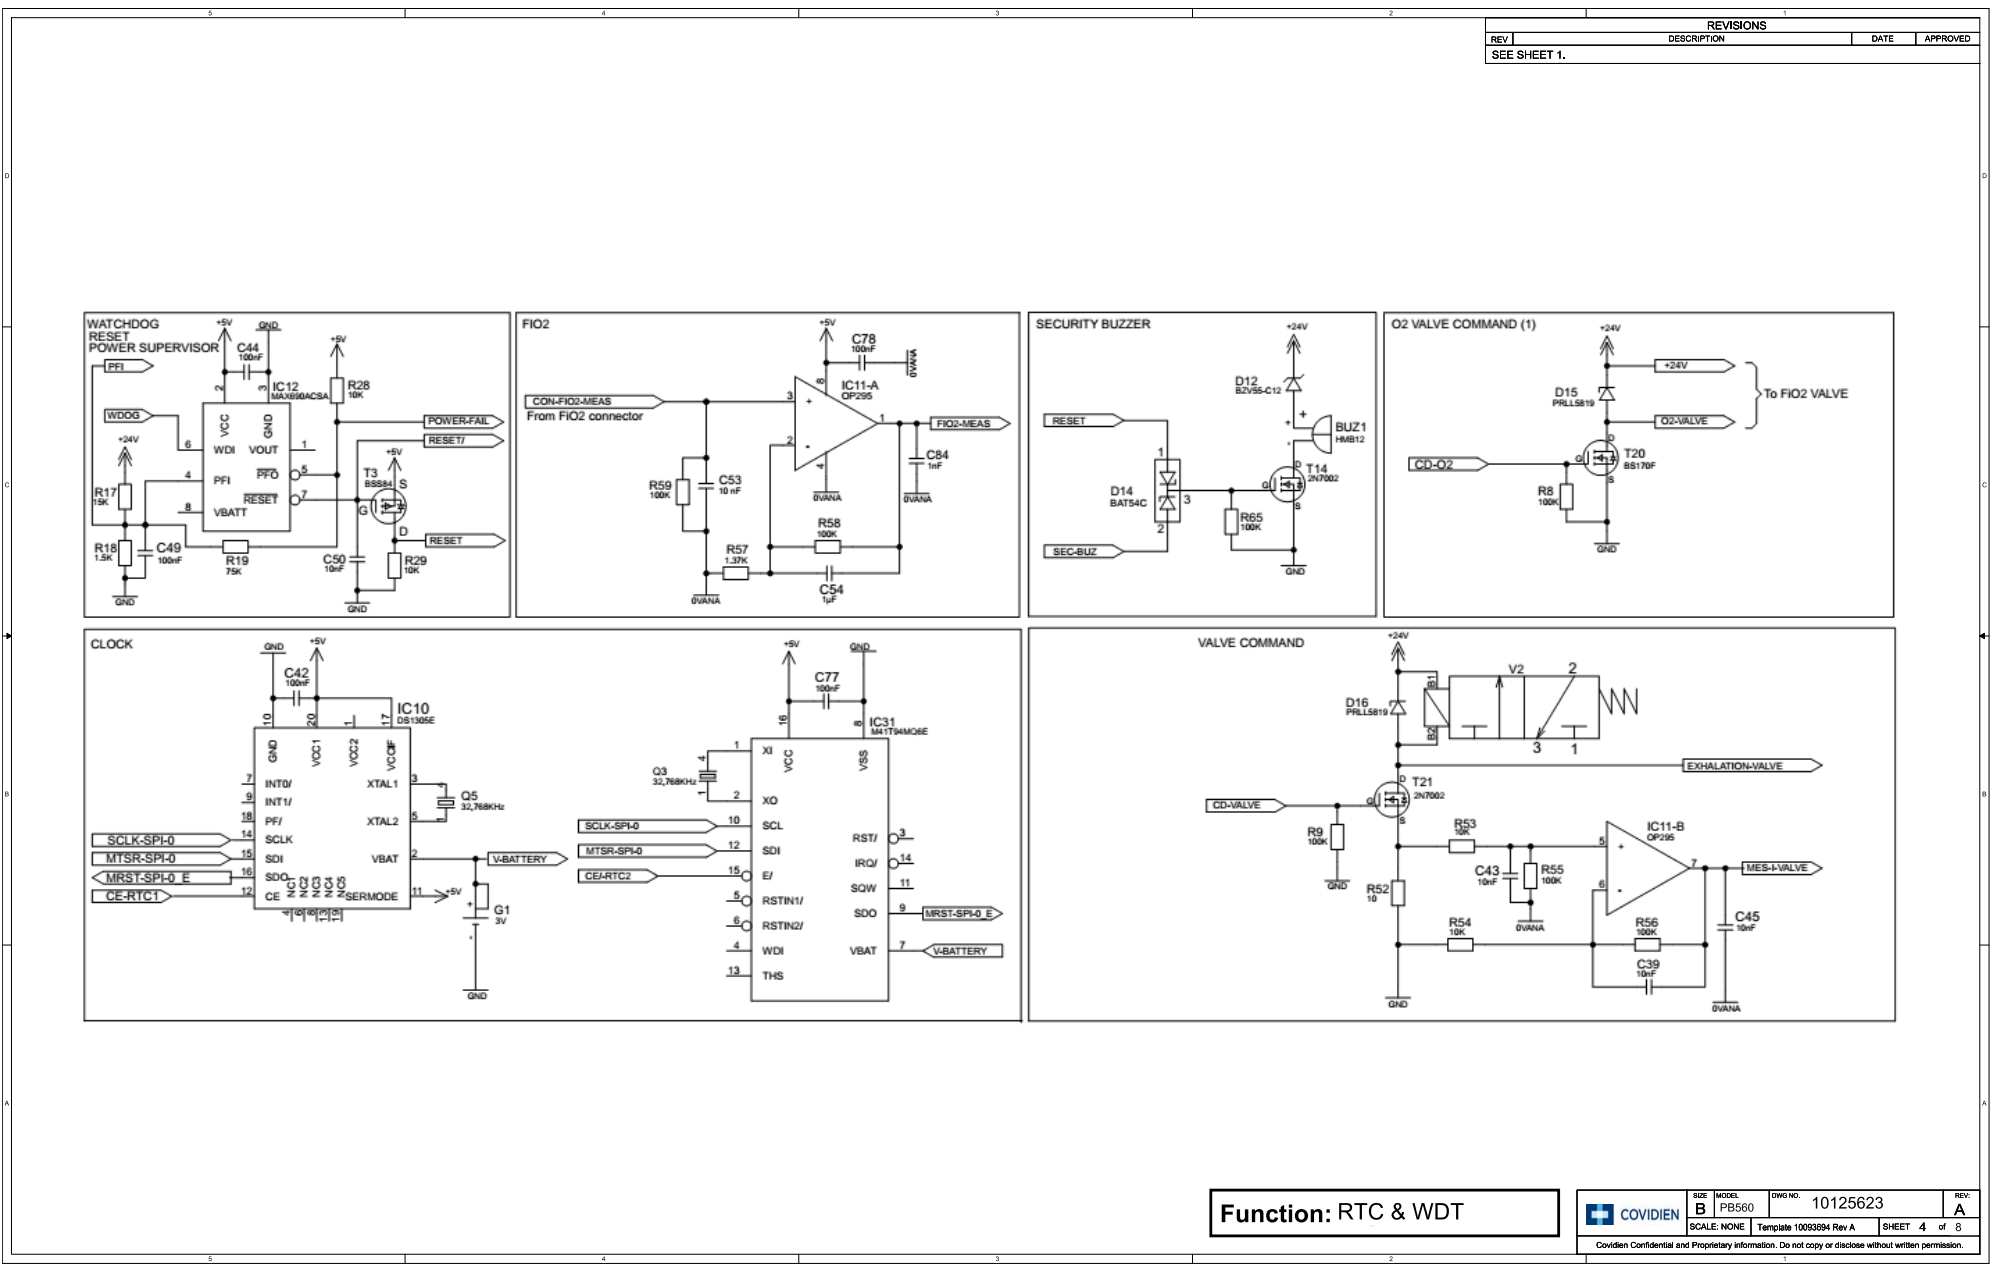
[picture p106: page 4]

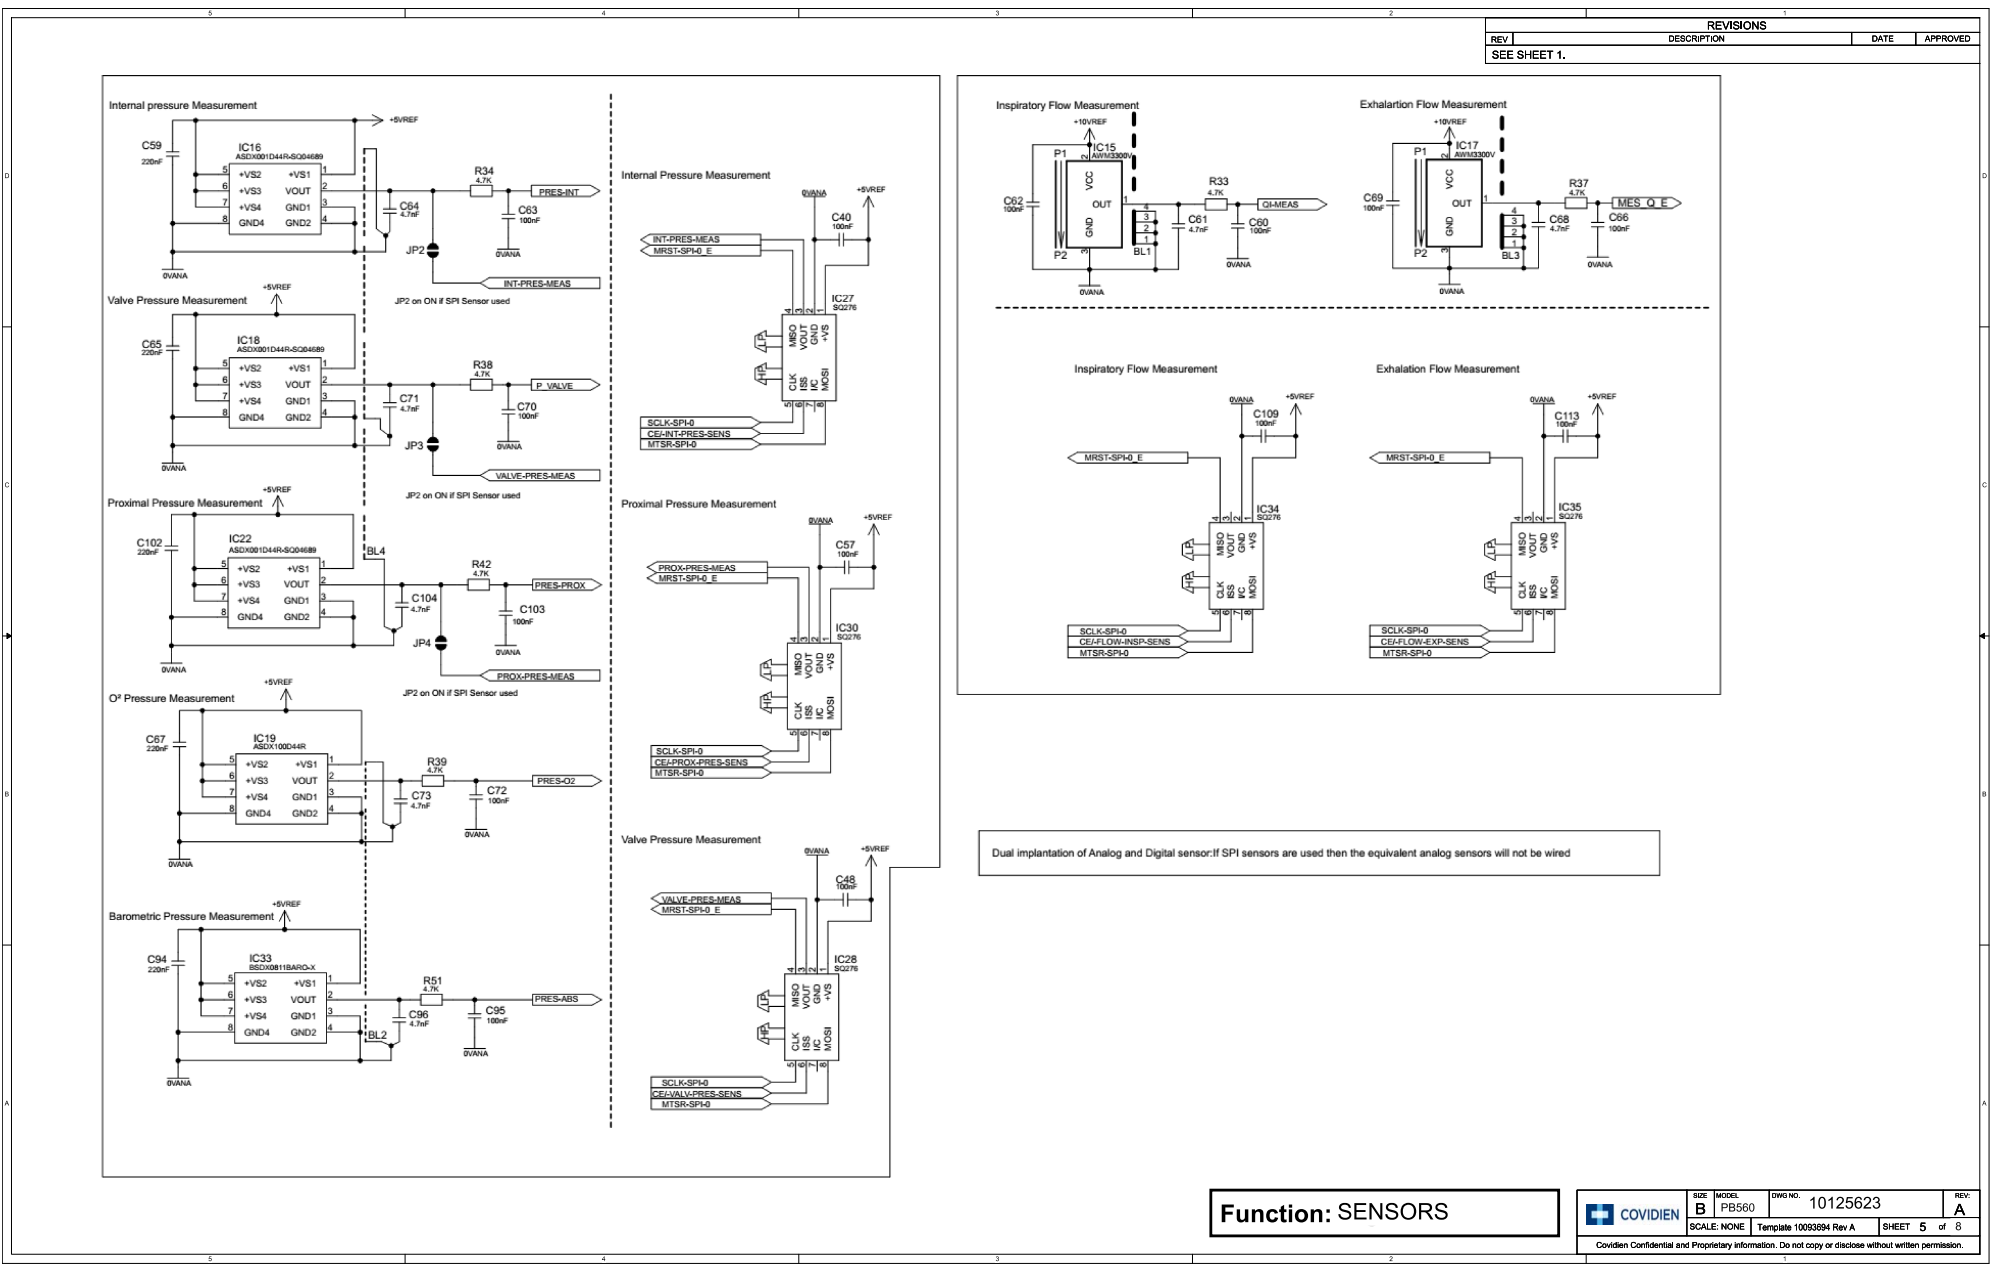
[picture p107: page 5]

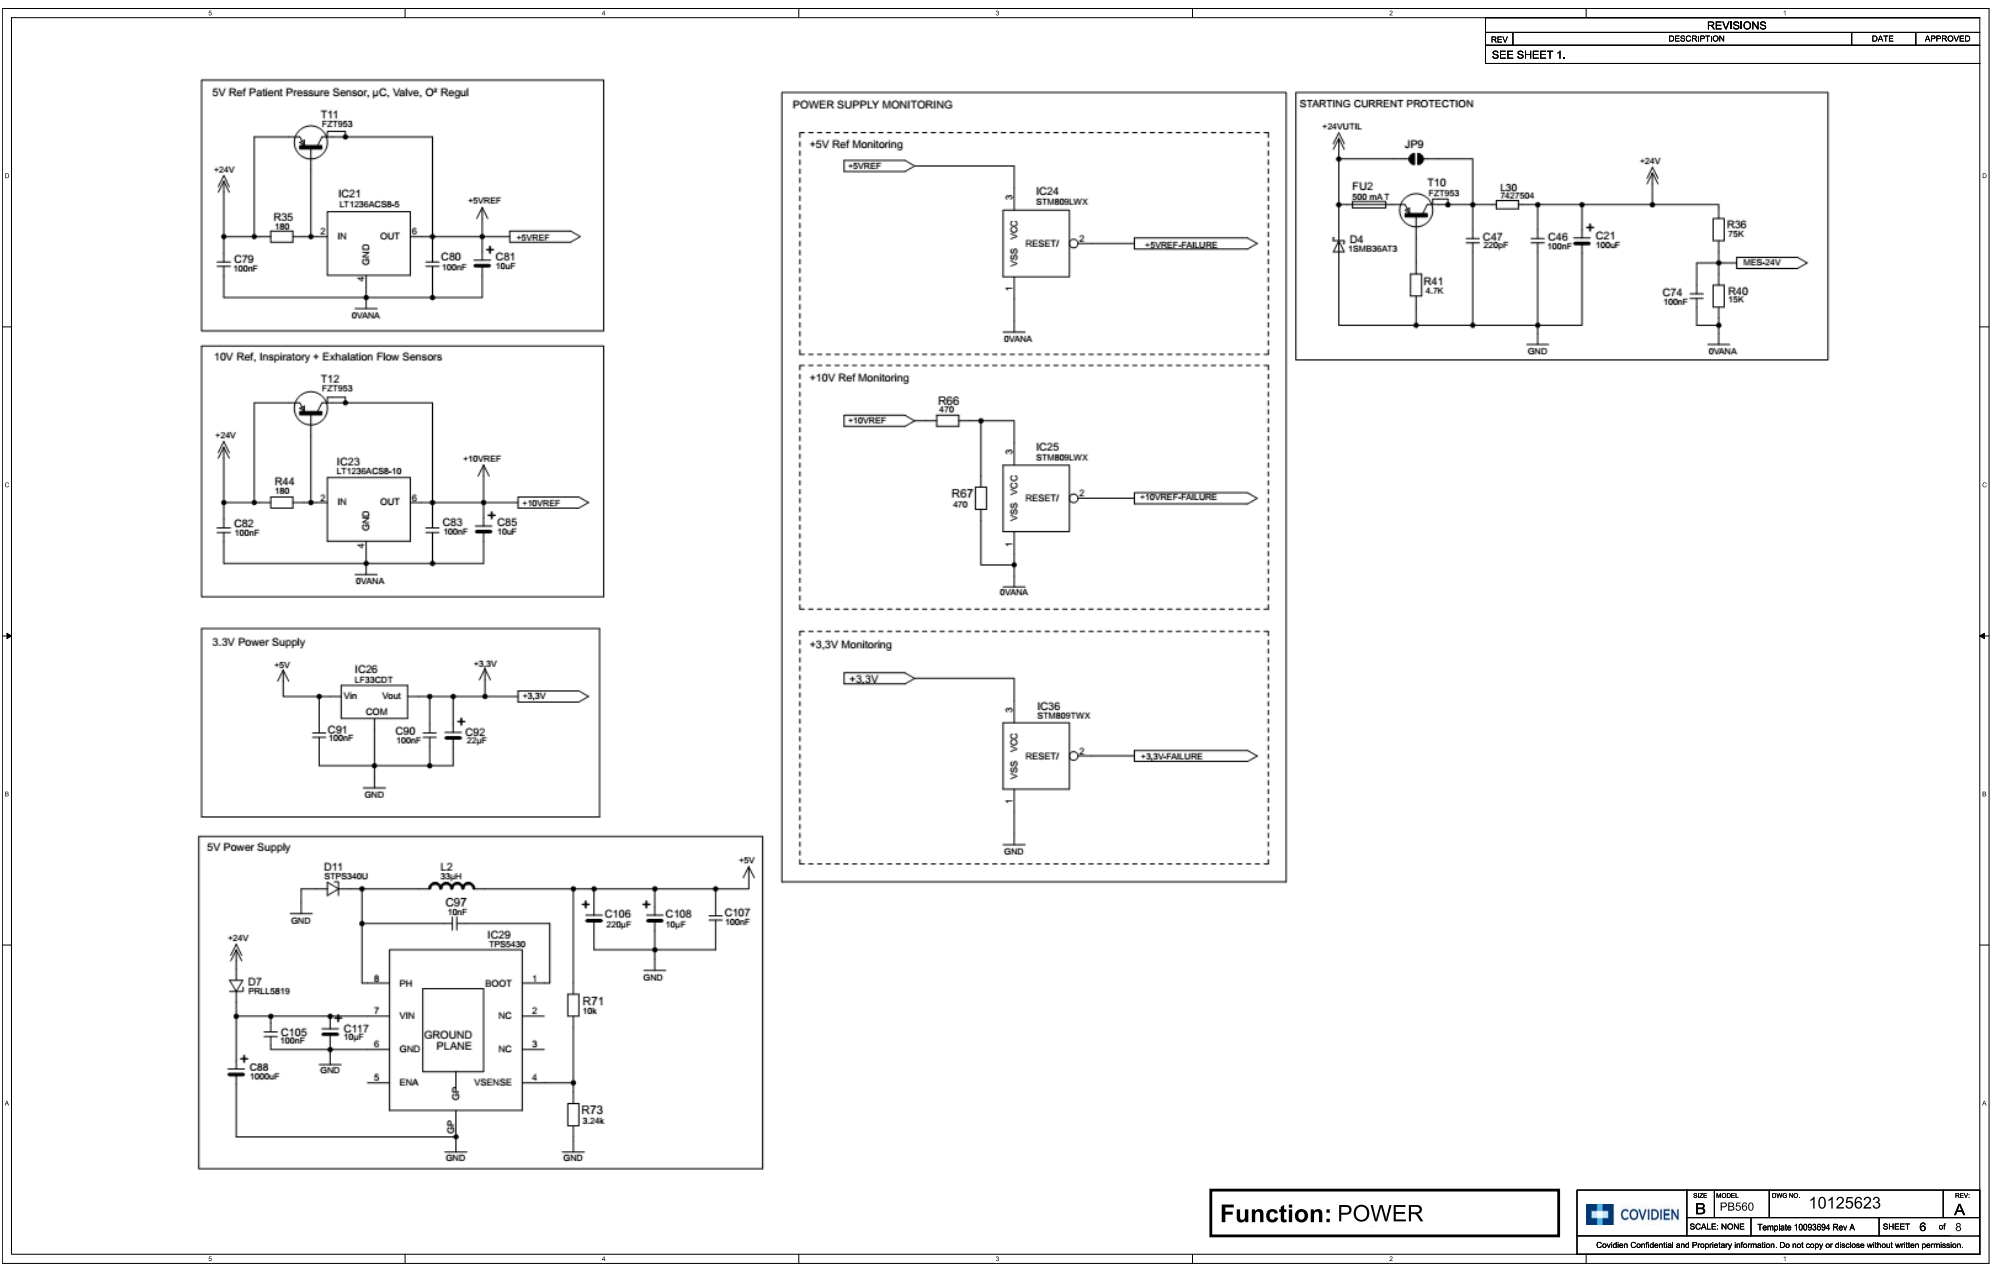
[picture p108: page 6]

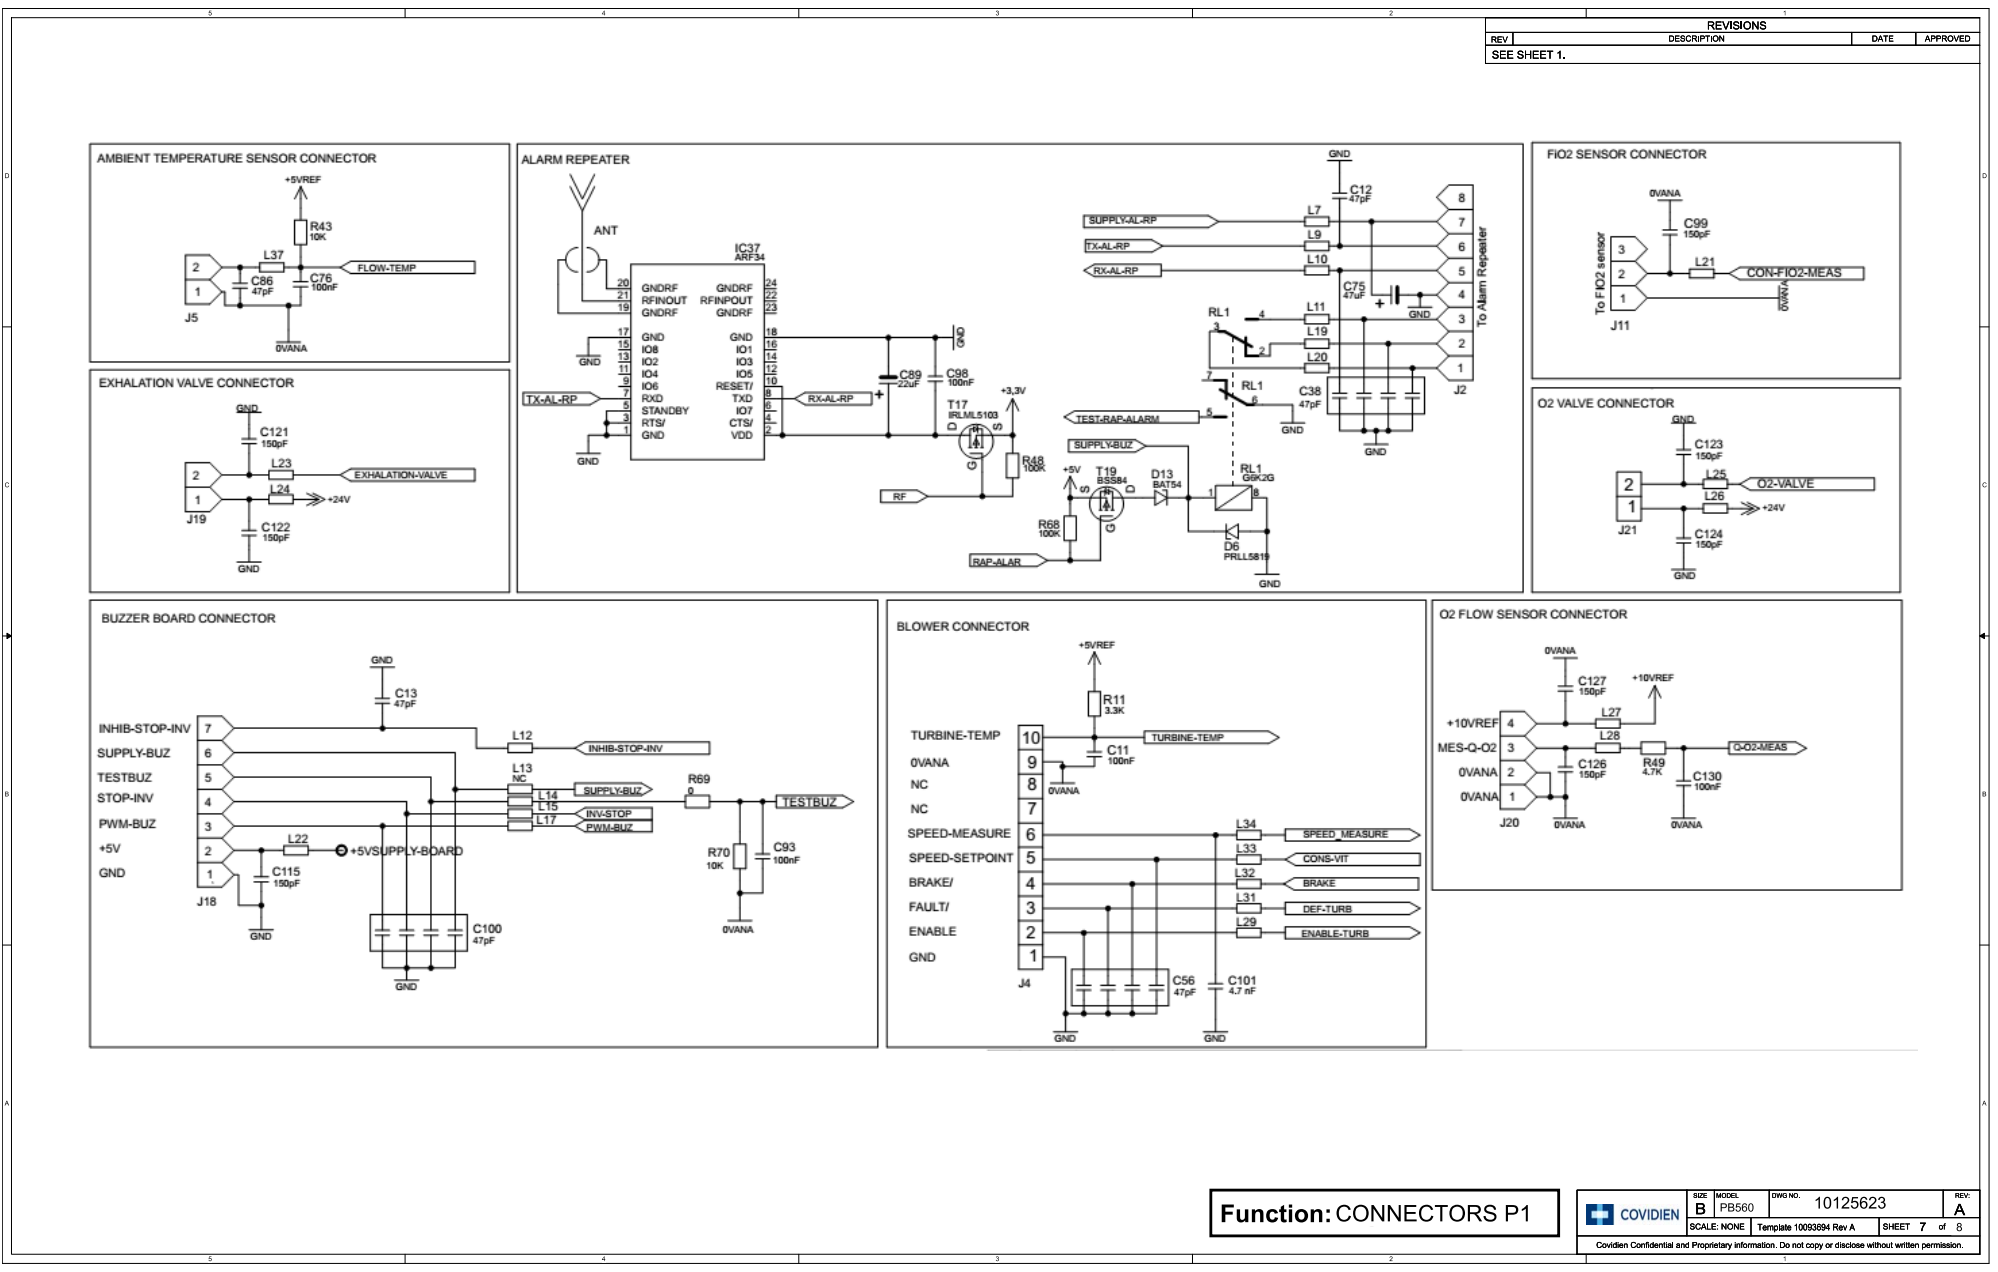
[picture p109: page 7]

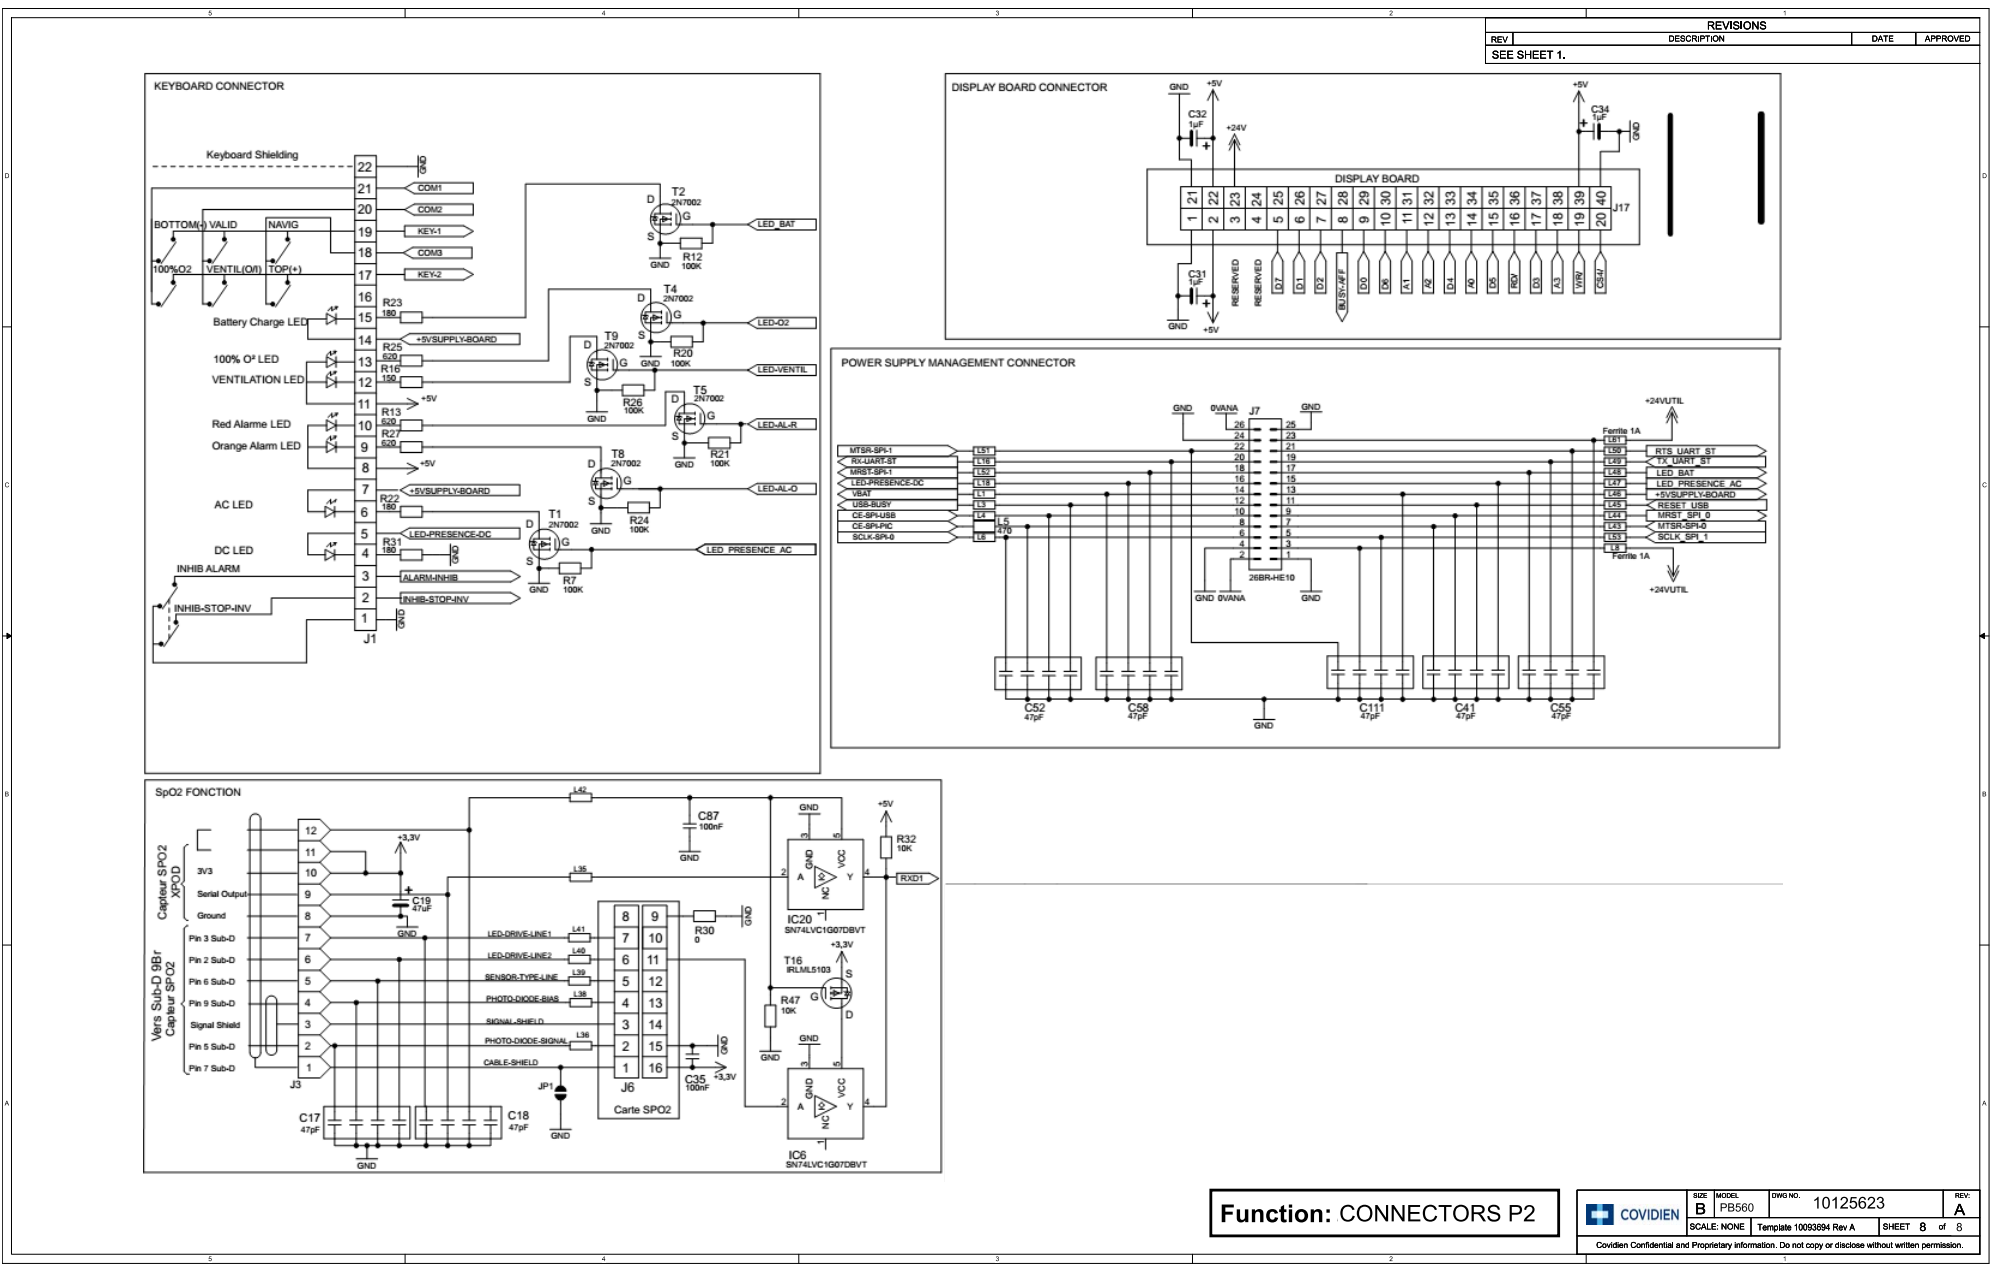
[picture p110: page 8]
