FlyingRat/Medtronic-PB560/Electronic PCBAs/10005011_Power Management_PCBA/3842800_POWER SUPPLY BOARD - TANTALUM LESS_PCBA/SCH/10039639C00_Power Supply Board - Tantalum Less_SCH.pdf

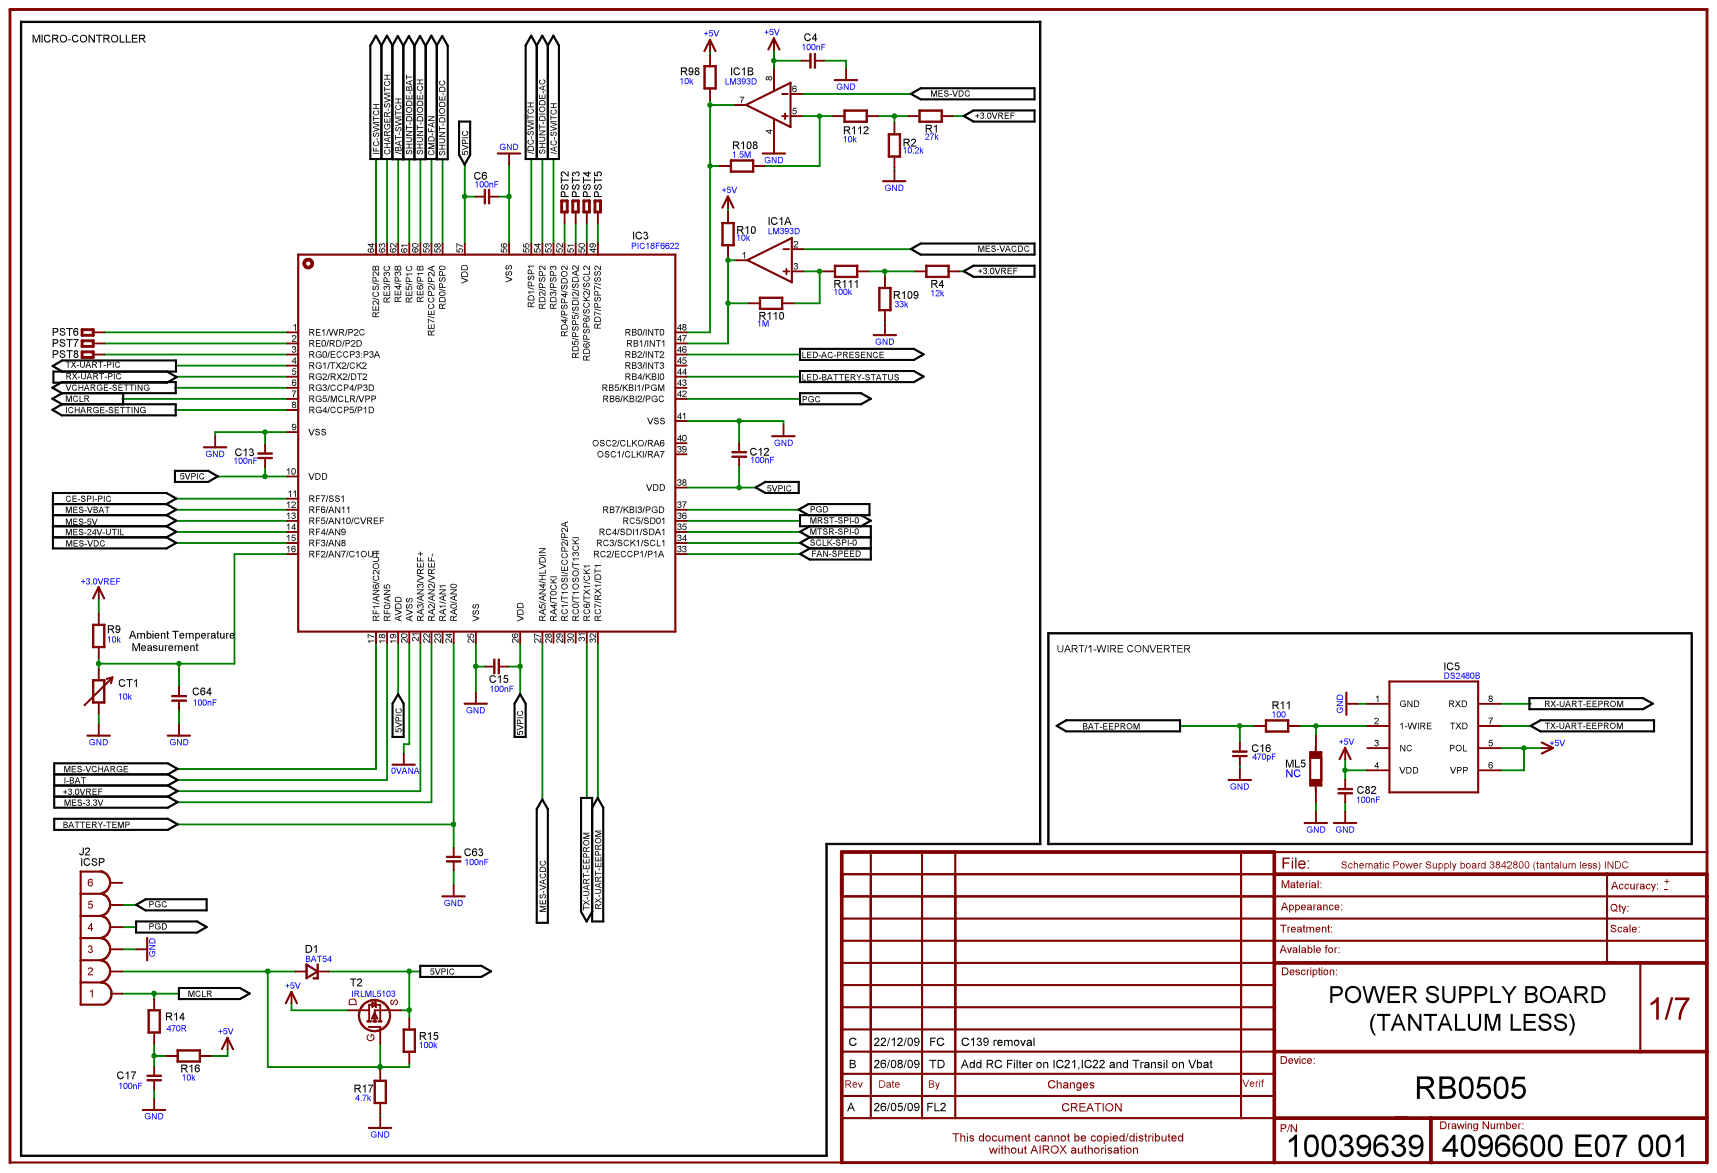
[picture p111: page 1]

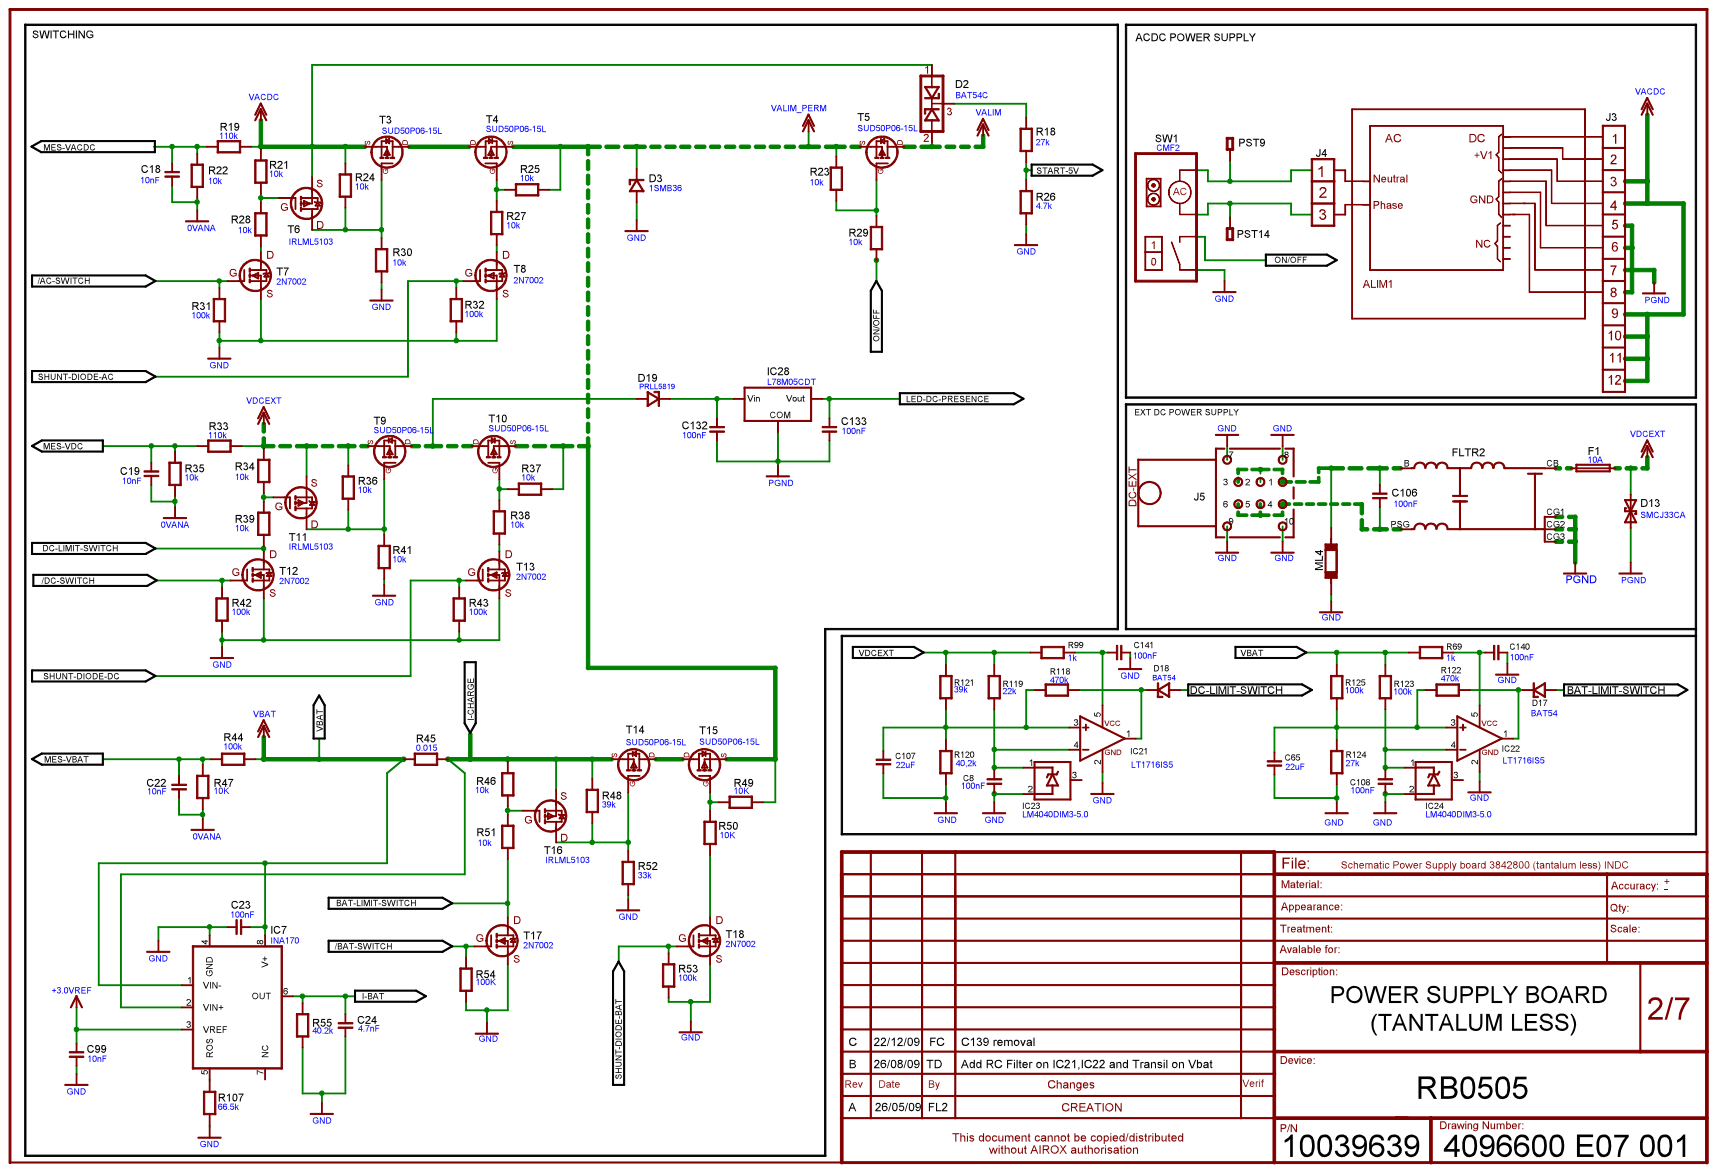
[picture p112: page 2]

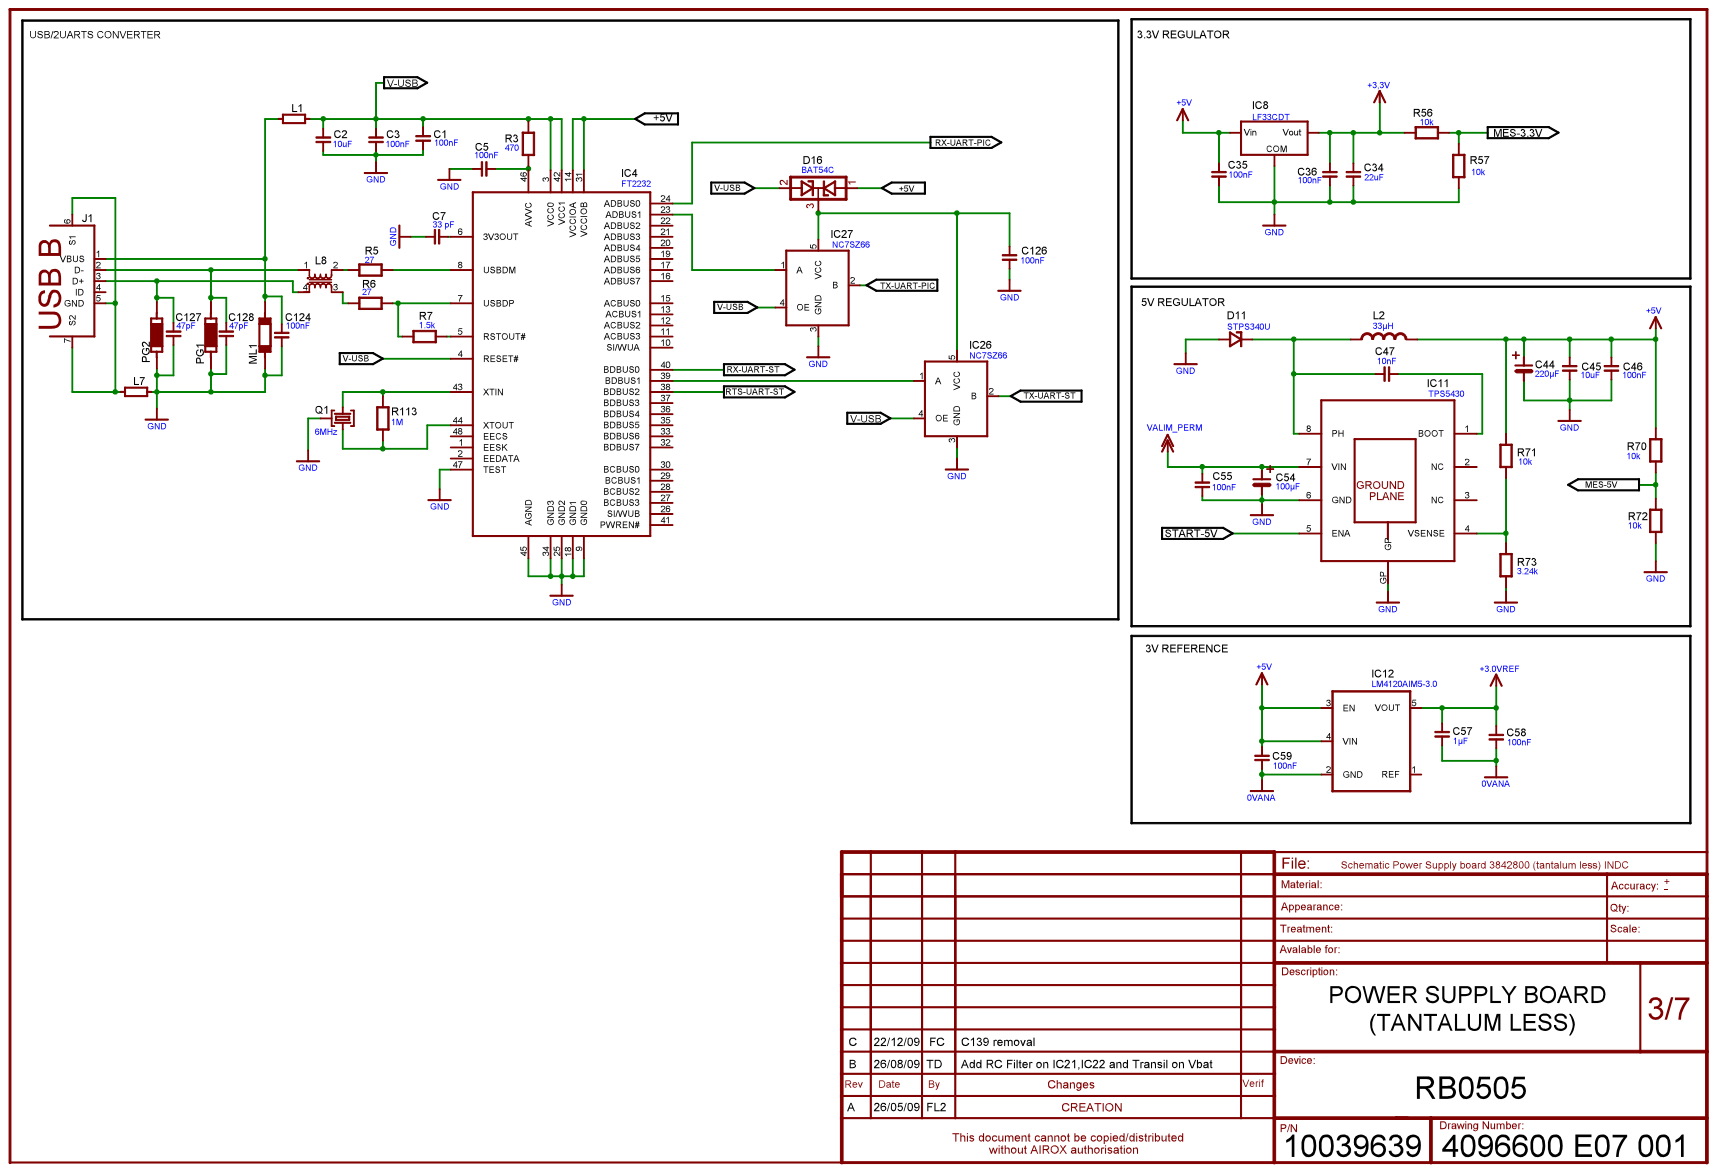
[picture p113: page 3]

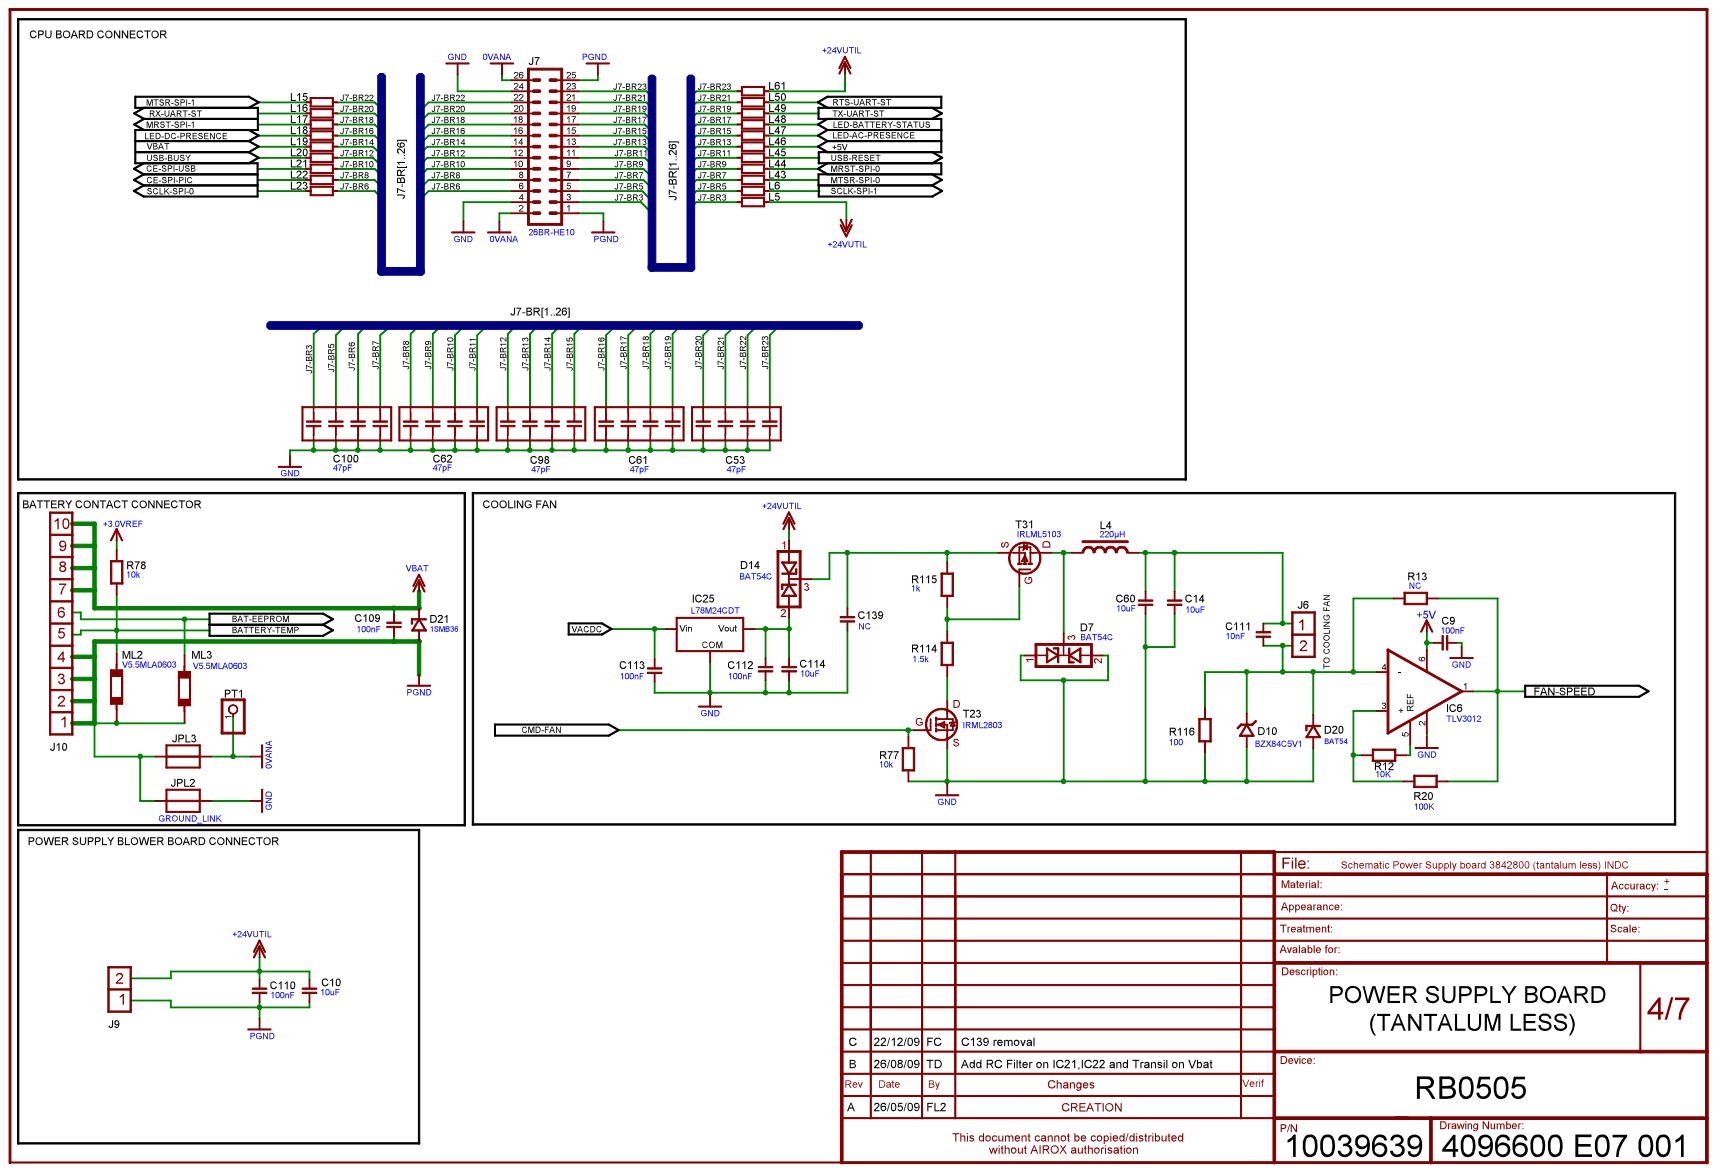
[picture p114: page 4]

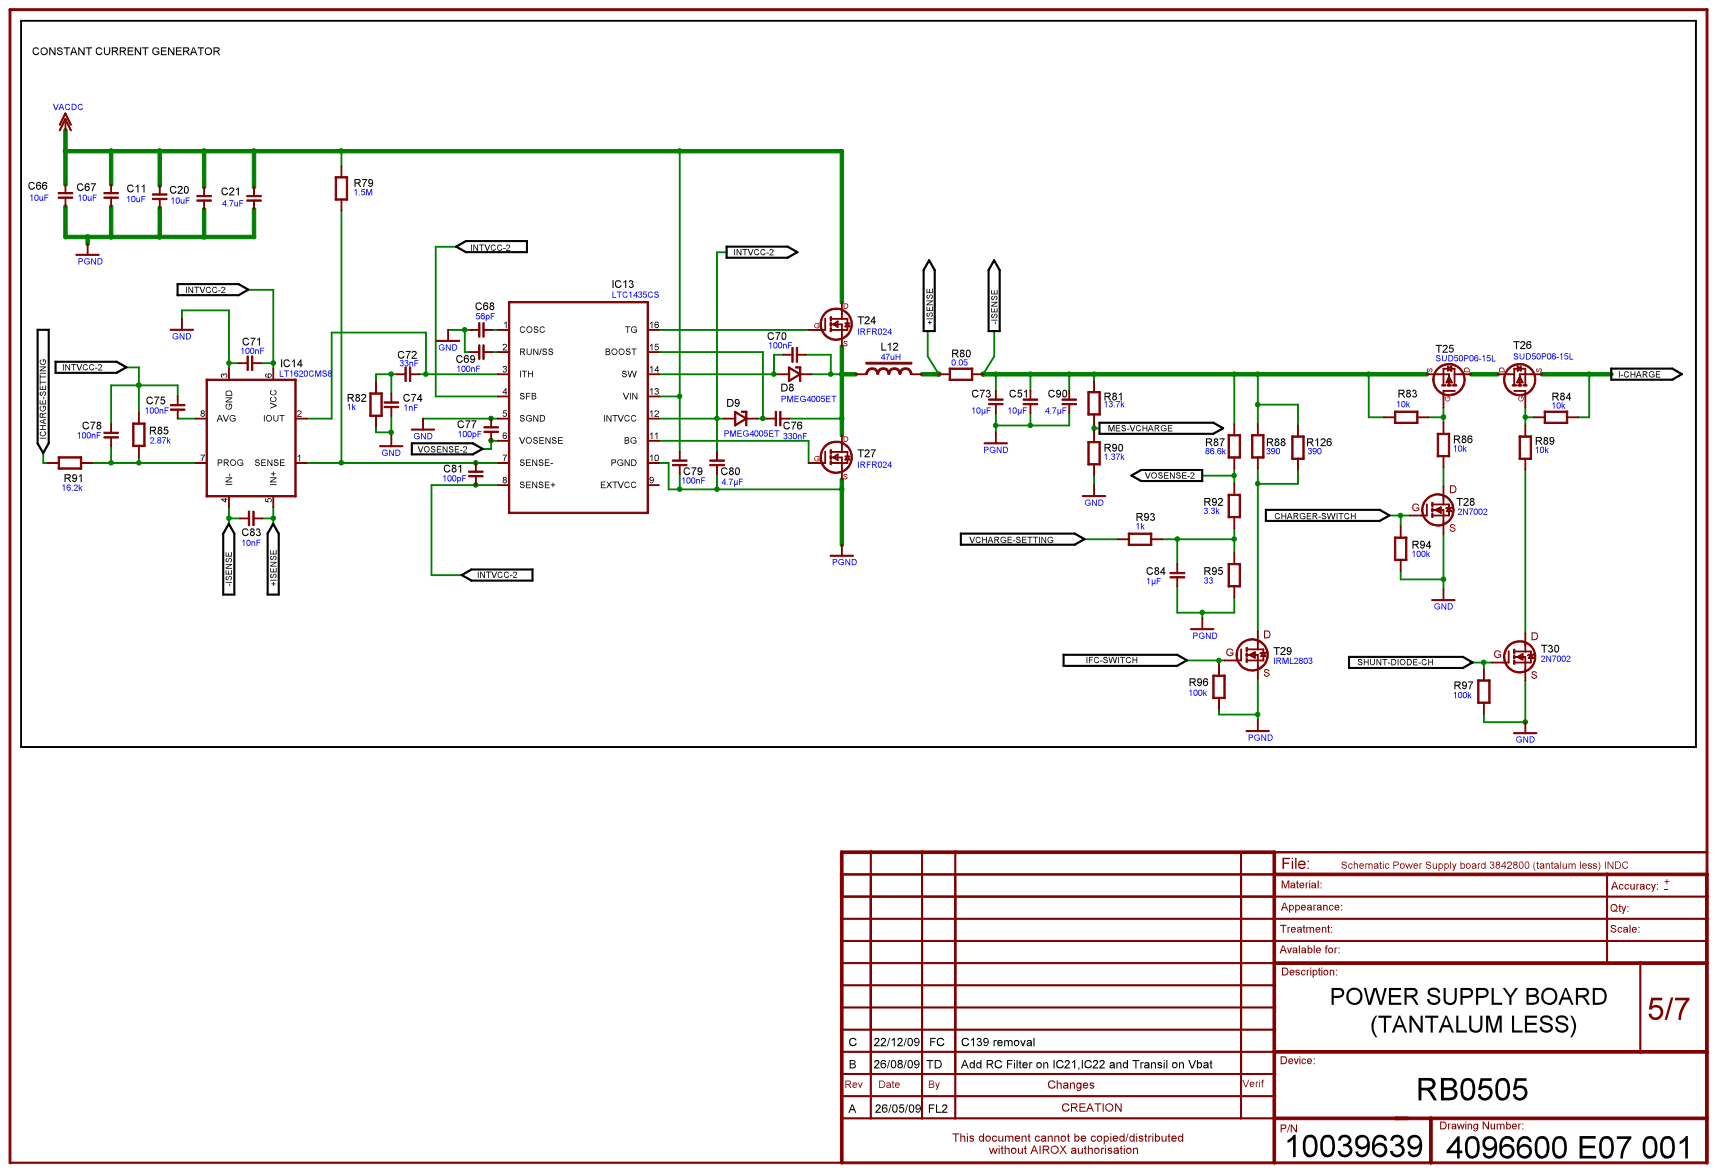
[picture p115: page 5]

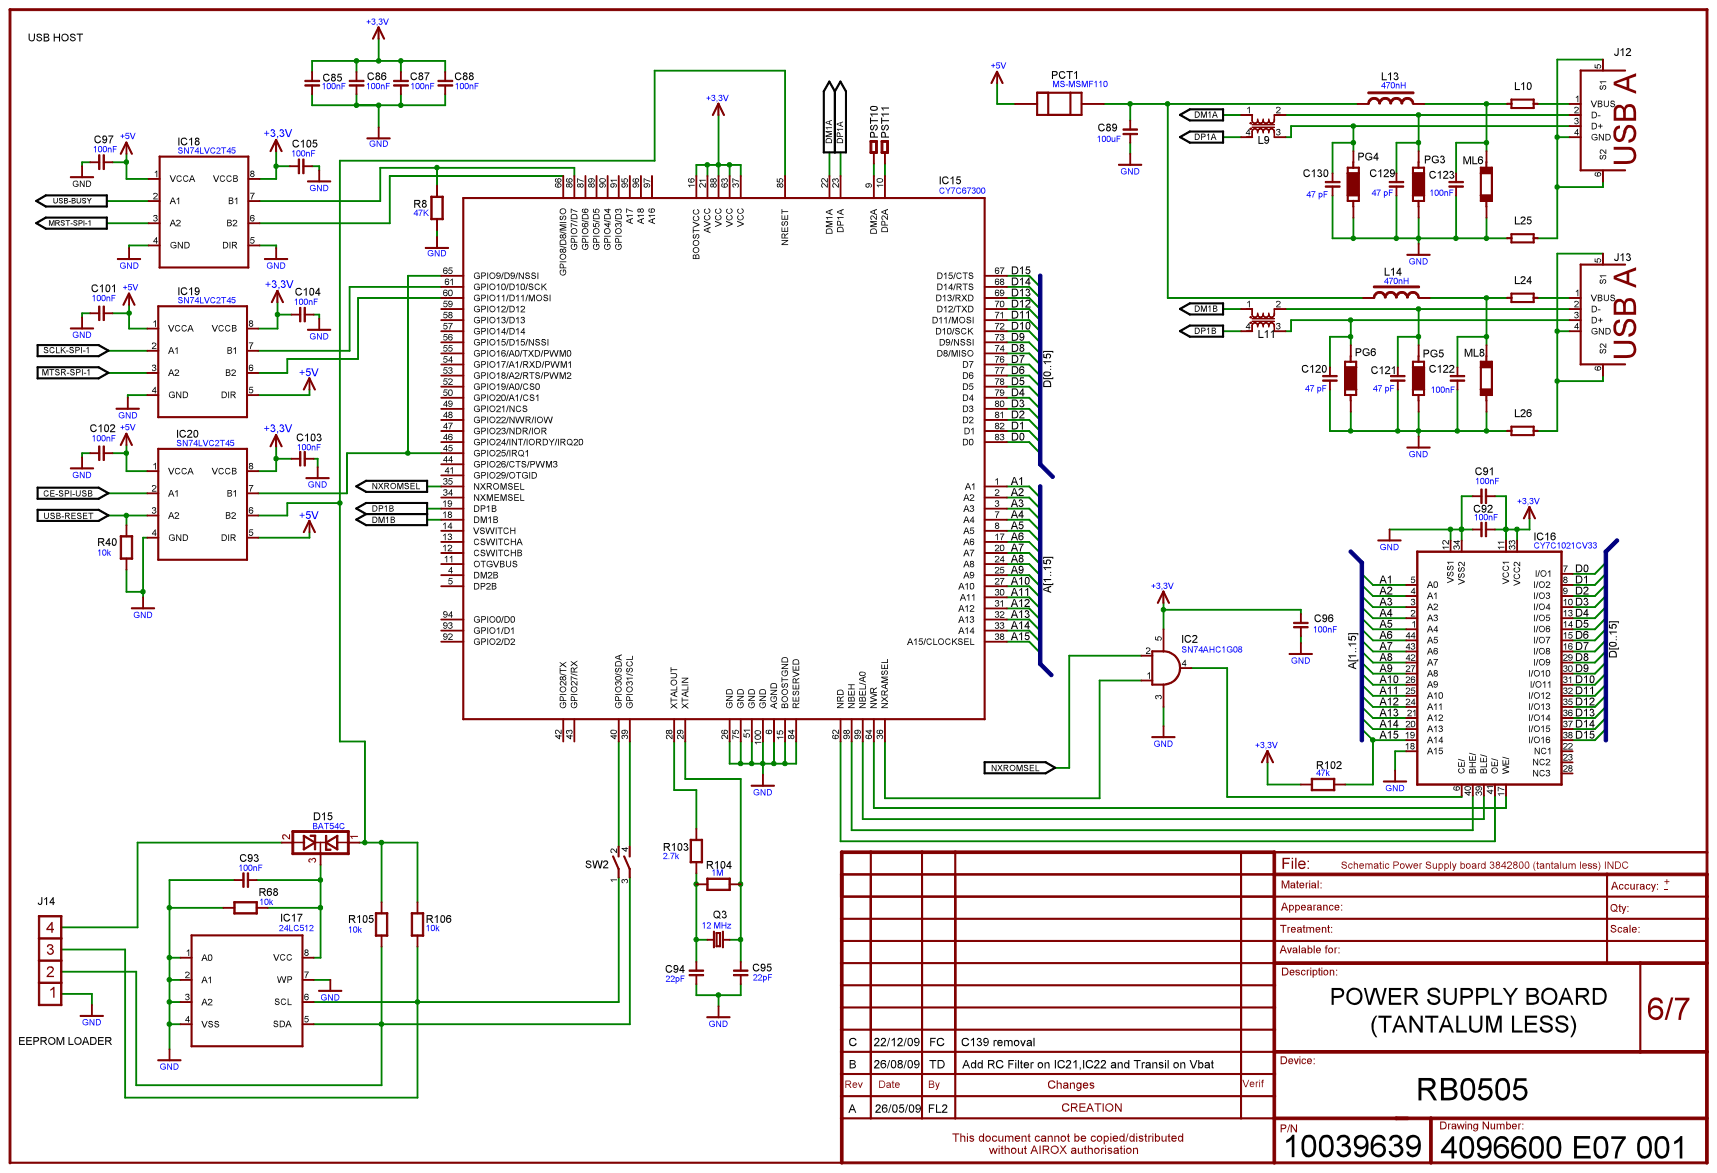
[picture p116: page 6]

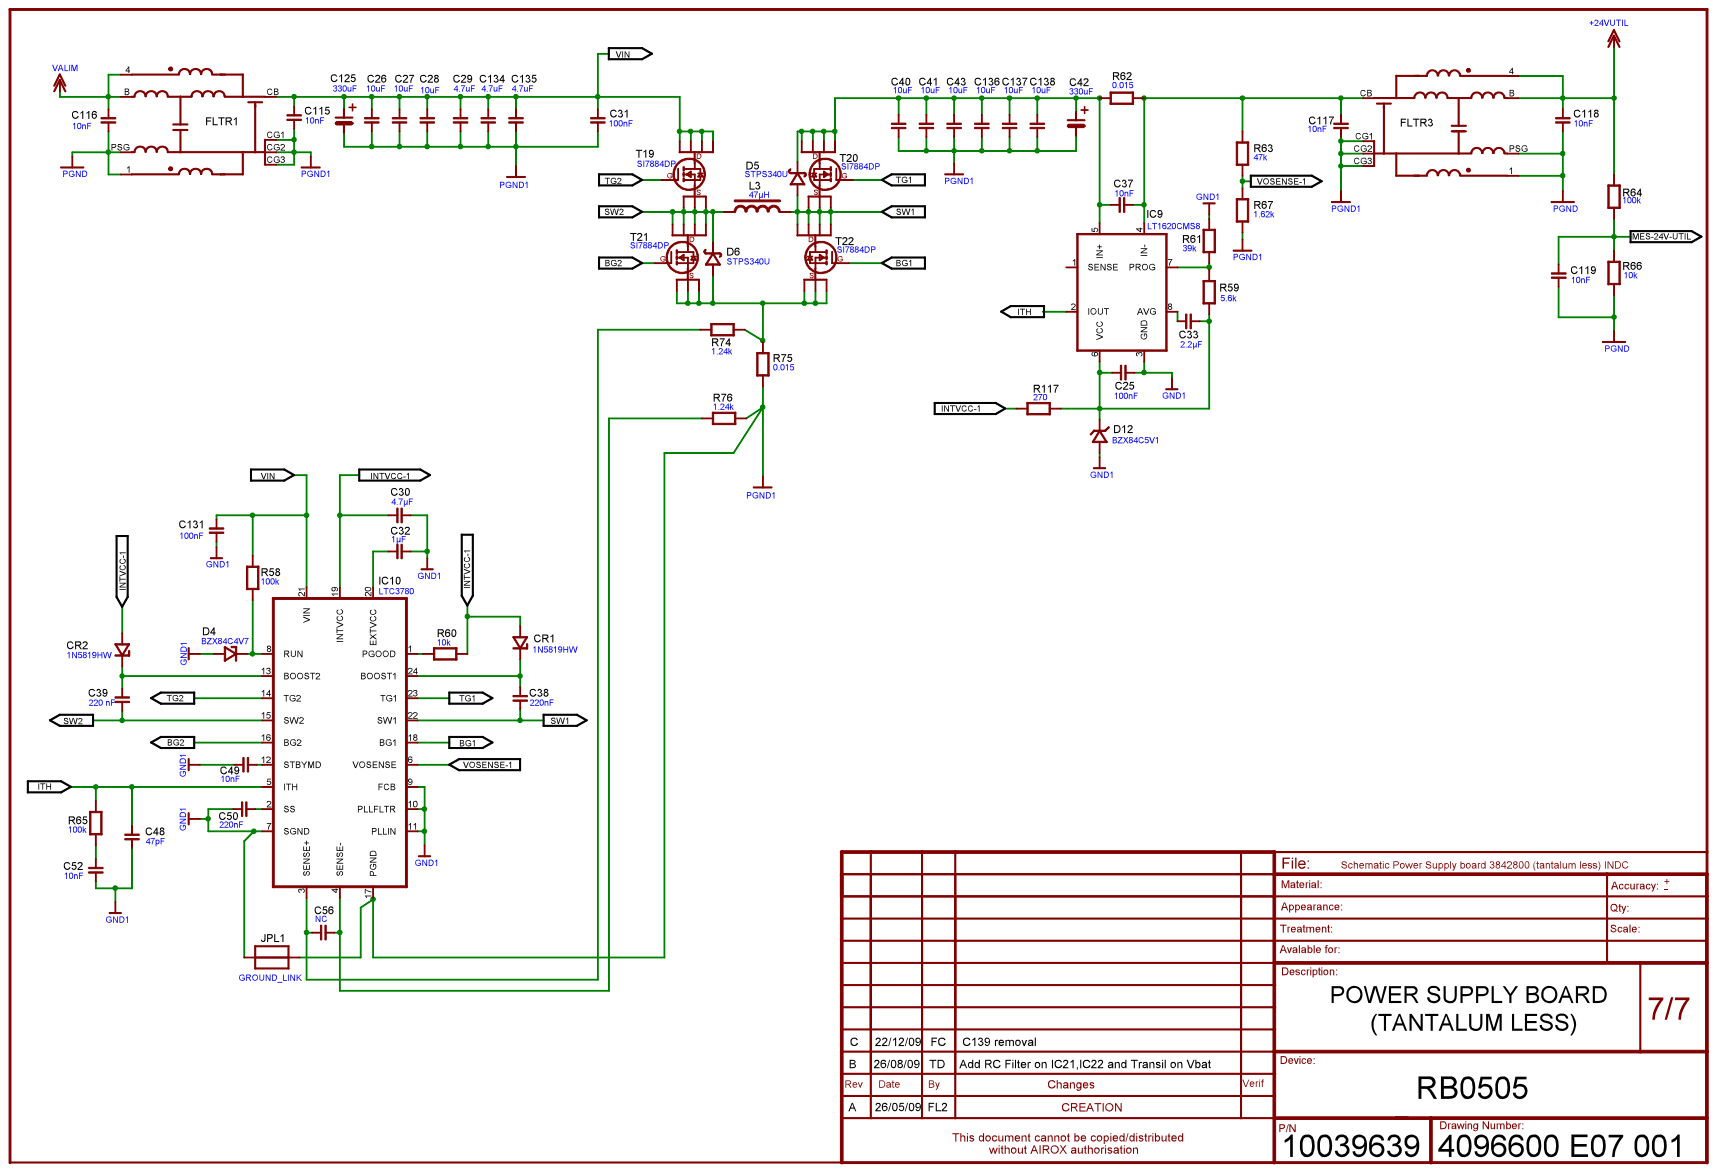
[picture p117: page 7]
