FlyingRat/Medtronic-PB560/(list of files, drawings)

Other design files:
Electronic PCBAs/10106052_PowerPack_PCBA/SCH/10105965B00.DSN
